DankGecko/pq1/reports/README.md

# Generated and historical reports

Files below this directory are point-in-time audit, test-inventory, and tool
receipts. They are not current implementation guidance. Current contributor
guidance lives in the root README and `docs/`.
