DankGecko/pq1/docs/architecture/trezor-comparison-critical-port-2026-06.md

# Trezor (STM32U5 / T3W1) → PQSigner — Critical Port Pass (Extending `trezor-comparison.md`)

**Date:** 2026-06-30
**Scope:** Fresh critical pass against Trezor HEAD `a0fe1eccc2` vs PQSigner `master`. This **extends** `docs/architecture/trezor-comparison.md` (2026-04-24 / 05-19) — it does not re-derive what that doc already covers soundly. It surfaces (a) genuinely new ports, (b) challenges to existing-doc verdicts that aged badly or were too hasty, (c) refreshes for moved Trezor code, and (d) a "considered & rejected" ledger so the same ideas don't resurface next quarter.

> **Historical research, not implementation authority.** Rollback/OTP and FSBL
> geometry recommendations in this June pass predate Draft 1.1 and are
> superseded by its unapproved research-candidate analysis. They may motivate
> tests, but do not authorize code, option-byte, OTP, or hardware changes.

Every candidate below was adversarially verified against PQSigner's real files, threat model, and deliberate-design constraints. Calibration note up front: **the single strongest finding is only "med" impact.** There is no headline break here — PQSigner's signing-path FI, dual-SE split, and on-device-decode trusted display are already strong. The value is in cheap defense-in-depth that closes glitch/fault windows, plus correcting stale verdicts in the comparison doc itself.

> **Method / provenance.** Produced by a 12-dimension `compare → adversarial-verify → synthesize` agent pass (each candidate checked against the real PQSigner file, not CLAUDE.md, which lags). The top three findings (rr-1, sca-3, tz-2) were additionally hand-verified against source (`main.rs:3711/3791/3830/3904` has no fault handler; `crypto.rs` passes the same `&shuffle` to both signs; `sau.rs:432` ends at `SAU.ctrl.write(1)` with no lock bit). **C-1 (secmon) and the supply-chain row were re-run with dedicated deep agents after synthesis and materially correct the first-pass framing** — see the note in §C-1. Trezor is pinned to the STM32U5 / T3-series paths (architectural twin = T3W1 = STM32U5A9 + OPTIGA Trust M).

---

## TL;DR — highest-value portable improvements (ranked)

1. **Route CPU faults to zeroize+reset** — `med` / `S`. No `HardFault`/`SecureFault` handler exists (`main.rs` has only SysTick/DefaultHandler/PendSV); a glitch-induced CPU fault during the signing window freezes the device with `master_secret`+entropy live in S-SRAM. Add a `HardFault` handler → `zeroize_sensitive_state()` + `SCB::sys_reset()`. **Real-gap-closing.** *(rr-1)*
2. **Lock SAU+GTZC1+AIRCR after configuring them** — `med` / `S`. `sau::init()` ends at `SAU.ctrl.write(1)`; the programmed SAU regions + TZSC SECCFGR stay writable forever. One write of `CSLCKR.LOCKSAU|LOCKSVTAIRCR` + `TZSC1.CR.LCK` removes the target. Universal Trezor U5 practice. **Defense-in-depth, ~10 LOC.** *(tz-2)*
3. **Give the FI double-compute an independent shuffle seed** — `low-med` / `S`. `crypto.rs:170/173` pass the *same* `&shuffle` to both mandatory signs, donating two perfectly-aligned DPA traces per signature (a free ~√2 denoise) on the exact alignment the F-16 shuffle exists to deny. ~3 lines; provably FI-safe (output is shuffle-invariant, tested). **Corrects a wrong rationale in non-negotiable signing code.** *(sca-3)*
4. **Extend the golden UI-hash gate beyond value-transfer** — `med` / `M`. `golden.rs::screens()` renders only `value_transfer` (5 frames); the attacker-relevant decode-and-render screens (Safe/CoW/ERC-7730/EIP-1271) — the WYSIWYS boundary — have semantic tests but no pixel-hash gate. CI is already wired. **Real-gap-closing on the core security boundary.** *(te-2)*
5. **Secure the RCC/PWR/SYSCFG domain controllers** — `med` / `S`. `sau.rs` writes only the TZSC per-peripheral SECCFGR; `RCC->SECCFGR`/`PWR->SECCFGR`/`SYSCFG->SECCFGR` sit at NS reset default, letting a compromised NS reconfigure the clock tree the S-world runs on and touch the backup domain where the BHK latches. **Defense-in-depth.** *(tz-3)*
6. **FSBL boot-time option-byte integrity gate** — `med` / `M`. The candidate
   FSBL is intended to become the WRP1A-protected production trust root, but
   geometry, WRP/RDP, factory, and silicon gates remain open; the current
   legacy bench FSBL does not read back `OPTR`/`WRP1AR`/`SECWM` to establish
   that RDP-2/TZEN/WRP-covers-FSBL are in force. A future read-only verifier
   would halt with a tamper screen on mismatch. **Candidate trust-root
   self-attestation, not current immutability or exploit closure.** *(tz-1 +
   sh-1, merged)*
7. **Defer the OTP rollback-floor bump to first-confirmed-boot** — `med` / `L`. `cmd_fw_commit.rs:268` bumps the floor at install, eliminating the old slot as a try-once revert target; a validly-signed-but-runtime-hanging upgrade is an unrecoverable brick. **Availability-only (not attacker-triggerable), but non-trivial to fix correctly.** *(boot-1)*
8. **Cap how long `handler_is_busy()` may feed the IWDG** — `med` / `M`. The watchdog's liveness model means a wedged handler feeds it forever — and the same `handler_busy` gate also suppresses the 120 s idle-wipe, so one hang defeats both backstops. Self-acknowledged hole in `iwdg.rs:38-40`. **Defense-in-depth.** *(rr-2)*

Plus the most important *critical* point, which is **not** a cheap port and where the first-pass framing was itself wrong: Trezor shipped `secmon`, but a deep re-check shows it is a *separate signed image that is the sole secure-world occupant and pushes all decode/render to a non-secure kernel, signing whatever digest NS hands it* — i.e. it optimizes key-confidentiality-vs-NS-bugs by **trusting NS for what-you-sign**, the exact "blind-digest oracle" PQSigner refuses. A full `secmon` port should be **declined on principle**; the only defensible transferable increment is an MPU-lite fence (the ERC-7730 walker and other native decoders run S-unprivileged, key+SAES privileged). See Challenges §C-1 for the corrected analysis.

---

## Headline findings (the actionable ports)

### rr-1 — Route CPU faults (HardFault et al.) to zeroize+reset
- **Trezor:** `core/embed/sys/task/stm32/systask.c:771-849` routes HardFault/MemManage/BusFault/UsageFault/SecureFault/GTZC → `systask_exit_fault` → `reboot_with_rsod`.
- **PQSigner (verified):** `secure/src/main.rs` defines only `SysTick` (:3711), `DefaultHandler` (:3791), `PendSV` (:3830), and a zeroizing `#[panic_handler]` (:3904). **There is no HardFault-family handler**, so a CPU fault lands in `cortex-m-rt`'s default `loop{}` with secrets intact; the zeroizing path is reachable only via Rust `panic!()`. `iwdg` is *not* in `mode-production` (`secure/Cargo.toml:151`), so a shipping build may have no watchdog backstop either.
- **Adjusted change (PORT-with-correction):** add `#[cortex_m_rt::exception] unsafe fn HardFault(_) -> !` under `cfg(all(not(test), feature="stm32u585"))` calling `nsc::zeroize_sensitive_state()` then `cortex_m::peripheral::SCB::sys_reset()` — **NOT** `tzic::trigger_intrusion_wipe()`. The candidate's `trigger_intrusion_wipe` arms page-125, which on next boot runs `factory_reset_admin` (`main.rs:1438`) — a destructive dual-SE wipe; routing *every* induced fault there turns a single glitch into a wallet-brick/DoS. PQSigner stores **no seed in flash** (dual-SE XOR, re-derived after PIN), so a plain reset already closes the SRAM-extraction window via FSBL re-verify. This mirrors `docs/security/brownout-hardening.md` Stage-2 NMI shape exactly. Granular `SHCSR.{MEM,BUS,USG,SECURE}FAULTENA` enables are diagnostics-only (faults escalate to HardFault regardless) → **the security-critical fix is just the HardFault handler, effort S**; the tamper screen + granular handlers are an optional M follow-up. Reserve the destructive SE-wipe for confirmed TAMP/GTZC tamper.
- **Threat note:** Genuine and currently unmitigated for the immediate window. CPU-fault-as-glitch-symptom is PQSigner's headline threat (the same Masaryk-U STM32U5 76%-PIN-glitch result cited in the brownout doc). The only existing backstop is the (non-production) IWDG ~2 s window. **This is the sharpest finding in the pass.**

### tz-2 — Lock SAU + GTZC1 + AIRCR after configuring them
- **Trezor:** `core/embed/sec/trustzone/stm32u5/tz_init.c:410-415` sets `SYSCFG->CSLCKR |= LOCKSAU|LOCKSVTAIRCR` + `GTZC_TZSC1->CR |= LCK`; `:132-145` sets `AIRCR.PRIS` always, `SYSRESETREQS` under `#if PRODUCTION`, clears `BFHFNMINS`.
- **PQSigner (verified):** `sau::configure_gtzc()` ends at the SECCFGR write + readback self-check (`:354-366`); `init()` ends at `SAU.ctrl.write(1)` (`:432`). No lock bit is ever set — the fully-programmed SAU RLARs and TZSC SECCFGR bits stay writable for the rest of boot/runtime.
- **Adjusted change (ADAPT):** at the end of `sau::init()` (after all four SAU regions + GTZC are programmed), gate on `stm32u585`: (1) `SYSCFG_CSLCKR |= LOCKSAU | LOCKSVTAIRCR`; (2) `GTZC1_TZSC->CR |= LCK`. Do **not** touch `GTZC2_TZSC->CR` (unconfigured — the tracked TAMP/GTZC2 follow-up). Set `AIRCR.PRIS` + clear `BFHFNMINS` unconditionally, but gate `SYSRESETREQS` behind `#[cfg(feature="mode-production")]` so bench keeps the NS-initiated `cc_open_then_reset` USB-C warm-reset. Funnel writes through `hw::mmio::Reg32`; add a write-readback `debug_assert`. Caveat to document: `LOCKSVTAIRCR` freezes the AIRCR *security-config* bits, not the `SYSRESETREQ` trigger.
- **Threat note:** `med`/defense-in-depth. TZSC SECCFGR/SAU are only writable from S-world, so the realistic vector is a fault flip or a stray secure-world write (re-classify secure SRAM as NS, mark SAES NS) — at a layer *below* the signing-redundancy FI defense. Cheap, reset-scoped, aligned with Trezor's universal U5 practice.

### sca-3 — Independent shuffle seed for the FI double-compute
- **Trezor:** `core/embed/sec/random_delays/stm32/random_delays.c:45-51` — principle: protective randomness drawn fresh per operation, never reused (conceptual anchor, not a direct port; Trezor has no SPHINCS+ double-compute).
- **PQSigner (verified):** `crypto.rs:170` `sign_a` and `:173` `sign_b` use the **identical `&shuffle`**. The F-16 shuffle only randomizes computation *order* and produces byte-identical output for any seed (proven by `tests/shuffle_byte_equality.rs`). Reusing the seed makes both passes traverse WOTS/FORS in the same order → two trivially alignable traces of the same secret computation. The in-code comment (`crypto.rs:144-145`) frames divergent seeds as a con to the byte-equality gate — the SCA benefit is inverted.
- **Change (PORT):** draw a second independent shuffle seed from `rng_strong` for `sign_b`; zeroize both. Output is shuffle-invariant (tested), so `ct_eq` and verify-before-release still hold and a grafting fault must still produce *identical faulted output in both passes* to slip through — FI hardness unchanged, FI neutral-to-better. Correct the comment.
- **Threat note:** Impact is a bounded constant factor (~2× attacker trace efficiency on a profiled-DPA premise), not a break — hence `low-med`, downgraded from the candidate's `med`. But it directly undermines a deliberately-engineered countermeasure at ~3 LOC. **Best value-per-effort in the pass.**

### te-2 — Extend the golden frame-hash UI gate to the security-critical screens
- **Trezor:** `tests/ui_tests/common.py` — golden screenshot-hash gate across all flows.
- **PQSigner (verified):** `secure/src/ui/golden.rs::screens()` returns `[Eip1559Tx; 5]` and renders only `value_transfer::render_pages` (`:67`). `golden.rs:12-14` flags ERC-20/Safe/CoW extension as the explicit TODO. The Safe/CoW/ERC-7730/EIP-1271 renderers have byte-binding *semantic* tests (`secure/src/display_under_test/{cowswap,safe_display,erc7730}_render_pure_tests.rs`) but **no pixel-level golden fixture**. `nightly.yml`'s `ui-golden-render` job already runs the gate.
- **Change (ADAPT):** refactor `render_golden_and_halt` to drive each production page builder (`safe_display`, `cowswap_display::append_order_body_pages`, Safe-wrapped CoW `setPreSignature`, `erc7730` descriptor pages, `erc20_known`, `eip1271`), reusing the input fixtures already built in the `display_under_test` pure-test modules. Each builder's pages flow through `render_capture_pages`, appending `[UI-FP]` frames; regenerate `tests/ui_golden_render_fixtures.json` via `make ui-golden-render-bless`. No CI change.
- **Threat note:** Squarely on the WYSIWYS boundary. On-device decode defeats host data-swap, but a layout/truncation/unit/digit-grouping regression in these renderers can silently misrepresent intent — exactly what byte-binding tests don't catch. `med`, real-gap-closing. **Priority bumped by the recent ERC-7730 churn:** the historical C1/C2/C3 experiment was tightened on 2026-07-10 to exact C1-only framing (C2/C3 retired), two WYSIWYS holes were fixed in the walker/compiler, and Aave clear-signing now flows through this ERC-7730 render path — so the un-pixel-gated screens are carrying real traffic and changing fast. The ERC-7730 descriptor pages should be the *first* builder added to the golden gate, not the last. Also refresh doc §2.3 (it still claims "no UI regression coverage" and cites SSD1306 GDDRAM bytes — OLED was removed 2026-06-30).

### tz-3 — Secure the RCC / PWR / SYSCFG domain controllers
- **Trezor:** `tz_init.c:296-326` writes all three: `SYSCFG->SECCFGR` (FPU/CLASSB/SYSCFGSEC), `RCC->SECCFGR` (full clock tree incl. PLL/SYSCLK/sources), `PWR->SECCFGR` (WUP/LPM/VDM/**VB**/APC) — dead code if TZEN secured them by default, which is the strongest evidence they default NS.
- **PQSigner (verified):** `sau.rs` writes only GTZC1 `TZSC_SECCFGR1/2/3` + MPCBB; `grep -rni seccfgr secure/` confirms RCC/PWR/SYSCFG SECCFGR are never written.
- **Change (ADAPT):** in `configure_gtzc()` (or a sibling), program: (1) `RCC_SECCFGR` — secure the **full** clock tree + `RCC_PRIVCFGR SPRIV` (PQSigner needs **no NS display-PLL carve-out** like Trezor's PLL3=NS, because the NV3007 is SPI-clocked off a secure prescaler and NS never reconfigures clocks at runtime — `nonsecure/src/usb/mod.rs:42` "clocks already configured by the secure world"); (2) `PWR_SECCFGR` incl. `VBSEC` (guards the backup domain where the BHK latches in `TAMP_BKP0R..7R`); (3) `SYSCFG_SECCFGR` (FPU/CLASSB/SYSCFGSEC). Fold the tz-2 lock over these. **Caveat:** securing RCC will fault the debug-only NS pre-USB RCC dump at `nonsecure/src/main.rs:153-158` — acceptable (debug-log-gated, never ships); verify it's compiled out. Add a readback self-check + pure-test mirroring `main_sau_pure_tests.rs`.
- **Threat note:** `med`/defense-in-depth — *not* a live mid-sign glitch (single core, all NVIC IRQs secure-by-default, NS cannot preempt a signature). It's "persistent NS clock/power reconfig + backup-domain attack surface." Cheap; aligns with Trezor's "secure owns the clock tree" posture. (Also listed in Challenges as it widens §1.1's allowlist verdict.)

### tz-1 + sh-1 (merged) — FSBL boot-time option-byte / secure-config integrity gate
- **Trezor:** `core/embed/sec/option_bytes/stm32u5/option_bytes.c:124-264` (`flash_check_option_bytes`) checks `OPTR`/`SECBOOTADD0R`/`WRP1AR`/`SECWM1-2R`/OEM-keys on every boot; boardloader `main.c:321-336` → `secret_safety_erase` on mismatch.
- **PQSigner (verified):** option bytes are set by an out-of-band
  `STM32_Programmer_CLI` step; `grep` of `fsbl/`, `secure/src/main.rs`,
  `sau.rs`, and `hw/flash.rs` finds **no `FLASH_OPTR` read anywhere**. The
  legacy FSBL header no longer claims that production RDP-2 is already
  established. Full option-byte verification and the immutable production
  trust-root ceremony remain open.
- **Change hypothesis (ADAPT — strip Trezor's write/`OBL_LAUNCH` half entirely):** after an FSBL layout and factory ceremony are approved, consider a read-only `fsbl/src/optbytes.rs` before slot branch that verifies the final frozen WRP range, SECWM, boot address, lifecycle, and OEM locks. Draft 1.1 currently proposes pages 0..4, but exact constants and fit remain open. Gate readbacks through FSBL FI sentinels and halt on mismatch; do not infer SE-wipe authority. This is a candidate experiment, not an instruction.
- **Threat note:** `med`/defense-in-depth + tamper-evidence, **not** a plugged confidentiality hole. Confidentiality is bound elsewhere: U5 mass-erases on RDP regression, SE-pairing secrets self-invalidate (per-die DHUK → ST RDP0 constant), no seed in MCU flash. Real residual = a glitched/partial OB edit that weakens WRP1A (exposing the FSBL anchor to reflash) or shifts SECWM without tripping the full mass-erase, plus auditability of a manual factory step. Against an active attacker the check is partly circular (if WRP1A is unset the slot is reflashable and the check patchable) — say so honestly.

### boot-1 — Defer the OTP anti-rollback-floor bump to first-confirmed-boot
- **Trezor:** `version_check.c:41-46` `ensure_firmware_min_version` bumped at boot (in the bootloader pre-jump, `main.c:479`), not at install.
- **PQSigner (verified):** `cmd_fw_commit.rs:268` bumps `otp::bump_to(new_version-1)` at install AND sets `boot_state.active_slot=new` (`:174-178, :205-212`). FSBL `filter_valid` runs `verify_rollback(floor)` on both slots (`fsbl/src/main.rs:91,160-166`), so a cross-version old slot is eliminated; `pick_slot`'s try-once revert (`:208-214`, fires when `winner_flag==TRIED && active_slot==winner_slot`) then has no target. A validly-signed image that passes FSBL static checks but hangs at runtime reboots into the only remaining (broken) candidate forever — unrecoverable under RDP-2 + WRP1A. The advertised confirm-alive writer (`boot_state.rs:8,:127`) is vaporware (`boot_state::write` only in `cmd_fw_commit`).
- **Change (PORT-with-correction — THREE coupled edits, not two):** the eager bump is currently *load-bearing* (it eliminates the old slot so the new TRIED slot is the only candidate); removing it alone makes the new slot's first boot see `TRIED + active_slot==new` and instantly revert. So: (1) at commit, leave `boot_state.active_slot` pointing at the **old** slot (record "about to try new" via the manifest TRIED flag only); (2) build the confirm-alive writer `boot_state.rs` already advertises — on first successful `gated_unlock` (`cmd_request_unlock.rs`) or NS handoff, rewrite the running slot's manifest `TRY_ONCE_TRIED→COMMITTED`, advance `active_slot→new`, **then** `otp::bump_to(running_version-1)`, FI-hardened to match `bump_to`'s double-read + `check_true_into_sentinel`; (3) remove the `otp::bump_to` from `cmd_fw_commit.rs:268`. Floor stays strictly monotonic — it advances one boot later, on confirmation. Add a host test (old slot survives `verify_rollback` after commit-but-before-confirm) + an FSBL `pick_slot` hang-loop-revert test. **Note:** Trezor bumps in the bootloader pre-jump; PQSigner's FSBL is WRP1A-immutable/read-only on OTP, so deferring into the firmware confirm-alive path is the correct PQSigner layer.
- **Threat note:** **Availability-only, not attacker-triggerable** — an adversary can't sign firmware, the seed is dual-SE XOR + 24-word recoverable on a replacement. But it's an unrecoverable brick with no in-field reflash, and PQSigner already invests in this class (`docs/security/vulns/VULN-fwcommit-otp-before-commit-brick.md` handled only the *power-loss* sibling, which deliberately did NOT defer the bump). `med`, but `L` effort because the try-once machinery is half-built.

### rr-2 — Cap how long `handler_is_busy()` may feed the IWDG
- **Trezor:** `core/embed/sec/iwdg/stm32/iwdg.c:28` — flat hardware time-bound, no progress-feed concept (so there's nothing to literally port; PQSigner's liveness optimization created the hole).
- **PQSigner (verified):** `iwdg.rs:212` kicks while `handler_busy`; the module doc itself flags the residual at `:38-40` — a handler spinning forever with interrupts enabled + its `HandlerGuard` held feeds the watchdog forever. **Worse than stated:** the same `handler_busy` gate also guards the 120 s idle-wipe (`main_sau_pure_tests.rs:993` pins `&& !nsc::handler_is_busy()`), so a wedged handler defeats *both* the IWDG and the SRAM zeroize.
- **Change (ADAPT):** add `static mut BUSY_TICKS: u32` + `const MAX_BUSY_TICKS` in `iwdg.rs`. Treat the two progress signals asymmetrically: NS-heartbeat advance resets `STALL_TICKS` and kicks (unchanged); for the `handler_busy` branch, increment `BUSY_TICKS` per consecutive busy tick, reset to 0 when `handler_busy` goes false (a guard drop = liveness), and only kick while `BUSY_TICKS < MAX_BUSY_TICKS`. A local tick counter avoids plumbing a timestamp from `nsc`. Set the cap generously above the worst *legit* continuous-busy window — the binding constraint is a full `CMD_SIGN_USEROP_BATCH` (per-UserOp keygen + 2 FI-double-compute signs each), **not** a single first-sign (~3 s); measure on HW and set ~2-3× (likely 20-30 s). Add a host pure-test pinning the source invariant.
- **Threat note:** `med`/defense-in-depth — needs a latent unbounded-loop bug in a secure handler (parsers are bounded/Kani-checked, so reachability is low today). The point of a watchdog is to survive the bug you didn't find; this restores Trezor's "bites regardless" property. The `BUSY_TICKS` cap is the single backstop for both the IWDG and the idle-wipe.

### te-3 — SE-genuineness gate at factory provisioning
- **Trezor:** `core/embed/projects/prodtest/cmd/prodtest_optiga.c:353` `check_device_cert_chain` — OPTIGA device key signs a challenge (`optiga_calc_sign`) + X.509 chain verified to the Infineon CA, gating the irreversible `OID_CERT_DEV` write.
- **PQSigner (verified):** `secure/src/factory_provisioning.rs` has no genuineness step before it self-generates secrets and ratchets the chip into a locked state.
- **Change (ADAPT — tightly scoped):** (1) put the classical ECDSA-P256 verify + minimal DER/X.509 chain-walk **behind `#[cfg(feature="factory-provisioning")]` only**, so it never links into the wallet firmware (invariant #5 governs the *wallet* signer; the factory image is a separate single-purpose binary that already does irreversible OTP/LcsO work). (2) Add a feature-gated carve-out to the forbidden-classical-substring guards (`secure_crypto_glue_under_test/pure_tests.rs:1155-1157,1568` ban `p256::`/`ecdsa::`), keeping the guard hard for the shipping image. (3) Insert a fail-closed step in `run_and_halt` **before** the LcsO=Op ratchet / lockdown / OTP burn: read the OPTIGA Infineon device cert (E0E0/E0F0 chain), challenge the device key to sign a fresh nonce + verify against the cert + chain to a pinned Infineon CA root; mirror with the SE050 NXP birth-attestation against a pinned NXP root.
- **Threat note:** `med`, anti-counterfeit/supply-chain defense-in-depth — **not** a seed-secrecy fix (dual-SE XOR already bounds single-chip exposure) and explicitly **not** "closes S-2". **Superseded inventory correction (2026-07-14):** `lockdown_ta_pool` is a fail-closed, non-APDU-emitting candidate naming E0E8/E0E9/E0EF; it grants no closure. The retired E0E3 route was mis-targeted at a type-`0x12` device certificate. Current authority is `docs/STATUS.md` §A and the `label:ship-blocker` GitHub issues (`docs/production-todo.md` was retired 2026-07-19; pointer corrected 2026-07-26). Residual honesty: catches a counterfeit/emulated part entering a *trusted* factory line; a compromised line that re-flashes the factory image can patch the gate out. Distinct from §2.2 (symmetric handshake — a counterfeit chip holding our own PBS would PASS that round-trip) and from §5/line-441 (host-facing runtime ED25519 attestation, lifecycle-disjoint).

### Smaller ports (med-to-low, mostly cheap)
- **td-1 — chunk on-screen hex addresses into 4-char groups** (`med`/`M`). `primitives.rs:265-294` `write_addr_full` packs dense unseparated hex. Scope to `write_addr_full` only (leave `write_addr_full_or_name`'s name-anchored row alone); emit space-separated 4-char groups, equal weight (never first/last highlighting). Residual is real **only on the unknown-recipient path** (known addrs carry the Merkle-verified `+name` anchor, and PQSigner already shows full 40-hex). `M` because the fixed 16-col grid forces re-auditing per-renderer page-count constants + the `seen_last` gate when the block grows 3→4 rows; if a 4th row can't be accommodated cleanly, chunk within 3 rows (8/8/4).
- **td-2 — full 32-byte calldata hash on blind-sign** (`low`/`S`). `primitives.rs:597-619` `write_calldata_hash_rows` shows only 13 of 32 bytes — the one anchor on the no-decode path, contradicting the module's own full-address policy. Render full hash across two pages or a label-less 4-row page; bump `blind_sign.rs` page count and re-verify the confirm gate. Honest: forging 13 shown bytes is ~2^104 (infeasible), so consistency/defense-in-depth, not a break. The candidate's one-page layout is wrong (32 B = 64 hex > 48 hex/3-row page) — needs a real layout/budget adjustment.
- **td-3 — page-position counter on confirm** (`low`/`S`). Add a "p/n" footer indicator in `confirm.rs::render_page`. **Drop** the candidate's hold-progress-bar + rollback: `track_hold` already re-samples every 5 ms over 500 ms (`buttons.rs:267-292`), so the FI false-confirm motive is moot, and the `seen_last` scroll gate already enforces the scroll-then-confirm contract. Only the near-free counter is worth it.
- **se-3 — read the OPTIGA Security Event Counter (0xE0C5) at unlock** (`low`/`S`). Add `apdu::read_sec()` over the existing shielded connection; treat strictly **advisory** (log + surface elevated reading on the NV3007). **Do NOT wire into `tamp-wipe`** — SEC bumps on ordinary wrong-PIN/integrity events and decays ~1/`T_MAX_MS`, so auto-wiping would brick legit users and the desolder threat is already hard-bounded by the E120 LUC. Unique value: observing in-situ glitch/integrity activity against the OPTIGA during a live session.
- **sca-1 — periodic reseed of `consumption_mask` xorshift32** (`low`/`S`). `consumption_mask.rs` seeds xorshift32 once at boot (`:99,:111-135`) then advances it deterministically onto a physically-emitting PWM pin; a linear PRNG whose output is observable is modelable/subtractable. **Do NOT** do per-tick fresh-RNG (the comment's one legitimate objection: a 1 kHz SE round-trip per tick). Instead reseed every N≈1024 ticks via `seed_prng_from_rng()`, reusing the fail-closed contract (skip-and-keep on `Err`, don't panic mid-run). Fix the misleading "cryptographic strength not required" comment (`:87-97`). Trezor's actual U5 `consumption_mask.c:43-47` fills the PWM buffer from `rng_get()` each refill — the per-refill fill becomes right only once the noted DMA buffer port lands.

---

## Challenges to the existing comparison doc

This is the most important "be critical" section. Four verdicts in `trezor-comparison.md` have aged into being stale or too hasty, and one architectural stance is now contradicted by Trezor's own move on the identical silicon.

### C-1 (NEW, the big one — re-verified, first-pass framing corrected) — the "small, audited, monolithic S-world" stance vs Trezor's `secmon`

> **Correction note.** The synthesis first wrote this as "Trezor shipped a privileged supervisor *inside the secure side* on PQSigner's *exact* silicon — a peer rejection of monolithic-S." A dedicated deep re-check (file-cited below) shows **all three of those claims are imprecise or wrong**. The corrected analysis is more interesting and more honest: `secmon` and PQSigner's flat-S optimize *opposed* threats, and a full port would import the one thing PQSigner exists to forbid.

- **Prior doc posture:** §3.2 / §8.2 (line 601 "not needed today") / §8.5 repeatedly wave off intra-secure isolation gaps with "the whole S-world image is small and audited." No dimension ever challenged the monolithic-secure-world assumption — that part of the challenge stands.

- **What `secmon` actually is (verified).** It is **not** an S-priv/S-unpriv tier inside one image. It is a *separate, separately-signed* secure image with its own vendor header + `headertool` signature pass and CMSE implib (`SConscript.secmon:331-333,398-442`, `linker/stm32u58/secmon.ld`). At runtime it is the **sole secure-world occupant**: `main()` → `tz_init()` → `drivers_init()` → `jump_to_vectbl_ns(KERNEL_START)` (`secmon/main.c:155-166`) — it hands the kernel + app off to the **non-secure** side. SRAM/flash are configured secure *and* privileged uniformly (`tz_init.c:161-162,200-209`); there is no second privilege tier. The boundary is the ordinary SAU + GTZC S/NS line, reached via `smcall` whose `__verified` wrappers `probe_read/write_access`-validate NS pointers (`smcall_dispatch.c:61-116`, `smcall_verifiers.c:36-90`) — the same shape as PQSigner's own NSC `NsPtr` discipline.

- **The load-bearing reframe.** `secmon`'s entire sign surface is **digest-in / sig-out** — `optiga_sign__verified(index, digest, …)` (`smcall_verifiers.h:61`). It contains **no** transaction decoder, ABI parser, or display renderer; the NS coreapp/MicroPython decodes, renders, and hands `secmon` a finished digest to **sign blind**. So Trezor's WYSIWYS TCB is the *signed NS firmware*. **PQSigner explicitly forbids exactly this** (CLAUDE.md: bare-signing a companion-chosen 32-byte value is a "UserOp-forgery oracle"; the entire on-device-decode trusted-display model exists to deny it). `secmon` therefore closes *key-confidentiality-vs-NS-memory-bugs* while *trusting NS for what-you-sign*; PQSigner's flat-S closes *what-you-sign integrity* by co-locating decode+render+sign, *accepting* a parser-next-to-key blast radius. **They optimize different, partly opposed threats — `secmon` is not strictly better.**

- **Silicon (corrected).** `secmon` builds **only** for T3W1/D002 (`SConscript.secmon:256-263`) = `mcu="STM32U5G9xx"`. The U585-class Trezors (T3T1/T3B1) ship the **empty `secmon.bin` stub**. So "shipped on PQSigner's exact silicon" is **wrong** — it's a sibling U5 die (U5G9 vs U585). The `#if STM32U5A9xx || STM32U5G9xx` + `linker/stm32u58/` paths show the design *is* portable to U585, so the architectural point survives, but the "peer is doing it on our exact part" pressure does not.

- **PQSigner today (verified flat).** Grep of `secure/src` returns **zero** `MPU` / `PRIVDEFENA` / `CONTROL.nPRIV` uses; the only boundary is SAU/GTZC (`sau.rs`). `CMD_SIGN_USEROP` (`nsc/mod.rs:1201-1213`) routes into a 1930-line handler that parses the wire format, verifies the ERC-7730 bundle (`cmd_sign_userop.rs:553`), renders, **and** signs with the master/slot keys inline. The large, attacker-data-driven, **secret-free** surfaces sitting at the same privilege as the key + SAES selector are the **ERC-7730 walker** (`pqsigner-erc7730/` + `tx/display/erc7730/` ≈ **5k LOC** and the *prime* candidate — see below), the **typed-call ABI parser** (`tx/typed_call/parser.rs`, 669 L), and the **EIP-712 Safe / CoW decoders** (`tx/eip712/{safe,cowswap}/`). SE drivers and raw USB are *not* differentiators — SE is S and OTG is NS on both stacks. The ERC-7730 walker is also the *most active* attack surface: the C1/C2/C3 commits just added dynamic-field / `FollowOffset` / multi-dynamic-array resolvers (the security-sensitive `head_bounded_body` slot-confusion territory), and two WYSIWYS holes were closed in the same window (duplicate tuple-member names — a **HIGH** — `7c9cf5a2`; `visible:"never"` no-param — `8afb7ec2`). Notably the **SVC vector is unused on the S side (0 uses; NSC rides CMSE SG veneers, the timer rides PendSV)** and the MPU is unused — a clean `unpriv-parser → SVC → priv-signer` escalation vector exists today.

- **Corrected recommendation — defer-with-rationale (not "N/A", not "open a secmon port").**
  1. A **full `secmon` port is declined on principle**: pushing decode/render to NS and signing the digest it returns *imports the blind-digest trust-base fork PQSigner is built to refuse*. This is not a difficulty call.
  2. The **one defensible, scoped increment** is a `secmon`-*lite* **MPU + SVC privilege split inside S** (orthogonal to SAU/GTZC, composes with the no-heap/stack-only model): run the largest attacker-data parsers — the **ERC-7730 walker** first (now ~5k LOC, the most active surface, and where the HIGH dup-name WYSIWYS hole just lived), then the **typed-call ABI parser** and the EIP-712 Safe/CoW decoders — in an **S-unprivileged** MPU region, revalidating their small output (bool + bound fields) on return with the same copy-to-S-stack/TOCTOU discipline already used at the NS boundary, keeping key material + SAES selector + SE-unlock + FI-sign privileged.. Effort **L–XL**.
  3. A cheaper MPU **W^X / XN on parser regions** addresses code-injection, **not** key blast-radius — so it is *not* a `secmon` substitute, only a precursor.
  4. **Honest caveat:** PQSigner's S-world is memory-safe `#![no_std]` Rust — the C + MicroPython attack surface `secmon` was built to contain largely does not exist here — so even the MPU-lite split may be **correctly declined in favour of higher-yield audit spend**. The required action is to *record this as deliberately-deferred with the blast-radius argument and the SVC/MPU feasibility on the table*, not to keep waving it off as "small and audited." Reconciles with C-2.

### C-2 (sca-2) — §3.2 "SAES key-privilege split is a genuine gap" is overstated *and* self-contradictory
- **Prior verdict:** §3.2 (lines 404-406) labels the Trezor XORK_SP/SN split "a genuine gap PQSigner does not have" and recommends gating the SAES selector behind privileged mode (~150 LOC).
- **Why it's wrong:** verified in Trezor — `secure_aes.c:75-79` reaches the unprivileged XORK_SN selector **only under `#ifdef USE_APPLETS`** (now `#if NORCOW_MIN_VERSION <= 5`), and commit `7fb272bade` *removes* unprivileged SAES on the T3W1/U5G twin. The split exists to fence *applet* code from the privileged key. PQSigner has no applet model — one privilege level, selector reachable only by the audited S-image — so the threat never existed here. §3.2 also contradicts §8.2 line 601 ("not needed today").
- **Corrected recommendation:** change the §3.2 sub-claim verdict from "genuine gap, track" to **"aligned with upstream U5G direction, do not chase"** (cite `7fb272bade`); leave the §3.2 MPU/DEP W^X recommendation untouched (separate dimension, and it's the legitimate kernel of C-1).

### C-3 (te-1) — §2.4 "NSC ptr-validate still pending" is stale
- **Prior verdict:** §2.4 + TL;DR line 3 say the NSC pointer-validation side is "still owed" and "needs relocation out of `secure::nsc` first."
- **Why it's stale:** that relocation shipped. The window arithmetic now lives in host-buildable `shared/src/ns_ptr_validate.rs` (`ns_write_window_ok`, `ns_read_window_ok`) and is **exhaustively Kani-proved** (`ns_write_sound`/`ns_read_sound`/`ns_write_sound_symbolic_regions` + 5 non-vacuity controls), run by `make kani` (`Makefile:3736`) in the nightly `kani` CI job, with Miri tree-borrows over the deref. Exhaustive-over-symbolic strictly subsumes the originally-owed libFuzzer target for a loop-free predicate.
- **Corrected recommendation (doc-only):** mark §2.4 + TL;DR CLOSED-via-Kani; tick the work-todo. State the only residual is the runtime ARMv8-M TT/SAU classification (HIGH-1), which is device-only + deliberately host-stubbed and unreachable by any host harness — so no libFuzzer target is owed.

### C-4 (boot-4) — §8.3 Pattern 2 "we don't read-back-verify OTP" is stale
- **Prior verdict:** §8.3 Pattern 2 (~line 609) + the `[P3, audit-only]` line (~621) say PQSigner "has OTP fuses... but doesn't do the read-back verify — we trust the fuse-burn hardware."
- **Why it's wrong:** `otp.rs::bump_to` (the rollback-floor burn, PQSigner's `monoctr` equivalent) reads the floor back **twice** (`after1`/`after2` via `rollback_floor_once`), both required `>= target`, gated through `fi::check_true_into_sentinel` (`otp.rs:372-377`) — strictly stronger than Trezor's single write-then-read-ensure-equal.
- **Corrected recommendation (doc-only):** mark Pattern 2 DONE (cite `otp.rs:372-377`); remove the open `[P3, audit-only]` line. No code change, no live exposure.

### C-5 (ht-1) — §8.6 THP verdict is correct but the *text* is stale/partly-wrong
- **Prior verdict:** §8.6 "do not port THP" — **sound**, keep it. But the text (lines 688-710) cites the **removed OLED backend** (line 698; OLED gone 2026-06-30 — a hard factual error now), rests the MITM dismissal on "if the user is paying attention" (line 706), and predates Trezor's pairing-credential layer.
- **Why the hedge is subtly wrong:** under PQSigner's on-device-decode trusted display, a MITM-swapped userOp for a *known* shape renders as the swapped intent and **cannot be concealed by inattention** — only loud-blind-sign shapes retain a "user must read the hash" caveat. The "if paying attention" framing undersells the actual binding.
- **Corrected recommendation (doc-only refresh, verdict unchanged):** (a) update the THP description to the current pairing-credential + masked-static-pubkey layer (`rust/trezor-thp/src/credential.rs` — the doc's `noise.rs:276` cite no longer resolves on HEAD); (b) replace "OLED PIN entry" with NV3007 LCD; (c) replace the hedge with the on-device-decode binding (every sensitive command gates `pin_verified` before any parse — `cmd_sign_userop.rs:117`, `cmd_sign_offchain.rs:83`); (d) add a per-threat binding table (replay → EntryPoint nonce + monotonic caps + `replaySafeHash`; FW transport → signed 75-B preimage + OTP floor + PIN-every-call + confirm; unpaired host → pin-first + per-op confirm + non-secret gateway).
- **C-5b (ht-2):** also refine §8.6 line 710's bare BLE-revisit note in-place — append one sentence: any future host-channel-auth **MUST be a PQ KEM (ML-KEM-1024**, matching the planned SE inner-wrap) over AES-256-GCM, **not** THP's Noise_XX/X25519, to preserve invariant #5; pairing/confirm terminates on the NV3007. Anticipatory PQ-purity steering, not a current exposure.

### C-6 (sh-2) — §5/§6.5 RDP-regression rationale undersells PQSigner
- **Prior verdict:** §5 line 450 + §6.5 — "do NOT regenerate BHK on wipe" is **sound**, and line 476 already states the DHUK-wrap makes a flash dump useless without the silicon. So this is a one-sentence elaboration, not a new gap.
- **Add:** an RDP regression itself swaps DHUK from per-die to the ST RDP0 constant (`secret_keys.rs:41-45`, silicon-validated per `project_dhuk_per_die_validated.md`), so the SE-pairing secrets fail to reproduce **even if the bank mass-erase were fault-injected/incomplete** — an invalidation independent of (and belt-and-braces with) the erase. Cross-ref `secret_keys.rs`; keep the verdict.

---

## Per-dimension notes

- **FI hardening.** Survivor: fi-2 (escalate confirmed-fault branches to zeroize+relock — the post-confirm `crypto.rs:188` ct_eq site is highest value; exclude all policy/parse rejects or it's a self-inflicted DoS; relock not halt, consistent with `halt_on_glitch`). Rejected: fi-1 (RDI port — category error; RDI is SCA timing-randomization, not fault detection; the real residual is hardening *keygen*, a separate non-Trezor item). sca-3 belongs here too in spirit.
- **Runtime resilience.** rr-1 (HardFault → zeroize+reset) is the sharpest finding in the whole pass; rr-2 (cap IWDG busy-feed) is a self-acknowledged hole that also defeats the idle-wipe. Both genuinely uncovered by the doc (brownout-hardening.md plans NMI/IWDG but not synchronous CPU-fault vectors).
- **Trusted-display.** Doc explicitly scoped out UX, so td-1/td-2/td-3 are all new. td-1 (address chunking) is the most valuable; td-2 (full blind-sign hash) is consistency; td-3 is just the page counter.
- **Boot chain.** boot-1 (defer OTP bump) is the real one (availability brick). Rejected: boot-2 (split monotonic index from display version — reverses the deliberate 75-B preimage constraint). boot-4 is a doc correction (C-4).
- **TrustZone.** Three cheap wins: tz-2 (lock), tz-3 (RCC/PWR/SYSCFG breadth), tz-1 (FSBL OB gate, merged with sh-1). All defense-in-depth; tz-3 widens §1.1's allowlist verdict.
- **Secure element.** se-3 (advisory SEC-counter read) is the only new code. se-1 records the S-2/cert-pin negative result (Trezor does NO on-device OPTIGA cert validation). **Superseded:** the June claim that `lockdown_ta_pool` already exceeded Trezor's model is false for the current tree; the helper intentionally emits no APDU and S-2 remains production-fenced OPEN. Rejected: se-2 (degrade-to-plaintext guard already exists as a `compile_error!` fence), se-4 (OPTIGA-ECDSA attestation — touches no-classical-in-firmware).
- **Side-channel.** sca-3 (independent shuffle seed) is the standout — nearly free, corrects wrong rationale in signing code. sca-1 (mask reseed) and sca-2 (verdict correction, C-2).
- **Secret handling.** sh-1 (FSBL OB gate, merged into tz-1). sh-3 (page-126 BHK commit-marker — `is_provisioned()` trusts "any byte != 0xFF", so a torn write between the two ciphertext quadwords silently mis-derives SE keys; add a magic+len marker written LAST; drop Trezor's "0x00 == empty" half, N/A since PQSigner erases to 0xFF; `bhk` feature is off-by-default so low). sh-2 (C-6 doc refresh).
- **Testing / factory.** te-2 (extend golden gate) is real-gap-closing. te-3 (factory genuineness gate) anti-counterfeit. te-1 (C-3 doc correction). Rejected: te-4 (factory error-code registry — ~90% already exists in `FactoryErrorCode`, no automated-rig roadmap).
- **Host transport.** No port (verdict "do not adopt" stays). ht-1 (C-5 text refresh) + ht-2 (C-5b PQ-KEM constraint).

---

## Considered & rejected (preserve so they don't resurface)

| Item | Verdict | Reason |
|---|---|---|
| **fi-1** Port pervasive timer-driven RDI jitter | REJECT | Threat-model mismatch: RDI is SCA timing-randomization, NOT fault detection — doesn't close the keygen "no redundant-recompute" gap the rationale leans on. Keygen fault → wrong pk_root (availability), not sk_seed leak. SIGN-path leak already covered by F-16 shuffle + double-compute. Stronger fix (extend shuffle to `compute_pk_root`) is PQSigner-internal, no Trezor analog. Doc §2.6 already mentions pairing wait_random with systimer RDI. |
| **boot-2** Split monotonic anti-rollback index from display version | REJECT | Deliberately-rejected @ CLAUDE.md "Do not expand the signed FW-update preimage" — the 75-B preimage (`fw-manifest/src/lib.rs:98-115`) is intentionally minimal so an auditor reconstructs a sig from `(version, secure.elf, nonsecure.elf)` alone. `fw_version` is already the dense monotonic index; the A.B.C.D render is cosmetic. OTP-budget tradeoff already evaluated §367-392 (KEEP CURRENT). |
| **boot-4** §8.3 OTP read-back claim | ALREADY-DONE @ `otp.rs:372-377` | Doc-accuracy only (see C-4). Double-read + `check_true_into_sentinel` already exceeds Trezor. No code change. |
| **se-2** Don't port degrade-to-plaintext `optiga_init`; add fail-closed regression guard | ALREADY-DONE @ `nsc/mod.rs:502-518` | The degrade path (`optiga-no-shield`) is already fenced out of production by a `compile_error!` ship-blocker (MEDIUM-1) naming half_O leakage + invariant #1/#3. A compile-time fence beats the proposed runtime test. Only a 1-line §5 cross-ref is new — too marginal. |
| **se-4** Refine line-441: OPTIGA-ECDSA attestation doesn't violate #5 | REJECT | Deliberately-rejected @ CLAUDE.md "No classical signer anywhere — firmware, contract, FW-update path" (broader than the wallet-only reading). An interim classical OPTIGA-ECDSA attestation needs firmware to drive the classical sign APDU. §22 PQ (SLH-DSA) attestation is the chosen substitute. Verdict conclusion is sound; only the one-line wording is arguably imprecise but defensible. |
| **te-4** Per-call-site never-reused factory error-code registry | REJECT | Premise mostly false: `FactoryErrorCode` (`factory_provisioning.rs:170-252`) is already a stable `#[repr(u16)]` enum with module blocks + never-renumber discipline. Deltas (per-call-site granularity, DEPRECATED register, xtask JSON) are pure manufacturing diagnosability, no attack-surface change, and only pay off with an automated high-volume rig — not PQSigner's human-operator small-scale factory model. |
| **fs-1/2/3** Supply-chain audit / reproducible builds / dep-pinning (dimension re-run after its compare agent crashed) | ALREADY-DONE — **ahead of Trezor** | (1) cargo-vet present + CI-enforced (`supply-chain/{config,audits}.toml`, `ci.yml:88` `cargo vet --locked`) **plus** cargo-deny which Trezor lacks (`deny.toml` bans every classical signer — belt-and-braces with #5 — `yanked="deny"`, `unknown-git="deny"`; `ci.yml:68`) **plus** CycloneDX SBOM (`Makefile:3686/3699`). (2) Reproducible build is *verified* not just documented — `Makefile:1961 verify-repro` byte-`cmp`s two builds, run in CI `nightly.yml:62` (Trezor documents repro but has no in-CI bit-compare). (3) `Cargo.lock` committed, repo-wide `--locked`, the single git dep (`tropic01`) 40-hex-rev-pinned + `Makefile:106 verify-pins` hard-fails un-pinned revs. No ports; recorded so it isn't re-surveyed. |

---

## Coverage & residuals / suggested next pass

**(a) Trezor subsystems with no/weak dimension mapping:**
- **`secmon`** — its compare agent crashed but it was **re-run with a dedicated deep agent post-synthesis** and is now fully analysed in §C-1 (corrected). Net: a full port is declined on principle; the residual open question is the scoped **MPU-lite S-privilege split** (ERC-7730 walker and other native decoders S-unprivileged) — that is the one thing a next pass should design out concretely, not "evaluate secmon."
- **`hash_processor` robustness** (`core/embed/sec/hash_processor/stm32u5/`) — **the most worthwhile genuinely-unevaluated residual.** PQSigner leans on HW SHA-256 for *everything* incl. the FI verify-before-release, but `secure/src/hw/hash.rs` does only a boot-time `"abc"` KAT (FAIL-path semihosting-gated) and **no per-operation busy/abort/timeout/fault check**. A faulted/incomplete hash silently corrupts the very FI double-compute the fi/sca dimensions celebrate — both passes would consume the same bad digest. Worth a dedicated look next pass.
- **RNG health** — `secure/src/hw/rng.rs:73` checks SEIS/CEIS/SECS/CECS, but no dimension evaluated entropy-source health gating or where the FI "fresh 3-source OptRand" entropy is health-checked.
- **`hw_revision`/`unit_properties`/`board_capabilities`** — device-identity binding folded into attestation; PQSigner's planned ML-DSA `mcu_attestation` (D1) has no identity-binding analysis.
- **Supply-chain / reproducible builds / dep-pinning** — its compare agent also crashed; **re-run and CLOSED** (see the `fs-1/2/3` row above — already-done and *ahead* of Trezor). Not a residual.

**(b) Unchallenged stance:** the monolithic-secure-world dismissal (§3.2/§8.2/§8.5) — see C-1 (corrected). The peer-pressure framing is weaker than first written (`secmon` ships on a *sibling* U5 die, not PQSigner's exact part, and trusts NS for what-you-sign), but the blast-radius point stands: the same "trust an unhardened component next to the key" logic also applies to the FI chain trusting an un-fault-checked HASH engine (`hash_processor` residual above).

**(c) ~6 weeks of Trezor commits (`9f5f454af3 → a0fe1eccc2`) to diff next pass:**
1. **PQ firmware signing on STM32U58x** — `e25721d371` (PQ build), `headertool_pq.py` (`aa55ec2c9c`), `NrfHeader`/`NrfImage` (`af1a4b518c`). Directly relevant to PQSigner's FW-update/FSBL single-signer image format and boot-3 (quorum keys).
2. **`secmon` bring-up on STM32U58x** — `ca256f179b`, `96a2bddf10` + signed-secmon bumps (C-1).
3. **MCU-attestation rework + `secret_reset`** — `cefdddc6ab`/`b6c93a4e9d` (attestation gated on streaming), `d981245287` (`secret_reset`). Touches D1 attestation + the wipe paths.

---

## Proposed work-todo rows

```
- [ ] FI/runtime: add `#[cortex_m_rt::exception] HardFault` handler in secure/src/main.rs (cfg stm32u585) → nsc::zeroize_sensitive_state() + SCB::sys_reset() (NOT trigger_intrusion_wipe). Closes the CPU-fault-during-sign SRAM window. [rr-1, med, S]
- [ ] TrustZone: at end of sau::init() set SYSCFG_CSLCKR LOCKSAU|LOCKSVTAIRCR + GTZC1_TZSC.CR.LCK; AIRCR.PRIS always, BFHFNMINS clear, SYSRESETREQS under mode-production. Leave GTZC2 unlocked. [tz-2, med, S]
- [ ] SCA: draw an independent shuffle seed for sign_b in crypto.rs:173 (output is shuffle-invariant, FI gate unchanged); correct the F-13/F-16 comment. [sca-3, low-med, S]
- [ ] Testing: extend ui/golden.rs render_golden_and_halt to drive safe_display/cowswap/Safe-CoW-presign/erc7730/erc20_known/eip1271 builders (reuse display_under_test fixtures); regen ui_golden_render_fixtures.json. Refresh doc §2.3 (drop OLED/SSD1306 text). [te-2, med, M]
- [ ] TrustZone: program RCC_SECCFGR (full clock tree, no NS PLL carve-out) + RCC_PRIVCFGR SPRIV + PWR_SECCFGR (incl VBSEC) + SYSCFG_SECCFGR; fold tz-2 lock over them; verify NS debug RCC dump (nonsecure/main.rs:153-158) is compiled out. [tz-3, med, S]
- [ ] FSBL: add fsbl/src/optbytes.rs read-only verifier (OPTR/WRP1AR/SECWM/SECBOOTADD0R/OEM) before slot branch, FI-gated, halt+NV3007 fault screen on mismatch; per-profile expected constants. (No OB writes.) [tz-1/sh-1, med, M]
- [ ] FW-update: defer otp::bump_to to first-confirmed-boot — leave boot_state at old slot on commit, build the boot_state.rs confirm-alive TRIED→COMMITTED writer + deferred FI-hardened bump, remove the bump from cmd_fw_commit.rs:268; add host + FSBL pick_slot tests. [boot-1, med, L]
- [ ] IWDG: add BUSY_TICKS cap in hw/iwdg.rs so handler_busy only feeds the watchdog for MAX_BUSY_TICKS (~2-3x worst batch-sign); add source-invariant pure-test. Also unblocks the shared idle-wipe gate. [rr-2, med, M]
- [ ] FI: in confirmed-fault branches only (crypto.rs:188 ct_eq mismatch first; flag-recheck mismatches second) call zeroize_sensitive_state() + pin_verified.set_false() (relock, not halt); EXCLUDE policy/parse rejects. [fi-2, low, S]
- [ ] Factory: add SE-genuineness gate in factory_provisioning.rs (OPTIGA Infineon cert + challenge-sign + chain-to-pinned-CA; SE050 NXP birth-attest) before any LcsO/lockdown/OTP; behind feature=factory-provisioning only + carve-out in the anti-classical substring guards. [te-3, med, L]
- [ ] Display: chunk write_addr_full (primitives.rs:265) into equal-weight 4-char hex groups (unknown-recipient path only); re-audit per-renderer page-count + seen_last. [td-1, med, M]
- [ ] Display: render the full 32-byte calldata hash on the blind-sign page (primitives.rs:597) across 2 pages / a label-less 4-row page; bump blind_sign.rs page count + re-verify confirm gate. [td-2, low, S]
- [ ] Display: add "p/n" page-position counter to confirm.rs render_page footer. (Drop hold-progress/rollback — already covered by track_hold + seen_last.) [td-3, low, S]
- [ ] OPTIGA: add apdu::read_sec() (GetDataObject 0xE0C5) at unlock; advisory log + NV3007 surface only. Do NOT wire into tamp-wipe. [se-3, low, S]
- [ ] SCA: reseed consumption_mask xorshift32 from rng_strong every ~1024 ticks (fail-closed skip on Err); fix the "cryptographic strength not required" comment (consumption_mask.rs:87-97). [sca-1, low, S]
- [ ] BHK: add a magic+len commit marker to page 126 written LAST after both ciphertext quadwords; is_provisioned() requires the marker (note 0xFF erase divergence from Trezor's 0x00 rule). [sh-3, low, S]
- [ ] DESIGN: open an explicit "intra-secure MPU-lite privilege split" entry (NOT a secmon port — a full secmon trusts NS for what-you-sign, declined on principle). Concrete shape: run the ERC-7730 walker (pqsigner-erc7730/ + tx/display/erc7730, ~5k LOC, now the top surface + carrying Aave traffic) first, then the typed-call ABI parser (tx/typed_call/parser.rs) + EIP-712 Safe/CoW decoders, in an S-UNPRIVILEGED MPU region via the currently-unused SVC vector, revalidate the bool+bound-field output on return, keep key+SAES+SE-unlock+FI-sign privileged. Effort L–XL; record deferred-with-rationale (memory-safe Rust S-world may justify declining even this), not "small & audited, N/A". Reconcile §3.2/§8.2/§8.5. [C-1]
- [ ] DOC: §3.2 — re-verdict the SAES XORK_SP/SN split as "applet-model artifact, aligned with U5G removal (7fb272bade), do not chase"; reconcile with §8.2:601. [sca-2/C-2]
- [ ] DOC: §2.4 + TL;DR — mark NSC ptr-validate CLOSED-via-Kani (shared/src/ns_ptr_validate.rs, make kani); residual = device-only TT/SAU (HIGH-1). [te-1/C-3]
- [ ] DOC: §8.3 Pattern 2 — mark OTP read-back DONE (otp.rs:372-377); remove the [P3, audit-only] line. [boot-4/C-4]
- [ ] DOC: §8.6 — refresh THP text (NV3007 not OLED; credential.rs masked-static-pubkey; replace "if paying attention" with on-device-decode binding + per-threat table); constrain line 710 BLE-revisit to a PQ KEM (ML-KEM-1024). Keep verdict "do not adopt." [ht-1+ht-2/C-5]
- [x] HISTORICAL/SUPERSEDED: §2.2 S-2/cert-pin comparison. Trezor does no on-device OPTIGA cert validation, but current `lockdown_ta_pool` emits no APDU and does **not** exceed or close Trezor's model. S-2 remains factory-blocked; use `production-todo.md` + `STATUS.md` §A. [se-1]
- [ ] DOC: §5/§6.5 — add the RDP-regression DHUK-rebinding sentence (per-die DHUK vs ST RDP0 constant, holds even against a glitched/incomplete erase; cross-ref secret_keys.rs:41-45). [sh-2/C-6]
- [ ] NEXT-PASS: diff hw HASH/RNG health-check robustness (hash_processor/stm32u5, hw/hash.rs per-op fault check) + Trezor PQ-signing/secmon/secret_reset commits (9f5f454af3→a0fe1eccc2). [critic residuals]
```

---

## UPDATE 2026-07-02 — next-pass close-out (HASH/RNG residuals + clear_signing delta + execution-gap audit)

**Scope.** Trezor advanced `a0fe1eccc2 → dbe34907fc` (27 commits) since the pass above. This update (1) audits which of the pass's backlog actually shipped, (2) resolves the two flagged next-pass residuals (HASH per-op fault check; RNG health), (3) does a feature-by-feature parity check of Trezor's new `clear_signing` work against PQSigner's ERC-7730, and (4) sweeps the remaining commits. Every claim below is grep-/source-verified against PQSigner `master` on the date.

### 0. Meta finding — the June backlog is unimplemented; the bottleneck is execution, not discovery

Of the ~18 validated items in the pass above, **only `rr-1` (HardFault→zeroize+reset) shipped** (`secure/src/main.rs:3907`, verified present with the exact non-destructive `zeroize_sensitive_state()` + `SCB::sys_reset()` shape recommended). Everything else is still open, confirmed with evidence 2026-07-02:

| Item | Evidence still-open |
|---|---|
| tz-2 (SAU/GTZC/AIRCR lock) | 0 hits for `CSLCKR`/`LOCKSAU`/`LCK` in `secure/src/sau.rs` |
| tz-3 (RCC/PWR/SYSCFG SECCFGR) | 0 hits for `RCC_SECCFGR`/`PWR_SECCFGR`/`SYSCFG_SECCFGR` repo-wide |
| tz-1 (FSBL option-byte gate) | no `OPTR`/`FLASH_OPTR` read in `fsbl/src/`; no `fsbl/src/optbytes.rs` |
| boot-1 (defer OTP bump) | still bumps at install `secure/src/nsc/cmd_fw_commit.rs:268` |
| rr-2 (IWDG busy cap) | 0 `BUSY_TICKS`/`MAX_BUSY_TICKS` in `secure/src/hw/iwdg.rs` |
| te-2 (golden UI gate) | `secure/src/ui/golden.rs` still renders only `value_transfer::render_pages` (`:67`) |
| sca-1 (mask reseed) | `seed_prng_from_rng` runs only in `init`; `randomize()` advances deterministically — no periodic reseed |
| sh-3 (BHK commit marker) | `bhk.rs:184 is_provisioned()` still "any byte != 0xFF", no magic+len marker |
| td-1/td-2/se-3 | unchanged |

**Recommendation:** these are already found, verified, and scoped in the `Proposed work-todo rows` block above — pull them into an implementation sprint. A third survey would re-derive known items and burn effort; the value now is landing them.

### 1. Residual resolved — HASH-engine per-op fault (the pass's "most worthwhile unevaluated" item)

**Verdict: real but narrow; no headline break; two cheap fixes, one of which collapses into `sca-3`.** Under `hw-sha256` (auto on `stm32u585`), ALL SHA-256 in `sphincs-c10` — keygen, both double-compute sign passes, AND the verify-before-release — routes through the single `pqsigner_sha256_*` engine (`sphincs-c10/src/hash.rs:106-148`). That engine is therefore a single point of trust for the whole FI gate.

- **What `hash.rs` checks:** boot KAT once (`:141-162`, halts on mismatch); BUSY before start (`wait_ready :175-189`); DCIS before reading the digest (`:319-333`). It is NOT a bare write/read driver.
- **What it lacks — and the concrete defect (H-1):** on timeout both `wait_ready` (`:186`) and the DCIS wait (`:331`) just `return`. The DCIS `return` fires **before** the HR-read loop (`:338-356`), so the caller's 32-byte `out` is left untouched — a stale/garbage digest is consumed as "the hash" with no error channel (`debug_log_safe` is a no-op without a debugger). A glitch-induced hang silently degrades to a wrong digest.
- **Blast radius (honest):** a *transient* single-shot glitch is caught by the `ct_eq` double-compare (`crypto.rs:188`) — the other pass, jittered by `wait_random()`, isn't identically corrupted. A *deterministic/reproducible* fault corrupts sign_a, sign_b, and verify identically → passes `ct_eq` AND verify (verify uses the same engine, so it is self-consistent and proves nothing about the engine). That surviving sliver is exactly the Genêt (TCHES 2023) grafting-leak class the double-compute exists to block. Forgery is off the table (the on-chain `SPHINCsC10Asm.sol` verifier uses the real SHA-256 precompile → a device-hash-broken sig reverts on-chain); a *persistent* defect also breaks keygen → dead wallet, caught by KAT/first-sign.
- **STM32U5 `HASH_SR` has NO hardware fault flag** (SVD-confirmed), so the *literal* "per-op fault check" the pass imagined is inert. The realistic closes:
  1. **Independent shuffle seed per double-compute pass (= `sca-3`, now with a second rationale).** This is the change with real teeth against the deterministic-fault seam, not just SCA. See §2 below — it decorrelates the two passes' computation ORDER so a position-triggered deterministic fault hits different WOTS/FORS positions per pass → divergent sigs → caught by `ct_eq`. **Re-elevated from low-med to med.** [work-todo hash-fault-1]
  2. **Fail LOUD on timeout** (H-1) — park the CPU like the KAT-FAIL path or poison `out`; assert FIFO drained + BUSY clear before trusting HR. Catches the stalled/incomplete (DoS) class. [work-todo hash-fault-2]
  3. Optional per-sign KAT (catch latched engine defect between boot and sign) + double-compute keygen pk_root on the provisioning path only. [work-todo hash-fault-3 / keygen-fi-1]
- **Trezor contrast:** `core/embed/sec/hash_processor/stm32u5/hash_processor.c` is a thin ST-HAL wrapper with an **unbounded** busy-wait (`:84`) and **discards every `HAL_StatusTypeDef`** (`:88/100/120/132/146`) — it does LESS per-op fault detection than PQSigner, and it trusts the engine only in the fail-safe *boot* direction (a faulted hash rejects a good image; it can't accept a bad one without a preimage). The pass's implicit "Trezor is the robustness exemplar here" framing is not supported by its code — the value is the internal analysis, not a port.

### 2. `sca-3` re-elevated + a wrong code comment to correct

`crypto.rs:170/173` still pass the identical `&shuffle` to both signs. A comment was since added at `crypto.rs:138-154` **defending** this, claiming re-drawing per sign "would produce different shuffle orders → divergent internal hash streams" framed as a *cost*. That is backwards on two counts: (a) divergent internal state is precisely the SCA benefit `sca-3` sought AND the FI benefit §1 needs; (b) the comment contradicts the crate's own proven invariant — `sphincs-c10/src/shuffle.rs:16-19` states output is byte-identical for any seed, and `tests/shuffle_byte_equality.rs:65` (`multiple_random_shuffles_all_equal`) already tests many distinct nonzero seeds against the zero reference (transitively: any two distinct nonzero seeds are byte-equal). So independent seeds keep `ct_eq`/verify passing while closing both the DPA-alignment gap and the deterministic-HASH-fault seam. **Fix the comment and draw a second seed for `sign_b`** (~3 LOC + one explicit two-nonzero-seed assertion). This is the best value-per-effort item in the whole two-pass effort.

### 3. Residual resolved — RNG health (flagged: "no dimension evaluated entropy-source health gating")

**Verdict: the flag is partly overstated — per-read health gating DOES exist — but points at one genuine cheap omission.** `rng.rs:47` programs the NIST SP800-90B config (`NISTC=0`), so the U5 runs repetition-count + adaptive-proportion continuous health tests in hardware and raises `SECS`; `rng.rs:100-106` checks `SECS/CECS` every word and fails closed; `rng.rs:84-94` recovers on latched `SEIS/CEIS`. `rng_strong.rs:66-123` XOR-folds STM32 ⊕ OPTIGA ⊕ SE050 with a both-or-fail SE requirement and an all-zero acceptance gate Trezor's `rng_strong.c` LACKS. The strong path covers the master seed, per-sign OptRand, and the shuffle seed — broader signing-randomness coverage than Trezor.

- **The one real delta:** PQSigner has NO software continuous/repetition test (Trezor's `compare_previous` CRNGT, `rng.c:40-64`). Largely subsumed by the U5 hardware tests, but a ~4-byte-of-state omission that would catch a degradation subtle enough to evade them — and it specifically matters for the **non-SE-folded** secret paths that call raw `rng::fill`: BHK generation (`bhk.rs:223`) and the ML-KEM message `m` (`pq_wrap.rs:87`). (Note: `dual_se.rs` `half_o` LOOKS raw but is SE-folded at `:110-118`; the SE XOR-fold already masks a silently-degraded STM32 on the strong path.) Add per-word `DR != 0` + repeat-word check + a post-warmup `SECS/CECS==0` assert in `rng::init()`. [work-todo rng-1]
- **Design decision, not a bug:** no host/external-entropy mixing or entropy-commitment protocol at seed creation (Trezor has one, `reset_device/__init__.py:85-114`) — an attacker-rigged on-device RNG is unauditable; doesn't conflict with invariant #6. Record adopt-vs-decline. [work-todo rng-3]
- **Minor:** `provision_duress_wallet` (`crypto.rs:331-352`) hand-rolls the mix with a silent SE fall-through instead of `rng_strong` strict semantics. [work-todo rng-2]

### 4. clear_signing delta — PQSigner LEADS Trezor on all four new features (no port)

Trezor's four new `clear_signing` commits map onto PQSigner's ERC-7730, and PQSigner already has each, AHEAD on three:

| Feature | Trezor (new) | PQSigner | Verdict |
|---|---|---|---|
| Date formatter | `format_timestamp(int)`, timestamp-only, no overflow guard (`clear_signing.py:444`) | `render_date` — timestamp + blockheight, year-overflow + magnitude-hiding guards, loud-fail on >2^64 (`formatters.rs:454-524`) | **AHEAD** |
| Raw formatter | str/bytes-hex/int/bool (`clear_signing.py:412`) | `render_raw` + two-page word spill so all 32 bytes show (`formatters.rs:227`, `:1081`) | **AHEAD (WYSIWYS)** |
| Multi-value (array) fields | per-elem format, `\n`-join, one property (`clear_signing.py:465`) | `render_array` — Kani-proven exact-placement resolver, one page/elem, explicit count, anti-tail-hiding, token bound once (`formatters.rs:873`) | **AHEAD** |
| Const-token-address | `const_token_address` proto field + literal (`c5aa28511f`) | `params.token` literal + dbgen `$.metadata.constants.*` resolution (`formatters.rs:1674`, `dbgen/erc7730.rs:2577`/`:5473`) | **PARITY** |

PQSigner is additionally ahead on nested EIP-712 / Permit2 / all six UniswapX orders / DEX-swap curation / a 14-op FormatOp table vs Trezor's 6, all Merkle-pinned + Kani/render-tested. **The influence runs Trezor→needs-PQSigner's-guards, not the reverse** — Trezor's unbounded MicroPython string path never confronted the fixed-width-display magnitude-hiding class PQSigner's date/raw guards close. One optional micro-gap: `render_array_element` (`formatters.rs:1090`) declines array-of-date/array-of-enum (decline-to-blind, no shipping descriptor uses them). [work-todo erc7730-arr-elem]

### 5. Remaining 27-commit sweep — nothing new portable

After the clear_signing cluster (§4), the rest is: build/packaging artifact-copy incl. a `secmon.elf` copy that is **packaging only, no secmon code change** (`59923d50fe` et al.); Evolu delegated-identity/quota feature (no PQ-ERC-4337 analog); Tropic prodtest (non-target SE); UI-cosmetic + translations. No secmon-code / boot / attestation / `secret_reset` commits landed. The pass above (incl. the `secmon`/MPU-lite §C-1 analysis) remains current.

### 6. Implemented 2026-07-02 (this session) — 4 landed, tz-3 specified-not-committed

Four of the ranked items were implemented, built, and host-tested. Everything is validated to the extent possible off-silicon; the two silicon-only changes (H-1, tz-2) compile clean for `thumbv8m` but carry an explicit **on-hardware validation TODO**.

| Item | Files | Validation | Status |
|---|---|---|---|
| **hash-fault-1 (= `sca-3` re-elevated)** — independent shuffle seed per FI double-compute pass + corrected comment + explicit two-nonzero-seed test | `secure/src/crypto.rs`, `sphincs-c10/tests/shuffle_byte_equality.rs`, `secure/src/secure_crypto_glue_under_test/pure_tests.rs` | host suite (2088) + `shuffle_byte_equality` (5) + **`make e2e` QEMU ALL scenarios PASS** (exercises the two-seed signing path via /dev/urandom) + `thumbv8m` build | **LANDED** |
| **hash-fault-2 (H-1)** — fail-loud on HASH-engine timeout (`hash_engine_fault()` → `zeroize_sensitive_state`+barrier+`sys_reset`, matching rr-1; replaces the two silent `return`s that left `out` stale) | `secure/src/hw/hash.rs` | `thumbv8m` build EXIT 0 (module is `stm32u585`-only, not in host/QEMU). **Needs on-silicon confirm the reset path fires + no boot-KAT reset-loop regression.** | **LANDED (silicon-validate TODO)** |
| **tz-2** — lock SAU + GTZC1 TZSC + AIRCR after config (`lock_security_config()` at end of `init()`); AIRCR PRIS + BFHFNMINS=0 always, SYSRESETREQS mode-production-gated | `secure/src/sau.rs`, `secure/src/main_sau_pure_tests.rs` | register addrs/bits CMSIS-verified (`stm32u585xx.h`/`core_cm33.h`) + cross-checked vs Trezor `tz_init.c`; host source-invariant test (69 sau tests pass); `thumbv8m` build. **Needs on-silicon boot + `make gtzc-enforcement-hw` after lock.** | **LANDED (silicon-validate TODO)** |
| **te-2** — golden full-Page-grid hash for the security-critical decode screens (Safe / CoW / **ERC-7730**) | `secure/src/display_under_test/{mod,safe_display_render_pure_tests,cowswap_render_pure_tests,erc7730_render_pure_tests}.rs` | 3 golden tests pass + non-vacuity asserts + full render suite (243) green | **LANDED (host form)** |

**te-2 scope correction (supersedes the June `[te-2]` row's "extend `ui/golden.rs`, ERC-7730 first").** The *firmware* golden harness (`ui/golden.rs`, `ui-golden-render`) is `no_std` and hashes real LCD pixel frames — but the Safe/CoW/ERC-7730 render inputs are built by **host-only `dbgen` + filesystem + `Vec`** (the ERC-7730 registry is compiled at test time), so they **cannot** be constructed in that firmware harness without baking pre-built descriptor fixtures into the image (a separate, larger task). The achievable + higher-value form landed instead: a **host-side full-grid golden hash** added to the existing `display_under_test` render tests, which already build correct inputs for exactly those screens, run in CI without QEMU, and catch the layout/truncation/divider regressions the per-substring faithfulness asserts miss. `value_transfer` keeps its firmware pixel-golden. Baking Safe/CoW/ERC-7730 fixtures into the firmware pixel-golden is the remaining follow-up.

**Pre-existing blocker fixed en route (NOT a Trezor item).** The `stm32u585` build was broken by a latent committed bug: `secure/src/tx/display/mod.rs:385` was the tree's ONLY `crate::secure_log!` (path form) among 944 plain `secure_log!` calls, and `secure_log` is a `macro_rules!` without `#[macro_export]`, so the `crate::` path fails E0433 (committed in `a8981c4a`). Changed it to plain `secure_log!` (matching the 944). This unblocked all `stm32u585` builds — flag for the maintainer as it was blocking HW builds independent of this work.

### 7. tz-3 (RCC/PWR/SYSCFG SECCFGR) — SPECIFIED, deliberately NOT committed

**Why deferred (advisor-gated):** securing the clock tree can silently strip NS access to a register it *reads*, bricking NS USB/display on a part that cannot be booted here. The June caveat only checked the *debug* RCC dump is compiled out — **necessary, not sufficient.** A full NS grep (`nonsecure/src/`) finds exactly **one** RCC touch: the pre-USB debug dump at `nonsecure/src/main.rs:151-156` (reads `RCC_NS` CR/CCIPR1/AHB2ENR1), and it is **runtime-`DHCSR.C_DEBUGEN`-gated, NOT compile-time gated** — so with a debugger attached (the normal bench setup) it *executes* and would fault if RCC is secured. Zero PWR/SYSCFG touches in NS. So tz-3 is safe for production (no debugger) but **regresses the bench debug dump**; it must land together with removing/guarding that NS dump, and be validated on silicon (NS USB must still enumerate `1209:7051`; NV3007 must still drive). Left as a spec for the maintainer to apply + hardware-test.

**Specified diff** (in `sau::stm32`, folded under the tz-2 lock, `stm32u585`-only):
- `RCC_SECCFGR` (`RCC_BASE_S 0x5602_0C00 + 0x110`): secure the full clock tree (no NS PLL carve-out — the NV3007 is SPI-clocked off a secure prescaler; NS never reconfigures clocks at runtime, `nonsecure/src/usb/mod.rs`), plus `RCC_PRIVCFGR (+0x114) SPRIV`.
- `PWR_SECCFGR` (`PWR_BASE_S 0x5602_0800 + 0x30`): incl. `VBSEC` (guards the backup domain where the BHK latches in `TAMP_BKP0R..7R`).
- `SYSCFG_SECCFGR` (`SYSCFG_BASE_S 0x5600_0400 + 0x00`): FPU/CLASSB/SYSCFGSEC.
- Coupled NS change: remove or `#[cfg(feature="debug-log")]`-gate the `nonsecure/src/main.rs:151-156` RCC dump so it can't fault under a debugger.
- Add a readback self-check + a `main_sau_pure_tests` source-invariant mirror; verify addresses against `stm32u585xx.h` (`RCC_SECCFGR`, `PWR_SECCFGR`, `SYSCFG_SECCFGR` offsets) as tz-2 did.
