DankGecko/pq1/docs/verification/hardware-formalization-survey-2026-07-17.md

# Can the hardware surfaces be formally verified? — external survey + verdict

**Snapshot date: 2026-07-17.** Program/research layer. This is the **survey and verdict**
deliverable: ~45 external tool/paper claims adjudicated against primary sources (every one
fetched, not recalled), plus what applies, what does not exist, and what we would have to
build ourselves.

**Evidence tier of this document — read the marker before anything here becomes load-bearing.**
Almost everything below is **`[survey]`**: sourced by a research agent, then adversarially
re-checked by an independent agent that fetched the primary source itself. Rigorous, but **not
author-verified**. The exceptions are marked **`[tool]`** (a binary was run on this box) and
**`[code]`** (read from this tree). **Where `[tool]` and `[survey]` disagree, `[tool]` wins** —
§5.6 records one such case, where the author's own BINSEC probe **withdrew** a survey correction.
The tier convention is the boundary doc's; this doc adopts it rather than minting a second one.

> **UPDATE 2026-07-19 — external re-check.** A fresh four-lane SOTA sweep
> ([`fv-sota-newly-possible-2026-07-19.md`](./fv-sota-newly-possible-2026-07-19.md))
> re-adjudicated this survey's closures against primary sources. Verdicts:
> (a) the "no Thumb decoder" inference behind the BINSEC row is **externally
> false** — BINSEC ships an ARMv7-Thumb decoder since 0.4.0 and `checkct`
> leakage-feature flags since 0.10.0; the on-box uniform failure (§5.6,
> `[tool]`) stands, but its likely causes are loader/decoder selection and
> v8-M-only encodings, so a scoped re-probe on 0.11.x with v8-M-free functions
> is open; (b) CT verification has a live LLVM-IR route (CT-PROVER, FSE 2024)
> directly applicable to Rust bitcode; (c) design-level TrustZone-M formal work
> exists (Umbra, mCRL2, DATE 2026) — the ISA-level closure stands; (d) the
> OPTIGA cert lineage is current (BSI-DSZ-CC-0961 V7-2024, valid to 2027-03),
> not expired; (e) NIST ESV Certificate #11 covers the STM32U5x TRNG (SP
> 800-90B, full entropy) and is citable scoped evidence. The headline verdicts
> (no public ARMv8-M ISA spec, no SE RTL, no TRNG proof) are unchanged.

Companion — **read it, this doc does not repeat it**:
[`hardware-assumption-boundary-2026-07-17.md`](./hardware-assumption-boundary-2026-07-17.md)
carries the epistemology in full: the falsifiability criterion that separates a hardware model
from proof theatre (§2), the entitled-vs-overclaim claim table (§3), the per-invariant silicon
weight (§4), and the RDP-2 / dual-SE-split trace (§5). Where this report needs those, it points.

Other companions: [`fv-surface-expansion-inventory-2026-07-16.md`](./fv-surface-expansion-inventory-2026-07-16.md)
(the 47 surfaces — §9 below states only the **delta**);
[`formal-verification-assurance-expansion-2026-07-15.md`](./formal-verification-assurance-expansion-2026-07-15.md)
§P1.9 (which already declares peripheral behaviour, CMSE semantics and errata out of scope —
this report is the sourced justification for that call);
[`security-tooling-sota-2026-06.md`](./security-tooling-sota-2026-06.md) (which §9 **corrects**).

---

## 1. Bottom line

**No. Not one of the six surfaces can be formally verified — and that is not a local failure;
nobody verifies silicon they did not design.** What *is* achievable, on four of the six, is
strictly weaker and genuinely valuable: **machine-checked proofs of driver logic against a
hardware contract we write down**, each contract pinned by a test that can fail.

- **(c) ARMv8-M/CMSE/SAU-GTZC and (e) OPTIGA/SE050 internals are closed permanently** — (c) on an
  ARM business decision (no public M-profile spec exists, in any framework), (e) on RTL we will
  never obtain. Record both as **closed questions, not backlog**.
- **(a) OTP, (b) flash, (d) framing, (f) peripherals reach `C` + `M` + `silicon-E2E`**, over
  premises that stay `bare-TCB` forever.

**Single most valuable move: wire the `hal/` seam** (§6/P5). Not as a Kani enabler — as the
mechanism that makes the contract *falsifiable at all*. `secure/Cargo.toml` has no dependency on
`hal/`, and the two live specs contradict each other with nothing detecting it.

**Cheapest move, hours not weeks: read TN1545 + UM3387** (§4.6). ST published half the assumption
ledger, addressed to us; we ship **deliberately outside** the certified configuration.

---

## 2. The frame: why "formally verify the OTP" is the wrong question

The right question is: **which half of each claim is software, and what pins the other half?**

> Verify software AGAINST a hardware contract you wrote down. Then validate the contract
> empirically. **The contract stays an assumption forever.**

This is not a counsel of despair; it is the published frontier, and every serious effort says so
in its own words. seL4, ~20 person-years, assumes "the hardware works correctly… run within its
operating conditions" and assumes DMA away
([assumptions](https://sel4.systems/Verification/assumptions.html)) — an assumption we cannot
inherit, since fault injection is inside our threat model. Pancake, the 2025 SOTA in verified
device drivers, states "we trust the device not to malfunction"
([arXiv:2501.08249v2](https://arxiv.org/html/2501.08249v2)). Veld found a *complete* hardware
model infeasible and shipped a partial one
([KISV'24](https://mars-research.github.io/doc/2024-kisv-veld.pdf)). TickTock's ARM hardware spec
is **60 trusted, unchecked lines** ([SOSP'25](https://css.csail.mit.edu/6.5660/2026/readings/ticktock.pdf)).
Termite — the flagship model-driven effort — never implemented the spec↔RTL check that would
have validated its model, and could not have: both evaluated devices were proprietary
([SOSP'09](https://www.sigops.org/s/conferences/sosp/2009/papers/ryzhyk-sosp09.pdf)).

Two consequences that do real work below:

**Modelling can be negative-value.** If the model is written by the driver's author from the same
datasheet reading and nothing can contradict it, you have produced a second copy of the belief and
a certificate that the copies agree — worse than honest prose, because it looks like evidence.
PERRY is the canonical demonstration: it infers the peripheral model **from the driver**, i.e. it
encodes the belief in doubt ([USENIX Sec'24](https://www.usenix.org/system/files/sec24summer-prepub-600-lei.pdf)).
Full criterion: boundary doc §2.

**Granularity is the trap, and we already fell in it once.** The pretty OTP abstraction is a
monotone bit-lattice — and on STM32U585 it is *true*, and the design built on it was *invalid*.
The rejected legacy anti-rollback tally counted cleared bits, which requires clearing one more bit
in an already-programmed quad-word; silicon forbids exactly that (`otp.rs:4-12`). A bit-lattice
model would have issued a clean green for an operation that bricks parts. **Model at the commit
granularity — quad-word, one APDU, one bus transaction — or do not model.**

Tiers below use the existing [`THREAT_CLAIM_MAP.md`](../../contracts/verification/docs/THREAT_CLAIM_MAP.md)
legend (`K` kernel-proof / `C` bounded / `silicon-E2E` / `T` cited-TCB), plus **`M`** =
model + a differential test that runs and can fail.

---

## 3. Per-surface verdict

| Surface | Does a tool exist? | What it proves | Covers M33? | Verdict | Effort | What stays assumption |
|---|---|---|---|---|---|---|
| **(a) OTP one-way / monotone fuse** | **No tool models fuse physics.** Kani (installed) + Ariadne's crash-contract shape ([F*, arXiv:1707.02466](https://arxiv.org/pdf/1707.02466)) apply to the *logic*. OpenTitan's A/B lifecycle encoding ([lc_ctrl](https://opentitan.org/book/hw/ip/lc_ctrl/doc/theory_of_operation.html)) is **not portable** — it needs the tapeout | Driver logic vs a written `Otp` model: floor monotonicity, half-burn detection, crash recovery | Kani: no (host MIR) | **`C` + `silicon-E2E`** | 1–2 wk post-seam; probe 2–3 d | Fuse irreversibility; ECC line semantics; that a brownout-torn burn is detectable |
| **(b) Flash atomicity / torn write / ECC / brownout** | **Partially.** PoWER/Verus ([OSDI'25](https://people.csail.mit.edu/nickolai/papers/leblanc-power.pdf)) is the framework match; TLA+/TLC installed + piloted; Kani installed | Crash consistency vs a chunked model. PoWER's chunk param = 16 B QW; **1→0-only, page erase, ECC-lock must be ADDED** — and ECC-lock is not additive (see below) | PoWER: no (x86 PM) | **`K`/`C` logic; `M` + `silicon-E2E` contract** | mo (Verus) / wks (TLC+Kani) | Chunk atomicity itself; ECC on a torn QW; marginal-cell read stability after brownout |
| **(c) ARMv8-M ISA / CMSE / SAU-IDAU-GTZC** | **No. Structurally, permanently.** See §5.1 | Nothing. The config **logic** is bit-packing (Flux/TickTock shape, `C`-tier); enforcement is `make gtzc-enforcement-hw` | — | **`C` config + `silicon-E2E`. `K` unreachable** | n/a | CMSE instruction semantics; SAU/IDAU as ST wired it; **the entire GTZC block**; unpublished errata |
| **(d) I2C + IFX-I2C / T=1′ framing, retry, guard time** | **Nothing to reuse** — literature is empty (§5.3). Build with installed TLA+/TLC + Kani | Framing/CRC purity (`C`, today, no seam). FSM: no lost/dup apply, progress (`M`) | Kani yes (pure fns); TLC n/a | **`C` + `M`** | 3–5 d (Kani) / 3–4 wk (TLC) | Bus electricals; SE-side timing; that a 50 µs guard-time violation is benign-or-detected |
| **(e) OPTIGA / SE050 black box + LcsO** | **No, and none will appear.** Every technique that could ([HIVE](https://arxiv.org/html/2309.08002v2), [OpenTitan FPV](https://opentitan.org/book/doc/contributing/dv/sec_cm_dv_framework/index.html), [Silveroak](https://github.com/project-oak/silveroak), Termite) needs RTL | Nothing. Certificates attest **bounded expert effort**, and their scope excludes what we rely on (§4.5) | — | **`silicon-E2E` + scoped `T`. Nothing above, ever** | per-property days | Everything inside the die |
| **(f) SAES/DHUK/BHK, TAMP, TRNG, HASH, RCC** | **Partially, and non-uniformly.** [NIST EA suite](https://github.com/usnistgov/SP800-90B_EntropyAssessment) (statistical, not proof); [stm32-rs SVD](https://stm32-rs.github.io/stm32-rs/) (layout only); KAT self-tests | TRNG min-entropy *estimate*; transcription conformance; DHUK per-die distinctness (n=2) | SVD yes; EA n/a | **`silicon-E2E` + `C` gates** | days each | DHUK unextractability; TRNG entropy; SAES leakage; every unpublished erratum |

Three points the table cannot carry:

**(b) — ECC-lock breaks PoWER's core.** `can_result_from_partial_write` is a strict **two**-outcome
disjunction (chunk == pre ∨ chunk == post). A torn STM32 quad-word admits a **third**: an ECC fault
on read, neither old nor new. That touches PoWER's central disjunction, not its parameters. Also:
Verus is absent from this box, and PoWER's own limitations rule out quantifier-weak tools — so
Kani is likely **not** a PoWER host. Genuine install-and-pilot.

**(b) — do NOT cite Tseng (DAC 2011) as refuting our flash premise.** Its retroactive-corruption
finding is explicitly MLC-scoped ("This assumption is incorrect for MLC devices"), structurally
requires two logical pages sharing a cell, and all 11 DUTs are raw NAND with **no NOR and no ECC**.
Its own §5 *preserves* log-structured recovery for SLC. Cite it for its real lesson — fault models
need real-hardware measurement ([PDF](https://cseweb.ucsd.edu/~swanson/papers/DAC2011PowerCut.pdf)).

**(f) — DHUK's certificate claim is conditioned on TAMP, which we never validated.** We treat
DHUK (strongest row) and TAMP (untested row) as independent. The vendor does not: UM3387 §4.2.1 —
"To meet the platform resistance against physical attackers, the Integrator **should configure the
TAMP peripheral** with anti-tamper methods … when using the following functions: • **Nonvolatile
derived hardware unique key (DHUK) usage** • Volatile key storage in backup register (TAMP_BKPxR)
… • Cryptographic functions in hardware engines (SAES, AES, HASH, PKA, OTFDEC)" — and "When a
tamper flag raises … the Integrator **must** implement a security response." We use DHUK, use
`TAMP_BKP0R..7R` (the BHK latch), ship `tamp` log-only by default, force `tamp-wipe` on only for
shipping images, have **no TAMP silicon test**, and once had TAMP based at the wrong address long
enough that `tamp.rs:129` records it "went unnoticed". **Merge these into one ledger row with one
falsifying test.**

---

## 4. What exists and applies

### 4.1 Already installed, already CI-wired — use it more
- **Kani 0.67** ([docs](https://model-checking.github.io/kani/rust-feature-support.html),
  [ASE'26](https://arxiv.org/html/2607.01504v1)). MMIO-behind-a-trait was **demonstrated on this
  box** twice: the author's minimal seam proof (`0/52 checks, 0.18 s`, `[tool]`) and an
  independent fuller re-run with `kani::any()` over the whole backing array (242 checks, 62 s) —
  both VERIFICATION SUCCESSFUL. Hard bounds, empirically probed: `--target` is **rejected outright**
  (`CARGO_BUILD_TARGET` is *silently ignored* — a footgun); inline asm fails loudly; concurrency is
  **silently sequentialized**; volatile is `Partial`, i.e. modelled as plain memory — so Kani
  reaching MMIO code would be **silently unsound**, not refused. Kani models a non-faulting machine:
  it says nothing about the F-15.r5 FI double-scan. Kani and the FI argument are complementary;
  neither subsumes the other.
- **Miri** — structurally cannot reach MMIO, verified by probe: `0x40022000[noalloc] … has no
  provenance`, surviving both `-Zmiri-permissive-provenance` and `-Zmiri-disable-isolation`. It is
  the **provenance model**, not volatile and not isolation. `make miri` already covers four crates
  including the `ns_ptr_validate` primitives. Correct scope; do not expand.
- **TLA+/TLC** — installed, page-123 pilot done. The obvious next targets are (b)'s torn-QW action
  and (d)'s framing FSM.
- **cargo-checkct** ([repo](https://github.com/Ledger-Donjon/cargo-checkct)) — genuinely *formal*
  by design (relational symbolic execution + taint, not dudect statistics), **wired here with
  `target = ["thumbv8m.main-none-eabi"]` and six drivers**. Three caveats, and the first two are
  unresolved: **(i)** the author's own on-box BINSEC probe (boundary doc follow-up #6, `[tool]`)
  found that in `thumb` mode BINSEC emits `unimplemented` **uniformly — including on plain
  `adds`/`eors`/`bx`** — then dies in `disasm_core.ml`; so it is **not established** that anything
  in our tree is actually being proven, and it is **not established** whether cargo-checkct even
  drives a BINSEC frontend. **(ii)** `make checkct` **has no defined pass signal** — it
  deliberately includes a by-design-INSECURE `fisher_yates` driver, so exit code ≠ verdict.
  **(iii)** its stated axiom is that "all instructions have data-independent timing" — a bare
  silicon premise for the U585. Repo is **dormant** (last commit 2025-05-07, zero releases).
  **Resolve (i) and (ii) before citing `make checkct` as evidence of anything.**

### 4.2 Applies, absent from this box
- **Flux** ([repo](https://github.com/flux-rs/flux), actively maintained) — the only Rust verifier
  with a **published Cortex-M deployment**: TickTock (SOSP'25) verified Tock's process isolation,
  3.5 KLOC annotations over ~17.5 KLOC, and found **5 previously-unknown bugs in MPU-configuring
  code** + 2 in interrupt handling. Direct analogue of our 572-line `sau.rs`. Caveats: ARMv7-M only;
  FluxArm models **no** security extension; the hardware spec is 60 trusted lines validated by
  differential testing. **Only the method transfers** — but the method is exactly right.
- **Verus** ([repo](https://github.com/verus-lang/verus)) — real raw-pointer/provenance model, but
  **no volatile/MMIO vocabulary at all**, and **no published embedded/Cortex-M case study** (VeriSMo
  is bare-metal but x86_64, and reaches hardware via `external_body` + a bespoke ghost permission
  model — i.e. each register access becomes a trusted axiom). Note for the inventory: the
  `verus-power-flash-journal-pilot` row's tool choice is weaker-evidenced than Flux.

### 4.3 The seam pattern is mainstream, and our mocks already exist
`embedded-hal-mock` ([repo](https://github.com/rust-embedded/embedded-hal-mock)) is the ecosystem
proof that trait-based DI is standard practice. **Do not adopt embedded-hal itself** — 8 of our 13
traits (`Rng`, `Sha256`, `Saes`, `Flash`, `Otp`, `BootState`, `Tamp`, `ConsumptionMask`) have no
counterpart there, and those 8 are precisely surfaces (a), (b), (f). Wire the traits we already
have; `MockFlash`/`MockOtp`/`MockSaes`/`MockI2c` already exist in `hal/tests/positive_mock_platform.rs`.

### 4.4 External artifacts we should be consuming and are not
- **stm32-rs patched U585 SVD** ([index](https://stm32-rs.github.io/stm32-rs/)) — 3.7 MB, 202
  peripherals (100 NS + 100 `SEC_*` aliases), covering SAES/HASH/RNG/PKA/FLASH/GTZC/TAMP/RCC/I2C/
  SPI/TIM/USART/ICACHE/PWR. `saes.rs:31-32` **already cites the generated PAC as authoritative** —
  the artifact is not missing, the automated diff is. Scope honestly: **no SAU/MPU/NVIC/SCB/UID/OTP**
  (the `<cpu>` block has no `sauRegionsConfig`), and it is **layout, not behaviour** — `KEYSEL` is
  present at bitOffset 28/width 3 with a tautological description and **no** enumeratedValues, i.e.
  the SVD does not know KEYSEL selects Software/DHUK/BHK. It does cover `FLASH_OPTSR`, which makes
  `lockdown.rs`'s BENCH-CONFIRM'd `OEM1LOCK`/`OEM2LOCK` bit positions machine-checkable **today**.
- **Infineon I2C Protocol v2.03** ([PDF](https://raw.githubusercontent.com/Infineon/optiga-trust-m-overview/main/docs/pdf/Infineon_I2C_Protocol_v2.03.pdf))
  — **public and wire-complete**: §6 specifies PVER negotiation, TLS-PRF-SHA256 → 40-byte keyblock,
  PCTR/SCTR, finished messages, record encryption. This matters because our
  `optiga_shield_handshake.pv` says in its own docstring that it was derived from `shield.rs` and
  abstracts the framing — **a model derived from our driver can only prove we modelled ourselves
  consistently.** Re-deriving from the spec makes driver-vs-spec divergence detectable.
- **NIST EA suite** v1.1.8 ([repo](https://github.com/usnistgov/SP800-90B_EntropyAssessment)) —
  self-runnable over our own TRNG samples. Statistical estimation, `silicon-E2E` tier, never a proof.
- **ANSSI Open-ISO7816-Stack** ([repo](https://github.com/ANSSI-FR/Open-ISO7816-Stack)) — MIT, but
  **archived 2025-11-24** (last commit 2022-12-05), and usable only as an *abstract block-layer*
  oracle: our wire framing diverges (CRC-16 GP1.0 reflected poly 0x8408, 2-byte LEN, fixed NAD 0x5A,
  fixed IFSC=254 with no IFS negotiation, UM11225 `0xCF` interface-reset instead of ABORT/RESYNCH).

### 4.5 Certificates — real evidence, sharply bounded
- **SCP03 has a published proof** (Sabt & Traoré, [ePrint 2017/032](https://eprint.iacr.org/2017/032))
  — for the protocol **as specified**. The SCP02 break was a **padding oracle**, i.e. implementation
  behaviour outside any spec-level model. Our driver's padding/timing/error handling is outside the
  proof. **OPTIGA's Shielded Connection has no public security analysis at all** — that asymmetry
  belongs in a `THREAT_CLAIM_MAP` row.
- **OPTIGA CC**: BSI-DSZ-CC-0961 EAL6+ covers the **IC platform** (hardware + IC dedicated software
  + Infineon crypto libraries) on a 16-bit Intel-80251-compatible core. The Trust M **applet**,
  object/OID model, LcsO and Shielded Connection are IC *Embedded Software*, **above** the boundary
  (`OE.Resp-Appl` assigns application data handling to the environment). **V4-2019 expired
  2024-12-17**; cite V7-2024. ([V4 report](https://www.commoncriteriaportal.org/nfs/ccpfiles/files/epfiles/0961V4a_pdf.pdf))
- **SE050 CC**: [NSCIB-CC-180212-CR5](http://www.commoncriteriaportal.org/files/epfiles/NSCIB-CC-180212-CR5-1.0.pdf)
  is genuinely stronger — the TOE **includes** JCVM/JCRE/JCAPI + the GP Framework, the layer
  enforcing our UserID PIN policy. Two caveats bite exactly where we want it: **"The strength of the
  cryptographic algorithms and protocols was not rated in the course of this evaluation"** (so it
  does **not** discharge SCP03), and "Not all key sizes … satisfy the AVA_VAN.5 'high attack
  potential'". Covers only JCOP 4 SE050 v4.7 R2.00.11/R2.03.11 — **we have not confirmed our part
  matches**. SecureBox permits "execution of non-certified native software within the TOE".
- **EUCLEAK is the ceiling-setter** ([NinjaLab](https://ninjalab.io/wp-content/uploads/2024/09/20240903_eucleak.pdf)):
  a non-constant-time modular inversion in the Infineon cryptolib that "went unnoticed for **14 years
  and about 80 highest-level Common Criteria certification evaluations**". Scope it precisely: the
  attack was demonstrated on a **YubiKey 5Ci (SLE78)**; NinjaLab states the vulnerability "extends to
  the more recent Infineon Optiga Trust M" — for our part it is **tested-and-suspected, not
  demonstrated**, and it is **not a live break of our path** (C10-only per invariant #5; our OPTIGA
  driver implements exactly six APDUs and never invokes ECDSA signing). Its value is absolute and
  epistemic: **any row saying "discharged by EAL6+" is wrong.** CVE-2024-45678 is a *Yubico* CVE and
  does **not** cover OPTIGA — cite the paper, not the CVE.

### 4.6 **NEW, and the most under-used source we have: the SESIP silicon certificate**

The earlier read checked PSA Certified only, found TOE = "STM32U585 **TFM** v1.3.0", and correctly
concluded it transfers nothing (we don't run TF-M). **That was the wrong certificate.** A second,
**silicon-scoped** one exists and nothing in this repo cites it:

> **SESIP-2400133-01**, issued 2025-05-22, **valid to 2027-03-28**. TOE: "STM32U5/STM32WBA5 series
> Arm®-based 32-bit MCUs". Sponsor STMicroelectronics; lab **SGS Brightsight**. **SESIP3 + Physical
> Attacker Resistance + Software Attacker Resistance: Isolation of Platform**, under the "SESIP
> Profile for PSA Certified **RoT Component** Level 3 v1.0 REL 02".
> ST reference: **TN1545 — STM32U5x-STM32WBA5x Product Family SESIP Security Target, Rev 3** (public, 23 pp).

Why it applies where the TFM cert does not — **TN1545 §3.3.2: "The platform does not include any
firmware component and the implemented hardware is not reprogrammable."**

Four things it gives us immediately:

1. **A die pin.** TN1545 §3.3.1: DEV_ID `0x482` @ `0xE004_4000`, **REV_ID `0x3003` @ `0xE004_4002`
   = "STM32U585x version 3.3 (rev U)"**. Named errata: **ES0499**. Our anti-counterfeit probe
   (`docs/security/production-security.md:387`) checks DEV_ID only. **The certificate covers rev U
   and nothing else** — add the REV_ID check and record what our bench dies are.
2. **RDP-2 evidence, correctly scoped.** UM3387 §4.2.1: "**In its certified configuration, the
   platform is deployed in RDP level 2.**" So SESIP3 Physical Attacker Resistance — TN1545 §3.3.3:
   "**Redundancy checks to prevent RDP and HDP deconfiguration by physical tampering or
   perturbation**", plus transient-perturbation detection in SAES/PKA — was evaluated **at RDP-2, on
   rev U, by SGS Brightsight, currently valid**. That is better `T`-tier evidence than the
   absence-argument the boundary doc §5 currently leans on. It is still **bounded expert effort, not
   proof** — EUCLEAK is the standing refutation of reading it as more.
3. **We ship deliberately OUTSIDE the certified configuration, and that is correct.** TN1545 §3.5.1:
   "In the certified configuration, the Integrator allows the platform to regress to RDP Level 1 when
   the TOE secret **OEM2KEY** is successfully provisioned, and the **OEM2LOCK** option bit is set."
   `shared/src/lockdown.rs:99-104` mandates the **opposite**, on purpose — "A shipped unit must have
   **NO OEM key provisioned** — otherwise a transit attacker could pre-plant an OEM2 password
   enabling a later RDP-2 → RDP-1 regression" — enforced by `oem_locks_absent()`. So the certificate's
   "Field return of platform" SFR does **not** hold for us (no RMA path), and we must never claim
   blanket conformance. **This is a ledger row, not silent inheritance**, and it collides with the
   inventory's OWNER-GATED `provisioning-wipe-rma-authority` row.
4. **A supply-chain finding, previously unknown.** UM3387 records that ST's CubeIDE init script sets
   the **OEM2 default password `0xFACEB00C 0xDEADBABE`**, which "allows regression from RDP level 2".
   **Any board ever initialized by that script carries a known RDP2→RDP1 regression password.** This
   independently vindicates the `lockdown.rs` check — cite it there — and warrants a bench probe of
   our own boards' OEM2LOCK state.

And one that lands on our weakest row: **UM3387: "For the device to generate random numbers as
specified in NIST SP800-90B, the Integrator must use the TRNG peripheral with the *configuration A*.
Refer to the *validation conditions* subsection of the RNG section in [RM_U5]."** Our
`RNG_CR_NIST_DEFAULT = 0x00F0_0D00` (`rng.rs:44-47`) is sourced from **ST's LL driver**, not from
RM0456's validation-conditions table, and has never been compared to configuration A. That converts
the TRNG row from "bare-TCB, no ST statement" into **a falsifiable afternoon-sized check with a
section anchor**. Either answer is worth having: match ⇒ cite it, and ESV cert E11 ("STM32U5x TRNG")
plausibly applies; mismatch ⇒ `hal/src/lib.rs`'s SP 800-90B obligation is **false today**, and the
**irreversible** OTP master burn draws from a non-validated configuration.

### 4.7 Ledger patterns worth stealing (methodology, not tools)
- **OpenTitan** ([countermeasure.py](https://raw.githubusercontent.com/lowRISC/opentitan/master/util/reggen/countermeasure.py))
  — a closed 21-asset/30-type vocabulary with a **bidirectional** RTL↔Hjson cross-check: an RTL
  `// SEC_CM:` tag with no entry errors, *and* an entry absent from RTL errors. Only the **ledger**
  half transfers — they FPV silicon they designed; we never can.
- **seL4** — states machine-interface assumptions **in formal logic** and discharges them one at a
  time as tooling allows ("we do not need to trust the compiler and linker any more on architectures
  supported by our binary verification"). The precedent is *discharge progressively*, not *assume and
  stop*.
- **TF-M** ([threat model](https://trustedfirmware-m.readthedocs.io/en/latest/security/threat_models/generic_threat_model.html))
  — has **no** hardware-assumption ledger and **no** formal isolation proof, for our exact core class,
  with a port for our exact dev board. Its "**Transferred**" marker ("the threat … must be handled by
  downstream users") is a free primitive worth adopting for our `T` rows.
- **GSN** ([SCSC-141C](https://scsc.uk/r141C:1)) — with the caveat that a GSN `A` node is
  *definitionally unsubstantiated*, so a premise validated by test is a **Goal+Solution**, not an
  Assumption. Do that split explicitly or the diagram lies.

---

## 5. What does not exist — the negative results

These are results, not gaps in the search. Each was probed with multiple phrasings against primary
sources.

### 5.1 No public formal ARMv8-M model, in any framework. **Closed.**
- ARM's public machine-readable/ASL releases are **A-profile only**
  ([release note](https://alastairreid.github.io/ARM-v8a-xml-release/): "version 8.2 of the ARM
  **v8-A** processor specification"; [mra_tools](https://github.com/alastairreid/mra_tools) documents
  exactly three v8-A tarballs and is ~6.5 y stale).
- ARM's **internal** v8-M ASL exists and was validated to a high standard — Reid, OOPSLA 2017: 59
  properties, 315 VCs, **299 proved**, **12 bugs found incl. 2 security bugs, all fixed by ARM**
  ([paper](https://alastairreid.github.io/papers/OOPSLA_17/)). **Never released.** *Corrections to
  earlier readings*: it is **single-authored**; **13** VCs timed out (not "6–7"), so Reid states "our
  proofs are not yet sound"; and **SAU/IDAU/CMSE/SG appear zero times** — it validated reset,
  exceptions, lockup, debug and S/NS register banking, not the mechanisms we depend on.
- [`rems-project/sail-arm`](https://github.com/rems-project/sail-arm) is A-profile only
  (`arm-v8.5-a`, `arm-v9.3-a`, `arm-v9.4-a`), auto-translated from ARM's *internal* ASL under
  bilateral agreement. **Therefore [Isla](https://github.com/rems-project/isla) and
  [Islaris](https://people.mpi-sws.org/~dg/papers/pldi2022.pdf) have nothing to consume** — one
  missing input, three dead tools.
- Binary tooling agrees: BINSEC has no M-profile decoder; angr/VEX has a v8-M-aware *arch description*
  (incl. `msp_s/_ns`, `msplim_s/_ns`) but **zero** v8-M security-extension **decode** in
  `guest_arm_toIR.c`; Ghidra decodes M-profile, but implements the stack-limit registers as
  **uninterpreted pcodeops** and has **no SG/TT definition at all**; ARMORY stops at ARMv7-M; FiSim
  hardcodes `UC_MODE_ARM` and never selects M-class; Corana's "M33" model is the Cortex-M7 model plus
  six acquire/release ops, with **zero** CMSE.
- **Even a hypothetical Sail v8-M model would only be half.** The IDAU is IMPLEMENTATION DEFINED
  (ST's), and **GTZC is an ST peripheral appearing in no ARM specification** — and GTZC is where
  `sau.rs` puts our enforcement.
- **The blocker is availability, not effort.** Two routes exist (license the internal ASL — the exact
  route sail-arm took for A-profile; or hand-author from DDI0553 prose, precedented by Sail's own
  handwritten Armv8-A fragment) and both are person-years yielding a **bespoke, unvalidated model
  whose own correctness becomes a new cited-TCB axiom**. Record as **permanently blocked upstream**.

### 5.2 No formal verification of TF-M, and no M-profile TrustZone isolation proof anywhere.
The reference SPE for our exact silicon has none — assurance is threat models, review, testing, MISRA
static analysis (BUGSENG ECLAIR in Open CI — a real formal method, but coding-standard/UB compliance,
not SPM/PSA/isolation correctness) and PSA/SESIP evaluation. **We are at the industry norm, and
`make gtzc-enforcement-hw`'s 7/7 RAZ-fault test is arguably stronger evidence than TF-M publishes.**
Scope the negative correctly: MPU-based M-profile isolation **has** been proven —
[Pip-MPU](https://arxiv.org/abs/2301.04546) (Coq, ~10 kLOP, found a critical isolation bug) — but it
is **MPU, not CMSE/SAU/IDAU**, is **partial** (3 of 15 services), proves an ownership invariant that
is explicitly "not concerned about the read, write, and execution rights", and its model is
architecture-neutral. The surviving true statement: **every TrustZone-M/CMSE isolation proof is
A-profile — i.e. there are none.**

### 5.3 No formal model of T=1 / T=1′ / IFX-I2C framing.
The only formal T=1 work found (Chouali et al., PLTL/SPIN, [arXiv:cs/0602040](https://arxiv.org/abs/cs/0602040))
models block/last-block/ack alternation **only** — grep yields zero occurrences of I/R/S-blocks,
sequence numbers, EDC, chaining, resynch, retry, WTX or guard timing. **It is not a head start.**
Nothing exists for NXP's T=1′ or Infineon's IFX-I2C. No verified I2C **driver** exists in any
language (the I2C formal work is **RTL** verification, requiring design source).

### 5.4 No embedded flash/OTP litmus suite exists.
The tradition exists in two **disconnected** halves and nobody joined them: the
model-validated-by-generated-tests **method** ([Ferrite, ASPLOS'16](https://homes.cs.washington.edu/~bornholt/papers/ferrite-asplos16.pdf);
herd7/litmus7), and the power-cut **rig on real flash** (Tseng, DAC'11). Joining them for STM32U5
appears **unprecedented** — which makes it a genuine research contribution and a bad first project.
Ferrite is **not** a hardware-contract validator: §5.1 says it "abstracts the behavior of storage
hardware with a disk model", having rejected interposing on hardware as "expensive and imprecise";
its disk model is an assumed input, never validated. Repo is 9+ y stale, pinned to Rosette 2.0.

### 5.5 No SVD → formal-model generator; no ARM/STM32 errata corpus; no errata-vs-usage checker.
[RemembERR](https://comsec.ethz.ch/wp-content/files/rememberr_micro22.pdf) is "the first large-scale
database of microprocessor errata" — **Intel/AMD only**, 2,563 entries, built by **manual four-eyes
annotation**, because errata sheets "are not machine-readable" and contain errors about their own
errata. **No tool anywhere machine-checks errata-vs-usage, for any architecture.** Its schema
(trigger ∧ / context ∨ / observation ∨) is portable; its data is not. Its sharpest result — **>40% of
errata need two combined triggers** — is a direct warning that our single-condition bench tests
systematically under-detect.

### 5.6 Refuted or corrected claims — checked and found wanting
Recorded so they are not re-litigated:

| Claim | Verdict |
|---|---|
| "CompCert doesn't reach Thumb/M-profile" | **False.** `configure -arch armv7m` = "ARMv7-M + VFPv3-d16"; `-mthumb` is the default for that profile. It's still reference-only for us — CompCert compiles **C**; our secure world is Rust. No `armv8m` target exists, so no CMSE/SAU. |
| "The ARMv8-M ASL doesn't exist / ARM never built one" | **False.** It exists, was validated (Reid), and is unreleased. The blocker is *publication*, not existence. |
| "Tseng (DAC'11) refutes flash chunk-atomicity" | **Refuted for us.** MLC-scoped, raw NAND, no ECC, no NOR; its own §5 preserves SLC log recovery. |
| "The ST forum thread proves STM32U5 OTP half-QWs are silicon-stranded" | **Refuted.** ST confirmed the issue and fixed it **in STM32CubeProgrammer v2.19.0**, stating no root cause; a tool-side fix is consistent with "never latched" *and* with "silicon strands them". It is also the **host SWD path**, not our firmware path. **Cite it as silicon semantics in neither direction.** |
| "Ferrite is the template for validating a hardware crash contract" | **Refuted.** It validates *software* against an *assumed* disk model and explicitly excludes "disk corruption caused by … broken hardware". |
| "PERRY/SEmu/Fuzzware models can serve as our hardware contract" | **Refuted.** PERRY infers from the driver (circular); Fuzzware's "model" describes firmware *value consumption*, not the device; SEmu is manual-prose NLP that empirically **cannot model clock peripherals or I2C**. |
| "EAL6 means nobody built a formal model" | **Inverted.** ADV_SPM.1 is **mandatory** in the EAL6/EAL7 packages. But its scope was an ST-author *assignment* (CC 3.1), and the JIL/EUCC CC:2022 minimum is a named sub-TSF (MPU/MMU + code loader for ICs; the application firewall for Java Card). **None of that covers OPTIGA's LcsO or SE050's APDU/policy behaviour** — and the artifact is confidential regardless. |
| "Trezor Safe 5 / STM32U5 is unaffected by the Donjon RDP glitch" | **Stale, and it's Trezor's wording, not Ledger's.** Ledger said only that no U5 FI attack was public "at the time of this writing". Šimoník (Masaryk, 2025) reports **76% voltage-glitch PIN-check bypass on the STM32U5A9**. |
| "No published break on a Cortex-M33 STM32" | **False.** µ-Glitch (USENIX Sec'23) **disables TrustZone-M on the STM32L5** (M33) by faulting SAU + Global TZ Configuration, and cites ST's joint L5/U5 TrustZone app note. |
| "BINSEC decodes plain Thumb-2 fine; only CMSE (`sg`/`bxns`/`tt`) fails, so the real boundary is CMSE, not thumbv8m" — *this survey's own G1 correction* | **WITHDRAWN by the author's on-box probe** (boundary doc follow-up #6, `[tool]` — which outranks `[survey]`). BINSEC does expose `-arm-supported-modes {both\|thumb\|arm}`, so the SOTA doc's flat "no M-profile decoder" is imprecise about the *option surface*. But in `thumb` mode BINSEC emits `unimplemented` **uniformly, including on a plain `adds`/`eors`/`bx` function**, then dies with an assertion failure in `disasm_core.ml`; plain and CMSE probes are **indistinguishable**. **The SOTA doc's operational verdict — BINSEC NO-GO for our thumbv8m ELF — stands.** The inventory row is still wrong, but for the *original* reason. Recorded here as a caught error, not deleted. |

---

## 6. What we could build

Ranked by (value to a **live claim**) × tractability. Read as a **pipeline, not a menu** — the
dependency order is forced: **pin+resolve the contract → ledger it → wire the seam → prove logic
against it; silicon tests validate the leaf.**

### Tier 1

**P1. RM0456/ES0499 §-anchor pass + kill the false HAL claim.**
*Property:* every prose hardware premise in `hw/otp.rs`, `hw/flash.rs`, `hal/src/lib.rs` traces to a
§/page anchor, and the two contradictory flash claims resolve to one. *Not established:* anything
about silicon — this is claim-truth hygiene (unsourced prose → cited-TCB, a real tier change).
*Refactor:* none. *Artifact:* §-anchored doc comments + a resolution note. *Negative control:* n/a
(not a gate). *Stop condition:* if RM0456 does not settle partial-QW reprogramming, **stop and record
it as an open silicon question** → P6b's first target. Do not guess. *Effort:* **2–4 d.** TN1545/UM3387
now name the exact anchors (RM0456 §48 RNG validation conditions, §3.10.1 OEM2 unlock sequence B, §50
SAES wrapped keys), so this is a targeted lookup, not a 3000-page search.

**P2. Hardware-assumption ledger — as an *extension*, not a third ledger.**
*Property:* every silicon premise a claim depends on has an ID, owner, primary-source anchor, status,
a named falsifying test, and the consuming claim. Gate fails if a claim names an unledgered assumption
or overstates a tier. *Not established:* anything about hardware — this is **enumeration discipline**.
*Refactor:* **extend `TRUST_ASSUMPTIONS.md`'s scope (its §Out-of-scope excludes firmware — that is the
actual defect) and reuse `AXIOM_STATUS.json`'s schema + `check_ledger_consistency.py --self-test`.** Do
not mint a third ledger. *Reframed by §4.6:* **half of this already exists and is addressed to us** —
TN1545 §2.1 Table 6 publishes four operational-environment objectives (`KEY_MANAGEMENT`,
`TRUSTED_INTEGRATOR`, `UNIQUE_ID`, `LIFECYCLE`) and UM3387 §4.2.4 enumerates the measures to discharge
them. **Import ST's objectives and answer each with our evidence + a named test** — cheaper and more
defensible than inventing a novel artifact, and it makes the OEM2 deviation a visible row.
*Negative control:* `--self-test` feeds corrupted ledgers — a row with no cite; a claim referencing an
unledgered ID; a row claiming `status: validated` whose named test target does not exist in the
Makefile. *The trap:* the `falsifying_test` column **must distinguish `wired` (a real passing target)
from `asserted`**. A ledger where every row says `TODO` is theatre with a schema — print the
wired/asserted ratio and fail on `validated` without a wired target. Today the honest ratio is poor.
*Effort:* **1–2 wk** after P1.

**P3. SVD-derived register-transcription gate.**
*Property:* every hand-transcribed peripheral base/offset in `secure/src/hw/*` matches the patched
U585 SVD — **plus** `lockdown.rs`'s BENCH-CONFIRM'd `OEM1LOCK`/`OEM2LOCK` positions in `FLASH_OPTSR`,
which given §4.6 is the highest-value single use of the SVD in the repo (it guards a ship gate).
*Not established:* **behaviour, ES0499, or SAU/SCB/NVIC/OTP** (absent from the SVD). *Refactor:* none;
vendor the SVD + a digest pin. *Artifact:* `make verify-svd-transcription`. *Negative control:* flip a
base address in a fixture → RED. *Why:* the repo is **3-for-3 on transcription failures** — TAMP at the
wrong address (silent, never exercised), GTZC TZSC writes landing on the TZIC base and silently
no-op'ing, ICACHE off by `0x400`. CompCert's `TargetPrinter` failure mode exactly. *Effort:* **3–5 d.**

**P4. Gate + de-cruft the page-123 TLA+ pilot.**
*Property:* the banked "SIGS-first ordering CONFIRMED (1M states)" claim becomes **re-runnable by
someone other than its author**. *Artifact:* `make verify-tla-page123`; pin `tla2tools.jar` with a
digest + fetch step; `.gitignore` the 29 untracked `_TTrace_*` files. *Negative control:* a mutated
spec reversing SIGS-first must make TLC report a violation. *Why:* an already-cited claim with no
executable evidence is, by our own definition, theatre. *Effort:* **1–2 d.**

**P4b. Read TN1545 + UM3387; add the REV_ID check.** *(§4.6 — folded here because it is hours.)*
*Property:* four bare-TCB rows gain a vendor+lab anchor; the OEM2 deviation becomes explicit; the
config-A question becomes answerable; rev-U coverage becomes checkable. *Artifact:* REV_ID `0x3003`
probe beside the existing DEV_ID `0x482` probe; ledger rows. *Effort:* **1 d.**

### Tier 2 — real proofs, gated on the seam

**P5. Wire the `hal/` seam + promote the mock to `hal-mock/`.** ← **the structural move**
*Property:* driver **logic** (journal append, compaction, counter scan, burn-completion predicate,
framing) becomes host-linkable — hence Kani/Miri-reachable — and the hardware contract becomes a
**compile-time-enforced object** rather than prose that has already silently drifted false.
*Not established:* anything about MMIO or silicon. **The model-vs-silicon gap does not close — it
moves.** Answering directly: this is **progress, not theatre, iff** (a) the contract is a ledgered
assumption (P2) **and** (b) it has an empirical leg (P6b / P8a / `gtzc-enforcement-hw`). Untethered
from both, it *is* theatre. Tethered, it is exactly Pancake's and Veld's posture — i.e. the 2025 SOTA.
*The live defect it fixes:*

> `hal/src/lib.rs:104-113` declares itself the specification and asserts that programming an
> already-cleared bit is a **no-op**. `secure/src/hw/flash.rs:723-729` asserts ECC **locks** the value
> and forbids re-programming. **Both cannot be true.** The page-124 PIN-counter design depends on
> which. `secure/Cargo.toml` has **no dependency on `hal/`** — so nothing, not the compiler, not CI,
> not a reviewer, detects it. **An unsound axiom with no gate** — Kobeissi's *Verification Theatre*
> ([ePrint 2026/192](https://eprint.iacr.org/2026/192)) live in-repo.

*Refactor (cheaper than assumed):* `MockFlash`/`MockOtp`/`MockSaes`/`MockI2c` **already exist** in
`hal/tests/positive_mock_platform.rs`. (1) add `pqsigner-hal` to `secure/Cargo.toml`; (2) promote the
test mocks into the already-named-but-deferred `hal-mock/`; (3) carve driver **logic** behind traits,
leaving raw MMIO in the leaf (`hw/mmio.rs` stays exactly where it is — Miri can never reach it).
***THE TRAP — scope the seam away from page 124.*** Trait monomorphization is in tension with the
`#[inline(never)]` at `flash.rs:862`, which exists **specifically** so `nsc::gated_unlock`'s FI FAIL-IN
sees a real `bl` at the call site; an inlined body lets a glitch skip the program with no branch for
the sentinel to catch. **A generic refactor of the PIN path could silently weaken FI hardening.** Take
the seam through `offchain_state`/journal/OTP-predicate logic; leave page-124 alone or preserve the
`bl` explicitly and re-verify. *Stop condition:* if carving a driver forces the FI `bl` to disappear,
stop on that driver and record why. *Effort:* **3–4 wk** (does not include flash.rs's 2243 lines
wholesale — carve incrementally).

**P6a. OTP monotone-lattice model + half-burn refutation (Kani, post-seam).**
*Property:* over a `MockOtp` encoding **quad-word program-once** (not a bit-lattice — see §2), that the
version floor never depends on a non-monotone read, and — the real payload — that
**`is_device_master_burned()` is wrong**: it returns `true` on any non-`0xFF` word (`otp.rs:503-513`),
so a crash between the two quad-words of `burn_device_master` yields a device reporting "burned" while
holding a **128-bit-entropy master key** that roots every SE pairing secret. Decidable; Kani refutes it.
Fix = require both QWs + a completion marker. This is Ariadne's crash contract exactly ("if it crashes,
the counter may or may not have been incremented" — recovery must be safe under that ambiguity; today
it isn't). *Not established:* fuse physics. **Model the third outcome** (torn QW → ECC-uncorrectable,
neither old nor new) explicitly or the proof is optimistic. *Negative control:* a mutant accepting a
single-QW burn must fail; a mutant allowing 0→1 must fail. *Effort:* **1–2 wk** post-P5. **Value: a
live bug in an irreversible path.**

**P6b. OTP one-wayness silicon probe — *and it does NOT need a sacrificial board*.**
Earlier costing said "buy a board to destroy". Wrong: `otp.rs:32`'s region map shows
`176..512 | 336 B | **Unallocated**` — **21 free quad-words**, with the device master at 128..160. Probe
an unallocated QW (e.g. `OTP_BASE+0xB0`); the master region stays virgin, the board stays usable, and
you get **~21 shots on one board** at swept delays. Only blocker: `program_otp_qw`'s
`debug_assert!(addr + 16 <= OTP_BASE + OTP_RESERVED_BYTES)` (=176), which a test-only path must widen.
*Property:* whether a second program of a burned QW is rejected on **our** silicon, and what a
half-burn actually does. Validates P2's OTP row and P6a's contract; settles the C-10 ambiguity that
prose cannot. *Negative control:* the test must **observe** PGSERR/PGSERR-class SR bits, not merely
not-crash — assert the specific bit. *Effort:* **2–3 d, one non-sacrificial board.** → **promote to
Tier 1.**

**P7. Kani over T=1′ pure framing functions — no seam needed, do it now.**
*Property:* `se050/t1oi2c.rs`'s `crc16`/`build_frame`/`validate_frame` are **pure functions over byte
slices** — panic-freedom, framing round-trip, no accept-of-malformed. Zero refactor, zero silicon.
*Adjacent cheap win:* our `crc16` claims byte-compatibility with NXP's
`phNxpEseProto7816_ComputeCRC`, but that reference is **not vendored and not differentially tested**,
and no public KAT for this variant exists — build our own. *Negative control:* a mutant polynomial /
off-by-one LEN must fail. *Effort:* **3–5 d. The cheapest real proof in the set.**
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
