DankGecko/pq1/docs/verification/hardware-assumption-boundary-2026-07-17.md

# The honest hardware boundary — what PQSigner can and cannot ever prove about silicon

**Snapshot date: 2026-07-17.** Program/epistemology layer. This document states the
**ceiling** of the verification effort against the six hardware surfaces currently held as
bare assumption, so that no claim written elsewhere in this repo — README, `THE_CLAIM.md`,
a release note, a marketing line — can exceed it by accident.

It is the synthesis layer over the 2026-07-17 external-tooling survey (≈45 adjudicated
tool/paper claims across ARMv8-M ISA, device models, flash/OTP crash consistency, secure
elements, methodology, Rust-embedded FV, and SCA/FI). **It does not re-derive that survey.**
Where a finding is cited below it is cited by its survey id (A*, B*, C-*, D*, E*, F*, G*).

**Evidence tiers within this document — they are not uniform, read the marker:**

| Marker | Meaning |
|---|---|
| **[code]** | Read from this tree by the author this pass; every `file:line` claim about PQSigner is this tier. |
| **[tool]** | A binary was run on this box by the author this pass. Specifically: the Kani seam proof (`0/52 checks, 0.18s`) and the BINSEC thumb/CMSE probe in follow-up #6. |
| **[survey]** | Sourced by a research agent and then adversarially re-checked by an independent agent that fetched the primary source itself. This covers the ~45 external tool/paper claims (Reid's bug counts, µ-Glitch, Šimoník, Sabt–Traoré, TickTock, PoWER, the CC certificate numbers, EUCLEAK's scope). Rigorous, but **not author-verified** — treat as good secondary evidence, and re-check before any of it becomes load-bearing for a public claim. |

Where **[tool]** and **[survey]** disagree, **[tool]** wins and the disagreement is recorded
rather than silently resolved — see follow-up #6, where the author's own probe **withdrew** a
survey correction.

Companion docs — read them, do not duplicate them:
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
