DankGecko/pq1/docs/architecture/trezor-comparison.md

# Trezor Firmware → PQSigner OS: Adoption Audit

Date: 2026-04-24
Scope: `/home/nicola/repos/trezor-firmware` (monorepo, all models) vs `/home/nicola/repos/PQSigner_OS`
Primary architectural twin: **T3W1 ("Trezor Safe 7") — STM32U5A9 + Optiga Trust M** — same MCU family, same SE chip, same TrustZone-M substrate.

> **2026-06-30 — fresh critical pass extending this doc:** see **[`trezor-comparison-critical-port-2026-06.md`](./trezor-comparison-critical-port-2026-06.md)** (Trezor HEAD `a0fe1eccc2`). It covers areas this doc deliberately skipped (trusted-display UI framework, runtime resilience: HardFault/IWDG, RDI) and **critically re-examines several verdicts here** — notably it corrects: §2.4 NSC ptr-validate (now **closed-via-Kani**, C-3); §8.3 Pattern 2 OTP read-back (**already done** `otp.rs:372-377`, C-4); §3.2 SAES key-privilege split (**applet artifact, do not chase** — `7fb272bade`, C-2); the §8.2/§8.5 "monolithic S-world is fine, `secmon` N/A" stance
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
