DankGecko/pq1/docs/security/research-bundles/results/README.md

# Historical external review outputs

These files are immutable outputs returned by earlier external research runs.
They are retained as audit evidence and may describe repository state that no
longer exists. They are not regenerated, normative, or current contributor
guidance.
