DankGecko/pq1/docs/security/measured-boot.md

# FSBL-rooted firmware fingerprint

> **Geometry/resource scope.** This document explains the measured-display
> property of the current legacy bench FSBL. Its pages-0..3 / 32-KiB layout is
> not production authority. Draft 1.1 is an unapproved research candidate that
> proposes pages 0..4 and a 40,960-byte hard ceiling, with physical LOAD-span
> and RAM/worst-case-stack gates still open.

## What this defends against

A firmware update — even one signed with the legitimate vendor key, or
one shipped by a compromised CI pipeline — must not be able to **forge
what the user sees on the NV3007 LCD at boot**. The 8 BIP-39 measurement
words ("OS Fingerprint") are the user's only out-of-band channel for
deciding whether the firmware running on the device matches the
reproducible-build artifact `./measure.sh` produces from the public
source tree. If those words could be faked, the entire reproducible-
build story collapses.

The target defended property (after the production FSBL/WRP gates close):

> The user trusts only the *initial provisioning*. Any subsequent
> firmware update is unable to forge the 8 words shown on the NV3007 LCD.

The user writes down the 8 words at first boot (or compares them to
the value `./measure.sh` produces for the released commit). On every
subsequent boot they glance at the LCD. If the words match the
recorded baseline, the firmware is byte-identical to what they trust.
If the words differ, an update happened — legitimate or not — and the
user re-verifies the new words against the published
`measurement.txt` for that release before entering their PIN.

## What this does NOT defend against

- A **malicious factory** that ships an FSBL with a tampered vendor
  pubkey. The 8 words generated by such an FSBL are honest (FSBL
  computes them over real bytes), but they reflect a firmware the
  user has never seen elsewhere. The defense is exclusively
  *post*-provisioning: if the FSBL programmed at the factory was
  honest, no subsequent firmware update can lie. Factory-time
  integrity is supply-chain-side; see `docs/firmware/reproducible-builds.md`
  for the recommended user workflow (compare the very first boot's
  8 words to `./measure.sh` for the published release commit).
- **Physical-fault attacks** on FSBL's SHA-256 or display path.
  Defended *within* the FI envelope FSBL already maintains
  (`fsbl/src/fi.rs::check_true_into_sentinel`); a coordinated multi-
  glitch attack remains a residual risk handled at the
  silicon-hardening layer (RDP-2, TAMP, consumption mask).
- **Denial of service.** A malicious slot can crash the device before
  the user finishes reading the FSBL row, then loop. The LCD would
  flicker honest words but never settle. This is detectable as a
  visible UX regression and is not forgery — the displayed bytes are
  always correct when displayed at all.

## How it works

```text
                ┌──────────────────────────────────────────┐
legacy bench    │ FSBL (pages 0..3 of bank 1, 32 KB total) │
flash region    │   1. Read manifest A, manifest B         │
                │   2. verify_signature(both)              │
                │   3. verify_images(both) → digest        │
                │   4. pick_slot()        → (slot, digest) │
                │   5. ┌───────────────────────────────┐   │
                │      │ render::render_fingerprint    │   │
                │      │   * SPI + NV3007 init         │   │
                │      │   * firmware_fingerprint_lines│   │
                │      │   * draw + flush + hold ~3 s  │   │
                │      └───────────────────────────────┘   │
                │   6. branch::into_slot(slot)             │
                └──────────────────────────────────────────┘
                                  │
                                  ▼  (control passes to slot;
                                       FSBL flash stays read-only,
                                       FSBL row stays on the LCD)
                ┌──────────────────────────────────────────┐
mutable slot    │ secure.elf — verified, but slot code     │
(updatable)     │ can lie about its own hash               │
                │                                          │
                │   measured_boot::run()  [advisory]       │
                │     * `firmware_hash()` (self-attested)  │
                │     * displays its OWN 8 words           │
                │                                          │
                │   ── if FSBL row vs secure-world row     │
                │      DIVERGE → tamper signal             │
                └──────────────────────────────────────────┘
```

The LCD words FSBL renders are derived from the SAME bytes
`verify_images` just SHA-256'd to check against the signed manifest
hash. Surfaced via `verify_images` returning `Option<[u8; 32]>` (the
digest on success) instead of `bool`. The pure layout function is
`sphincs_tz_bip39::firmware_fingerprint_lines` — shared with the
secure world's `measured_boot::run` so the two displays must show
identical bytes for any honest slot.

### Why 5-char prefix

The full BIP-39 wordlist (`WORDLIST_FLAT: [[u8; 8]; 2048]`) plus its
length table costs ~18 KB of rodata. It did not fit the legacy 32-KiB
bench linker region alongside the rest of the bootloader. The FSBL therefore
ships a
`WORDLIST_PREFIX5_PACKED: [[u8; 3]; 2048]` base-27 table (~6 KB), generated
at build time from the same canonical `bip39/src/wordlist.rs` source the
secure world uses. `word_prefix_at` decodes the selected entry back to the
exact five zero-padded bytes before rendering.

This is safe because:

* BIP-39's English wordlist guarantees the first **4 chars** are unique
  per word, so a 5-char prefix unambiguously identifies any wordlist
  entry. The 5th byte serves as a visual sanity buffer for the user.
* Both the legacy FSBL and advisory secure-world screen draw the exact
  4×16 byte grid returned by `firmware_fingerprint_lines`. They therefore
  use the same five-character truncation, spacing, and short-word padding;
  any honest-image display divergence is a real defect or tamper signal.

The `bip39/tests/prefix5_roundtrip.rs` test pins these invariants
(prefix = first 5 bytes of `WORDLIST[i]`; all 2048 prefixes unique).

## User workflow

### First boot (initial provisioning)

1. Power up the device for the first time.
2. Observe the 8 words on the NV3007 LCD (~3 s, then the boot continues).
3. Independently rebuild the release commit (`./measure.sh` or
   `nix run .#measure`) on a separate trusted machine.
4. Confirm the 8 words match. Record them on paper as the baseline.

### Every subsequent boot

1. Power up. Glance at the NV3007 LCD.
2. **If the words match the baseline:** the firmware is unchanged.
3. **If the words differ:** a firmware update happened. Re-verify
   the new words against the published `measurement.txt` for that
   release commit. Only enter the PIN once you've confirmed the
   update is the one you expected.

### During a firmware update

The companion app shows the new release's "Nf" / "Nk" fingerprint
pages (`secure/src/fw_update/mod.rs::confirm_install`) before COMMIT
writes anything to flash. After reboot, FSBL re-hashes the now-active
slot and shows the new 8 words — these MUST match the "Nf" the user
confirmed. If they differ, do not enter the PIN: the bytes that landed
in flash are not the bytes whose hash was signed (a tamper-during-
streaming attack or a flash failure). The COMMIT-time
`verify_images` *also* catches this and auto-aborts, but FSBL is the
user-visible belt-and-braces.

## Same byte range on both rows (FSBL and secure-world)

For the FSBL row and the secure-world row to show identical words for an
honest slot, both must SHA-256 the **same bytes**. FSBL hashes
`[slot_secure_addr, slot_secure_addr + secure_len)` — i.e. `[ORIGIN(FLASH),
__veneer_limit)` of the slot it verified (`fsbl/src/verify.rs`). The
secure-world `measured_boot::firmware_hash()` must therefore root its
measurement at the **same image base**, not a hardcoded address.

It does this by deriving the base from the `__vector_table` linker symbol
(emitted by cortex-m-rt at `ORIGIN(FLASH)`) rather than a constant. The
symbol resolves to wherever the running image is linked + loaded —
`0x0C00_0000` for the monolithic secure build, `0x1000_0000` on QEMU, and
the slot base (e.g. `0x0C00_E000`) once the A/B slot-relocated build ships.
A hardcoded base would silently measure the FSBL + manifest region instead
of the running slot the moment the A/B layout relocates the image, making
this cross-check mis-fire on honest firmware (the "divergence ⇒ tamper"
signal would then be permanently tripped and ignored). See
`docs/security/audits/boot-fsbl-20260611-141459.md` (MEDIUM-1).

> **Status of the cross-check.** No shipping build exists. The default
> monolithic bring-up profile has only the self-attested secure-world row;
> separate legacy bench FSBL/A/B exercises do not establish a production
> trust root. The base-tracking fix above is what makes the two rows agree in
> a future approved slot-relocated build. There is still **no
> automated comparator** — divergence detection is a human glance at the
> LCD against the recorded baseline. Wiring an on-device comparator (FSBL
> leaving its verdict in a known SRAM/RTC-backup slot for the slot to echo)
> remains future work and is tracked as the open half of MEDIUM-1.

## Implementation entrypoints

- `secure/src/measured_boot.rs::image_base` / `firmware_hash` — measures
  `[image_base(), flash_end())`, where `image_base()` is the
  `__vector_table` link symbol (= `ORIGIN(FLASH)`), so the measured range
  equals what FSBL hashed regardless of which slot the firmware runs from.
- `fsbl/src/verify.rs::verify_images` — returns `Option<[u8; 32]>`,
  the secure-image digest on success.
- `fsbl/src/main.rs` — calls `render::render_fingerprint(&secure_digest)`
  after slot selection, before `branch::into_slot`.
- `fsbl/src/render.rs::render_fingerprint` — NV3007 LCD end-to-end driver
  (init, draw, flush, hold).
- `fsbl/src/nv3007.rs` — minimal NV3007 142×428 SPI LCD driver (ported from
  the bench-validated secure `ui-lcd` driver). Drops every secure-world dep
  (`embedded-graphics`, `secure_log!`, `hw::mmio::Reg32`); 16 MHz-calibrated
  `delay_ms`, SWRESET (RES tied to 3V3). The SSD1306 OLED driver was removed
  2026-06-30 — only the NV3007 LCD ships.
- `sphincs_tz_bip39::firmware_fingerprint_lines` — pure layout
  function shared between FSBL and `secure/src/measured_boot.rs`.

## Test coverage

- `bip39/tests/prefix5_roundtrip.rs` — prefix table integrity, layout
  pinning, fingerprint_lines correctness for known digests.
- `fsbl-tests/tests/footprint.rs` — legacy 32-KiB bench-link regression; it is
  not Draft 1.1 FLASH/RAM approval.
- `fsbl-tests/tests/source_invariants.rs` — `verify_images` returns
  digest, FSBL renders before branch, NV3007 hardware-validated constants,
  `measured_boot` survives.
- `fwmeasure/tests/byte_identity.rs` — host `fwmeasure` output matches
  `firmware_fingerprint_lines` for the same digest.
- `fsbl-tests/tests/qemu_integration.rs` — `#[ignore]`d empirical
  proofs; see module docs for the QEMU harness work needed to
  un-ignore them.
