DankGecko/pq1/contracts/verification/docs/OPEN_PROOF_OBLIGATIONS.md

# Open Proof Obligations — Proving Assets Cannot Be Stolen from `PQSmartWallet`

> **Historical-plan notice — 2026-07-15.** This is the May closeout plan, not
> the authoritative current obligation inventory. The Lean reference signer is
> now implemented in the model (`Signer.sign`, `findCount_post`, component
> roundtrips, and `honest_consistent`); the open obligation is production
> Rust/firmware signer and serialization→model refinement. The authorization
> digest is `PQSmartWallet.sphincsDigest(userOp)`, not EntryPoint's canonical
> keccak `userOpHash`; the deployed wallet ignores the supplied canonical hash.
> Current status is routed through [`FV_SURFACE_MAP.md`](FV_SURFACE_MAP.md),
> [`FV_VALUE_AND_GAPS.md`](FV_VALUE_AND_GAPS.md), and the
> [2026-07-15 findings](../../../docs/security/adversarial-review/findings/fv-full-stack-2026-07-15-coordinator.md).

This document records the **historical remaining work** proposed to take the SphincsCVerify
project from its current state to a kernel-checked formal-verification result
for the single goal:

> **Theft-freedom.** No adversary — without knowledge of the firmware-resident
> SPHINCS+C10 secret keys — can cause value held by a deployed `PQSmartWallet`
> proxy to be transferred to an address they control.

Everything in this project exists to discharge that one statement.

## Trusted assumptions

The proof rests on these axioms. Anything outside them is in scope and must
be discharged in the single phase below.

| # | Assumption | Where |
|---|---|---|
| A1 | The SHA-256 EVM precompile at `0x02` implements FIPS 180-4. | `Bridge/Refinement.lean::precompile_0x02_is_FIPS_180_4` |
| A2 | EntryPoint v0.6 is unhackable: it only calls `wallet.validateUserOp` with well-formed UserOps, only proceeds to execution if `validateUserOp` returned success, and does not itself move wallet value. | `Bridge/EntryPoint.lean::entrypoint_honest` |
| A3 | `solc 0.8.28` compiles `PQSmartWallet`, `PQMultiOwnable`, `PQSmartWalletFactory`, and `SPHINCsC10Asm` to EVM bytecode that faithfully implements their Yul/Solidity-source semantics. | `Bridge/Refinement.lean::solidityVerifier_compiles_correctly` (generalised) |
| A4 | EVM bytecode executes per the EVM specification. | `Bridge/Refinement.lean::evm_bytecode_executes_correctly` |
| A5 | SPHINCS+C10 is EUF-CMA secure (composed bound from SHA-256 SM-DT-TCR + ITSR + random-oracle modelling of `H_msg`). | `Crypto/EUFCMA.lean::EUF_CMA_SPHINCSplusC` plus the three SHA-256 axioms in `Crypto/Assumptions.lean` |
| A6 | The Lean 4 kernel checks proofs correctly. | Universal. |

> **Deferred by decision — stylistic, NOT owed (2026-06-29).** A2's in-Lean
> `entrypoint_honest` is a *tautology over the `handleOp` model* (its conclusion
> follows from `handleOp`'s definition); it is an `axiom` only to surface A2 in
> `theft_free`'s `#print axioms` closure. It *could* be restated as an opaque
> non-consumed marker (like A4's `evmDeliversCall`) so the closure **names** the
> deployed-EntryPoint + prefund assumption instead of showing a provable tautology.
> This is **deliberately not done**: the gain is marginal — the tautology is
> already disclosed (`TRUST_ASSUMPTIONS.md` A2, `ASSURANCE_CASE.md` §4, the axiom
> docstring), and `make verify-proof-mutation` (A2-load-bearing) +
> `verify-ledger-consistency` now characterize A2 mechanically — while the cost is a
> change to `theft_free`'s **pinned** closure (re-pin `verify-ledger-consistency`
> `signature_pins` + `lint_fv` c.2 + `dump_axioms` + ~7 docs in lockstep). Revisit
> only if a concrete need arises that this cannot meet a better way.

The hardware-wallet firmware, side-channel resistance, MEV/bundler griefing,
gas/DoS bounds, and frontend key management are out of scope.

---

## The single phase

Everything is one phase. It contains every theorem that has to close for the
top-level theft-freedom statement to type-check.

The phase is organised by source-file area only because work-items in
different files are independent and can be parallelised. There is no internal
ordering: any work-item that doesn't reference a `sorry` from another can be
attacked first. Total: **~6–9 person-months** for one engineer.

### Group V — Verifier and signer correspondence (current correction)

The committed Lean model now contains the reference signer, `findCount_post`,
component roundtrip lemmas, `honest_consistent`, a concrete deserialiser, the
kernel-computable SHA-256 model, and the model-side verifier refinement. Those
historical subgoals are closed in the model.

The remaining load-bearing work is different:

* prove current production Rust/firmware signing and serialization refines the
  Lean signer/model rather than relying only on KAT/corpus agreement;
* prove the parsed handler path passes exactly
  `compute_sphincs_digest_v06` to signing and connect it to the contract's
  `sphincsDigest`;
* make all mirrored-source extraction freshness fail closed; and
* retain deployed source/bytecode→committed Lean execution-model identity as a
  separate, explicit boundary.

Output (target): current-source, exact-artifact correspondence for the signer,
serialization, signed digest, and verifier layers. Do not reopen the completed
model signer or describe it as a stub.
### Group W — Wallet invariants

The wallet logic must route every successful UserOp through the verifier
and must not allow counter-bypass or owner-table manipulation that would
let unauthorized signers control the wallet.

Lean files live under `SphincsCVerify/Wallet/` (currently legacy, but
back **in scope** under this revised plan). Discharge:
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
