DankGecko/pq1/contracts/verification/docs/THREAT_CLAIM_MAP.md

# Threat → claim map (the G3 coverage-completeness artifact)

**Snapshot date: 2026-07-02; status overrides reviewed 2026-07-15.** This is the *bottom-up, threat-indexed dual* of [`ASSURANCE_CASE.md`](ASSURANCE_CASE.md)'s top-down claim tree. The assurance case starts from what is **proven** and decomposes it; this map starts from what could **go wrong** (every threat / invariant-violation / adversarial-review attack-class) and asks *does any claim cover it?* — so an **unclaimed threat becomes a visible red row instead of a silent absence** (the G3 gap the FV adversarial-review playbook names, `docs/verification/fv-adversarial-review-playbook.md` line ~189).

> **Controlling 2026-07-15 overrides pending a generated table refresh:**
> `S-FW-PREIMAGE-EXPAND` is **PARTIAL—legacy V1 only**, not current coverage;
> G10 contributes no current rollback/unsigned-image state theorem. EasyCrypt
> contributes partial research evidence to `S-SPHINCS-BREAK` but leaves A5
> cited-TCB. Current extraction proves committed generated artifacts, not
> current-Rust freshness. Current Kani census is 148 harnesses/25 files; 140
> harnesses/19 files lie in mutation-enrolled files, leaving eight/six outside,
> and three of 31 mutation groups are full-only. See the
> [coordinator report](../../../docs/security/adversarial-review/findings/fv-full-stack-2026-07-15-coordinator.md)
> and current [`FV_SURFACE_MAP.md`](FV_SURFACE_MAP.md). Until the table is
> regenerated, these overrides take precedence over conflicting rows/counts.

It closes the coverage-completeness blind spot: per-theorem gates can only tell you a claim is *hollow*; they cannot tell you a threat has **no claim at all**, because there is no theorem to turn red. This map is that missing view.

> **Not a source of truth for what is *claimable*** — that is [`THE_CLAIM.md`](THE_CLAIM.md). This is a coverage index; every COVERED/PARTIAL row routes to the artifact that owns the proof. Where it could drift from `ASSURANCE_CASE.md` / `THE_CLAIM.md`, defer to those.

## How this was built (and its own honesty discipline)

A background workflow enumerated the threat surface from four independent readers (`docs/security/threat-model.md` as the SSOT + the 9 CLAUDE.md invariants + ship-blockers + the 9 `docs/security/adversarial-review/` family playbooks → **62 threats + 85 attack-classes**), the claim/coverage inventory (**62 claims** across Lean / Halmos-Kontrol / Kani / protocol models / silicon-E2E / host-render / gates), and the review-round inventory (**24 rounds**, see [`REVIEW_PROVENANCE.md`](REVIEW_PROVENANCE.md)). These were reconciled into **61 surfaces**.

The failure modes are **asymmetric**: a wrongly-**COVERED** row is *false assurance* (the exact thing this doc exists to kill); a wrongly-**UNCLAIMED** row is merely conservative. So **every** COVERED/PARTIAL mapping was adversarially cite-verified — an independent agent resolved the cited `file:line` / theorem / make-target and downgraded any citation that did not genuinely cover *that* threat. The verification caught **8 mis-citations** (folded in below as downgrades/re-anchors) and, on finalize, one wrongly-**UNCLAIMED** row (`S-NS-TOCTOU`, which *is* Kani-covered). When a citation could not be firmly resolved the row was left PARTIAL/UNCLAIMED, never COVERED.
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
