DankGecko/pq1/contracts/verification/docs/FV_VALUE_AND_GAPS.md

# What the formal-verification stack has actually bought us (empirical calibration)

**Snapshot date: 2026-07-01** (re-surveyed from the original 2026-06-29 to fold
in the *executed* firmware bounded-verification track — the actionable highest-
ROI gap-closer this file flagged has since landed; see the **UPDATE 2026-07-01**
notes below). Counts below are a claim about the *surveyed git history up to this
date*, not a timeless statement about FV's capability. A future defect or
soundness catch should update this file, not silently falsify a sentence in it.
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
