DankGecko/pq1/docs/production-todo.md

# PQSigner OS — Production TODO — **RETIRED 2026-07-19**

**The factory/production irreversible-action checklist has moved to GitHub
Issues.** Every unperformed gate, ceremony step, and open checkbox from this
file was migrated on 2026-07-19; this file is no longer maintained.

- Production/factory items: [`label:source:production-todo`](https://github.com/EthereumPhone/PQ1/issues?q=label%3Asource%3Aproduction-todo)
- Ship blockers (incl. the OPTIGA S-1/S-2 and hardening-restore gates): [`label:ship-blocker`](https://github.com/EthereumPhone/PQ1/issues?q=label%3Aship-blocker)

The complete pre-migration content — the irreversible gates by subsystem
(OPTIGA LcsO transitions, STM32U585 OTP/option-byte commits, SE050 SCP03/ADMIN
provisioning), the datasheet cross-references, and the historical validation
snapshot — is preserved at
[`docs/archive/production-todo-retired-2026-07-19.md`](archive/production-todo-retired-2026-07-19.md)
and in git history.

**Authority note (unchanged):** migration to the tracker changes *where* these
items are tracked, not *what authorizes* them. Irreversible OPTIGA/STM32/SE050
actions still require the explicit owner authorization and silicon evidence
each issue records; no issue, label, or checklist state grants production
authority by itself.
