DankGecko/pq1/docs/work-todo.md

# PQSigner OS — Work TODO — **RETIRED 2026-07-19**

**Action tracking has moved to GitHub Issues.** Every open item from this file
was migrated on 2026-07-19; this file is no longer maintained and must not
accrue new entries.

- Open work items: [`label:source:work-todo`](https://github.com/EthereumPhone/PQ1/issues?q=label%3Asource%3Awork-todo)
- Production/factory items: [`label:source:production-todo`](https://github.com/EthereumPhone/PQ1/issues?q=label%3Asource%3Aproduction-todo)
- Ship blockers: [`label:ship-blocker`](https://github.com/EthereumPhone/PQ1/issues?q=label%3Aship-blocker)
- Labels: `priority:critical|high|medium|low`, `surface:<subsystem>`

The complete pre-migration content (including the full Completion Log) is
preserved at [`docs/archive/work-todo-retired-2026-07-19.md`](archive/work-todo-retired-2026-07-19.md)
and in git history. Historical references to `work-todo` items elsewhere in
the docs resolve through that archive.

**Working with the tracker:** file new work as issues with the label scheme
above; close items with the evidence in the close comment. `docs/STATUS.md`
remains the security-frontier router; the dated "what got done" record is the
tracker's closed-issue history plus the archived Completion Log.
