DankGecko/pq1/docs/hardware/schematics/AL_A66_MB_V10_20260714_1500.pdf

I2C address:SE050 (0X48) | I2C address:SLS32A (0X30)
MCU STM32 | SE IC

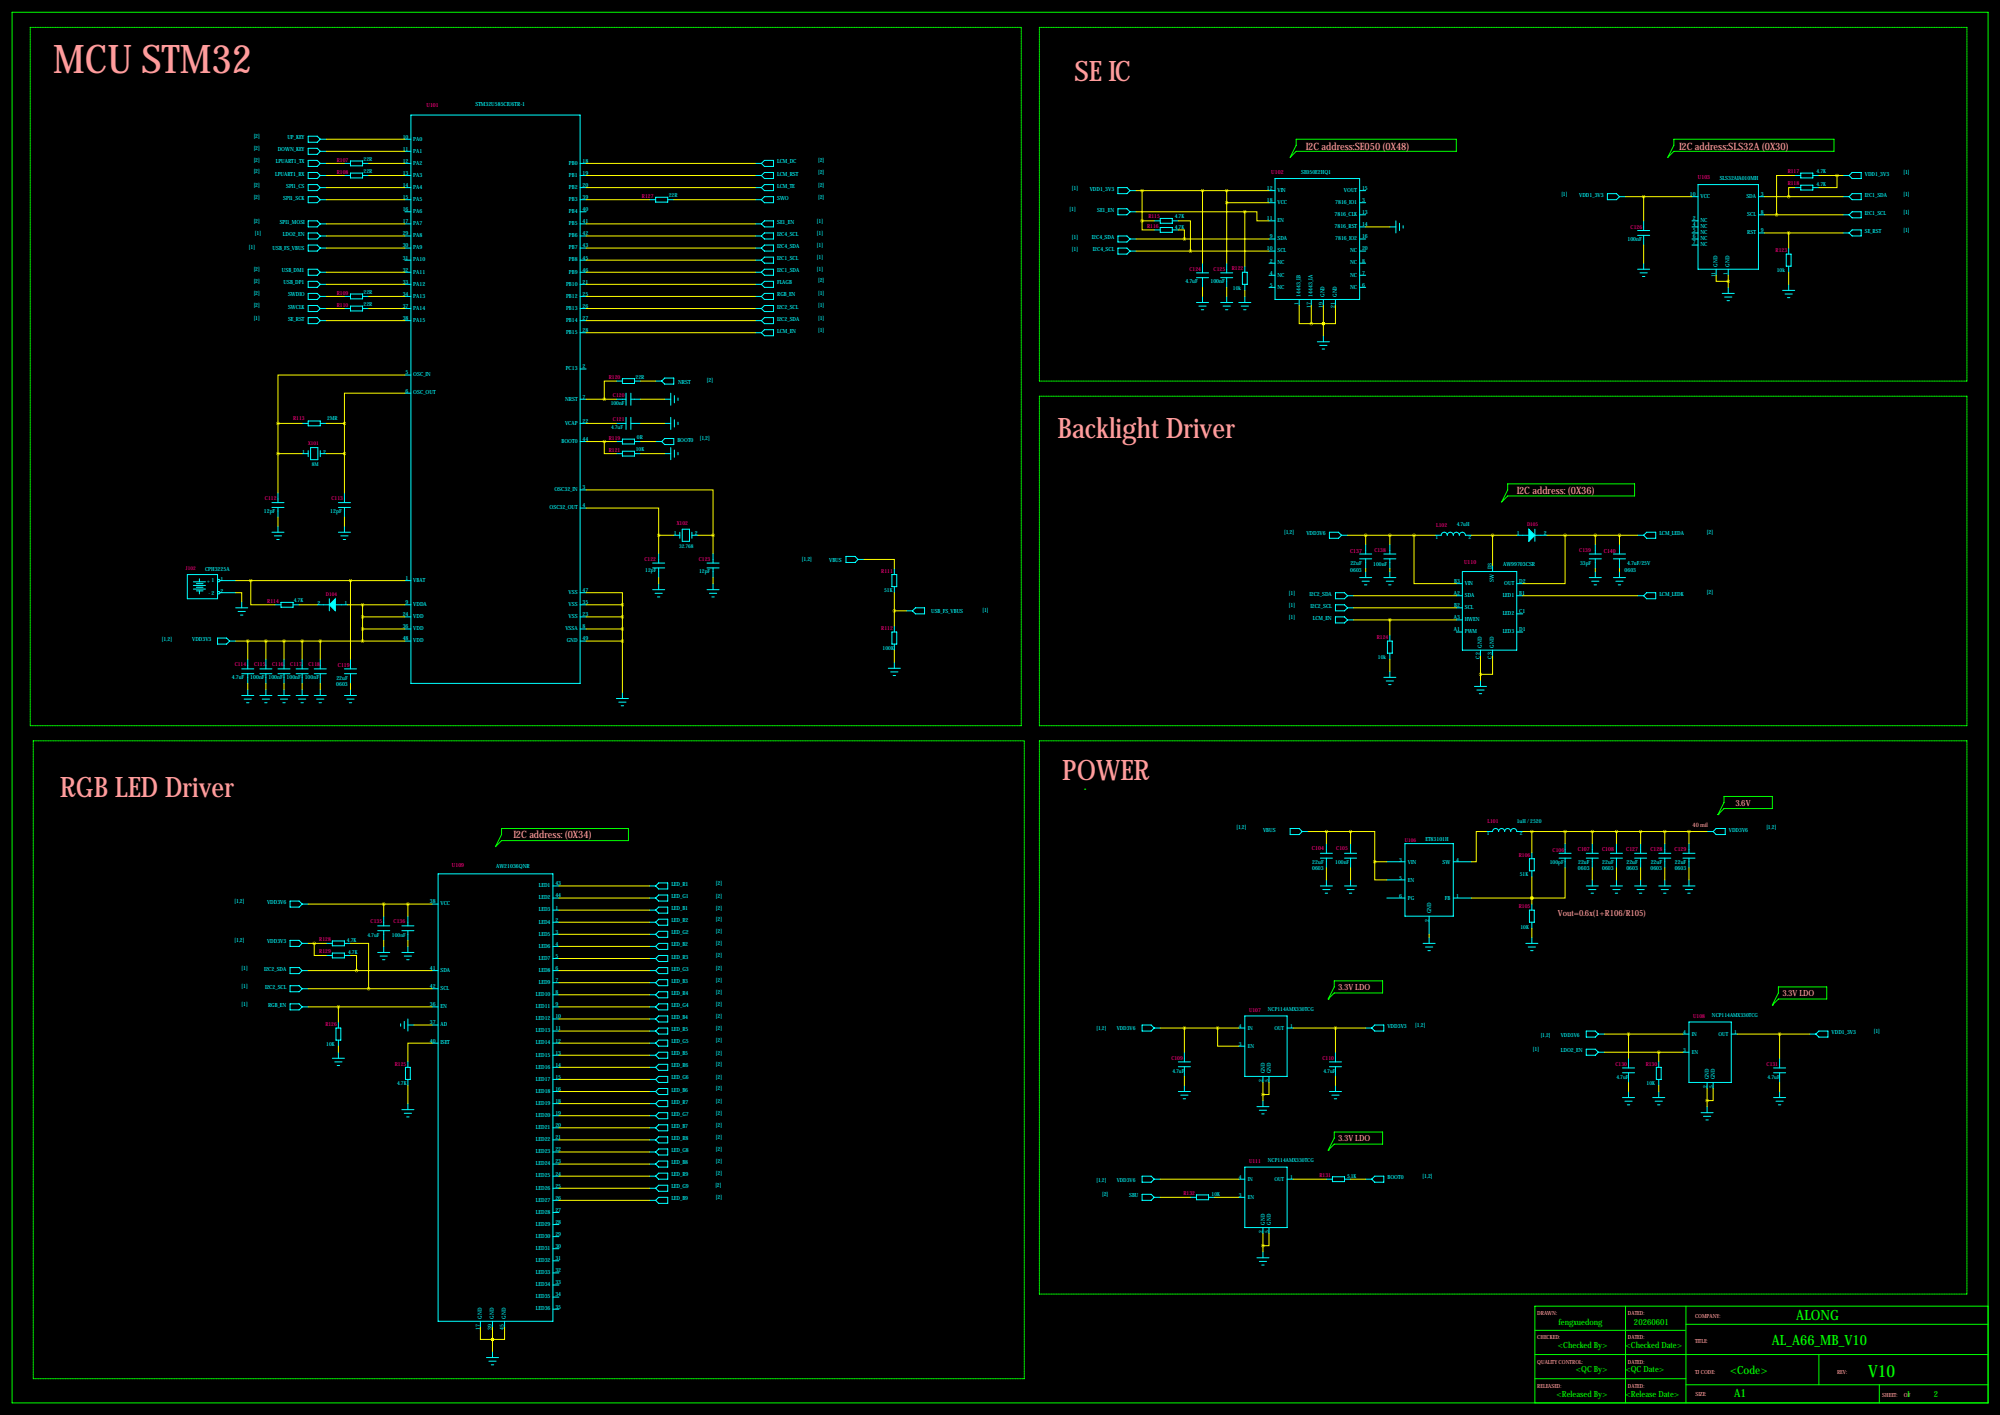
[picture p2: page 1]

CHECKED: <Checked By> | DATED: <Checked Date>
QUALITY CONTROL: <QC By> | DATED: <QC Date> | <Code> TJ CODE: | V10 REV:

RELEASED: <Released By> | DATED: <Release Date>

A1 SIZE: | 1 2 SHEET: OF

# LCM+RGB Connector

# TYPE-C Connector

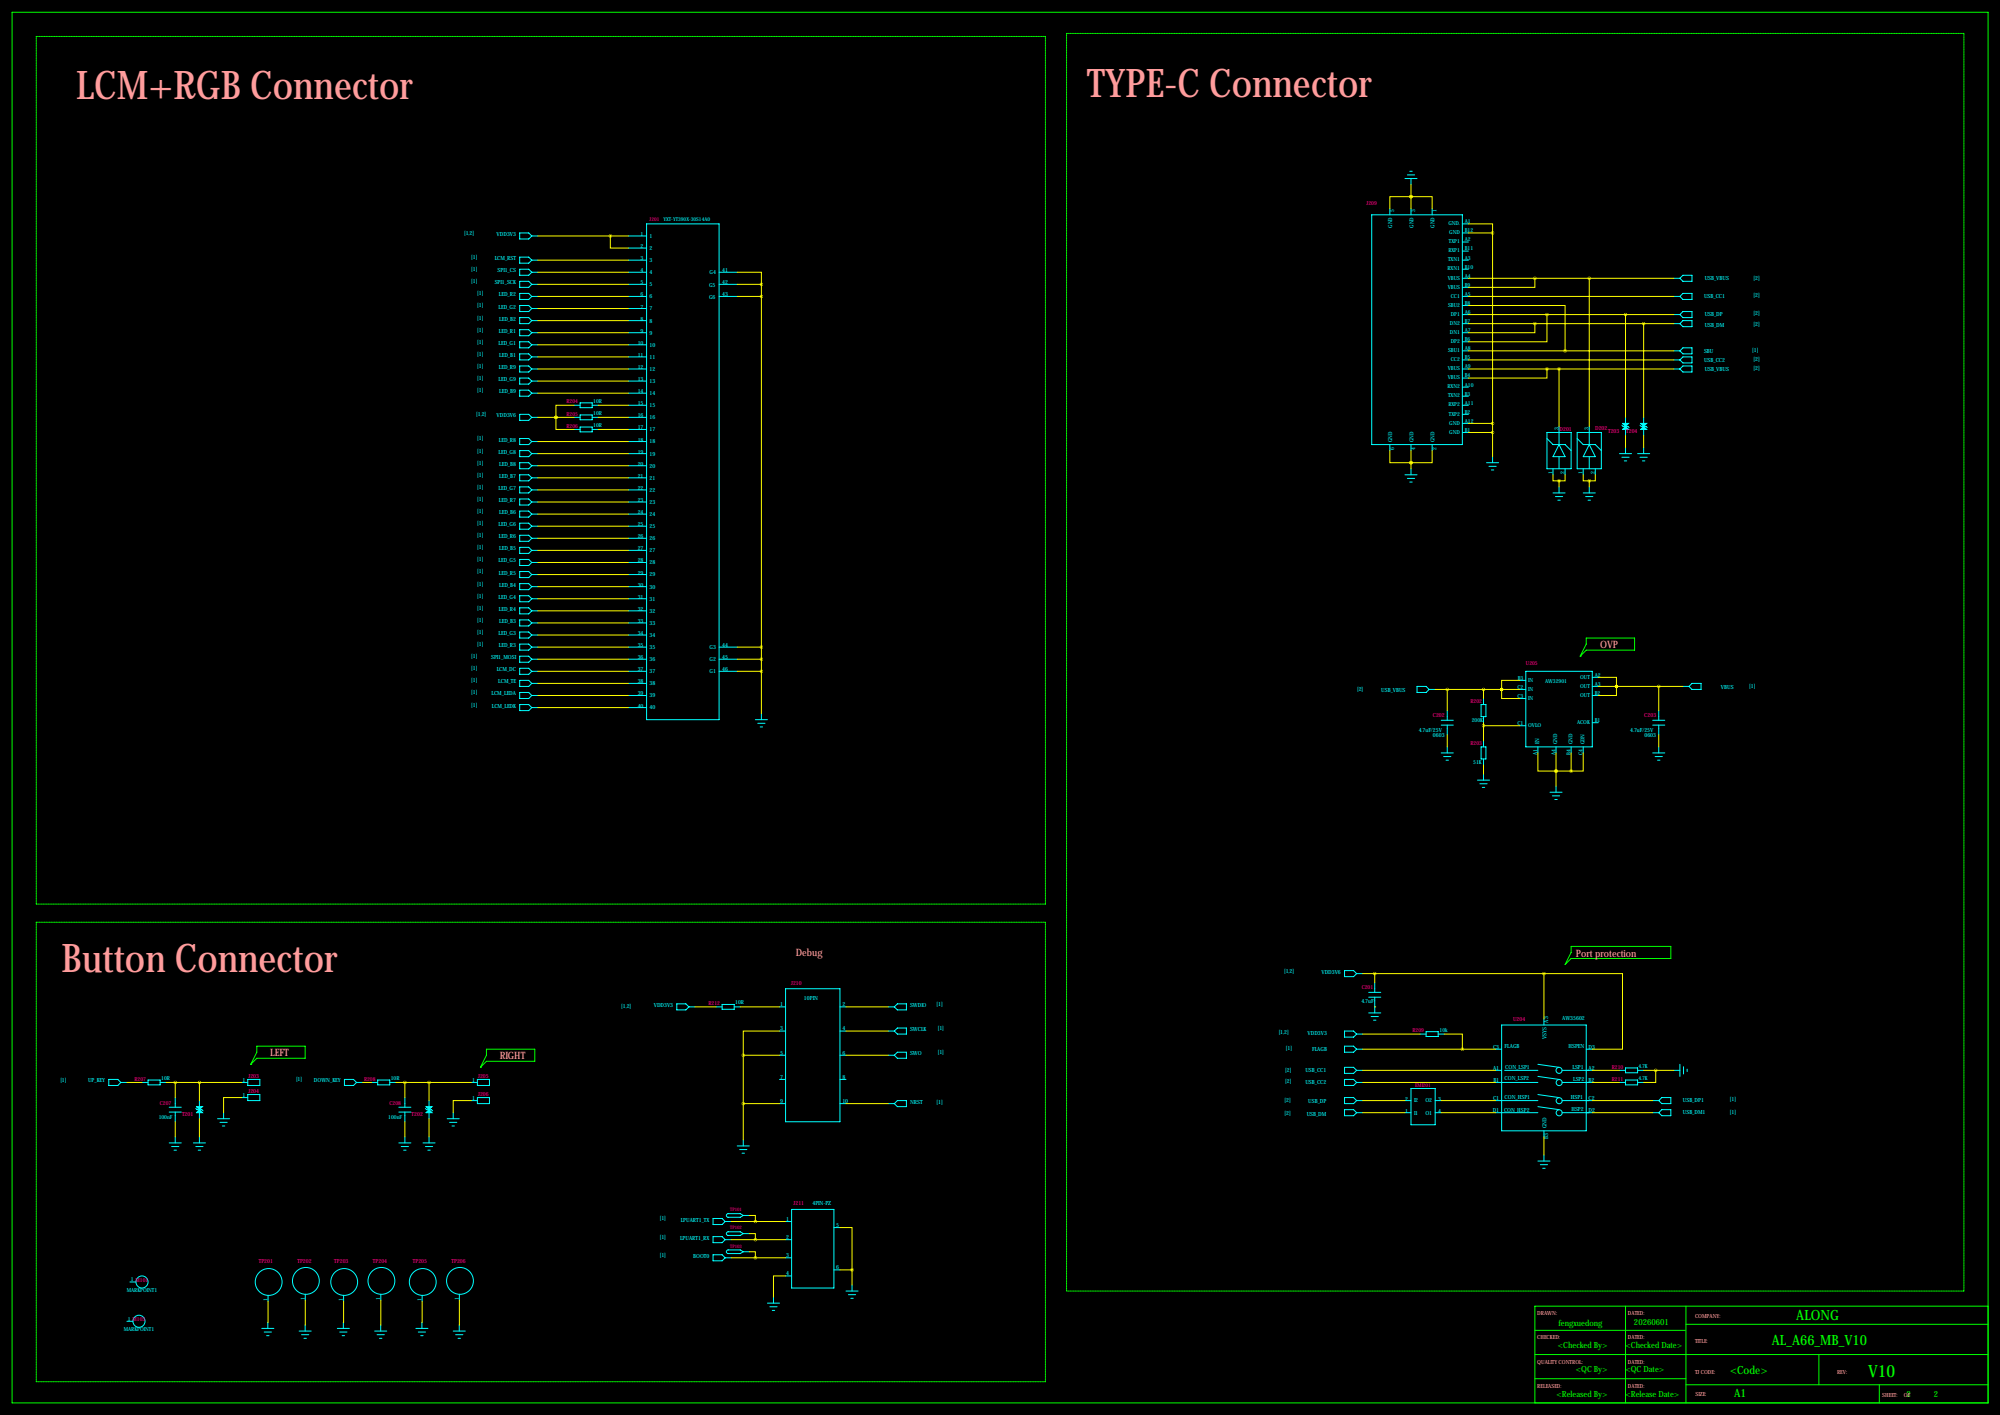
[picture p3: page 2]

CHECKED: <Checked By> | DATED: <Checked Date>

QUALITY CONTROL: <QC By> | DATED: <QC Date> | <Code> TJ CODE: | V10 REV:

RELEASED: <Released By> | DATED: <Release Date>

A1 SIZE: | 2 2 SHEET: OF
