DankGecko/pq1/docs/hardware/pcb/AL_A66_MB_V10_20260715_1100-L5.pdf

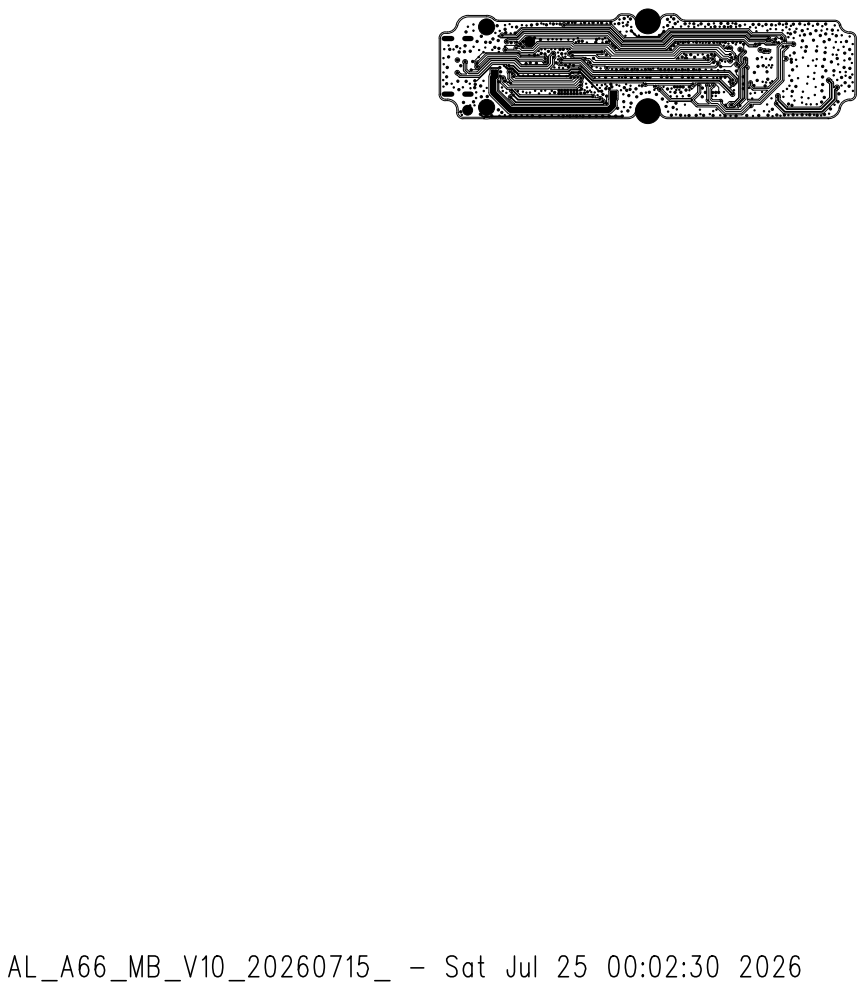
[picture p4: page 1]
