DankGecko/pq1/docs/hardware/pcb/AL_A66_MB_V10_20260715_1100-TOP.pdf

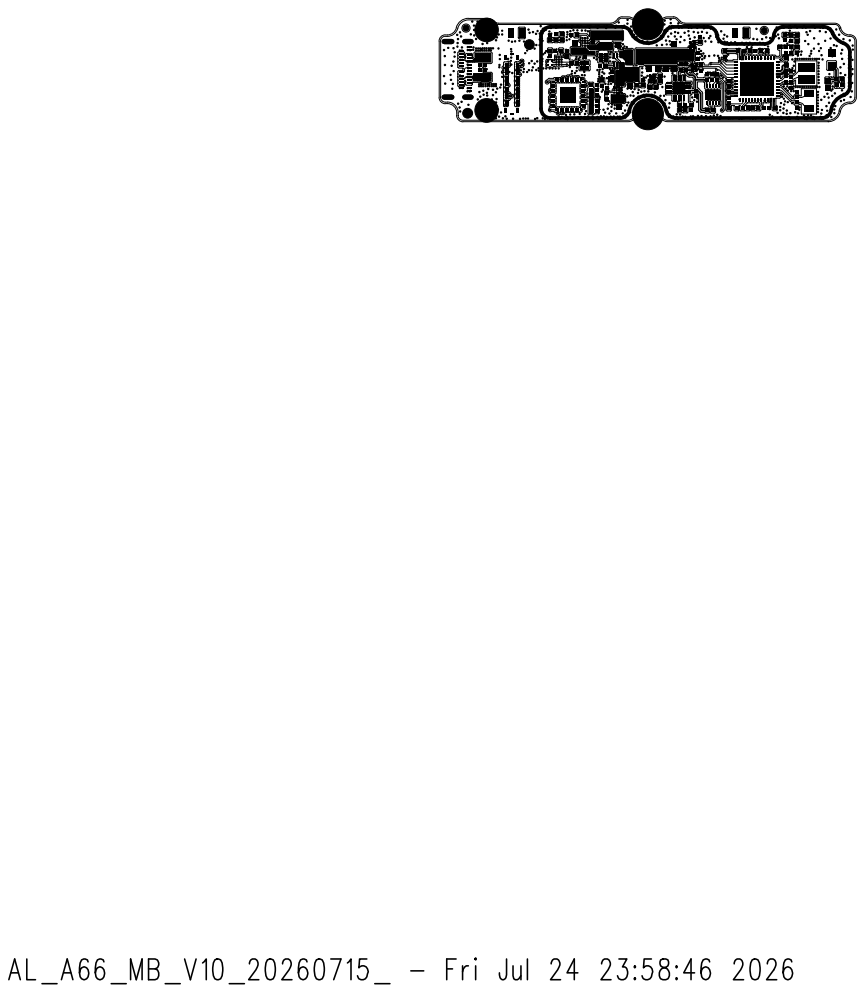
[picture p5: page 1]
