DankGecko/pq1/secure/src/main.rs

// In test mode (#[cfg(test)]), the test harness provides std and main.
// The ARM-specific crate attributes are disabled so pure-logic modules
// (aa, tx) can be unit-tested on the host with `cargo test --lib`.
#![cfg_attr(not(test), no_std)]
#![cfg_attr(not(test), no_main)]
#![cfg_attr(not(test), feature(cmse_nonsecure_entry))]
// The `splash-test` bench build runs heavy per-frame f32 math; let it carry
// `#[optimize(speed)]` on the splash hot path so those functions beat the
// crate's `opt-level = "s"`. Gated on the feature so no other build enables it.
#![cfg_attr(feature = "splash-test", feature(optimize_attribute))]
// The `e2e-test` build intentionally bypasses the interactive UI paths
// (wizard, pin entry confirm, interactive main()). Silence the resulting
// dead-code noise ONLY in that build so production builds still surface
// genuinely unused symbols.
#![cfg_attr(feature = "e2e-test", allow(dead_code))]

/// Conditional debug logging macro. Compiles to no-op without the `debug-log` feature
/// and in host-side test builds (where cortex-m-semihosting is unavailable),
/// ensuring no semihosting output in production builds.
///
/// When `debug-log` IS enabled, the macro checks the DHCSR.C_DEBUGEN bit at
/// runtime before issuing the semihosting BKPT. This makes `debug-log` builds
/// safe to run **without** a debugger attached — the output is silently skipped
/// instead of HardFaulting.
#[cfg(all(feature = "debug-log", not(test)))]
macro_rules! secure_log {
    ($($arg:tt)*) => {
        // On real STM32U585: check DHCSR.C_DEBUGEN before semihosting BKPT.
        // Without a debugger, BKPT would HardFault — this makes debug-log
        // builds safe to run standalone (USB-only, no probe attached).
        //
        // On QEMU: semihosting works via BKPT interception regardless of
        // DHCSR, so always emit.
        #[cfg(feature = "stm32u585")]
        {
            if $crate::ARCH.dhcsr.read() & 1 != 0 {
                cortex_m_semihosting::hprintln!($($arg)*);
            }
        }
        #[cfg(not(feature = "stm32u585"))]
        {
            // Resilient writer (see `crate::shio`): QEMU's chardev can
            // wedge under `make e2e`'s `</dev/null`, and the upstream
            // `hprintln!` busy-spins forever on the resulting 0-byte
            // SYS_WRITE. `shio::println` drops instead of hanging.
            $crate::shio::println(format_args!($($arg)*));
        }
    };
}
#[cfg(any(not(feature = "debug-log"), test))]
macro_rules! secure_log {
    ($($arg:tt)*) => {};
}

// Pure-logic modules: no hardware dependencies, testable on the host.
mod aa;
mod tx;
// Generic CMAC-AES core (RFC 4493). Always compiled — the firmware
// pulls it in via the SAES-DHUK backend in `hw::saes_cmac`, and host
// tests exercise the same function against the NIST SP 800-38B
// AES-256 vectors. No hardware deps.
mod cmac;
// Pure-logic SE050 SCP03 primitives (AES-128 ECB/CBC, CMAC-AES-128, the
// GP `PUT KEY` APDU builder, KCV, OEF-`0xA201` (SE050C2) factory key constants).
// Always compiled — `se050::scp03` (which is `feature="se050"` /
// `not(test)`-gated) imports from here, and the host test build runs the
// NIST FIPS 197 / SP 800-38B vectors + the GP layout assertions.
mod scp03_logic;
// ISO 7816-4 BER-TLV decoder + UPCTR PIN-counter parser. Pure
// functions, no hardware deps — always-on so the fuzz_props proptest
// harness can hammer them on host. The hardware-gated `se050::apdu`
// and `optiga::apdu` modules import these for the production path.
mod iso7816;
// First-boot self-provisioning (work-todo #36). The `journal` + `state`
// children are pure logic (page-127 codec + resumable state machine) and are
// always compiled so `cargo test -p sphincs-tz-secure` exercises them; the
// hardware glue inside `first_boot::mod` is `stm32u585` + `rdp2-self-lock`
// gated. Absent from every current dev/QEMU/bench build's behaviour (the
// entry points are only *called* from `main` under the feature).
mod first_boot;
// Pure, host-tested ownership policy for generic secure-bank flash writes and
// erases. The STM32 driver consumes its validated address/page capabilities;
// page 127 remains exclusively owned by the first-boot journal.
mod flash_policy;

// Pure classification of the device-master-key OTP region (Virgin / Partial /
// Complete, per quad-word). Free of MMIO so the D4 rule — an interrupted
// two-quad-word burn must never read as "burned" — is executable on the host;
// `hw::otp` does the volatile reads and consumes the verdict.
mod otp_state;

// Pure decode of DBGMCU_IDCODE (which die is this?). Free of MMIO so the
// SESIP-scope rule — REV_ID 0x3003 "rev U" is the ONLY revision
// SESIP-2400133-01 covers — is executable on the host; `hw::dbgmcu` does the
// single register read. See work-todo A4a / HW-ASSUME-REV-U.
mod die_id;

// Hardware-dependent modules: gated out in test builds so `cargo test`
// compiles only the pure logic on x86_64.
#[cfg(not(test))]
mod boot_ns;
mod crypto;
mod fi;
mod fih;
// Resilient semihosting host-stdout writer (QEMU/dev only). Replaces the
// busy-spinning `cortex_m_semihosting` write path that hangs `make e2e`.
#[cfg(not(test))]
mod shio;
mod sign_rate;
#[cfg(test)]
mod fuzz_props;
// Pure-logic modules: no hardware deps. Available under `cargo test`
// so the proptest harnesses in `fuzz_props` can exercise them on the
// host.
mod db_roots;
mod erc20;
mod names;
mod selectors;
#[cfg(all(not(feature = "stm32u585"), not(test)))]
mod host_rng;
// `hw` is compiled for any non-test build so `sau` (used on both QEMU and
// STM32U585) can pull in `hw::mmio`. Each peripheral submodule inside
// `hw` retains its own feature gate, so QEMU still only sees `mmio`.
#[cfg(not(test))]
mod hw;
#[cfg(not(test))]
mod reset_cause;
/// Firmware-update state machine. Built on the STM32U585 hardware path
/// because it uses the bank-2 flash primitives in `hw::flash` that only
/// exist on real silicon. QEMU builds omit the module — the mailbox
/// transport doesn't expose the update commands either.
#[cfg(all(feature = "stm32u585", not(test)))]
mod fw_update;
/// Reversible firmware anti-rollback test (feature `fw-rollback-e2e`). Drives
/// the real `fw_update::verify_manifest` chain with dev-key-signed v1/v2/v3
/// manifests against literal test floors — proves downgrade rejection with no
/// OTP burn / flash / reboot. Runs early in `main()` and halts.
#[cfg(all(feature = "fw-rollback-e2e", feature = "stm32u585", not(test)))]
mod fw_rollback_e2e;
#[cfg(not(test))]
mod offchain_state;
#[cfg(not(test))]
mod nsc;
#[cfg(not(test))]
mod rng;
#[cfg(not(test))]
mod rng_strong;
// Pure word-level health predicates shared by the STM32 driver and host
// tests. The driver adds the MMIO ordering/state-machine checks.
mod rng_health;
// Exact-response helper for hardware RNG APDUs; kept pure for sentinel tests.
mod rng_exact;
// Pure per-chunk SE-entropy fold used by `rng_strong` — kept OUT of
// that `#[cfg(not(test))]` module so its logic (including the F27
// fresh-block-per-chunk discipline) is compiled and exercised by the
// host test suite.
mod rng_strong_fold;
mod pin;
#[cfg(all(feature = "stm32u585", feature = "optiga-trust-m", not(test)))]
mod pin_diag;
#[cfg(not(test))]
mod sau;
mod secure_element;
#[cfg(all(feature = "se050", not(test)))]
mod se050;
// SE050 stress-test harness. Only present when the `se050-stress`
// feature is on; otherwise compiles to absolutely nothing.
#[cfg(all(feature = "se050-stress", not(test)))]
mod se050_stress;
// SE050 stress requires real silicon — the whole point is to challenge
// silicon-side assumptions. `mock-se` would silently turn the run into
// a no-op tour of the in-RAM mock and mask any real-chip regression.
#[cfg(all(feature = "se050-stress", feature = "mock-se"))]
compile_error!(
    "`se050-stress` requires real SE050 silicon — drop `mock-se` from the feature set"
);
#[cfg(not(test))]
mod timeout;
#[cfg(all(feature = "optiga-trust-m", not(test)))]
mod optiga;
#[cfg(all(feature = "dual-se", not(test)))]
mod dual_se;
#[cfg(not(test))]
mod measured_boot;
// ML-KEM-1024 hybrid inner-wrap firmware adapter (binds pqsigner-pq-seal to the
// device key hierarchy + the TRNG). Compiled under the self-test feature OR
// when the wrap is wired into the dual-SE provision/reconstruct path.
#[cfg(any(feature = "mlkem-self-test", feature = "mlkem-inner-wrap"))]
mod pq_wrap;
#[cfg(not(test))]
mod ui;

/// Factory provisioning state machine (`factory-provisioning`
/// feature). One-shot ceremony the factory operator flashes and
/// runs once per device — sets up dual-SE infrastructure and halts
/// on success / structured failure. See module docs.
#[cfg(feature = "factory-provisioning")]
mod factory_provisioning;

/// Masked-SHA-256 overhead bench (`bench-masked-sha` feature). Runs
/// once at boot, measures the first-order-masked gate cost vs the HASH
/// peripheral, prints the projected slowdown, halts. See module docs
/// + work-todo §18 (SHAKE-vs-SHA2 #2 measurement).
#[cfg(feature = "bench-masked-sha")]
mod bench_masked_sha;

// ── Test-only re-includes for the `secure-nsc-sign-userop` slice ──
//
// `nsc` itself is `#[cfg(not(test))]` because most of its files pull in
// hardware-only crates. The two helper files (`nsc/sig_wrapper.rs`,
// `nsc/trailer.rs`) are pure logic, so we re-include them at the crate
// root under `cfg(test)` to make them reachable from `cargo test`.
//
// `trailer.rs` calls `crate::ui::show_status(...)`; under test we
// provide a no-op stub so the file compiles without dragging in the
// real OLED stack.
#[cfg(test)]
mod ui {
    pub fn show_status(_title: &str, _sub: &str) {}

    // Mirrors the production constants in `crate::ui` so the
    // `display_under_test` scaffold can re-mount the per-renderer
    // source files under host test builds (see
    // `crate::display_under_test`).
    pub const DISPLAY_COLS: usize = 16;
    pub const DISPLAY_ROWS: usize = 4;

    // The `confirm::Page` alias + panicking `ascii_str` mirror that used to
    // live here went dead when the ERC-7730 renderer moved to
    // `pqsigner_erc7730::display` (which carries the production
    // `unwrap_or("?")` `ascii_str` — see that crate); removed so the
    // divergent-semantics footgun can't be re-imported by a mounted file.
}

#[cfg(test)]
#[path = "ui/secret_text.rs"]
mod ui_secret_text_under_test;

#[cfg(test)]
#[path = "nsc/sig_wrapper.rs"]
mod nsc_sig_wrapper_under_test;

#[cfg(test)]
#[path = "nsc/trailer.rs"]
mod nsc_trailer_under_test;

#[cfg(test)]
#[path = "nsc/batch_trailers.rs"]
mod nsc_batch_trailers_under_test;

#[cfg(test)]
mod nsc_sign_userop_pure_tests;

#[cfg(test)]
mod nsc_batch_offchain_pure_tests;

#[cfg(test)]
mod nsc_small_cmds_pure_tests;

#[cfg(test)]
mod nsc_fw_update_pure_tests;

#[cfg(test)]
mod nsc_erc7730_unattested_pure_tests;

#[cfg(test)]
mod nsc_erc7730_binding_fi_pure_tests;

// ── Host-side test suite for the `secure-fw-update-boot` slice ──
//
// Covers `fw_update/mod.rs` (state-machine types + `verify_manifest`
// + `check_chunk`), `fw_update/staging.rs` (QW-aligned writes),
// `fw_update/verify.rs` (COMMIT-time defence in depth),
// `fw_update/vendor_pubkey.rs`, `measured_boot.rs` (OS Fingerprint),
// and `boot_ns.rs` (S→NS handover). All production files are
// `#[cfg(not(test))]` or `stm32u585`-gated, so the suite is
// dominated by `include_str!` source-text invariants plus
// pure-logic mirrors of decision trees. See
// `reports/tests/secure-fw-update-boot.md` for the inventory.
#[cfg(test)]
mod fw_update_boot_pure_tests;

// ── Host-side test suite for the `secure-main-sau` slice ──
//
// Covers `main.rs` (secure-world entry, SysTick/PendSV/DefaultHandler/
// panic_handler trampolines, ARCH MMIO bindings, reset-cause
// integration), `sau.rs` (SAU regions + GTZC1 MPCBB/TZSC config) and
// `reset_cause.rs` (RCC_CSR classification). All three are
// `#[cfg(not(test))]`-gated at the crate root because of
// hardware-only deps; the suite is dominated by `include_str!` source-
// text invariants plus a pure-logic mirror of `classify_bits`. See
// `reports/tests/secure-main-sau.md` for the inventory.
#[cfg(test)]
mod main_sau_pure_tests;

// ── Host-side test suite for the `secure-fi-pin-rng` slice ──
//
// Covers `fi.rs`, `fih.rs`, `fuzz_props.rs`, `host_rng.rs`,
// `iso7816.rs`, `pin.rs`, `pin_diag.rs`, `rng.rs`, `rng_strong.rs`,
// `sign_rate.rs`, `timeout.rs`. The slice mixes always-on host-
// compileable modules (`fi`, `fih`, `iso7816`, `pin`, `sign_rate`,
// `fuzz_props`) with `#[cfg(not(test))]`-excluded modules (`rng`,
// `rng_strong`, `host_rng`, `pin_diag`, `timeout`). The suite
// exercises the first group directly and pins the second via
// `include_str!` source-text invariants, with a local re-mount of
// `timeout.rs` so its pure logic is exercisable on host. See
// `reports/tests/secure-fi-pin-rng.md` for the inventory.
#[cfg(test)]
mod secure_fi_pin_rng_pure_tests;

// ── Test-only re-includes for the `secure-nsc-core` slice ──
//
// `nsc/ptr_validate.rs`, `nsc/ns_ptr.rs`, and `nsc/state.rs` are
// pure-logic enough to exercise on host, but they live under the
// production `nsc` module which is `#[cfg(not(test))]`. Mount them
// under a per-test scaffold module so the `super::ptr_validate::*`
// imports inside `ns_ptr.rs` continue to resolve, and so the
// `pub(super)` items in `state.rs` are reachable from the sibling
// test file `nsc_core_pure_tests.rs`.
#[cfg(test)]
pub(crate) mod nsc_core_under_test;

// ── Test-only scaffold for the `secure-crypto-glue` slice ──
//
// `crypto.rs`, `dual_se.rs`, and `offchain_state.rs` are
// `#[cfg(not(test))]` because they import hardware-only peers
// (`crate::optiga`, `crate::se050`, `crate::rng_strong`,
// `crate::sign_rate`, …) that cannot link on host. The scaffold
// re-includes `offchain_state.rs` via `#[path]` so its mock SRAM
// backend is reachable, and hosts source-text invariant pins for
// the FI hardening / KDF tags / zeroization sites in `crypto.rs` +
// `dual_se.rs`, alongside runtime tests for the four `db_roots`-
// bound bundle wrappers (`erc20`, `names`, `selectors`) and the
// `aa` re-export shim. The executable inventory lives in
// `secure_crypto_glue_under_test/` beside these sources.
#[cfg(test)]
mod secure_crypto_glue_under_test;

// ── Test-only scaffold for the `secure-hw-crypto` slice ──
//
// The `hw` module is `#[cfg(not(test))]` because most of its files
// import cortex_m / MMIO and cannot link on host. This scaffold hosts
// the host-runnable source-text + reference-algorithm pinning suite
// for the slice's KDF labels, register addresses, FI guards and
// zeroization sites. See the module's docstring + the test file's
// header for what is and isn't covered.
#[cfg(test)]
mod hw_crypto_under_test;

// ── Test-only scaffold for the `secure-hw-platform` slice ──
//
// Same shape as `hw_crypto_under_test`: hosts the host-runnable
// source-text + reference-encoding pinning suite for the platform
// peripheral layer (flash geometry, RCC clock target, RNG/PKA/TAMP
// register layout, dev-only production fences). See the module's
// docstring + the pure_tests.rs header for what is and isn't covered.
#[cfg(test)]
mod hw_platform_under_test;

// ── Test-only scaffold for the `secure-hw-io` slice ──
//
// Same shape as `hw_crypto_under_test` / `hw_platform_under_test`:
// hosts the host-runnable source-text + reference-encoding pinning
// suite for the bus / I/O peripheral layer (I2C1 OLED + SE050,
// I2C2 STSAFE probe, USB OTG FS, USART1 RDP1 diag,
// GPIO buttons). See the module's docstring + the pure_tests.rs
// header for what is and isn't covered.
#[cfg(test)]
mod hw_io_under_test;

// ── Test-only scaffold for the `secure-tx-display` slice ──
//
// The production `tx::display` module is gated `#[cfg(not(test))]` (see
// `secure/src/tx/mod.rs`) because several of its sibling files pull in
// hardware-only code via `crate::ui`. This scaffold re-mounts the
// per-renderer source files under a parallel module tree, alongside a
// hand-supplied `Pages` container that mirrors the production
// `tx::display::Pages` byte-for-byte, so the renderers' page output can
// be unit-tested on the host. See
// `reports/tests/secure-tx-display.md` for the inventory.
#[cfg(test)]
mod display_under_test;

// ── Test-only scaffold for the `secure-optiga` slice ──
//
// The production `optiga` module is `#[cfg(not(test))]` because the
// transceive layer pulls in `cortex_m` for the delay loops and
// `crate::hw::i2c_hw` for the I²C1 MMIO addresses — neither links on
// host. This scaffold path-includes `apdu.rs` and `shield.rs` under
// stub `ifx_i2c` types so the byte-exact wire-format and crypto
// primitives can be exercised against reference vectors, alongside the
// `include_str!`-based source-text pins for the files that genuinely
// cannot be host-compiled (`ifx_i2c.rs`, `i2c.rs`, `mod.rs`). See
// `reports/tests/secure-optiga.md`.
#[cfg(test)]
mod optiga_under_test;

// ── Test-only scaffold for the `secure-se050` slice ──
//
// The production `se050` module is `#[cfg(all(feature = "se050",
// not(test)))]` because `t1oi2c.rs` calls `cortex_m::asm::nop()` (the
// `cortex-m` crate is target-gated to `cfg(target_arch = "arm")` in
// `secure/Cargo.toml` and does not link on x86_64) and `i2c.rs` binds
// `hw::i2c_hw::I2C1` MMIO addresses that don't exist on host. This
// scaffold pins the slice through `include_str!` source-text invariants
// + reference-vector cross-checks of the GP 1.0 CRC-16 and the SCP03
// wrap framing, alongside cross-checks against the always-on
// `scp03_logic` / `iso7816` modules. See `reports/tests/secure-se050.md`.
#[cfg(test)]
mod se050_under_test;

// ── Test-only scaffold for the `secure-ui` slice ──
//
// The production `ui` module is `#[cfg(not(test))]` because every
// file in it depends on hardware-only peers (`cortex_m_semihosting`,
// `embedded_graphics`, `ssd1306`, `rtt-target`, the GPIO button
// driver, `crate::timeout`, `crate::rng_strong`, the
// `static mut DISPLAY` / `static mut INPUT` singletons). The slice
// is pinned host-side through `include_str!` source-text invariants
// plus reference-algorithm checks; see `reports/tests/secure-ui.md`.
#[cfg(test)]
mod ui_under_test;

// Everything below this point is firmware infrastructure — gated out in
// host test builds where only the pure aa/tx logic is exercised.
#[cfg(all(feature = "mock-se", not(test)))]
use secure_element::MockSecureElement;
#[cfg(not(test))]
use secure_element::WalletStore;

#[cfg(all(not(feature = "stm32u585"), not(test)))]
const NS_FLASH_BASE: u32 = 0x0020_0000; // QEMU mps2-an505: NS alias of SSRAM-0
#[cfg(all(feature = "stm32u585", not(test)))]
const NS_FLASH_BASE: u32 = 0x0810_0000; // STM32U585: flash bank 2 NS alias

// ARMv8-M architectural registers used directly from `main.rs`:
//   SysTick (SYST_*), DWT cycle counter, DEMCR, ICSR, DHCSR.
// All bound once below via `hw::mmio::{Reg32, RoReg32}` so the rest of
// the file only sees safe `.read()` / `.write()` calls.
#[cfg(not(test))]
struct ArchRegs {
    syst_csr: hw::mmio::Reg32,
    syst_rvr: hw::mmio::Reg32,
    syst_cvr: hw::mmio::Reg32,
    icsr: hw::mmio::Reg32,
    demcr: hw::mmio::Reg32,
    dwt_lar: hw::mmio::Reg32,
    dwt_ctrl: hw::mmio::Reg32,
    dwt_cyccnt: hw::mmio::Reg32,
    /// DHCSR.C_DEBUGEN — read-only from our point of view; we never write
    /// it (writes require an unlock key the firmware doesn't possess).
    dhcsr: hw::mmio::RoReg32,
}

// SAFETY: each address is a real, 4-byte-aligned ARMv8-M architectural
// register exclusively touched from the secure-world boot path / handlers
// below. Non-preemptive single-threaded secure world — nothing races.
#[cfg(not(test))]
const ARCH: ArchRegs = unsafe {
    ArchRegs {
        syst_csr: hw::mmio::Reg32::new(0xE000_E010),
        syst_rvr: hw::mmio::Reg32::new(0xE000_E014),
        syst_cvr: hw::mmio::Reg32::new(0xE000_E018),
        icsr: hw::mmio::Reg32::new(0xE000_ED04),
        demcr: hw::mmio::Reg32::new(0xE000_EDFC),
        dwt_lar: hw::mmio::Reg32::new(0xE000_1FB0),
        dwt_ctrl: hw::mmio::Reg32::new(0xE000_1000),
        dwt_cyccnt: hw::mmio::Reg32::new(0xE000_1004),
        dhcsr: hw::mmio::RoReg32::new(0xE000_EDF0),
    }
};

// Global mock SE (used when mock-se feature is active, no real SE)
#[cfg(all(feature = "mock-se", not(feature = "se050"), not(feature = "optiga-trust-m"), not(test)))]
static mut SE: MockSecureElement = MockSecureElement::new();

// Global SE050 SE (standalone, without dual-se)
#[cfg(all(feature = "se050", not(feature = "dual-se"), not(test)))]
static mut SE: se050::Se050 = se050::Se050::new();

// Global OPTIGA Trust M SE (standalone, without dual-se)
#[cfg(all(feature = "optiga-trust-m", not(feature = "dual-se"), not(test)))]
static mut SE: optiga::OptigaTrustM = optiga::OptigaTrustM::new();

// Global dual-SE (OPTIGA Trust M + SE050 with XOR entropy split)
#[cfg(all(feature = "dual-se", not(test)))]
static mut SE: dual_se::DualSecureElement = dual_se::DualSecureElement::new();

/// Strong-RNG OPTIGA accessor. This is deliberately source-specific: the
/// mixer records OPTIGA and SE050 independently instead of trusting a single
/// already-XORed SE result.
///
/// SAFETY: must be called only after the SE has been initialised —
/// i.e. from a code path that runs after `init`/`unlock`. The sign
/// path (the only consumer) is gated on `pin_verified`, which only
/// becomes true after a successful unlock that has touched the SE.
#[cfg(not(test))]
pub unsafe fn se_random_optiga(
    buf: &mut [u8],
) -> Result<(), crate::secure_element::SeError> {
    use crate::secure_element::WalletStore;
    let se = &mut *core::ptr::addr_of_mut!(SE);
    // Fully-qualified to dispatch through the WalletStore trait
    // (the standalone Se050/OptigaTrustM types have inherent
    // `random` methods returning their backend-specific error
    // type; the trait method returns `Result<_, SeError>`).
    <_ as WalletStore>::random_optiga(se, buf)
}

/// Strong-RNG SE050 accessor; see [`se_random_optiga`].
#[cfg(not(test))]
pub unsafe fn se_random_se050(
    buf: &mut [u8],
) -> Result<(), crate::secure_element::SeError> {
    use crate::secure_element::WalletStore;
    let se = &mut *core::ptr::addr_of_mut!(SE);
    <_ as WalletStore>::random_se050(se, buf)
}

/// ML-KEM inner-wrap self-test — runs under `mlkem-self-test` only. Round-trips
/// a dummy half through the HUK-derived ML-KEM keypair + the TRNG via
/// `pq_wrap::self_test` (which also checks cross-half AAD rejection), logs
/// PASS/FAIL, exits cleanly via `SYS_EXIT` so `probe-rs`/QEMU returns. Never
/// returns. This is the call that pulls ml-kem into the image (flash-delta
/// measurement) and validates the HUK-secret binding before piece 2b wires the
/// wrap into provision/reconstruct.
#[cfg(feature = "mlkem-self-test")]
fn mlkem_self_test_and_halt() -> ! {
    secure_log!("[S][mlkem] inner-wrap self-test ...");
    if pq_wrap::self_test() {
        secure_log!("[S][mlkem] self-test PASS");
        cortex_m_semihosting::debug::exit(cortex_m_semihosting::debug::EXIT_SUCCESS);
    } else {
        secure_log!("[S][mlkem] self-test FAIL");
        cortex_m_semihosting::debug::exit(cortex_m_semihosting::debug::EXIT_FAILURE);
    }
    loop {
        cortex_m::asm::wfe();
    }
}

/// SAES Tier-1 bring-up self-test — runs under `saes-self-test` only.
/// Initialises the SAES peripheral, executes the in-driver self-tests
/// (software-key round-trip + DHUK vs SW domain separation + DHUK
/// round-trip), logs PASS/FAIL and a short DHUK fingerprint, then exits
/// cleanly via `SYS_EXIT` so `probe-rs run` returns. Never returns.
#[cfg(feature = "saes-self-test")]
fn saes_self_test_and_halt() -> ! {
    // Stage 6: entered self-test entry; uart::init has not run yet.
    #[cfg(feature = "boot-pulse")]
    unsafe { hw::boot_pulse::pulse(6); }
    // RDP1 boot diagnostic — bring the OLED up the moment we enter the
    // self-test so even at RDP ≥ 1 (UART silent, SWD halt denied) the
    // screen retains a visible state of how far the firmware got.
    #[cfg(feature = "ui-lcd")]
    {
        ui::init();
        let d = ui::display();
        d.clear();
        d.draw_line(0, "BOOT 6 saes-st");
        d.flush();
    }
    // Bring UART up first so anything that follows (PASS/FAIL line +
    // fingerprint) reaches the ST-LINK VCP even at RDP ≥ 1, where
    // semihosting is dead. No-op when `uart-console` isn't in the
    // feature set (RDP0 runs still pass via probe-rs + semihosting).
    #[cfg(feature = "uart-console")]
    {
        hw::uart::init();
        hw::uart::write_str("[S][saes] UART up, starting self-test\r\n");
    }
    // Stage 7: uart::init returned (relevant only if uart-console is on).
    #[cfg(feature = "boot-pulse")]
    unsafe { hw::boot_pulse::pulse(7); }
    #[cfg(feature = "ui-lcd")]
    {
        let d = ui::display();
        d.draw_line(1, "BOOT 7 uart up");
        d.flush();
    }

    match hw::saes::init() {
        Ok(()) => {
            secure_log!("[S][saes] init OK");
            #[cfg(feature = "ui-lcd")]
            {
                let d = ui::display();
                d.draw_line(2, "saes init OK");
                d.flush();
            }
        }
        Err(e) => {
            secure_log!("[S][saes] init FAIL: {:?} — halting", e);
            #[cfg(feature = "uart-console")]
            {
                hw::uart::write_str("[S][saes] init FAIL\r\n");
                hw::uart::flush();
            }
            #[cfg(feature = "ui-lcd")]
            {
                let d = ui::display();
                d.draw_line(2, "saes init FAIL");
                d.flush();
            }
            loop {
                cortex_m::asm::wfe();
            }
        }
    }
    match hw::saes::self_test() {
        Ok(()) => {
            // NOTE: do NOT overwrite line 3 here — saes::self_test()
            // already wrote the DHUK fingerprint there.
            secure_log!("[S][saes] === self_test PASS ===");
        }
        Err(e) => {
            secure_log!("[S][saes] === self_test FAIL === {:?}", e);
            #[cfg(feature = "uart-console")]
            {
                hw::uart::write_str("[S][saes] === self_test FAIL ===\r\n");
                hw::uart::flush();
            }
            #[cfg(feature = "ui-lcd")]
            {
                let d = ui::display();
                d.draw_line(3, "self_test FAIL");
                d.flush();
            }
        }
    }

    // Tier-2 BHK lifecycle self-test (only when the `bhk` feature is
    // also on). Provisions the BHK if blank (writes the DHUK-wrapped
    // bytes to flash page 126 — erasable), loads it into the TAMP
    // backup registers + sets BHKLOCK, then runs a KeySel::Bhk
    // encrypt/decrypt round-trip and reports an 8-byte per-die BHK
    // fingerprint. At RDP0 the fingerprint is NOT per-die (the DHUK
    // that wrapped the BHK is the ST-substituted constant); at RDP ≥ 1
    // it would be per-die — but per-die BHK validation needs the BHK
    // provisioned WHILE at RDP1, which this RDP0-bench path does not do.
    #[cfg(feature = "bhk")]
    match hw::bhk::self_test() {
        Ok(fp) => {
            secure_log!(
                "[S][bhk] self_test PASS  BHK(fp)={:02x}{:02x}{:02x}{:02x}{:02x}{:02x}{:02x}{:02x}",
                fp[0], fp[1], fp[2], fp[3], fp[4], fp[5], fp[6], fp[7]
            );
            #[cfg(feature = "uart-console")]
            {
                hw::uart::write_str("[S][bhk] self_test PASS  BHK(fp)=");
                hw::uart::write_hex_8(&fp);
                hw::uart::write_str("\r\n");
                hw::uart::flush();
            }
            #[cfg(feature = "ui-lcd")]
            {
                const HEX: &[u8; 16] = b"0123456789abcdef";
                let mut buf = [0u8; 16];
                for (i, &b) in fp.iter().enumerate() {
                    buf[i * 2] = HEX[(b >> 4) as usize];
                    buf[i * 2 + 1] = HEX[(b & 0xF) as usize];
                }
                // ASCII-by-construction (hex digits) — sanctioned helper, no unsafe.
                let s = crate::ui::ascii_str(&buf);
                let d = ui::display();
                d.draw_line(0, s); // overwrite the "BOOT 6" marker — boot is done
                d.flush();
            }
        }
        Err(e) => {
            secure_log!("[S][bhk] self_test FAIL: {:?}", e);
            #[cfg(feature = "uart-console")]
            {
                hw::uart::write_str("[S][bhk] self_test FAIL: ");
                // No core::fmt over UART (would pull in fmt machinery);
                // hand-encode the BhkError variant as a short tag.
                let tag: &str = match e {
                    hw::bhk::BhkError::NotProvisioned => "NotProvisioned",
                    hw::bhk::BhkError::AlreadyProvisioned => "AlreadyProvisioned",
                    hw::bhk::BhkError::Flash => "Flash",
                    hw::bhk::BhkError::Saes(se) => match se {
                        hw::saes::SaesError::ShsiTimeout => "Saes(ShsiTimeout)",
                        hw::saes::SaesError::RngSeedError => "Saes(RngSeedError)",
                        hw::saes::SaesError::BusyTimeout => "Saes(BusyTimeout)",
                        hw::saes::SaesError::CcfTimeout => "Saes(CcfTimeout)",
                        hw::saes::SaesError::BusError => "Saes(BusError)",
                        hw::saes::SaesError::KeyInvalid => "Saes(KeyInvalid)",
                        hw::saes::SaesError::KeyConfigMismatch => "Saes(KeyConfigMismatch)",
                        hw::saes::SaesError::SelfTestRoundTrip => "Saes(SelfTestRoundTrip)",
                        hw::saes::SaesError::SelfTestDomainCollision => "Saes(SelfTestDomainCollision)",
                    },
                    hw::bhk::BhkError::Rng => "Rng",
                };
                hw::uart::write_str(tag);
                hw::uart::write_str("\r\n");
                hw::uart::flush();
            }
            #[cfg(feature = "ui-lcd")]
            {
                let d = ui::display();
                d.draw_line(0, "BHK self_test FAIL");
                d.flush();
            }
        }
    }

    secure_log!("[S][saes] self-test complete — halting");
    // Under `saes-self-test` alone (with probe-rs / debugger), SYS_EXIT
    // cleanly returns so probe-rs sees the test PASS and exits.
    #[cfg(not(feature = "boot-pulse"))]
    cortex_m_semihosting::debug::exit(cortex_m_semihosting::debug::EXIT_SUCCESS);
    // Under `boot-pulse`, fire a continuous pulse(8) "tail" pattern so
    // the LA1010 trace can distinguish "firmware reached end of boot"
    // (continuous 8-pulse groups forever) from "firmware hung at stage
    // K" (one-shot 1..K train then silence).
    #[cfg(feature = "boot-pulse")]
    loop {
        unsafe { hw::boot_pulse::pulse(8); }
    }
    #[cfg(not(feature = "boot-pulse"))]
    loop {
        cortex_m::asm::wfe();
    }
}

/// SysTick reload value for ~1 ms tick.
/// QEMU mps2-an505: 25 MHz → 25_000.  STM32U585: set dynamically from rcc::init().
#[cfg(all(not(feature = "stm32u585"), not(test)))]
const SYSTICK_RELOAD: u32 = 25_000;
#[cfg(all(feature = "stm32u585", not(test)))]
static mut SYSTICK_RELOAD: u32 = 16_000; // overwritten by rcc::init() result

#[cfg(not(test))]
fn setup_systick() {
    // SAFETY: `SYSTICK_RELOAD` is a `static mut` on `stm32u585` (written
    // once at boot from `rcc::init()` before SysTick is enabled). The
    // `const` non-stm32u585 path doesn't need unsafe — `read` is wrapping
    // an immutable global.
    #[cfg(feature = "stm32u585")]
    // SAFETY: single-writer at boot before this read; no races.
    let reload = unsafe { SYSTICK_RELOAD };
    #[cfg(not(feature = "stm32u585"))]
    let reload = SYSTICK_RELOAD;
    ARCH.syst_rvr.write(reload);
    ARCH.syst_cvr.write(0);
    ARCH.syst_csr.write(0x07);
}

/// Returns true if the SE backend has been provisioned.
/// Each backend (Mock, SE050, OPTIGA, dual) checks via its WalletStore impl.
#[cfg(not(test))]
fn is_provisioned(se: &mut impl WalletStore) -> bool {
    se.is_provisioned()
}

/// Run the first-boot interactive wizard. Loops until the user successfully:
/// 1. Picks (and confirms) a PIN
/// 2. Either generates a fresh BIP-39 mnemonic or restores one
/// 3. (For new wallets) writes down the displayed phrase and passes the
///    3-word spot check
///
/// Returns `(Mnemonic, pin)` to the caller, which is responsible for
/// provisioning the secure element. The mnemonic only ever lives on the
/// stack and is zeroed on drop. The caller must wipe the returned PIN.
///
/// On any cancel/idle-wipe/mismatch the wizard restarts from PIN entry —
/// there is no other recovery from a bricked first boot.
#[cfg(not(test))]
fn run_first_boot_wizard() -> (sphincs_tz_bip39::Mnemonic, [u8; 8]) {
    use ui::pin_entry::{enter_pin_with_confirm, PinEntryResult};
    use ui::seed_wizard::{
        choose_setup_mode, enter_mnemonic, show_mnemonic, verify_mnemonic, WizardChoice,
        WizardError, WizardResult,
    };
    use zeroize::Zeroize;

    loop {
        // ---- 1. Choose PIN (twice) ----
        secure_log!("[S] wizard: enter_pin_with_confirm");
        let pin = match enter_pin_with_confirm() {
            PinEntryResult::Pin(p) => {
                secure_log!("[S] wizard: PIN confirmed");
                p
            }
            PinEntryResult::Mismatch => {
                secure_log!("[S] wizard: PIN mismatch — retry");
                ui::show_status("PINs differ", "retry...");
                continue;
            }
            PinEntryResult::Cancelled => {
                secure_log!("[S] wizard: PIN entry cancelled — retry");
                ui::show_status("Cancelled", "retry...");
                continue;
            }
            PinEntryResult::IdleWipe => {
                secure_log!("[S] wizard: PIN entry idle wipe — retry");
                ui::show_status("Idle", "retry...");
                continue;
            }
        };

        // ---- 2. New or restore? ----
        secure_log!("[S] wizard: choose_setup_mode");
        let mnemonic = match choose_setup_mode() {
            WizardChoice::NewWallet => {
                secure_log!("[S] wizard: NewWallet — generating entropy");
                // Pull 32 bytes of entropy via the multi-source strong
                // RNG (STM32 hardware TRNG ⊕ OPTIGA GetRandom ⊕ SE050
                // GetRandom — Trezor-parity 3-source XOR). The wallet
                // master seed is the single most critical RNG output
                // in the firmware: if it's predictable, every key
                // derived from it (bootstrap, all slots, all chains)
                // is forgeable. rng_strong preserves entropy from any
                // unbroken source — defends against any single biased
                // / compromised TRNG (the STM32U5 silicon TRNG glitch
                // class, an OPTIGA chip-RNG fault, etc.).
                let mut entropy = [0u8; 32];
                if rng_strong::fill(&mut entropy).is_err() {
                    secure_log!("[S] wizard: rng_strong::fill FAILED");
                    let mut p = pin;
                    p.zeroize();
                    ui::show_status("RNG failed", "retry...");
                    continue;
                }
                secure_log!("[S] wizard: entropy ok, showing mnemonic");
                let m = sphincs_tz_bip39::Mnemonic::from_entropy(&entropy);
                entropy.zeroize();
                crate::fi::zeroize_barrier();

                // Show the 24 words paginated; require the user to walk to
                // the last page before they can confirm.
                let sm = show_mnemonic(&m);
                if sm != WizardResult::Confirmed {
                    secure_log!("[S] wizard: show_mnemonic returned {:?} — retry", sm);
                    let mut p = pin;
                    p.zeroize();
                    ui::show_status("Cancelled", "retry...");
                    continue;
                }
                // Spot-check 3 random words against what they wrote down.
                let vm = verify_mnemonic(&m);
                if vm != WizardResult::Confirmed {
                    secure_log!("[S] wizard: verify_mnemonic returned {:?} — retry", vm);
                    let mut p = pin;
                    p.zeroize();
                    ui::show_status("Verify fail", "retry...");
                    continue;
                }
                m
            }
            WizardChoice::Restore => {
                secure_log!("[S] wizard: Restore — entering mnemonic");
                match enter_mnemonic() {
                    Ok(m) => m,
                    Err(WizardError::Cancelled) => {
                        secure_log!("[S] wizard: enter_mnemonic cancelled — retry");
                        let mut p = pin;
                        p.zeroize();
                        ui::show_status("Cancelled", "retry...");
                        continue;
                    }
                    Err(WizardError::IdleWipe) => {
                        secure_log!("[S] wizard: enter_mnemonic idle wipe — retry");
                        let mut p = pin;
                        p.zeroize();
                        ui::show_status("Idle", "retry...");
                        continue;
                    }
                }
            }
            WizardChoice::Cancelled | WizardChoice::IdleWipe => {
                secure_log!("[S] wizard: choose_setup_mode cancelled/idle — retry");
                let mut p = pin;
                p.zeroize();
                ui::show_status("Cancelled", "retry...");
                continue;
            }
        };

        return (mnemonic, pin);
    }
}

#[cfg(not(test))]
#[cortex_m_rt::entry]
fn main() -> ! {
    // Keep the authenticated ERC-7730 catalogue-status receipt in a loadable
    // secure-image section even under linker garbage collection. Release
    // tooling extracts these exact bytes from the final ELF and proves that
    // they are covered by the signed flattened-image hash; the companion never
    // supplies or overrides this identity.
    let _ = core::hint::black_box(&db_roots::PQSIGNER_ERC7730_CATALOGUE_STATUS);

    // RDP1 boot bisection: pulse PE13 (Arduino D13) before any other
    // init so we see at least one pulse if the CPU made it into `main`
    // at all. Stage encoding documented in `hw::boot_pulse`.
    #[cfg(feature = "boot-pulse")]
    unsafe { hw::boot_pulse::init(); hw::boot_pulse::pulse(1); }

    // Classify the reset cause FIRST — before any peripheral init,
    // before any RCC_CSR modification. The sticky flags tell us why the
    // chip just came up. Abnormal causes (watchdog / low-power /
    // unknown) trigger defensive SRAM zeroization below, on the theory
    // that whatever was in SRAM belongs to an aborted operation that
    // never ran its normal cleanup path.
    let (reset_cause, reset_csr_raw) = unsafe { reset_cause::classify_and_clear() };

    // STM32U585: configure clocks BEFORE any semihosting output.
    // Semihosting BKPT halts the CPU when no debugger is attached, so
    // clock/RNG init must happen first to allow standalone boot testing.
    #[cfg(feature = "stm32u585")]
    unsafe {
        let mhz = hw::rcc::init();
        SYSTICK_RELOAD = mhz * 1_000;
        // Report the die identity (work-todo A4a / HW-ASSUME-REV-U). Report
        // only, never a fault: a rev X/W part is good silicon that the STM32U5
        // SESIP certificate (SESIP-2400133-01 / TN1545 Rev 3, which pins
        // dev_id=0x482 rev_id=0x3003 "rev U") simply does not cover, and the
        // consequence is that HW-ASSUME-RDP2's certificate evidence must not be
        // cited for it. Halting would conflate "outside a certificate's scope"
        // with "broken". Needs no clocks (DBGMCU is always-on) and no GTZC
        // attribute, so it is safe this early.
        hw::dbgmcu::report_die_id();
        #[cfg(feature = "boot-pulse")]
        hw::boot_pulse::pulse(2);
        // RNG init is deferred until AFTER sau::init() / GTZC config —
        // accessing RNG_S (0x520C_0800) before the TZSC has assigned the
        // peripheral's security attribute can stall the AHB2 fabric on
        // STM32U5.
        #[cfg(feature = "hw-sha256")]
        hw::hash::init_clock();
        #[cfg(feature = "boot-pulse")]
        hw::boot_pulse::pulse(3);

        // Silicon-lockdown belt-and-braces (HARDENING §4.2 / silicon-lockdown
        // SL7): a locked production device runs at RDP Level 2, where SWD/JTAG
        // is disabled in silicon. This check is REDUNDANT with that silicon
        // debug lockdown, so it WARN-and-continues by default — a hard halt
        // would brick the boots where RDP != L2 is LEGITIMATE: per the
        // ship-RDP-0 model (work-todo #36) devices ship at RDP-0 so users can
        // verify the flash before first power, and the FSBL self-locks to
        // RDP-2 on the first field boot — so a `mode-production` image
        // necessarily runs below RDP2 until that self-lock commits (and during
        // factory rehearsal). The opt-in `rdp-enforce-halt` feature
        // hard-refuses instead.
        #[cfg(feature = "mode-production")]
        {
            let rdp = hw::flash::rdp_level();
            if rdp != hw::flash::RdpLevel::L2 {
                // work-todo #36: once first-boot provisioning has completed
                // (journal ALL_DONE) the device MUST be at RDP-2 — RDP below L2
                // then is an RDP regression / tamper, so HARD-HALT rather than
                // warn. Before completion (ship RDP-0 / mid-ceremony) RDP < L2
                // is legitimate and Phase A owns the lock, so keep the
                // warn-and-continue below.
                #[cfg(feature = "rdp2-self-lock")]
                if first_boot::journal_all_done() {
                    secure_log!(
                        "[S][lockdown] RDP regressed below L2 after first-boot \
                         ALL_DONE — tamper signal, HALT"
                    );
                    loop {
                        cortex_m::asm::wfe();
                    }
                }
                secure_log!(
                    "[S][lockdown] WARNING: RDP != Level 2 (got {:?}) — a shipping \
                     image must run only on an RDP2-locked device; SWD/JTAG is open \
                     below RDP2. See docs/archive/production-todo-retired-2026-07-19.md.",
                    rdp
                );
                #[cfg(feature = "rdp-enforce-halt")]
                loop {
                    cortex_m::asm::wfe();
                }
            }
            // The target shipping design must enter the approved, WRP-protected
            // FSBL (silicon-lockdown SL2/SL3): a redirected SECBOOTADD0 is a boot
            // bypass. This checks the boot ADDRESS only; it does not prove the
            // FSBL extent or WRP mapping, whose production geometry/factory and
            // silicon receipts remain open. It also does not check BOOT_LOCK
            // (position still tracked as a bench-confirmation follow-up).
            let secboot = hw::flash::secboot_add0_reg();
            if !sphincs_tz_shared::lockdown::secboot_selects(
                secboot,
                hw::flash::FSBL_BASE_ADDR,
            ) {
                secure_log!(
                    "[S][lockdown] WARNING: SECBOOTADD0R=0x{:08x} does NOT select the \
                     FSBL base (expected boot addr 0x0C00_0000) — secure boot may be \
                     redirected. See docs/archive/production-todo-retired-2026-07-19.md.",
                    secboot
                );
            }
        }
        // Early RDP1 boot diagnostic on the NV3007 LCD (non-se050 builds only;
        // se050 builds defer display init until after their i2c_hw setup). The
        // LCD is SPI and self-initializing via `ui::init()` → `lcd::init()`, so
        // there is no separate bus init here (the OLED's I2C path was removed).
        #[cfg(all(feature = "ui-lcd", not(feature = "se050")))]
        {
            ui::init();
            let d = ui::display();
            d.clear();
            d.draw_line(0, "BOOT 3 lcd up");
            d.flush();
        }
        secure_log!("[S] RCC: {} MHz + HSI48 + TRNG configured", mhz);
    }

    secure_log!("[S] Secure world starting...");
    secure_log!(
        "[S] Reset cause: {} (RCC_CSR=0x{:08x})",
        reset_cause.tag(), reset_csr_raw
    );

    // Defensive SRAM zeroization. Complements the panic handler's
    // zeroize_sensitive_state() — if the chip reset before the panic handler
    // could run (watchdog bite, brownout, glitch-induced fault), this is our
    // last chance to wipe SRAM secrets before any subsequent unlock logic
    // touches them.
    //
    // Covers abnormal causes (Watchdog / LowPower / Unknown) AND `Software`.
    // Software resets were previously skipped on the assumption that they
    // "always originate from code that zeroized first" — that assumption was
    // FALSE for the pre-FA-1.5 firmware-update path, which was PIN-gated (so
    // the master secret was live by construction) and reset into the newly
    // installed image. FA-1.5 removed `cmd_fw_commit`'s reset arms (the
    // handler now refuses fail-closed), and this scrub remains the
    // defence-in-depth belt for any present or future software-reset path.
    // See `ResetCause::requires_secret_scrub` for the full rationale.
    //
    // Still skipped for Cold (SRAM has been without Vdd long enough for
    // retention to decay) and OptionByte (triggered by the external
    // provisioner, not the user).
    if reset_cause.requires_secret_scrub() {
        secure_log!("[S] Reset may retain secrets — zeroizing sensitive SRAM");
        nsc::zeroize_sensitive_state();
    }

    // ---- STSAFE-A110 I2C2 bus probe ----
    // Scans I2C2 (PH4/PH5) for on-board peripherals, then halts.
    // Triggered by: make stsafe-probe
    #[cfg(feature = "stsafe-probe")]
    unsafe {
        hw::i2c2_probe::run_probe();
    }

    // ---- GPIO button test ----
    // Scans Arduino header GPIOs, then tests debounced button events.
    // Triggered by: make button-test
    #[cfg(feature = "button-test")]
    unsafe {
        hw::buttons::run_test();
    }

    sau::init();
    #[cfg(feature = "boot-pulse")]
    unsafe { hw::boot_pulse::pulse(4); }
    #[cfg(all(feature = "ui-lcd", not(feature = "se050")))]
    {
        let d = ui::display();
        d.draw_line(1, "BOOT 4 sau OK");
        d.flush();
    }
    secure_log!("[S] SAU + MPC configured");

    // D6 pin identification diagnostic: pulse the candidate pins in a
    // known pattern, then park the CPU so the LA can capture cleanly.
    // Read `pin_diag::run`'s docstring for the pulse-width table — the
    // width that shows up on CH3 (hooked to the D6 header) identifies
    // the STM32 pin electrically wired to D6.
    #[cfg(feature = "pin-diag-boot")]
    {
        secure_log!("[S][pin-diag] running Arduino-header sweep");
        // Run twice with a gap so the LA has two chances to catch it.
        crate::pin_diag::header_sweep();
        cortex_m::asm::delay(160_000 * 500);
        crate::pin_diag::header_sweep();
        secure_log!("[S][pin-diag] done — halting; inspect LA on target header");
        loop {
            cortex_m::asm::wfe();
        }
    }

    // RNG init now that GTZC/TZSC has assigned RNG as a secure peripheral
    // and the SAU is live. Safe to touch 0x520C_0800 from the secure world.
    #[cfg(feature = "stm32u585")]
    unsafe {
        if hw::rng::init().is_err() {
            panic!("TRNG initialization failed; refusing entropy consumers");
        }
        rng::retain_backend_receipt();
        #[cfg(feature = "boot-pulse")]
        hw::boot_pulse::pulse(5);
        secure_log!("[S] TRNG initialised");
    }

    // Tamper monitoring (feature `tamp`). Polled — `init()` arms the
    // detection registers (CR1) but leaves IER masked so no IRQ fires;
    // `tamp::poll()` from SysTick drains TAMP_SR. Log-only; never halts
    // and never wipes (see `hw::tamp` module header §1). Reversible:
    // register-state only. Without the feature, this compiles to no-op.
    #[cfg(all(feature = "stm32u585", feature = "tamp"))]
    {
        hw::tamp::init();
        #[cfg(feature = "tamp-irq")]
        secure_log!("[S] TAMP initialised (IRQ, log-only)");
        #[cfg(not(feature = "tamp-irq"))]
        secure_log!("[S] TAMP initialised (polled, log-only)");
    }

    // Power-consumption side-channel mask (feature `consumption-mask`).
    // TIM2 CH1 PWM on PA5 with a randomised duty cycle. `init()` configures
    // the TIM2/GPIO + writes a first random duty; `randomize()` runs from
    // SysTick to keep the mask jittering across signing windows. Reversible:
    // TIM2/GPIO/RCC clock-enable bits; revert by reflashing without the
    // feature. See `hw::consumption_mask` module header.
    #[cfg(all(feature = "stm32u585", feature = "consumption-mask"))]
    {
        hw::consumption_mask::init();
        secure_log!("[S] Consumption mask initialised (TIM2 CH1 PWM on PA5)");
    }
    #[cfg(all(feature = "ui-lcd", not(feature = "se050")))]
    {
        let d = ui::display();
        d.draw_line(2, "BOOT 5 rng OK");
        d.flush();
    }

    // Masked-SHA-256 overhead bench (work-todo §18). Runs once at boot
    // after the HASH peripheral clock + TRNG are up, times the masked
    // gates vs the HASH peripheral, prints the projection, SYS_EXITs.
    // Never returns. Does nothing unless `bench-masked-sha` is enabled.
    #[cfg(feature = "bench-masked-sha")]
    bench_masked_sha::run_and_halt();

    // SAES self-test (Tier 1 of work-todo #7). Runs once at boot,
    // halts on PASS/FAIL. Does nothing unless `saes-self-test` is
    // enabled — the driver module itself is gated on `saes-dhuk`.
    #[cfg(feature = "saes-self-test")]
    saes_self_test_and_halt();

    // ML-KEM inner-wrap self-test (#28 piece 2b validation). Round-trips a
    // dummy half through the HUK-derived keypair + TRNG, halts on PASS/FAIL.
    // Does nothing unless `mlkem-self-test` is enabled.
    #[cfg(feature = "mlkem-self-test")]
    mlkem_self_test_and_halt();

    // Render-only golden-screenshot harness (#21). Renders the curated screen
    // corpus + emits [UI-FP] fingerprints, then halts — no keygen/sign. Does
    // nothing unless `ui-golden-render` is enabled.
    #[cfg(feature = "ui-golden-render")]
    crate::ui::golden::render_golden_and_halt();

    // Firmware anti-rollback test (feature `fw-rollback-e2e`). Runs the real
    // verify_manifest chain against dev-key-signed v1/v2/v3 manifests + test
    // floors, proving downgrade rejection with NO irreversible side effects
    // (no OTP bump, no flash erase, no reboot). Halts on PASS/FAIL. Reflash
    // to revert. Production OTP-burn FW-update testing is deferred to
    // dedicated hardware. Needs HASH/RNG up (done above) for SPHINCS+C10.
    #[cfg(all(feature = "fw-rollback-e2e", feature = "stm32u585"))]
    fw_rollback_e2e::run_and_halt();

    // SAES init for the Tier-1 derivation path. Only needed when we're
    // actually going to call `SAES-CMAC(DHUK, ...)` — i.e., `saes-dhuk`
    // is ON and the `otp-hardcoded-master-key` dev shortcut is OFF.
    // Under `otp-hardcoded-master-key` the derivation stays on the
    // HKDF-over-constant fallback and SAES is never touched by
    // `secret_keys`, so skipping the init keeps dev-path builds
    // unaffected.
    #[cfg(all(feature = "saes-dhuk", not(feature = "otp-hardcoded-master-key"), not(feature = "saes-self-test")))]
    {
        match hw::saes::init() {
            Ok(()) => {
                secure_log!("[S] SAES initialised (Tier-1 DHUK path)");
            }
            Err(e) => {
                secure_log!("[S] SAES init FAIL: {:?} — derivations will error", e);
            }
        }
    }

    // Tier-2 BHK boot-time load + lock. Only when the `bhk` candidate
    // hardware feature is on (and the dev/self-test shortcuts are off). First
    // boot of an unprovisioned device generates + wraps + stores the
    // BHK; every subsequent boot unwraps it into the TAMP backup
    // registers and sets `BHKLOCK` so only SAES can read it. Must run
    // after `saes::init()` (the wrap/unwrap uses DHUK-ECB) and before
    // any `KeySel::Bhk` derivation. Under `otp-hardcoded-master-key` /
    // `bhk-hardcoded-master-key` / `saes-self-test` the BHK path stays
    // on the software fallback and this is skipped.
    #[cfg(all(feature = "bhk", not(feature = "otp-hardcoded-master-key"), not(feature = "bhk-hardcoded-master-key"), not(feature = "saes-self-test")))]
    unsafe {
        // work-todo #36: under `rdp2-self-lock` the BHK provision+load is owned
        // by first-boot Phase B (journal-gated, anti-pre-plant erase-and-
        // reprovision, per-die DHUK only AFTER the RDP-2 lock). So this
        // every-boot block stands down until the ceremony is ALL_DONE:
        //  - boot #1 (RDP-0, journal blank): skip — never wrap the BHK under
        //    the shared RDP-0 constant DHUK (it would mismatch post-lock);
        //  - Phase-B boot: skip — Phase B provisions + load_and_locks EXACTLY
        //    once (its resume-load covers a crash past the BHK step), so this
        //    block must not also load_and_lock (BHKLOCK is write-once/boot);
        //  - normal boot after ALL_DONE: run as before.
        #[cfg(feature = "rdp2-self-lock")]
        let run_bhk_block = first_boot::journal_all_done();
        #[cfg(not(feature = "rdp2-self-lock"))]
        let run_bhk_block = true;

        if run_bhk_block {
            #[cfg(feature = "rdp2-self-lock")]
            if !hw::bhk::is_provisioned() {
                // ALL_DONE means SE050 has already rotated to BHK-derived final
                // credentials. A missing wrapped BHK here is lifecycle/tamper
                // damage, not permission to invent a platform-only replacement
                // that can never match those credentials.
                panic!("BHK missing after first-boot ALL_DONE; refusing reprovision");
            }
            #[cfg(not(feature = "rdp2-self-lock"))]
            if !hw::bhk::is_provisioned() {
                match hw::bhk::provision() {
                    Ok(()) => {
                        secure_log!("[S] BHK provisioned (first boot)");
                    }
                    Err(e) => {
                        secure_log!("[S] BHK provision FAIL: {:?}", e);
                    }
                }
            }
            match hw::bhk::load_and_lock() {
                Ok(()) => {
                    secure_log!("[S] BHK loaded + BHKLOCK set");
                }
                Err(e) => {
                    secure_log!("[S] BHK load FAIL: {:?} — BHK derivations will error", e);
                }
            }
        } else {
            secure_log!("[S] BHK block deferred to first-boot Phase B (rdp2-self-lock)");
        }
    }

    // Initialize I2C1 for SE050 and/or OPTIGA Trust M BEFORE any SE operations.
    // Both chips share I2C1 (SE050 at 0x48, OPTIGA at 0x30). No address conflict.
    // Must come after rcc::init() (clocks) and sau::init() (peripherals).
    #[cfg(all(feature = "stm32u585", any(feature = "se050", feature = "optiga-trust-m")))]
    unsafe {
        hw::i2c_hw::init();
        secure_log!("[S] I2C1 initialized (PB8/PB9, 400 kHz)");
    }

    ui::init();
    secure_log!("[S] UI initialized");

    // work-todo #36 — Phase A (pre-lock). On the FIRST field boot (RDP != L2)
    // this verifies the ship option-byte profile + blank per-device pages,
    // shows "DO NOT POWER OFF", programs RDP=0xCC, and resets — it never
    // returns on that boot. On every later boot RDP is already L2 and it
    // returns immediately. Placed right after `ui::init()` (panel is up) and
    // before ANY SE/USB traffic, so the pre-lock window stays tiny. Absent
    // from every non-`rdp2-self-lock` build.
    #[cfg(feature = "rdp2-self-lock")]
    first_boot::run_pre_lock_and_maybe_lock();

    ui::splash();

    // Start SysTick early on real hardware so measured_boot can use
    // timeout::now() for its 4-second auto-dismiss timer. On QEMU the
    // mailbox gateway must be initialised before SysTick starts polling,
    // so SysTick stays late there (and the semihosting UI blocks on
    // READC anyway — no timer needed).
    #[cfg(feature = "stm32u585")]
    setup_systick();

    // F-24 stage E Phase 1 — hardware flicker validation harness.
    // When this feature is on, short-circuit straight into the decoy-
    // frame render loop. No measured_boot, no wizard, no SE access —
    // just OLED rendering forever so a bench observer can judge the
    // 5:1 (200 ms:40 ms) real:decoy cadence.
    #[cfg(feature = "decoy-flicker-test")]
    ui::seed_wizard::decoy_flicker_test_loop();

    // Phase-C LCD UI bring-up — exercise the real `ui::Display` text path
    // (clear + draw_line ×4 + flush) on the NV3007 so a bench observer can
    // confirm the 16×4 grid renders with correct orientation, font scale, and
    // centering. `ui::init()`/`ui::splash()` above already ran through
    // `lcd::Display`. (The raw green/red/blue fill demo lives in
    // `hw::lcd_nv3007::lcd_test_loop` if the panel itself needs re-checking.)
    // Run via `make lcd-test-hw`.
    #[cfg(feature = "lcd-test")]
    {
        // Phase-C interactive bench: drive the REAL `pin_entry::enter_pin`
        // dialog on the LCD so a bench operator can confirm the buttons +
        // input loop work (no functionality loss vs the OLED). Controls:
        //   Right short = +1 digit, Left short = -1 digit,
        //   Right long  = next position / confirm at the last,
        //   Left long   = previous position / cancel at the first.
        // Needs physical buttons on the gpio-buttons pins (LEFT=PC1/D8,
        // RIGHT=PA8/D9). Loops so it can be re-tested.
        secure_log!("[LCD-UI] interactive PIN: L/R short=-/+digit, R-long=next/ok, L-long=prev/cancel");
        loop {
            match ui::pin_entry::enter_pin() {
                ui::pin_entry::PinEntryResult::Pin(_) => {
                    secure_log!("[LCD-UI] -> PIN entered (8 digits)");
                }
                ui::pin_entry::PinEntryResult::Cancelled => {
                    secure_log!("[LCD-UI] -> cancelled");
                }
                ui::pin_entry::PinEntryResult::IdleWipe => {
                    secure_log!("[LCD-UI] -> idle wipe");
                }
                ui::pin_entry::PinEntryResult::Mismatch => {
                    secure_log!("[LCD-UI] -> mismatch");
                }
            }
        }
    }

    // Animated splash-screen preview. Short-circuits boot into a loop that
    // cycles the three `assets/splash-1{6,7,8}-*.html` revisions (hyperspace /
    // horizon / nebula) on the NV3007 LCD, ~12 s each, forever — no SE, no
    // wizard, no provisioning. `ui::init()` above already brought the panel up.
    // Run via `make splash-test-hw`.
    #[cfg(feature = "splash-test")]
    ui::splash_test::run();

    // §32 P4/P5 interactive UI harness. Short-circuits into a loop that
    // drives JUST the duress-PIN setup dialogs on the real OLED — no SE,
    // no wizard, no provisioning. Lets a bench operator validate the
    // dialog rendering + button nav + the distinct-PIN reject + the
    // wipe-mode chooser. Run: `make play-hw-duress-ui` (keyboard buttons
    // forwarded via wallet_run_hw.py). The "main PIN" is fixed to
    // 12345678 so the operator can verify the distinct-check rejects it.
    #[cfg(feature = "duress-ui-test")]
    unsafe {
        // NB: use `secure_log!` (DHCSR.C_DEBUGEN-gated), NOT raw
        // `hprintln!` — an ungated semihosting BKPT HardFaults when no
        // debugger is attached (e.g. straight after a probe-rs download
        // resets the board), hanging the device before the OLED renders.
        use zeroize::Zeroize;
        let main_pin: [u8; sphincs_tz_shared::PIN_LEN] = *b"12345678";
        secure_log!("[DURESS-UI] harness ready. Main PIN = 12345678.");
        secure_log!("[DURESS-UI] Try setting a duress PIN; enter 12345678 once to see the reject.");
        loop {
            ui::show_status("Duress UI test", "LR=start");
            // Wait for any button to (re)start a pass.
            let mut idle = || false;
            let _ = ui::input().wait_button(&mut idle);

            match ui::seed_wizard::collect_duress_pin(&main_pin) {
                Some(mut p) => {
                    secure_log!("[DURESS-UI] duress PIN accepted (distinct from main)");
                    let wipe = ui::seed_wizard::choose_duress_wipe_mode();
                    secure_log!("[DURESS-UI] wipe-on-duress = {}", wipe);
                    ui::show_status(
                        "Duress set",
                        if wipe { "mode: WIPE" } else { "mode: DECOY" },
                    );
                    p.zeroize();
                }
                None => {
                    secure_log!("[DURESS-UI] duress declined / exhausted -> random decoy");
                    ui::show_status("Declined", "random decoy");
                }
            }
            // Hold the result on screen ~2.5 s (readable), then loop.
            let start = timeout::now();
            while timeout::now().wrapping_sub(start) < 2500 {
                cortex_m::asm::nop();
            }
        }
    }

    // Firmware measurement: hash flash, display 8 BIP-39 words for
    // visual comparison with the companion tool's reproducible build.
    // Skipped in automated e2e tests which need non-interactive boot.
    #[cfg(not(feature = "e2e-test"))]
    measured_boot::run();

    // work-todo #36 — Phase B (post-lock provisioning). After the RDP-2
    // self-lock (the per-die DHUK is now final), resume the journaled first-
    // boot ceremony: BHK first-write + SE050 SCP03/admin rotation + OPTIGA PBS
    // rotation OFF the factory transport keysets, all before first PIN entry /
    // the seed wizard. A completed ceremony (journal ALL_DONE) returns at
    // once. This is the FIRST SE traffic — everything above (measured_boot)
    // only hashes flash. Absent from every non-`rdp2-self-lock` build.
    #[cfg(all(feature = "rdp2-self-lock", feature = "dual-se"))]
    unsafe {
        let se = &mut *core::ptr::addr_of_mut!(SE);
        first_boot::run_post_lock_provisioning(se);
    }

    // Load the Platform Binding Secret for OPTIGA Trust M from secure flash.
    // If blank (first boot), PBS will be provisioned during the seed wizard.
    // Prodtest bypasses this wallet-state preflight: reversible acceptance
    // must not load or reconcile persistent wallet credentials before its
    // short-circuit.
    #[cfg(all(
        feature = "optiga-trust-m",
        not(feature = "dual-se"),
        not(feature = "prodtest"),
        not(test)
    ))]
    unsafe {
        (&mut *core::ptr::addr_of_mut!(SE)).load_pbs();
    }
    #[cfg(all(feature = "dual-se", not(feature = "prodtest"), not(test)))]
    unsafe {
        (&mut *core::ptr::addr_of_mut!(SE)).load_pbs();
    }

    // §4 PIN-counter rollback check. Compares MCU page 124 with the readable
    // OPTIGA E120 count and wipes only when E120 leads, because page 124 is
    // precharged before SE verification. The SE050 UserID attribute is
    // policy-denied (0x6986), so it is not a boot input; SE050 still consumes
    // ordinary attempts and independently enforces max-10 lockout. See
    // `nsc::reconcile_pin_attempts` for the exact direction and limits.
    // `reconcile_pin_attempts` can deliberately wipe wallet state when the SE
    // counter leads the MCU counter. It is therefore outside the reversible
    // prodtest profile and must never run before the prodtest short-circuit.
    #[cfg(all(
        feature = "stm32u585",
        any(feature = "optiga-trust-m", feature = "dual-se"),
        not(feature = "prodtest"),
        not(test)
    ))]
    unsafe {
        nsc::reconcile_pin_attempts(&mut *core::ptr::addr_of_mut!(SE));
    }

    // ---- Factory provisioning short-circuit ----
    //
    // When `factory-provisioning` is on, run the one-shot factory
    // ceremony here and halt. Never falls through to the wizard /
    // unlock paths. The ceremony assumes both SEs are alive (the
    // boot path above has already initialized them) and that the
    // device is fresh-from-manufacturer (no user state).
    //
    // See `secure/src/factory_provisioning.rs` module docs for the
    // step list + error code table + operator manual reference.
    #[cfg(feature = "factory-provisioning")]
    unsafe {
        let se = &mut *core::ptr::addr_of_mut!(SE);
        factory_provisioning::run_and_halt(se);
    }

    // ---- Prodtest short-circuit ----
    //
    // When `prodtest` is on, skip the wizard / unlock paths and
    // show the "PRODTEST READY" panel. The CMSE veneers (declared
    // under `#[cfg(feature = "prodtest")]` in `secure/src/nsc/mod.rs`)
    // handle every prodtest command from the NS-world USB-HID ISR;
    // main() just sits in WFI. The factory fixture drives the test
    // sequence via USB and decides per-component pass/fail.
    //
    // See `docs/provisioning/factory-prodtest.md` for the command reference +
    // fixture integration guide.
    #[cfg(feature = "prodtest")]
    unsafe {
        // Initialize button GPIOs so `CMD_PRODTEST_BUTTON_TEST` (109)
        // can drive them. Safe to call before NS boot — the buttons
        // module only configures GPIOA/GPIOC bits via RMW on disjoint
        // pins, leaving SWDIO/SWCLK / I²C / SPI lines untouched.
        #[cfg(feature = "gpio-buttons")]
        hw::buttons::init();

        // USB OTG FS hardware init — must run before NS boot so the
        // NS USB stack comes up against a configured controller.
        // Mirrors the call at the tail of main() in the non-prodtest
        // path, but we have to run it ourselves because the prodtest
        // short-circuit jumps straight to `boot_ns::boot` and skips
        // the wizard / unlock / pre-boot init that the production
        // flow does down there.
        hw::usb_hw::init();
        secure_log!("[S] USB OTG FS hardware initialized (prodtest)");

        // SysTick + DWT cycle counter — same final-stage init the
        // production main() does between unlock and `boot_ns::boot`.
        setup_systick();
        ARCH.demcr.set_bits(1 << 24);       // TRCENA — enable trace unit
        ARCH.dwt_lar.write(0xC5AC_CE55);    // unlock DWT for writes
        ARCH.dwt_cyccnt.write(0);           // reset cycle counter
        ARCH.dwt_ctrl.set_bits(1);          // CYCCNTENA — start counter

        ui::show_status(" PRODTEST READY", " USB cmds wait ");
        secure_log!("[S] prodtest firmware ready — booting NS world for USB");

        // SAFETY: `boot_ns::boot` performs the irreducibly-unsafe
        // TrustZone branch to the NS reset vector via BLXNS. Same
        // primitive used at the tail of main(); no S-world state
        // survives past it. The NS USB stack runs in NS world and
        // routes `INS_V2_PRODTEST_*` codes to the CMSE veneers
        // declared under `#[cfg(feature = "prodtest")]` in
        // `secure/src/nsc/mod.rs::nsc_prodtest_*`.
        boot_ns::boot(NS_FLASH_BASE);
    }

    // ---- Retired OPTIGA OID-recovery incident path ----
    // These branches preserve the failed E0E3 experiment for source-level
    // provenance only. `nsc/mod.rs` unconditionally rejects the feature with
    // OPTIGA_RESET_OIDS_RETIRED, so no executable image can reach them. Do not
    // re-enable this path: the observed E0E3 is a full type-0x12 device cert,
    // not the type-0x11 anchor the experiment assumed.
    #[cfg(all(feature = "optiga-reset-oids", feature = "dual-se", not(test)))]
    unsafe {
        secure_log!("[S] optiga-reset-oids: running one-shot OID recovery");
        let se = &mut *core::ptr::addr_of_mut!(SE);
        if let Err(e) = se.optiga.recover_burned_oids() {
            secure_log!("[S] optiga-reset-oids: recovery failed: {:?}", e);
        } else {
            secure_log!("[S] optiga-reset-oids: recovery pass complete");
        }
    }
    #[cfg(all(
        feature = "optiga-reset-oids",
        feature = "optiga-trust-m",
        not(feature = "dual-se"),
        not(test),
    ))]
    unsafe {
        secure_log!("[S] optiga-reset-oids: running one-shot OID recovery");
        let se = &mut *core::ptr::addr_of_mut!(SE);
        if let Err(e) = se.recover_burned_oids() {
            secure_log!("[S] optiga-reset-oids: recovery failed: {:?}", e);
        } else {
            secure_log!("[S] optiga-reset-oids: recovery pass complete");
        }
    }

    // ---- Boot-time wipe resume ----
    // If a factory reset was armed but interrupted (power loss mid-wipe),
    // the wipe flag in page 125 QW 1 survives the reboot. Finish the wipe
    // now before any unlock attempt, so we never leave the chip in a
    // half-wiped state that an attacker could leverage for partial secret
    // extraction.
    //
    // Applies to both SE050-standalone and dual-SE builds — the flag and
    // admin PIN live on the STM32 side, independent of which SE backends
    // are active. Skipped under `se050-crash-safety-e2e` because that
    // test owns the page 125 lifecycle itself (stores a test admin PIN
    // and runs its own resume routine against test OIDs; letting
    // factory_reset_admin fire here would erase the test state before
    // the test's phase 2 runs).
    #[cfg(all(
        feature = "stm32u585",
        any(feature = "se050", feature = "dual-se"),
        not(feature = "se050-crash-safety-e2e"),
        not(test),
    ))]
    unsafe {
        use secure_element::WalletStore;

        // Two triggers for boot-time wipe:
        //   (a) page-125 wipe-in-progress flag is armed — a prior
        //       `factory_reset_admin` was interrupted mid-flight.
        //   (b) page-124 MCU attempt counter is at MAX_ATTEMPTS — a
        //       prior session burned the last attempt but crashed
        //       before `trigger_lockout_wipe` could complete. Without
        //       this check, the device would boot and let the user
        //       try a PIN they've already been locked out of.
        let wipe_armed = hw::flash::is_wipe_armed();
        let attempts_exhausted =
            hw::flash::pin_attempts_read() >= sphincs_tz_shared::MAX_ATTEMPTS;

        if wipe_armed || attempts_exhausted {
            if wipe_armed {
                secure_log!("[S] Wipe-in-progress flag set — resuming factory reset");
            }
            if attempts_exhausted {
                secure_log!("[S] MCU attempt counter at MAX — triggering wipe");
            }
            ui::show_status("WIPING", "resuming from interrupt");
            let _ = (&mut *core::ptr::addr_of_mut!(SE)).factory_reset_admin();
            // factory_reset_admin ends with erase_admin_page() which clears
            // both the page-125 PIN and the wipe flag. Also reset page 124
            // (MCU attempt counter) so next boot sees unprovisioned state +
            // blank counter → first-boot wizard, not another lockout loop.
            let _ = hw::flash::pin_attempts_reset();
            ui::show_status("WALLET WIPED", "restore from seed");
        }

        // Post-wipe-check, pre-unlock: sync the SE drivers' in-RAM
        // remaining-attempts mirrors against the MCU page-124 counter.
        // The `SE.*.remaining` fields are `const fn new()`-initialised
        // to `MAX_ATTEMPTS` on every boot, but MCU flash retains the
        // real count across power-cycles. Without this ratchet-down,
        // `remaining_attempts()` / `cmd_get_remaining` would over-
        // report after a mid-lockout reboot until the next successful
        // unlock resynced the cache. `sync_remaining_with_mcu` only
        // lowers the cache (min-of-two), never raises it, so calling
        // it here is safe regardless of prior state.
        {
            use crate::secure_element::WalletStore;
            let used = hw::flash::pin_attempts_read();
            (&mut *core::ptr::addr_of_mut!(SE)).sync_remaining_with_mcu(used);
        }
    }

    // ---- SE050 factory reset (iterative wipe) ----
    // Actually wipes user objects via ReadIDList + DeleteSecureObject.
    // Authentication attempts against every UserID this firmware
    // lineage has ever provisioned:
    //   - 0x7B10_0000 : current dual-SE / standalone SE050 UserID (v6)
    //   - 0x7B0E_0000 : retired v5 range (2026-04-22, bench chip stuck
    //                   admin with unrecoverable random PIN)
    //   - 0x7B06_0000 : retired v3 range (2026-04-21, bench chips only)
    //   - 0x7B00_2000 : legacy UserID from early f44fd92-era builds
    // PIN is `b"00000000"` — the PIN baked into the e2e-test fast-path
    // and entered by a user typing "0" eight times in the wizard.
    //
    // Triggered by: make se050-reset
    #[cfg(feature = "se050-factory-reset")]
    unsafe {
        ui::show_status("SE050 wipe", "...");
        let se = &mut *core::ptr::addr_of_mut!(SE);

        // Try the known dev UserIDs against the dev PIN candidates. Each
        // wrong PIN consumes one SE050 attempt against that UserID
        // (10-attempt budget); a correct PIN auto-resets the counter.
        // PIN order is best-guess to minimise consumed attempts.
        const USERIDS: &[u32] = &[0x7B10_0000, 0x7B0E_0000, 0x7B06_0000, 0x7B00_2000];
        const PIN_CANDIDATES: &[&[u8]] = &[
            b"00000000", // e2e default + most common dev PIN
            b"12345678",
            b"11111111",
        ];

        let mut total_deleted: u32 = 0;
        let mut last_failed: u16 = u16::MAX;
        let mut any_auth_ok = false;

        'outer: for &uid in USERIDS {
            for &pin in PIN_CANDIDATES {
                let (d, f, auth_ok) = match se.iterative_wipe(Some(uid), Some(pin)) {
                    Ok(r) => r,
                    Err(_e) => {
                        secure_log!(
                            "[S] iterative_wipe(UID=0x{:08x}) ERROR: {:?}",
                            uid, _e
                        );
                        (0, u16::MAX, false)
                    }
                };
                secure_log!(
                    "[S] wipe UID=0x{:08x} pin={:?}: deleted={}, left={}, auth_ok={}",
                    uid,
                    core::str::from_utf8(pin).unwrap_or("?"),
                    d, f, auth_ok
                );
                total_deleted = total_deleted.saturating_add(d as u32);
                last_failed = f;
                if auth_ok {
                    any_auth_ok = true;
                }
                if f == 0 {
                    break 'outer;
                }
            }
        }

        // Tri-state outcome:
        //   clean      — no survivors
        //   wrong-PIN  — survivors AND no PIN ever authed (UserID likely
        //                provisioned with a different PIN, or UserID OID
        //                guess is wrong)
        //   blocked    — survivors AND some PIN did auth, so the leftover
        //                objects were created with a non-self-deletable
        //                policy (older firmware) and are stuck on-chip
        let status = if last_failed == 0 {
            "clean"
        } else if !any_auth_ok {
            "wrong-PIN"
        } else {
            "blocked"
        };
        secure_log!(
            "[S] SE050 wipe DONE: {} deleted total, {} survivors, status={}",
            total_deleted, last_failed, status
        );
        ui::show_status("SE050 wipe", status);
        loop { cortex_m::asm::wfi(); }
    }

    // ---- SE050 crash-safety (power-loss mid-wipe) e2e ----
    // Two-phase test. Same firmware both runs; phase auto-detected from
    // the wipe flag at page 125 QW 1.
    //   Phase 1 (flag blank): provision test objects at 0x7B0A_xxxx,
    //   persist a test admin PIN to flash, arm the flag, delete ONLY
    //   the data object, halt → simulates power cut mid-wipe.
    //   Phase 2 (flag armed, after manual board reset): verify pre-
    //   resume state, read PIN from flash, finish the wipe, erase
    //   page 125, report PASS.
    // Triggered by: make se050-crash-safety-e2e
    #[cfg(feature = "se050-crash-safety-e2e")]
    unsafe {
        let se = &mut *core::ptr::addr_of_mut!(SE);
        let flag_armed_at_start = hw::flash::is_wipe_armed();
        if flag_armed_at_start {
            ui::show_status("Crash safety", "phase 2 (resume)");
        } else {
            ui::show_status("Crash safety", "phase 1 (partial)");
        }
        match se.run_crash_safety_roundtrip() {
            Ok(msg) => {
                secure_log!("[S] [E2E-CRASH] {}", msg);
                if flag_armed_at_start {
                    ui::show_status("Crash safety", "PASS");
                } else {
                    ui::show_status("RESET BOARD", "to run phase 2");
                }
            }
            Err(_e) => {
                secure_log!("[S] [E2E-CRASH] FAIL ({:?})", _e);
                ui::show_status("Crash safety", "FAIL");
            }
        }
        loop { cortex_m::asm::wfi(); }
    }

    // ---- SE050 admin-auth wipe e2e ----
    // Exercises the exact delete path used by the PIN-lockout factory
    // reset: provision admin + user UserIDs + a data object with the
    // two-entry TAG_POLICY, then delete everything under admin auth
    // WITHOUT verifying the user PIN. Proves admin can wipe even when
    // the user's credential is blocked.
    // Uses test OID range 0x7B09_xxxx so it never touches production
    // provisioning. Repeatable on the same chip.
    // Triggered by: make se050-admin-wipe-e2e
    #[cfg(feature = "se050-admin-wipe-e2e")]
    unsafe {
        ui::show_status("Admin wipe", "running...");
        let se = &mut *core::ptr::addr_of_mut!(SE);
        match se.run_admin_wipe_roundtrip() {
            Ok(()) => {
                secure_log!("[S] [E2E-ADMIN] ADMIN-WIPE ROUNDTRIP: PASS");
                ui::show_status("Admin wipe", "PASS");
            }
            Err(_e) => {
                secure_log!("[S] [E2E-ADMIN] ADMIN-WIPE ROUNDTRIP: FAIL ({:?})", _e);
                ui::show_status("Admin wipe", "FAIL");
            }
        }
        loop { cortex_m::asm::wfi(); }
    }

    // ---- SE050 on-silicon stress harness ----
    // Catalog-driven runner that exercises the SE050 driver against
    // real silicon. See `secure/src/se050_stress/` for the test catalog
    // + helper API. Operator-facing entry: `make se050-stress[-*]`.
    //
    // Halts in `wfi` after `run_catalog` returns. `probe-rs run` exits
    // cleanly when the operator hits Ctrl-C; the Makefile recipe greps
    // the semihosting log for `=== SUMMARY: … FAIL ===` to derive its
    // own pass/fail status.
    //
    // Triggered by: make se050-stress[-destructive|-only-<name>]
    #[cfg(feature = "se050-stress")]
    unsafe {
        ui::show_status("se050-stress", "init...");
        let se = &mut *core::ptr::addr_of_mut!(SE);
        se050_stress::run_catalog(se);
        loop { cortex_m::asm::wfi(); }
    }

    // ---- SE050 deterministic-transport rotation experiment (IRREVERSIBLE) ----
    // One-shot GP PUT KEY: replace SCP03 keyset 0x0B in place with this
    // device's deterministic derived transport keys
    // (secret_keys::se050_scp03_*_key, BHK-rooted in a `bhk` build), then halt.
    // This is sacrificial evidence only, not the owner-required fresh-TRNG
    // production-final rotation and not a factory/field ceremony. It does not
    // solve the per-device transport-key handoff, authenticated migration,
    // durable old/new recovery, KVN/atomicity, or coordinated E140 ordering.
    // The PUT KEY framing is best-effort from GP 2.3 / AN12436 and may run only
    // under an exact owner-authorized sacrificial plan. Prodtest is
    // unconditionally incompatible with this feature.
    // Triggered by: make flash-hw-se050-rotate-scp03
    #[cfg(feature = "se050-rotate-scp03")]
    unsafe {
        ui::show_status("SCP03 rotate", "running...");
        let se = &mut *core::ptr::addr_of_mut!(SE);
        match se.rotate_scp03_keys() {
            Ok(()) => {
                secure_log!("[S] [SCP03-ROTATE] PUT KEY OK — sacrificial deterministic transport-key experiment only");
                ui::show_status("SCP03 rotate", "PASS");
            }
            Err(_e) => {
                secure_log!("[S] [SCP03-ROTATE] FAIL ({:?})", _e);
                ui::show_status("SCP03 rotate", "FAIL");
            }
        }
        loop { cortex_m::asm::wfi(); }
    }

    // ---- SE050 admin-extract-attempt e2e ----
    // Negative security test: prove the admin PIN cannot extract user-PIN-
    // gated secrets. Provisions a sentinel under user-PIN gating with
    // admin-DELETE in the policy, then asserts admin-auth READ is refused
    // while admin-auth DELETE succeeds. PASS = silicon enforced the two-
    // entry TAG_POLICY (admin → DELETE only). FAIL = security regression.
    // Uses test OID range 0x7B0B_xxxx; never touches production provisioning.
    // Triggered by: make se050-admin-extract-attempt-e2e
    #[cfg(feature = "se050-admin-extract-attempt-e2e")]
    unsafe {
        ui::show_status("Admin extract", "running...");
        let se = &mut *core::ptr::addr_of_mut!(SE);
        match se.run_admin_extract_attempt() {
            Ok(()) => {
                secure_log!("[S] [E2E-EXTRACT] ADMIN-EXTRACT ATTEMPT: PASS (admin cannot read user-PIN-gated secrets)");
                ui::show_status("Admin extract", "PASS");
            }
            Err(_e) => {
                secure_log!("[S] [E2E-EXTRACT] ADMIN-EXTRACT ATTEMPT: FAIL ({:?})", _e);
                ui::show_status("Admin extract", "FAIL");
            }
        }
        loop { cortex_m::asm::wfi(); }
    }

    // ---- Dual-SE (OPTIGA + SE050) admin-wipe roundtrip e2e ----
    // Exercises `DualSecureElement::provision` + `DualSecureElement::
    // unlock` end-to-end on real silicon: pre-clean → provision →
    // unlock (XOR-reconstruct) → verify master_secret. Destroys any
    // existing wallet state on both chips during pre-clean.
    //
    // Scope: the XOR entropy reconstruction + master_secret cross-
    // verify across OPTIGA and SE050 — the unique dual-SE value-add
    // not covered by either single-SE test. The admin-wipe dispatch
    // is NOT exercised here; see `optiga-admin-wipe-e2e` and
    // `se050-admin-wipe-e2e` for those primitives individually.
    //
    // LcsO safety: does NOT imply `optiga-lock-operational`. SE050 has
    // no LcsO concept. Uses current production object ranges on both
    // chips (OPTIGA F1D0..F1D4 + F1E1; SE050 0x7B10_xxxx — v6, the
    // latest bumped range past every legacy stuck region).
    //
    // Triggered by: make dual-se-admin-wipe-e2e
    #[cfg(feature = "dual-se-admin-wipe-e2e")]
    unsafe {
        ui::show_status("Dual wipe", "running...");
        let se = &mut *core::ptr::addr_of_mut!(SE);
        match se.run_admin_wipe_roundtrip() {
            Ok(()) => {
                secure_log!("[S] [E2E-DUAL-ADMIN] DUAL-WIPE ROUNDTRIP: PASS");
                ui::show_status("Dual wipe", "PASS");
            }
            Err(_e) => {
                secure_log!("[S] [E2E-DUAL-ADMIN] DUAL-WIPE ROUNDTRIP: FAIL ({:?})", _e);
                ui::show_status("Dual wipe", "FAIL");
            }
        }
        loop { cortex_m::asm::wfi(); }
    }

    // Multi-unlock / cross-reboot test: provisions on first boot,
    // re-uses state on subsequent boots, runs 5 unlock+verify cycles
    // each boot. Pair with `make dual-se-multi-unlock-e2e` which
    // invokes probe-rs run 3× to force 3 cold reboots = 15 unlocks
    // across 3 boot sessions.
    #[cfg(feature = "dual-se-multi-unlock-e2e")]
    unsafe {
        ui::show_status("Dual multi-unlock", "running...");
        let se = &mut *core::ptr::addr_of_mut!(SE);
        let rc = match se.run_multi_unlock_roundtrip(5) {
            Ok(()) => {
                secure_log!("[S] [E2E-DUAL-MULTI] MULTI-UNLOCK ROUNDTRIP: PASS");
                ui::show_status("Dual multi-unlock", "PASS");
                cortex_m_semihosting::debug::EXIT_SUCCESS
            }
            Err(_e) => {
                secure_log!("[S] [E2E-DUAL-MULTI] MULTI-UNLOCK ROUNDTRIP: FAIL ({:?})", _e);
                ui::show_status("Dual multi-unlock", "FAIL");
                cortex_m_semihosting::debug::EXIT_FAILURE
            }
        };
        // SYS_EXIT: probe-rs sees ADP_Stopped_ApplicationExit and detaches
        // cleanly. Without this, probe-rs stays attached on `wfi` and the
        // USB interface isn't released for the next `probe-rs run` cycle.
        cortex_m_semihosting::debug::exit(rc);
        loop { cortex_m::asm::wfi(); }
    }

    // ---- PIN-gate roundtrip (MCU flash counter + gated_unlock) ----
    // Direct validation of the work-todo #4 Phase 1 dual-SE PIN lockout
    // sync fix. No buttons or USB UI required — hardcoded right/wrong
    // PINs drive `nsc::gated_unlock` through its happy and sad paths
    // while reading page 124 directly to verify the counter state.
    //
    // Flow:
    //   0. factory_reset_admin + pin_attempts_reset → known blank state.
    //      Verify pin_attempts_read() == 0.
    //   1. provision(entropy, master, vk, bvk, CORRECT_PIN) via
    //      WalletStore. Counter stays at 0 (provision doesn't gate).
    //   2. gated_unlock(WRONG_PIN) × 3. Each returns PinIncorrect.
    //      After each, assert pin_attempts_read() == 1, 2, 3.
    //   3. gated_unlock(CORRECT_PIN). Returns Ok(master_secret).
    //      Assert pin_attempts_read() == 0 (page erased on success).
    //   4. Repeat bump (× 2) + reset (correct PIN) to prove the
    //      counter cycle is repeatable, not a one-shot.
    //   5. Log PASS. Halts in WFI.
    //
    // Does NOT exhaust all 10 attempts — that would burn the SE050
    // user UserID's silicon retry budget (can't reset without
    // admin-auth deleting the UserID). Counter max + PinLocked path
    // is provable by inspection: the check in gated_unlock is a
    // simple `pre_count >= MAX_ATTEMPTS` comparison.
    //
    // Triggered by: make pin-gate-e2e
    #[cfg(feature = "pin-gate-e2e")]
    unsafe {
        use crate::secure_element::{UnlockError, WalletStore};

        ui::show_status("PIN gate", "running...");
        let se = &mut *core::ptr::addr_of_mut!(SE);

        // ── Step 0: known blank state ─────────────────────────────
        // Deliberately NO `factory_reset_admin` here — the production
        // wrapper erases page 125 as part of cleanup, and calling it
        // followed by `pin_attempts_reset` (page 124) triggered a flash-
        // timing window on this bench chip where a subsequent program
        // to page 125 QW0 returned PROGERR silently. The test just needs
        // the MCU counter cleared; SE cleanup is the provision path's job.
        let _ = hw::flash::pin_attempts_reset();
        let count0 = hw::flash::pin_attempts_read();
        if count0 != 0 {
            secure_log!("[PIN-GATE] step 0 FAILED: count after reset = {} (expected 0)", count0);
            ui::show_status("PIN gate", "FAIL: setup");
            loop { cortex_m::asm::wfi(); }
        }
        secure_log!("[PIN-GATE] step 0: blank state OK");

        // ── Step 1: provision with known-correct PIN ─────────────
        let test_entropy: [u8; 32] = [0x42; 32];
        let test_master = crypto::kdf(b"sphincs-master", &test_entropy, 0);
        let test_vk: [u8; 32] = [0xCC; 32];
        let test_bvk: [u8; 32] = [0xDD; 32];
        let correct_pin: [u8; 8] = *b"00000000";
        let wrong_pin: [u8; 8] = *b"99999999";

        if let Err(_e) = se.provision(&test_entropy, &test_master, &test_vk, &test_bvk, &correct_pin) {
            secure_log!("[PIN-GATE] step 1 FAILED: provision returned error");
            ui::show_status("PIN gate", "FAIL: prov");
            loop { cortex_m::asm::wfi(); }
        }
        secure_log!("[PIN-GATE] step 1: provision OK");

        // ── Step 2: 3× wrong-PIN, counter 0→1→2→3 ────────────────
        for expected in 1u8..=3 {
            match nsc::gated_unlock(se, &wrong_pin) {
                Err(UnlockError::PinIncorrect) => {}
                other => {
                    secure_log!(
                        "[PIN-GATE] step 2.{}: expected PinIncorrect, got {:?}",
                        expected, other.as_ref().err()
                    );
                    ui::show_status("PIN gate", "FAIL: bad-pin");
                    loop { cortex_m::asm::wfi(); }
                }
            }
            let c = hw::flash::pin_attempts_read();
            if c != expected {
                secure_log!("[PIN-GATE] step 2.{} FAILED: count={} expected {}", expected, c, expected);
                ui::show_status("PIN gate", "FAIL: counter");
                loop { cortex_m::asm::wfi(); }
            }
            secure_log!("[PIN-GATE] step 2.{}: wrong PIN → count={} OK", expected, c);
        }

        // ── Step 3: correct PIN resets counter to 0 ──────────────
        match nsc::gated_unlock(se, &correct_pin) {
            Ok(_master) => {}
            other => {
                secure_log!(
                    "[PIN-GATE] step 3 FAILED: expected Ok, got {:?}",
                    other.as_ref().err()
                );
                ui::show_status("PIN gate", "FAIL: good-pin");
                loop { cortex_m::asm::wfi(); }
            }
        }
        let c3 = hw::flash::pin_attempts_read();
        if c3 != 0 {
            secure_log!("[PIN-GATE] step 3 FAILED: count after success={} (expected 0)", c3);
            ui::show_status("PIN gate", "FAIL: reset");
            loop { cortex_m::asm::wfi(); }
        }
        secure_log!("[PIN-GATE] step 3: correct PIN → counter reset OK");

        // ── Step 4: another bump+reset cycle to prove repeatability ──
        for expected in 1u8..=2 {
            if !matches!(nsc::gated_unlock(se, &wrong_pin), Err(UnlockError::PinIncorrect)) {
                secure_log!("[PIN-GATE] step 4.{} FAILED: wrong PIN not rejected", expected);
                ui::show_status("PIN gate", "FAIL: cycle");
                loop { cortex_m::asm::wfi(); }
            }
            let c = hw::flash::pin_attempts_read();
            if c != expected {
                secure_log!("[PIN-GATE] step 4.{} FAILED: count={} expected {}", expected, c, expected);
                ui::show_status("PIN gate", "FAIL: cycle");
                loop { cortex_m::asm::wfi(); }
            }
        }
        if !matches!(nsc::gated_unlock(se, &correct_pin), Ok(_)) {
            secure_log!("[PIN-GATE] step 4 FAILED: second correct PIN rejected");
            ui::show_status("PIN gate", "FAIL: cycle");
            loop { cortex_m::asm::wfi(); }
        }
        let c4 = hw::flash::pin_attempts_read();
        if c4 != 0 {
            secure_log!("[PIN-GATE] step 4 FAILED: count after 2nd reset={} (expected 0)", c4);
            ui::show_status("PIN gate", "FAIL: cycle");
            loop { cortex_m::asm::wfi(); }
        }
        secure_log!("[PIN-GATE] step 4: second cycle OK");

        secure_log!("[S] [E2E-PIN-GATE] PIN-GATE ROUNDTRIP: PASS");
        ui::show_status("PIN gate", "PASS");
        loop { cortex_m::asm::wfi(); }
    }

    // ---- OPTIGA Trust M factory_reset roundtrip e2e ----
    // Exercises the `factory_reset` primitive end-to-end on real silicon:
    // provision F1D0..F1D4 + F1E1 with known test vectors, verify the
    // unlock path works, call `factory_reset`, then verify the counter
    // sentinel + `NotProvisioned` error + `check_provisioned() == false`
    // post-wipe contract.
    //
    // Scope: the factory_reset PRIMITIVE only — NOT the PIN-lockout
    // integration path that calls it (deferred to a later test).
    //
    // Destroys any wallet state on the chip because it uses the real
    // production OIDs (`factory_reset` hardcodes them). Re-run the real
    // first-boot wizard or `make flash-hw-optiga-unlock-test` afterwards
    // to restore. Idempotent across repeated runs on the same chip.
    //
    // Does NOT imply `optiga-lock-operational` → no LcsO ratcheting.
    //
    // Triggered by: make optiga-admin-wipe-e2e
    // ---- OPTIGA hardware PIN counter e2e test ----
    // Exercises the E120 LUC binding on F1D0. DESTRUCTIVE — rewrites
    // F1D0 metadata to the LUC variant on first run.
    //
    // Flow:
    //  1. Provision via WalletStore (runs store_objects which now
    //     provisions E120 before F1D0 with Exec=LUC(E120)).
    //  2. Read E120 — expect (0, HW_PIN_CTR_LIMIT).
    //  3. Wrong PIN → expect UnlockError::PinIncorrect AND E120.current == 1.
    //  4. Correct PIN → expect Ok(...) AND E120.current == 0 (reset on success).
    //  5. Two more wrong PINs → E120.current == 2.
    //  6. Correct PIN → E120.current == 0.
    //
    // On any unexpected state, loops wfi() with FAIL displayed.
    // Triggered by: make optiga-hw-counter-e2e
    #[cfg(feature = "optiga-hw-counter-e2e")]
    unsafe {
        use crate::secure_element::{UnlockError, WalletStore};

        ui::show_status("HW-CTR", "running...");
        let se = &mut *core::ptr::addr_of_mut!(SE);

        let test_entropy: [u8; 32] = [0x42; 32];
        let test_master = crypto::kdf(b"sphincs-master", &test_entropy, 0);
        let test_vk: [u8; 32] = [0xCC; 32];
        let test_bvk: [u8; 32] = [0xDD; 32];
        let correct_pin: [u8; 8] = *b"00000000";
        let wrong_pin: [u8; 8] = *b"99999999";

        macro_rules! fail { ($msg:expr) => {{
            secure_log!("[S] [E2E-OPTIGA-HW-CTR] FAIL: {}", $msg);
            ui::show_status("HW-CTR", "FAIL");
            loop { cortex_m::asm::wfi(); }
        }}}

        // ── Step 1: provision ────────────────────────────────────
        if let Err(_e) = se.provision(&test_entropy, &test_master, &test_vk, &test_bvk, &correct_pin) {
            fail!("provision returned error (chip state may be incompatible; optiga-reset-oids is retired — stop and preserve the part)");
        }
        secure_log!("[S] [E2E-OPTIGA-HW-CTR] step 1: provision OK");

        // ── Step 2: E120 initial state = (0, HW_PIN_CTR_LIMIT) ───
        let (c0, limit) = match se.read_hw_pin_counter() {
            Some(p) => p,
            None => fail!("read_hw_pin_counter returned None"),
        };
        if c0 != 0 || limit != optiga::OptigaTrustM::HW_PIN_CTR_LIMIT {
            secure_log!("[S] [E2E-OPTIGA-HW-CTR] step 2: E120 = ({},{}) expected (0,{})", c0, limit, optiga::OptigaTrustM::HW_PIN_CTR_LIMIT);
            fail!("initial E120 state wrong");
        }
        secure_log!("[S] [E2E-OPTIGA-HW-CTR] step 2: E120 initial = (0,{}) OK", limit);

        // ── Step 3: wrong PIN bumps E120 ─────────────────────────
        match se.unlock(&wrong_pin) {
            Err(UnlockError::PinIncorrect) => {}
            other => { secure_log!("[S] [E2E-OPTIGA-HW-CTR] step 3: wrong PIN got {:?}", other.as_ref().err()); fail!("wrong PIN not rejected"); }
        }
        let (c1, _) = se.read_hw_pin_counter().unwrap_or((0xFFFF_FFFF, 0));
        if c1 != 1 {
            secure_log!("[S] [E2E-OPTIGA-HW-CTR] step 3: E120.current={} expected 1", c1);
            fail!("E120 did not bump after wrong PIN");
        }
        secure_log!("[S] [E2E-OPTIGA-HW-CTR] step 3: wrong PIN → E120.current=1 OK");

        // ── Step 4: correct PIN resets E120 ──────────────────────
        match se.unlock(&correct_pin) {
            Ok(_) => {}
            other => { secure_log!("[S] [E2E-OPTIGA-HW-CTR] step 4: correct PIN got {:?}", other.as_ref().err()); fail!("correct PIN rejected"); }
        }
        let (c4, _) = se.read_hw_pin_counter().unwrap_or((0xFFFF_FFFF, 0));
        if c4 != 0 {
            secure_log!("[S] [E2E-OPTIGA-HW-CTR] step 4: E120.current={} expected 0", c4);
            fail!("E120 not reset after correct PIN");
        }
        secure_log!("[S] [E2E-OPTIGA-HW-CTR] step 4: correct PIN → E120 reset to 0 OK");

        // ── Step 5: two wrong PINs in a row ──────────────────────
        for i in 1u32..=2 {
            if !matches!(se.unlock(&wrong_pin), Err(UnlockError::PinIncorrect)) {
                fail!("wrong PIN not rejected in burst");
            }
            let (c, _) = se.read_hw_pin_counter().unwrap_or((0xFFFF_FFFF, 0));
            if c != i {
                secure_log!("[S] [E2E-OPTIGA-HW-CTR] step 5.{}: E120.current={} expected {}", i, c, i);
                fail!("E120 mismatch during burst");
            }
        }
        secure_log!("[S] [E2E-OPTIGA-HW-CTR] step 5: burst 2 wrong PINs → E120.current=2 OK");

        // ── Step 6: second correct PIN resets again ──────────────
        if !matches!(se.unlock(&correct_pin), Ok(_)) {
            fail!("second correct PIN rejected");
        }
        let (c6, _) = se.read_hw_pin_counter().unwrap_or((0xFFFF_FFFF, 0));
        if c6 != 0 {
            fail!("E120 not reset on repeat correct PIN");
        }
        secure_log!("[S] [E2E-OPTIGA-HW-CTR] step 6: repeat correct PIN → E120 reset OK");

        secure_log!("[S] [E2E-OPTIGA-HW-CTR] HW-COUNTER ROUNDTRIP: PASS");
        ui::show_status("HW-CTR", "PASS");
        loop { cortex_m::asm::wfi(); }
    }

    // ---- §32 duress-PIN feasibility probe ----
    // Validates the load-bearing on-silicon assumptions for the duress
    // PIN → decoy wallet design (work-todo §32) BEFORE committing the
    // multi-session build:
    //   * OPTIGA: a SECOND AuthRef at a free OID (F1D8) with Execute=ALW
    //     (no E120/LUC binding) coexists with the real F1D0, auths
    //     independently, and crucially leaves E120 UNTOUCHED (so the
    //     duress credential never bumps the silicon lockout counter).
    //     Then confirms the real F1D0 still bumps/resets E120 — i.e.
    //     adding F1D8 didn't break the real lockout.
    //   * SE050: a SECOND UserID (max_attempts=0, unlimited) provisions
    //     + auths — i.e. an unlimited duress credential coexists with
    //     the real user UserID (the production admin UserID already
    //     proves this shape; this is a direct confirmation).
    //
    // STAYS LcsO=Creation throughout — never locks an OID, every
    // credential remains re-writable / recoverable. Reprovisions the
    // bench chips with test data (like optiga-hw-counter-e2e). Does NOT
    // touch the real F1D0..F1D5 contents beyond the normal provision.
    //
    // Triggered by: make duress-probe-hw
    #[cfg(feature = "duress-probe-e2e")]
    unsafe {
        use crate::secure_element::{UnlockError, WalletStore};

        ui::show_status("DURESS-PROBE", "running");
        let se = &mut *core::ptr::addr_of_mut!(SE);

        let test_entropy: [u8; 32] = [0x42; 32];
        let test_master = crypto::kdf(b"sphincs-master", &test_entropy, 0);
        let test_vk: [u8; 32] = [0xCC; 32];
        let test_bvk: [u8; 32] = [0xDD; 32];
        let real_pin: [u8; 8] = *b"00000000";
        let wrong_pin: [u8; 8] = *b"99999999";
        let duress_pin: [u8; 8] = *b"11111111";

        // F1D8: free type-3 OID (F1D0..F1D5 used, F1D6..F1DB free) —
        // mirrors apdu::OID_DURESS_AUTH_REF_PROBE.
        const DURESS_AUTHREF_OID: u16 = 0xF1D8;
        // Fresh SE050 OID range for the probe's duress UserID.
        const DURESS_USERID_OBJ: u32 = 0x7B0D_0000;

        macro_rules! fail {
            ($msg:expr) => {{
                secure_log!("[S] [DURESS-PROBE] FAIL: {}", $msg);
                ui::show_status("DURESS", "FAIL");
                // Clean SYS_EXIT so probe-rs detaches + flushes (the run
                // is piped; without this it block-buffers + wfi-loops).
                cortex_m_semihosting::debug::exit(cortex_m_semihosting::debug::EXIT_FAILURE);
                loop {
                    cortex_m::asm::wfi();
                }
            }};
        }

        // Step 1: provision the real wallet (F1D0 + E120 + SE050 user UserID).
        if se
            .provision(&test_entropy, &test_master, &test_vk, &test_bvk, &real_pin)
            .is_err()
        {
            fail!("real provision failed (chip state may be incompatible; optiga-reset-oids is retired — stop and preserve the part)");
        }
        secure_log!("[S] [DURESS-PROBE] step 1: real provision OK");

        // ===== OPTIGA: second AuthRef at F1D8, no E120 binding =====
        let (e0, _) = match se.optiga.read_hw_pin_counter() {
            Some(p) => p,
            None => fail!("E120 read returned None"),
        };
        secure_log!("[S] [DURESS-PROBE] step 2: E120 baseline = {}", e0);

        if se
            .optiga
            .probe_provision_duress_authref(DURESS_AUTHREF_OID, &duress_pin)
            .is_err()
        {
            fail!("OPTIGA duress AuthRef provision at F1D8 failed (F1D8 may be locked)");
        }
        secure_log!("[S] [DURESS-PROBE] step 3: OPTIGA F1D8 duress AuthRef provisioned (Execute=ALW, no lock) OK");

        let (e1, _) = se.optiga.read_hw_pin_counter().unwrap_or((0xFFFF_FFFF, 0));
        if e1 != e0 {
            secure_log!("[S] [DURESS-PROBE] step 4: E120 {}→{} during F1D8 provision", e0, e1);
            fail!("E120 moved while provisioning F1D8");
        }
        secure_log!("[S] [DURESS-PROBE] step 4: E120 unchanged ({}) by F1D8 provision OK", e1);

        if se
            .optiga
            .probe_hmac_auth_at(DURESS_AUTHREF_OID, &duress_pin)
            .is_err()
        {
            fail!("OPTIGA F1D8 duress HMAC auth failed");
        }
        secure_log!("[S] [DURESS-PROBE] step 5: OPTIGA F1D8 duress auth OK");

        let (e2, _) = se.optiga.read_hw_pin_counter().unwrap_or((0xFFFF_FFFF, 0));
        if e2 != e0 {
            secure_log!("[S] [DURESS-PROBE] step 6: E120={} expected {} — F1D8 auth BUMPED E120", e2, e0);
            fail!("F1D8 auth touched E120 (unexpected LUC coupling)");
        }
        secure_log!("[S] [DURESS-PROBE] step 6: E120 STILL unchanged ({}) after F1D8 auth — no LUC coupling OK", e2);

        // Real F1D0 still bumps E120 on wrong PIN (coexistence intact).
        match se.optiga.unlock(&wrong_pin) {
            Err(UnlockError::PinIncorrect) => {}
            other => {
                secure_log!("[S] [DURESS-PROBE] step 7: real wrong PIN got {:?}", other.as_ref().err());
                fail!("real F1D0 wrong-PIN not rejected after F1D8 added");
            }
        }
        let (e3, _) = se.optiga.read_hw_pin_counter().unwrap_or((0xFFFF_FFFF, 0));
        if e3 != e0 + 1 {
            secure_log!("[S] [DURESS-PROBE] step 7: E120={} expected {}", e3, e0 + 1);
            fail!("real F1D0 wrong PIN didn't bump E120 with F1D8 present");
        }
        secure_log!("[S] [DURESS-PROBE] step 7: real F1D0 wrong PIN → E120 {}→{} (coexistence intact) OK", e0, e3);

        // Real F1D0 correct PIN resets E120.
        if se.optiga.unlock(&real_pin).is_err() {
            fail!("real F1D0 correct PIN rejected after F1D8 added");
        }
        let (e4, _) = se.optiga.read_hw_pin_counter().unwrap_or((0xFFFF_FFFF, 0));
        if e4 != 0 {
            fail!("E120 not reset after real correct PIN");
        }
        secure_log!("[S] [DURESS-PROBE] step 8: real F1D0 correct PIN → E120 reset to 0 OK");

        // ===== SE050: second unlimited UserID =====
        if se
            .se050
            .probe_provision_and_auth_duress_userid(DURESS_USERID_OBJ, &duress_pin)
            .is_err()
        {
            fail!("SE050 duress UserID (unlimited) provision+auth failed");
        }
        secure_log!("[S] [DURESS-PROBE] step 9: SE050 duress UserID (max_attempts=0) provisioned + auth'd, coexists with real UserID OK");

        // ===== Timing-channel measurement (§32 P3 decision) =====
        // The drift problem only exists IF we must run BOTH SE verifies
        // on every unlock for timing uniformity. Measure the latency of
        // the "extra real verify" (one OPTIGA HMAC verify + one SE050
        // UserID verify) — the maximum timing signal an attacker gets
        // from skip-vs-run on a duress entry. Compare to the
        // keygen-dominated total unlock (~1-3 s). If it's a tiny
        // fraction + below keygen jitter, timing uniformity is NOT
        // load-bearing → skip the real verify on a duress match → the
        // counter drift dissolves entirely (no E120 reset needed).
        //
        // hprintln! (not secure_log!) so the numbers print even with
        // debug-log OFF — run `make duress-timing-hw` for clean,
        // production-speed numbers (no per-I²C-transaction logging).
        {
            use cortex_m_semihosting::hprintln;
            // Enable the DWT cycle counter (not yet armed this early in boot).
            core::ptr::write_volatile(
                0xE000_EDFC as *mut u32,
                core::ptr::read_volatile(0xE000_EDFC as *const u32) | (1 << 24),
            );
            core::ptr::write_volatile(0xE000_1FB0 as *mut u32, 0xC5AC_CE55);
            core::ptr::write_volatile(0xE000_1004 as *mut u32, 0);
            core::ptr::write_volatile(
                0xE000_1000 as *mut u32,
                core::ptr::read_volatile(0xE000_1000 as *const u32) | 1,
            );
            let cyc = || core::ptr::read_volatile(0xE000_1004 as *const u32);
            const NT: u32 = 15;
            const HZ_PER_US: u32 = 160; // 160 MHz

            // OPTIGA single HMAC verify (F1D8 auth — same APDU shape as
            // the real F1D0 verify a duress entry would run).
            let (mut o_sum, mut o_min, mut o_max) = (0u32, u32::MAX, 0u32);
            for _ in 0..NT {
                let t0 = cyc();
                let _ = se.optiga.probe_hmac_auth_at(DURESS_AUTHREF_OID, &duress_pin);
                let d = cyc().wrapping_sub(t0);
                o_sum += d;
                if d < o_min { o_min = d; }
                if d > o_max { o_max = d; }
            }
            let o_mean_us = (o_sum / NT) / HZ_PER_US;
            hprintln!(
                "[DURESS-TIMING] OPTIGA verify (F1D8 PLAIN): mean {} us / min {} us / max {} us (n={})",
                o_mean_us, o_min / HZ_PER_US, o_max / HZ_PER_US, NT
            );

            // OPTIGA real F1D0 verify via the LUC AUTO-STATE path (the
            // production real-verify, the thing a duress entry skips).
            // Compare to the F1D8 PLAIN verify above: if they match, the
            // option-B "second duress verify" pad is a clean stand-in;
            // if they differ materially, the duress credential needs its
            // own LUC counter so its verify uses the same auto-state path.
            // (Each call fires the E120 LUC; NT=15 < HW_PIN_CTR_LIMIT=32.)
            let (mut a_sum, mut a_min, mut a_max) = (0u32, u32::MAX, 0u32);
            for _ in 0..NT {
                let t0 = cyc();
                let _ = se
                    .optiga
                    .probe_hmac_auth_luc_at(optiga::apdu::OID_AUTH_REF, &real_pin);
                let d = cyc().wrapping_sub(t0);
                a_sum += d;
                if d < a_min { a_min = d; }
                if d > a_max { a_max = d; }
            }
            let a_mean_us = (a_sum / NT) / HZ_PER_US;
            hprintln!(
                "[DURESS-TIMING] OPTIGA verify (F1D0 AUTO-STATE/LUC): mean {} us / min {} us / max {} us (n={})",
                a_mean_us, a_min / HZ_PER_US, a_max / HZ_PER_US, NT
            );
            let delta = if a_mean_us > o_mean_us { a_mean_us - o_mean_us } else { o_mean_us - a_mean_us };
            hprintln!(
                "[DURESS-TIMING] plain-vs-auto-state DELTA: {} us — if <~20000 us (20 ms) the plain F1D8 pad is clean; else use a matched-LUC duress credential",
                delta
            );

            // SE050 single UserID verify (create_session + verify + close).
            let (mut s_sum, mut s_min, mut s_max) = (0u32, u32::MAX, 0u32);
            for _ in 0..NT {
                let t0 = cyc();
                let _ = se
                    .se050
                    .probe_auth_existing_userid(DURESS_USERID_OBJ, &duress_pin);
                let d = cyc().wrapping_sub(t0);
                s_sum += d;
                if d < s_min { s_min = d; }
                if d > s_max { s_max = d; }
            }
            let s_mean_us = (s_sum / NT) / HZ_PER_US;
            hprintln!(
                "[DURESS-TIMING] SE050 verify: mean {} us / min {} us / max {} us (n={})",
                s_mean_us, s_min / HZ_PER_US, s_max / HZ_PER_US, NT
            );

            let extra_us = o_mean_us + s_mean_us;
            hprintln!(
                "[DURESS-TIMING] EXTRA real-verify cost (skip vs run on duress): ~{} us total",
                extra_us
            );
            hprintln!(
                "[DURESS-TIMING] => ~{} % of a 2,000,000 us (2 s) keygen-dominated unlock",
                (extra_us.saturating_mul(100)) / 2_000_000
            );
            hprintln!("[DURESS-TIMING] verdict input: if this %% is tiny + below keygen jitter, timing uniformity is NOT load-bearing → skip real verify on duress → no drift");
        }

        // ===== Step 10: matched-LUC dual-counter coexistence =====
        // §32 DECIDED 2026-05-20: null the ~11 ms plain-vs-auto-state
        // residual by binding the duress AuthRef (F1D8) to its OWN LUC
        // counter (E121). This RE-PROVISIONS F1D8 with Execute=LUC(E121),
        // overwriting the plain (Execute=ALW) variant from steps 3–6 +
        // the timing block above — allowed because F1D8 Change=ALW (still
        // LcsO=Creation). Runs AFTER the timing block so the plain-F1D8
        // measurement above stays valid. The delta to validate vs the
        // already-proven single-LUC + plain-F1D8 coexistence: (a) two
        // LUC-bound AuthRefs (F1D0→E120, F1D8→E121) coexist; (b) a duress
        // auto-state verify bumps ONLY E121, leaving the real E120
        // untouched (no drift); (c) F1D8 auto-state timing is a twin of
        // F1D0 auto-state (~0 residual).
        const DURESS_CTR_OID: u16 = 0xE121;
        const DURESS_CTR_LIMIT: u32 = 0xFFFF; // unenforced; high so the probe never trips it
        if se
            .optiga
            .probe_provision_duress_authref_luc(
                DURESS_AUTHREF_OID, DURESS_CTR_OID, DURESS_CTR_LIMIT, &duress_pin,
            )
            .is_err()
        {
            fail!("matched-LUC duress provision (F1D8→E121) failed (dual-LUC coexistence broken?)");
        }
        secure_log!("[S] [DURESS-PROBE] step 10: F1D8 re-provisioned Execute=LUC(E121) + E121 counter OK");

        // Read both counters pre-verify (a correct real PIN in step 8
        // already reset E120 to 0; the timing block then bumped it by NT).
        let e120_pre = se.optiga.read_hw_pin_counter().map(|(c, _)| c).unwrap_or(u32::MAX);
        let e121_pre = se.optiga.probe_read_counter(DURESS_CTR_OID).map(|(c, _)| c).unwrap_or(u32::MAX);
        secure_log!("[S] [DURESS-PROBE] step 10: pre-verify E120={} E121={}", e120_pre, e121_pre);
        if e120_pre == u32::MAX || e121_pre == u32::MAX {
            fail!("could not read E120/E121 counters before duress auto-state verify");
        }

        // One auto-state verify against the matched-LUC duress credential.
        if se
            .optiga
            .probe_hmac_auth_luc_at(DURESS_AUTHREF_OID, &duress_pin)
            .is_err()
        {
            fail!("matched-LUC duress auto-state verify (F1D8) failed");
        }

        let e120_post = se.optiga.read_hw_pin_counter().map(|(c, _)| c).unwrap_or(u32::MAX);
        let e121_post = se.optiga.probe_read_counter(DURESS_CTR_OID).map(|(c, _)| c).unwrap_or(u32::MAX);
        secure_log!("[S] [DURESS-PROBE] step 10: post-verify E120={} E121={}", e120_post, e121_post);
        if e120_post != e120_pre {
            secure_log!("[S] [DURESS-PROBE] step 10: E120 {}→{} — duress verify DRIFTED the real counter", e120_pre, e120_post);
            fail!("duress auto-state verify bumped real E120 (matched-LUC isolation broken)");
        }
        if e121_post != e121_pre + 1 {
            secure_log!("[S] [DURESS-PROBE] step 10: E121 {}→{} expected {}", e121_pre, e121_post, e121_pre + 1);
            fail!("duress auto-state verify did not bump E121 by exactly 1 (LUC not firing on F1D8)");
        }
        secure_log!("[S] [DURESS-PROBE] step 10: matched-LUC OK — duress verify bumped ONLY E121 ({}→{}), E120 untouched ({}) — no drift", e121_pre, e121_post, e120_post);

        // ===== Timing twin: F1D8 AUTO-STATE (matched-LUC) =====
        // Confirm the duress verify via its OWN LUC counter is a timing
        // twin of the real F1D0 auto-state verify (the thing the duress
        // path pads/skips). If they match, the residual is nulled.
        {
            use cortex_m_semihosting::hprintln;
            let cyc = || core::ptr::read_volatile(0xE000_1004 as *const u32);
            const NT: u32 = 15;
            const HZ_PER_US: u32 = 160;
            let (mut d_sum, mut d_min, mut d_max) = (0u32, u32::MAX, 0u32);
            for _ in 0..NT {
                let t0 = cyc();
                let _ = se.optiga.probe_hmac_auth_luc_at(DURESS_AUTHREF_OID, &duress_pin);
                let d = cyc().wrapping_sub(t0);
                d_sum += d;
                if d < d_min { d_min = d; }
                if d > d_max { d_max = d; }
            }
            hprintln!(
                "[DURESS-TIMING] OPTIGA verify (F1D8 AUTO-STATE/matched-LUC): mean {} us / min {} us / max {} us (n={}) — compare to F1D0 AUTO-STATE above; ~0 delta = residual nulled",
                (d_sum / NT) / HZ_PER_US, d_min / HZ_PER_US, d_max / HZ_PER_US, NT
            );
        }

        secure_log!("[S] [DURESS-PROBE] === DURESS COEXISTENCE PROBE: PASS ===");
        secure_log!("[S] [DURESS-PROBE] verdict: OPTIGA 2nd AuthRef (no-LUC) + SE050 2nd unlimited UserID both coexist — §32 design feasible");
        ui::show_status("DURESS", "PASS");
        cortex_m_semihosting::debug::exit(cortex_m_semihosting::debug::EXIT_SUCCESS);
        loop {
            cortex_m::asm::wfi();
        }
    }

    // ---- §32 P2: full production provision_duress silicon validation ----
    // Provisions a real wallet + an independent decoy via the PRODUCTION
    // store.provision / store.provision_duress path (KNOWN decoy entropy),
    // then proves the decoy is recoverable + correctly gated + isolated:
    //   - duress_is_provisioned() && is_provisioned() both true
    //   - read OPTIGA decoy half (auth F1D8 auto-state, bumps E121) and
    //     SE050 decoy half (auth duress UserID); half_o XOR half_e MUST
    //     equal the known decoy entropy (mirrors the real unlock cross-check)
    //   - the OPTIGA decoy read bumped ONLY E121, left real E120 untouched
    //   - the real wallet still unlocks with the real PIN (coexistence)
    // Everything stays LcsO=Creation. Run: make duress-provision-hw
    #[cfg(feature = "duress-provision-e2e")]
    unsafe {
        use crate::secure_element::WalletStore;
        let se = &mut *core::ptr::addr_of_mut!(SE);
        se.load_pbs();
        ui::show_status("DURESS-PROV", "running");

        macro_rules! fail {
            ($msg:expr) => {{
                secure_log!("[S] [DURESS-PROV] FAIL: {}", $msg);
                ui::show_status("DURESS-PROV", "FAIL");
                cortex_m_semihosting::debug::exit(cortex_m_semihosting::debug::EXIT_FAILURE);
                loop { cortex_m::asm::wfi(); }
            }};
        }

        // Fixtures.
        let real_entropy: [u8; 32] = [0x42; 32];
        let real_pin: [u8; 8] = *b"00000000";
        let decoy_entropy: [u8; 32] = [0x7e; 32];
        let duress_pin: [u8; 8] = *b"99999999";

        let real_master = crypto::kdf(b"sphincs-master", &real_entropy, 0);
        let (rsk, real_vk) = crypto::derive_keypair_from_entropy(&real_entropy);
        drop(rsk);
        let real_bvk = crypto::derive_bootstrap_vk_from_entropy(&real_entropy);

        let decoy_master = crypto::kdf(b"sphincs-master", &decoy_entropy, 0);
        let (dsk, decoy_vk) = crypto::derive_keypair_from_entropy(&decoy_entropy);
        drop(dsk);
        let decoy_bvk = crypto::derive_bootstrap_vk_from_entropy(&decoy_entropy);

        // 1. Provision the real wallet (production path).
        if se.provision(&real_entropy, &real_master, &real_vk, &real_bvk, &real_pin).is_err() {
            fail!("real wallet provision failed");
        }
        secure_log!("[S] [DURESS-PROV] step 1: real wallet provisioned OK");

        // 2. Provision the decoy (production path; DualSE XOR-splits it).
        if se.provision_duress(&decoy_entropy, &decoy_master, &decoy_vk, &decoy_bvk, &duress_pin).is_err() {
            fail!("provision_duress failed");
        }
        secure_log!("[S] [DURESS-PROV] step 2: decoy wallet provisioned OK");

        // 3. Both provisioned.
        if !se.is_provisioned() { fail!("is_provisioned() false after provision"); }
        if !se.duress_is_provisioned() { fail!("duress_is_provisioned() false after provision_duress"); }
        secure_log!("[S] [DURESS-PROV] step 3: is_provisioned + duress_is_provisioned both true OK");

        // 4. Counter baselines before the OPTIGA decoy read.
        let e120_pre = se.optiga.read_hw_pin_counter().map(|(c, _)| c).unwrap_or(u32::MAX);
        let e121_pre = se.optiga.probe_read_counter(optiga::apdu::OID_PIN_CTR_DURESS).map(|(c, _)| c).unwrap_or(u32::MAX);
        if e120_pre == u32::MAX || e121_pre == u32::MAX { fail!("counter read failed pre decoy-read"); }
        secure_log!("[S] [DURESS-PROV] step 4: pre-read E120={} E121={}", e120_pre, e121_pre);

        // 5. Read the OPTIGA decoy half (auths F1D8, fires LUC(E121)).
        let half_o = match se.optiga.duress_read_half(&duress_pin) {
            Ok((h, _stored_master)) => h,
            Err(e) => { secure_log!("[S] [DURESS-PROV] optiga.duress_read_half err {:?}", e); fail!("OPTIGA decoy read/auth failed"); }
        };

        // 6. Isolation: E120 untouched, E121 bumped by exactly 1.
        let e120_post = se.optiga.read_hw_pin_counter().map(|(c, _)| c).unwrap_or(u32::MAX);
        let e121_post = se.optiga.probe_read_counter(optiga::apdu::OID_PIN_CTR_DURESS).map(|(c, _)| c).unwrap_or(u32::MAX);
        secure_log!("[S] [DURESS-PROV] step 6: post-read E120={} E121={}", e120_post, e121_post);
        if e120_post != e120_pre { fail!("decoy read drifted real E120"); }
        // duress_read_half fires LUC(E121) then RESETS it to 0 (F1D8
        // auth-state active) — so post-read E121 must be 0, proving both
        // the LUC fired AND the duress-side reset works.
        if e121_post != 0 { fail!("decoy read did not reset E121 to 0"); }
        let _ = e121_pre;
        secure_log!("[S] [DURESS-PROV] step 6: isolation OK (E121 reset to 0, E120 untouched)");

        // 7. Read the SE050 decoy half.
        let half_e = match se.se050.duress_read_half(&duress_pin) {
            Ok(h) => h,
            Err(e) => { secure_log!("[S] [DURESS-PROV] se050.duress_read_half err {:?}", e); fail!("SE050 decoy read/auth failed"); }
        };
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
