DankGecko/pq1/secure/src/dual_se.rs

//! Dual-SE XOR entropy split: OPTIGA Trust M + SE050.
//!
//! The 32-byte BIP-39 entropy is XOR-split into two halves:
//!   `half_O` (stored on OPTIGA Trust M) and `half_E` (stored on SE050).
//! Neither chip alone reveals any bit of the seed.
//!
//! On unlock, both SEs are PIN-verified independently (hardware-gated),
//! the halves are fetched, and the full entropy is reconstructed:
//!   `entropy = half_O XOR half_E`
//!
//! The master_secret is derived from the full entropy:
//!   `master_secret = KDF("sphincs-master", entropy, 0)`
//!
//! Both SEs store the same master_secret (encrypted under their own
//! per-SE PIN scheme) so we can cross-verify: if the two don't match,
//! one chip has been tampered with.

use crate::crypto;
use crate::optiga::OptigaTrustM;
use crate::se050::Se050;
use crate::secure_element::{SeError, UnlockError, WalletStore};
use subtle::ConstantTimeEq;
use zeroize::{Zeroize, Zeroizing};

/// XOR two 32-byte arrays. Inherently constant-time.
fn xor_32(a: &[u8; 32], b: &[u8; 32]) -> [u8; 32] {
    let mut out = [0u8; 32];
    for i in 0..32 {
        out[i] = a[i] ^ b[i];
    }
    out
}

/// Dual secure element wrapper.
///
/// Manages XOR-split entropy across OPTIGA Trust M (half_O) and SE050 (half_E).
/// Both SEs run their own PIN verification (hardware-gated); the master
/// secret returned by each must match (derived from the same full entropy).
pub struct DualSecureElement {
    pub optiga: OptigaTrustM,
    pub se050: Se050,
    /// Cached encrypted entropy blob (full entropy encrypted under master_secret).
    /// Used by the signing flow to avoid re-authenticating per sign.
    entropy_blob_cache: [u8; crypto::ENTROPY_BLOB_LEN],
    blob_cached: crate::fih::FihBool,
}

impl DualSecureElement {
    pub const fn new() -> Self {
        Self {
            optiga: OptigaTrustM::new(),
            se050: Se050::new(),
            entropy_blob_cache: [0; crypto::ENTROPY_BLOB_LEN],
            blob_cached: crate::fih::FihBool::new_false(),
        }
    }

    /// Load Platform Binding Secret for OPTIGA Trust M (delegates to inner driver).
    pub fn load_pbs(&mut self) {
        self.optiga.load_pbs();
    }

    /// Bring-up transport OPTIGA E140 pairing, run before the legacy seed
    /// wizard draws entropy — see `OptigaTrustM::pair_for_first_boot` for why
    /// (mandatory `ensure_shield` in `random()` needs a paired chip). This is
    /// not the production-final fresh-TRNG rotation or E140 lock ceremony.
    /// The OPTIGA-level error detail is logged by the inner driver;
    /// callers only branch on success.
    pub fn pair_optiga_for_first_boot(&mut self) -> Result<(), SeError> {
        self.optiga
            .pair_for_first_boot()
            .map_err(|_| SeError::InternalError)
    }

    /// Generate a fresh OPTIGA-side XOR half via a 3-source TRNG mix
    /// (STM32 ⊕ OPTIGA ⊕ SE050). The security of the dual-SE split
    /// depends critically on this half being unpredictable: if an
    /// attacker recovers the SE050 half (or guesses this one), they
    /// reconstruct the seed by XOR. Mixing three sources means any single
    /// unbroken source preserves entropy.
    ///
    /// Uses the explicit-handle `rng_strong::fill_with_store` path so holding
    /// `&mut self` never re-enters the global SE singleton. That path obtains
    /// and validates the two chip streams separately before folding either.
    ///
    /// Both-or-fail (finding F1): each SE's `random()` contribution is
    /// mandatory — a failed read aborts provisioning rather than being
    /// silently dropped. The previous `if …is_ok()` mixing let `half_o`
    /// degrade to the platform TRNG alone when both SE reads failed or were
    /// glitched: an attacker who influenced the STM32 TRNG and later extracted
    /// the SE050 half could then recover the full seed (`half_E XOR half_O`),
    /// defeating invariant #1. This matches the strict semantics of
    /// `DualSecureElement::random`. Also fail-closed on an all-zero result
    /// (stuck-at-0 fault surviving all three sources).
    fn generate_split_half(&mut self) -> Result<[u8; 32], SeError> {
        // `half_o` = the OPTIGA-side half in both the real and decoy
        // splits (the SE050 half is `entropy XOR half_o`).
        let mut half_o = [0u8; 32];
        if crate::rng_strong::fill_with_store(&mut half_o, self).is_err() {
            secure_log!(
                "[DUAL/prov] strict STM32+OPTIGA+SE050 draw FAILED — refusing degraded split"
            );
            half_o.zeroize();
            return Err(SeError::InternalError);
        }
        Ok(half_o)
    }

    /// Wipe the OPTIGA side of a dual-SE store, supplying the legacy E120
    /// reset path with a strict three-source transient authorization value.
    /// A failed source skips only that optional counter reset; the underlying
    /// OPTIGA wipe still runs without a weaker replacement secret.
    pub(crate) fn reset_optiga_for_admin(&mut self) -> Result<(), SeError> {
        #[cfg(all(feature = "optiga-hw-counter", not(feature = "optiga-lock-operational")))]
        let result = {
            let mut transient_secret = Zeroizing::new([0u8; 32]);
            let result = if crate::rng_strong::fill_with_store(&mut *transient_secret, self)
                .is_ok()
            {
                self.optiga
                    .factory_reset_with_transient_secret(&mut *transient_secret)
                    .map_err(|_| SeError::InternalError)
            } else {
                secure_log!(
                    "[DUAL] strict transient-auth RNG failed — skipping optional \
                     OPTIGA E120 reset; continuing best-effort wipe"
                );
                self.optiga.factory_reset_admin()
            };
            transient_secret.zeroize();
            crate::fi::zeroize_barrier();
            result
        };
        #[cfg(not(all(feature = "optiga-hw-counter", not(feature = "optiga-lock-operational"))))]
        let result = self.optiga.factory_reset_admin();
        result
    }
}

impl WalletStore for DualSecureElement {
    fn is_provisioned(&mut self) -> bool {
        self.optiga.is_provisioned() && self.se050.is_provisioned()
    }

    fn provision(
        &mut self,
        entropy: &[u8; 32],
        master_secret: &[u8; 32],
        vk: &[u8; 32],
        bootstrap_vk: &[u8; 32],
        pin: &[u8; 8],
    ) -> Result<(), SeError> {
        secure_log!("[DUAL/prov] start");

        // Keep every reconstructing split-half copy in an auto-wiping wrapper.
        // This closure is intentional: all four wrappers drop before the
        // barrier below on success, either SE provisioning error, or either
        // optional ML-KEM sealing error. Returning directly from one of those
        // branches must never leave a raw half live on the stack.
        let provision_result = (|| -> Result<(), SeError> {
            let half_o = Zeroizing::new(self.generate_split_half()?);
            secure_log!("[DUAL/prov] rng OK (3-source XOR mix), calling optiga.provision");
            let half_e = Zeroizing::new(xor_32(entropy, &half_o));

            // Under the ML-KEM hybrid inner wrap (#28), seal each half BEFORE it
            // crosses I²C: the SE stores the 32-byte AES-GCM ciphertext (object
            // size unchanged), and the 1568-byte ML-KEM ct + 16-byte tag go to
            // the ct-store. Without the feature the direct-half flow remains
            // byte-for-byte identical; the two Copy aliases are also Zeroizing.
            #[cfg(feature = "mlkem-inner-wrap")]
            let (se_half_o, se_half_e) = (
                Zeroizing::new(
                    crate::pq_wrap::seal_half_for_se(
                        crate::pq_wrap::HalfId::OptigaHalfO,
                        0,
                        &half_o,
                    )
                    .map_err(|_| SeError::InternalError)?,
                ),
                Zeroizing::new(
                    crate::pq_wrap::seal_half_for_se(
                        crate::pq_wrap::HalfId::Se050HalfE,
                        0,
                        &half_e,
                    )
                    .map_err(|_| SeError::InternalError)?,
                ),
            );
            #[cfg(not(feature = "mlkem-inner-wrap"))]
            let (se_half_o, se_half_e) =
                (Zeroizing::new(*half_o), Zeroizing::new(*half_e));

            // Both SEs get the same master_secret (derived from full entropy).
            // This lets us cross-verify on unlock.
            //
            // OPTIGA Trust M stores its half-object + master_secret behind the
            // HMAC auth reference PIN gate; SE050 stores its half-object behind
            // hardware UserID PIN gating. The VK and bootstrap VK are identical
            // on both chips.
            if let Err(e) =
                self.optiga
                    .provision(&se_half_o, master_secret, vk, bootstrap_vk, pin)
            {
                secure_log!("[DUAL/prov] optiga.provision FAILED: {:?}", e);
                return Err(e);
            }
            secure_log!("[DUAL/prov] optiga OK, calling se050.provision");
            if let Err(e) =
                self.se050
                    .provision(&se_half_e, master_secret, vk, bootstrap_vk, pin)
            {
                secure_log!("[DUAL/prov] se050.provision FAILED: {:?}", e);
                return Err(e);
            }
            Ok(())
        })();

        // The closure's Zeroizing locals have dropped on every exit. Keep an
        // explicit compiler barrier at the security boundary before exposing
        // its Result to the caller.
        crate::fi::zeroize_barrier();
        provision_result?;

        secure_log!("[DUAL] Provisioned: entropy XOR-split across OPTIGA Trust M + SE050");
        Ok(())
    }

    #[cfg(feature = "duress-pin")]
    fn provision_duress(
        &mut self,
        entropy: &[u8; 32],
        master_secret: &[u8; 32],
        vk: &[u8; 32],
        bootstrap_vk: &[u8; 32],
        duress_pin: &[u8; 8],
    ) -> Result<(), SeError> {
        // `entropy` is the FULL decoy entropy; XOR-split it across the two
        // chips exactly like the real wallet — invariant #1 (no full
        // entropy on a single chip) applies to the decoy too. A fresh
        // 3-source half is drawn so the decoy split is independent of the
        // real one.
        secure_log!("[DUAL/duress] start");
        let mut half_o = self.generate_split_half()?;
        let mut half_e = xor_32(entropy, &half_o);

        if let Err(e) = self.optiga.provision_duress(&half_o, master_secret, vk, bootstrap_vk, duress_pin) {
            secure_log!("[DUAL/duress] optiga.provision_duress FAILED: {:?}", e);
            half_o.zeroize();
            crate::fi::zeroize_barrier();
            half_e.zeroize();
            return Err(e);
        }
        if let Err(e) = self.se050.provision_duress(&half_e, master_secret, vk, bootstrap_vk, duress_pin) {
            secure_log!("[DUAL/duress] se050.provision_duress FAILED: {:?}", e);
            half_o.zeroize();
            crate::fi::zeroize_barrier();
            half_e.zeroize();
            return Err(e);
        }

        half_o.zeroize();
        crate::fi::zeroize_barrier();
        half_e.zeroize();
        crate::fi::zeroize_barrier();
        secure_log!("[DUAL/duress] Provisioned decoy: entropy XOR-split across OPTIGA + SE050");
        Ok(())
    }

    #[cfg(feature = "duress-pin")]
    fn duress_is_provisioned(&mut self) -> bool {
        self.optiga.duress_is_provisioned() && self.se050.duress_is_provisioned()
    }

    /// §32 P3: attempt to unlock the DECOY wallet with `pin`. Reads both
    /// decoy halves (OPTIGA F1D9 via F1D8 auto-state auth; SE050
    /// `DURESS_ENTROPY_OBJ` via the duress UserID), reconstructs the decoy
    /// entropy, and returns the decoy master. Returns `Err(PinIncorrect)`
    /// if `pin` is not the duress PIN — the caller (`gated_unlock`) then
    /// falls through to the real `unlock`.
    ///
    /// Timing: BOTH chips' duress verifies run even when the first fails
    /// (no short-circuit), mirroring the three-counter-lockstep of the
    /// real `unlock` and keeping the op-count uniform across real/duress
    /// entries. The OPTIGA verify fires only LUC(E121) — the real E120 is
    /// never touched on a duress entry, so no lockout drift.
    #[cfg(feature = "duress-pin")]
    fn unlock_duress(&mut self, pin: &[u8; 8]) -> Result<[u8; 32], UnlockError> {
        // OPTIGA returns (half_o, stored_decoy_master_from_F1DA); SE050
        // returns half_e. Both chips are ALWAYS verified (no `?` short-
        // circuit) so the op-count is uniform across real/duress entries.
        let ro = unsafe { self.optiga.duress_read_half(pin) };
        let re = self.se050.duress_read_half(pin);
        match (ro, re) {
            (Ok((mut half_o, mut stored_master)), Ok(mut half_e)) => {
                let mut full = xor_32(&half_o, &half_e);
                half_o.zeroize();
                crate::fi::zeroize_barrier();
                half_e.zeroize();
                crate::fi::zeroize_barrier();

                // FI cross-check (parity with the real `unlock`): the
                // master derived from the reconstructed decoy entropy MUST
                // equal the decoy master stored on-chip (F1DA). Defends a
                // glitch on the halve reads that yields wrong entropy.
                // Two `ct_eq` compares separated by `wait_random`, gated
                // through the hamming-distant sentinel.
                let derived_master = crypto::kdf(b"sphincs-master", &full, 0);
                let c1: bool = derived_master.ct_eq(&stored_master).into();
                crate::fi::wait_random();
                let c2: bool = derived_master.ct_eq(&stored_master).into();
                stored_master.zeroize();
                crate::fi::zeroize_barrier();
                if crate::fi::check_true_into_sentinel(|| c1 && c2) != crate::fi::OK_SENTINEL {
                    full.zeroize();
                    crate::fi::zeroize_barrier();
                    secure_log!("[DUAL/duress] CRITICAL: decoy entropy doesn't match stored master");
                    return Err(UnlockError::InternalError);
                }

                let blob = crypto::encrypt_entropy_blob(&full, &derived_master);
                self.entropy_blob_cache.copy_from_slice(&blob);
                self.blob_cached.set_true();
                full.zeroize();
                crate::fi::zeroize_barrier();
                secure_log!("[DUAL/duress] decoy wallet unlocked");
                Ok(derived_master)
            }
            (other_o, other_e) => {
                if let Ok((mut h, mut m)) = other_o {
                    h.zeroize();
                    m.zeroize();
                    crate::fi::zeroize_barrier();
                }
                if let Ok(mut h) = other_e {
                    h.zeroize();
                    crate::fi::zeroize_barrier();
                }
                Err(UnlockError::PinIncorrect)
            }
        }
    }

    /// §32 P3 timing PAD: run one duress verify on each chip (no read).
    /// Called on a duress-correct unlock to replace the SKIPPED real
    /// verify so the total op-count matches a real unlock (4 verifies +
    /// 2 reads either way). The OPTIGA verify is the matched-LUC twin of
    /// the real F1D0 verify; the SE050 verify twins the real UserID
    /// verify. Best-effort — a transient failure here doesn't fail the
    /// already-successful unlock; it only perturbs the timing pad.
    #[cfg(feature = "duress-pin")]
    fn duress_pad(&mut self, pin: &[u8; 8]) {
        let _ = unsafe { self.optiga.duress_verify(pin) };
        let _ = self.se050.duress_verify(pin);
    }

    fn unlock(&mut self, pin: &[u8; 8]) -> Result<[u8; 32], UnlockError> {
        // Three-counter lockstep: call SE050 on every PIN attempt,
        // even when OPTIGA rejects it, so SE050's UserID silicon
        // counter advances in sync with MCU page-124 and OPTIGA E120
        // LUC. Skip SE050 only on a non-PIN OPTIGA error (I2C /
        // session fault) — don't burn an SE050 silicon attempt slot
        // for a transient comm glitch.
        //
        // OPTIGA stores master_secret explicitly; its `unlock` returns
        // what provision wrote — this is the authoritative value for
        // the consistency check below and for the final return.
        // SE050's `unlock` returns `kdf("sphincs-master", half_e, 0)`
        // which is meaningful here as the decrypt key for SE050's own
        // entropy_blob cache (different from OPTIGA's master).
        let optiga_result = self.optiga.unlock(pin);

        let se050_result = match &optiga_result {
            Ok(_) | Err(UnlockError::PinIncorrect) => {
                Some(self.se050.unlock(pin))
            }
            Err(_) => None,
        };

        // Resolve OPTIGA first. If OPTIGA rejected the PIN, zeroize
        // any master SE050 accidentally returned (pathological
        // desync: PIN matched SE050 but not OPTIGA — chip-swap or
        // out-of-band SE050 reset scenario) and propagate the OPTIGA
        // error to the caller BEFORE any downstream SE050 read path.
        let master_o = match optiga_result {
            Ok(mo) => mo,
            Err(e) => {
                if let Some(Ok(mut me)) = se050_result {
                    me.zeroize();
                }
                return Err(e);
            }
        };

        // OPTIGA accepted → SE050 was called. Resolve its result.
        let master_e = match se050_result
            .expect("OPTIGA Ok branch always calls SE050")
        {
            Ok(me) => me,
            Err(e) => {
                let mut m = master_o;
                m.zeroize();
                return Err(e);
            }
        };
        // Keep master_e alive — it's the key SE050 used to encrypt
        // its own entropy_blob cache. Zeroize after decrypt below.

        // Now reconstruct the full entropy from both halves, encrypt it
        // under master_secret, and cache the blob for the signing flow.
        //
        // Read half_O from OPTIGA (encrypted entropy blob → decrypt)
        // Read half_E from SE050 (encrypted entropy blob → decrypt)
        let mut blob_o = [0u8; 64];
        let blob_o_len = self.optiga.read_entropy_blob(&mut blob_o)
            .map_err(|_| UnlockError::InternalError)?;
        let mut half_o = crypto::decrypt_entropy_blob(
            &blob_o[..blob_o_len], &master_o
        ).map_err(|_| UnlockError::InternalError)?;
        blob_o.zeroize();
        // Under the inner wrap, what the SE stored (and we just decrypted) is
        // the 32-byte AES-GCM ciphertext; open it (ct + tag from the ct-store)
        // to recover the real half_O. The borrow in `&half_o` ends before the
        // re-assignment.
        #[cfg(feature = "mlkem-inner-wrap")]
        {
            half_o = crate::pq_wrap::open_half_from_se(
                crate::pq_wrap::HalfId::OptigaHalfO, 0, &half_o,
            )
            .map_err(|_| UnlockError::InternalError)?;
        }

        let mut blob_e = [0u8; 64];
        let blob_e_len = self.se050.read_entropy_blob(&mut blob_e)
            .map_err(|_| UnlockError::InternalError)?;
        // SE050's blob is encrypted under ITS master_secret
        // (`kdf("sphincs-master", half_e, 0)`), not OPTIGA's. The
        // two chips encrypt their caches independently; each must
        // be decrypted with the matching key.
        let mut half_e = crypto::decrypt_entropy_blob(
            &blob_e[..blob_e_len], &master_e
        ).map_err(|_| UnlockError::InternalError)?;
        blob_e.zeroize();
        // Same for half_E on the SE050.
        #[cfg(feature = "mlkem-inner-wrap")]
        {
            half_e = crate::pq_wrap::open_half_from_se(
                crate::pq_wrap::HalfId::Se050HalfE, 0, &half_e,
            )
            .map_err(|_| UnlockError::InternalError)?;
        }
        let mut me = master_e;
        me.zeroize();

        // Reconstruct the full entropy
        let mut full_entropy = xor_32(&half_o, &half_e);
        half_o.zeroize();
        crate::fi::zeroize_barrier();
        half_e.zeroize();
        crate::fi::zeroize_barrier();

        // Verify consistency: kdf("sphincs-master", full_entropy, 0) must
        // equal the master_secret we already got from both SEs.
        //
        // FI hardening: two independent `ct_eq` compares with a volatile
        // delay between, gated through `fi::check_true` so the boolean
        // cannot be faulted to `true` via a single skip.
        let derived_master = crypto::kdf(b"sphincs-master", &full_entropy, 0);
        let c1: bool = derived_master.ct_eq(&master_o).into();
        crate::fi::wait_random();
        let c2: bool = derived_master.ct_eq(&master_o).into();
        if crate::fi::check_true_into_sentinel(|| c1 && c2) != crate::fi::OK_SENTINEL {
            full_entropy.zeroize();
            crate::fi::zeroize_barrier();
            let mut mo = master_o;
            mo.zeroize();
            secure_log!("[DUAL] CRITICAL: reconstructed entropy doesn't match master!");
            return Err(UnlockError::InternalError);
        }

        // Cache the encrypted full-entropy blob for the signing flow.
        let blob = crypto::encrypt_entropy_blob(&full_entropy, &master_o);
        self.entropy_blob_cache.copy_from_slice(&blob);
        self.blob_cached.set_true();

        full_entropy.zeroize();
        crate::fi::zeroize_barrier();

        secure_log!("[DUAL] Unlocked: entropy reconstructed from XOR split");
        Ok(master_o)
    }

    fn read_entropy_blob(&mut self, buf: &mut [u8]) -> Result<usize, SeError> {
        if !self.blob_cached.is_true_fi() || buf.len() < crypto::ENTROPY_BLOB_LEN {
            return Err(SeError::SlotNotFound);
        }
        buf[..crypto::ENTROPY_BLOB_LEN].copy_from_slice(&self.entropy_blob_cache);
        Ok(crypto::ENTROPY_BLOB_LEN)
    }

    fn read_vk(&mut self, buf: &mut [u8]) -> Result<usize, SeError> {
        // Both SEs store the same VK; read from SE050 (cached, no session overhead)
        self.se050.read_vk(buf)
    }

    fn read_bootstrap_vk(&mut self, buf: &mut [u8]) -> Result<usize, SeError> {
        self.se050.read_bootstrap_vk(buf)
    }

    fn remaining_attempts(&mut self) -> u8 {
        // Return the minimum of both SEs (more restrictive)
        let o = self.optiga.remaining_attempts();
        let e = self.se050.remaining_attempts();
        o.min(e)
    }

    fn sync_remaining_with_mcu(&mut self, mcu_used: u8) {
        self.optiga.sync_remaining_with_mcu(mcu_used);
        self.se050.sync_remaining_with_mcu(mcu_used);
    }

    fn zeroize_caches(&mut self) {
        self.entropy_blob_cache.zeroize();
        self.blob_cached.set_false();
        self.optiga.zeroize_caches();
        self.se050.zeroize_caches();
    }

    fn pin_attempt_count(&mut self) -> Option<u8> {
        // OPTIGA exposes a peek-safe counter (E120 in the production
        // `optiga-hw-counter` configuration). The production SE050 UserID
        // policy denies `ReadObjectAttributes` with SW=0x6986, so its leg is
        // `None`; see `Se050::pin_attempt_count_raw`.
        //
        // Combined value: MAX of whatever's available — counters
        // are "attempts USED" (higher = closer to lockout), so the
        // strict aggregate is `max`, not `min`. Reconciliation uses the
        // available count directionally (`se_used > mcu_used`), because the
        // MCU is precharged and may benignly lead. Intra-SE divergence is
        // meaningful only when both legs are actually readable.
        let o = self.optiga.pin_attempt_count();
        let s = self.se050.pin_attempt_count();
        match (o, s) {
            (Some(a), Some(b)) => Some(a.max(b)),
            (Some(a), None) => Some(a),
            (None, Some(b)) => Some(b),
            (None, None) => None,
        }
    }

    fn pin_attempt_counts_divergent(&mut self) -> bool {
        // Tamper signal: OPTIGA and SE050 disagree on remaining attempts
        // even though both reported a value. Only flagged when both
        // Some — None on either side means "no readable counter, no
        // comparison possible," not divergence.
        match (
            self.optiga.pin_attempt_count(),
            self.se050.pin_attempt_count(),
        ) {
            (Some(a), Some(b)) => a != b,
            _ => false,
        }
    }

    /// Legacy combined-SE helper for non-key protocol callers. Pull random
    /// bytes from both SEs and XOR-mix them in-place; per-source bytes never
    /// leave this function. Security-critical entropy does not use this
    /// already-combined result: `rng_strong` calls `random_optiga` and
    /// `random_se050` separately and verifies each contribution.
    ///
    /// **Strict (both-or-fail).** Both OPTIGA and SE050 MUST contribute.
    /// If either chip fails to provide entropy we return `Err` — the
    /// caller propagates that. Degrading to a single SE under EMFI / I2C
    /// glitching on one of the two buses would let an attacker reduce entropy to
    /// effectively two sources (STM32 + one SE) without anything
    /// noticing; refusing the call is the loud failure mode.
    fn random(&mut self, buf: &mut [u8]) -> Result<(), SeError> {
        let mut tmp = [0u8; 32];
        let mut off = 0;
        while off < buf.len() {
            let len = (buf.len() - off).min(tmp.len());

            // OPTIGA contribution — mandatory.
            self.optiga.random(&mut tmp[..len]).map_err(|_| {
                tmp.zeroize();
                SeError::InternalError
            })?;
            for i in 0..len {
                buf[off + i] ^= tmp[i];
            }
            // SE050 contribution — mandatory.
            tmp.zeroize();
            self.se050.random(&mut tmp[..len]).map_err(|_| {
                tmp.zeroize();
                SeError::InternalError
            })?;
            for i in 0..len {
                buf[off + i] ^= tmp[i];
            }
            tmp.zeroize();

            off += len;
        }
        Ok(())
    }

    fn random_optiga(&mut self, buf: &mut [u8]) -> Result<(), SeError> {
        self.optiga
            .random(buf)
            .map_err(|_| SeError::InternalError)
    }

    fn random_se050(&mut self, buf: &mut [u8]) -> Result<(), SeError> {
        self.se050
            .random(buf)
            .map_err(|_| SeError::InternalError)
    }
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
