DankGecko/pq1/(commit log)

2026-04-06 Add TrustZone firmware for SPHINCS+ post-quantum hardware wallet
    Workspace with 4 crates targeting Cortex-M33 TrustZone on QEMU mps2-an505:
    - desktop/: Original USB CLI for TROPIC01 (unchanged)
    - shared/: no_std types shared across TrustZone boundary
    - secure/: Secure world — SPHINCS+ key material, PIN verification via
    MAC-and-Destroy, AES-GCM key wrapping, MockSecureElement trait
    - nonsecure/: Non-secure world — test harness calling through gateway
    The NS→S gateway uses shared memory + secure SysTick polling as a
    workaround for a QEMU 8.2.2 MPC bug that breaks CMSE SG veneers.
    CMSE veneers are still generated for real STM32U585 hardware.
    All 4 operations work end-to-end through t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
    [boot_ns.rs, build.rs, crypto.rs, lib.rs, main.rs, nsc_api.rs, pin.rs, sau.rs]
2026-04-06 Add real TROPIC01 integration with e2e encrypted SPI bridge
    New feature flag `tropic01-se` connects the emulated firmware to a real
    TROPIC01 chip at /dev/ttyACM0 via ARM semihosting file I/O:
    - semihosting_spi.rs: SpiDevice impl using semihosting SYS_OPEN/READ/WRITE,
    speaks the same hex-encoded SPI protocol as the desktop USB dongle
    - tropic01_se.rs: Tropic01SecureElement with batch operations, each
    establishing a fresh Noise_KK1 encrypted session (X25519 + AES-256-GCM)
    so the SPHINCS+ private key never travels in plaintext over SPI
    - Ephemeral keys generated from host /dev/urandom via semihosting
    - Feature-gated: `make run` (mock, default) vs `make run-tropic01` (real chip)
    - Updated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
    [main.rs, secure_element.rs]
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2026-04-06 Harden secure world against key extraction attacks
    Critical fixes for production hardware deployment:
    - Add NS pointer validation in NSC gateway (blocks confused-deputy
    PIN bypass where NS could write pubkey over PIN_VERIFIED or
    write 17KB signature over MASTER_SECRET in secure SRAM)
    - Fix TOCTOU race by snapshotting shared memory args atomically
    in dispatch() before routing to command handlers
    - Zeroize all sensitive intermediates (sk_dec, wrap_key, w_j,
    master_secret, seed) via the zeroize crate's volatile writes
    - Add custom panic handler that clears MASTER_SECRET before halting
    - Replace deterministic test seed with TROPIC01 hardware TRNG
    - Gate debug logging behind debug-log fe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
    [crypto.rs, main.rs, pin.rs]
2026-04-07 Add trusted UI, EIP-1559 sign confirmation, seed-based key derivation
    Replaces the stored 64-byte SLH-DSA SigningKey with a 48-byte seed
    (sk_seed || sk_prf || pk_seed) encrypted in TROPIC01 r-mem slot 0. The
    full signing key is re-derived on every unlock via the FIPS-205
    slh_keygen_internal primitive, which properly computes pk_root via XMSS
    instead of trusting whatever 16 bytes happened to land in the SK blob.
    Adds a trusted UI in the secure world with two backends behind mutually
    exclusive Cargo features: ui-semihosting (default, prints a 4x16
    framebox to QEMU stdout and reads "buttons" from semihosting READC),
    and ui-oled (stub for the SSD1306 + GPIO buttons hardware that lands
    tomorrow)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
    [boot_ns.rs, build.rs, crypto.rs, hash.rs, lib.rs, main.rs, mod.rs]
2026-04-07 Add BIP-39 mnemonic recovery, on-unlock key derivation, arrow runner
    Replaces the hardcoded test seed with a 24-word BIP-39 mnemonic chosen
    on first boot. The same 24 words always recover the same SPHINCS+
    keypair on any device running this firmware, so a lost or bricked unit
    can be restored from a paper backup.
    New `bip39` workspace crate: a no_std 24-word BIP-39 implementation
    with PBKDF2-HMAC-SHA512 and the canonical 2048-word English wordlist.
    Lives in its own crate so it can be unit-tested on the host. Verified
    against all 8 official Trezor 24-word vectors plus a checksum-mutation
    test that proves bad phrases are rejected.
    First-boot wizard in `secure/src/ui/seed_wizard.rs`: the user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
    [crypto.rs, host_rng.rs, lib.rs, main.rs, mod.rs, pin.rs, wordlist.rs]
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2026-04-07 Add PKA hardware acceleration and multi-Miller loop optimization
    Vendor bls12_381 v0.8 as bls12_381_pka/ with two optimizations for
    Groth16 verification on STM32U585:
    1. PKA-backed Fp::mul/square (feature-gated behind `pka-accel`):
    Routes BLS12-381 base field multiplication through the STM32U585
    PKA hardware accelerator (Montgomery multiplication mode 0x10).
    The PKA's Montgomery form (R=2^384) is directly compatible with
    the crate's [u64; 6] representation. Includes a minimal PKA
    driver in secure/src/hw/pka.rs with modular arithmetic ops.
    2. No-alloc miller_loop_4() for Groth16 (always active):
    Fixed-arity 4-pair Miller loop sharing a single final
    exponentiation instea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
    [lib.rs, main.rs, mod.rs]
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2026-04-08 Implement M4: CowSwap EIP-712 GPv2Order clear-signing
    Adds a new clear-signing path that signs EIP-712 typed-data digests
    (not EIP-1559 envelopes), so the wallet can attest CowSwap GPv2Order
    messages on the trusted UI with the kind (SELL/BUY) and validTo
    fields decoded from a Poseidon-bound canonical encoding.
    The Groth16 circuit binds a 164-byte packed canonical GPv2Order
    encoding to a "CowSwap SELL exp 0xXXXXXXXX " readable string
    (with in-circuit hex formatting + kind mux). The secure world
    re-keccaks the same buffer as abi.encode(GPv2Order) to produce the
    EIP-712 digest it actually signs with SLH-DSA, sidestepping
    keccak-in-circom entirely. Reuses poseidon6 / Groth16 / VK DB
    plumbin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
    [lib.rs, mod.rs, nsc_api.rs]
2026-04-08 M4 v2: real human-readable CowSwap clear-signing + modular EIP-712 dispatch
    The trusted UI now displays a real trade summary instead of the v1
    placeholder. The new readable layout is a 4-line × 16-char page
    bound by the Groth16 circuit:
    CowSwap SELL
    1000.0000 USDC
    for at least:
    0.5000 WETH
    Token symbols and decimals come from a shared in-circuit ERC20
    registry; amounts are formatted by an in-circuit decimal formatter
    with leading-zero trimming. The same 164-byte canonical buffer the
    proof binds is what the secure world re-keccaks for the EIP-712
    digest it actually signs with SLH-DSA, so display ↔ digest stay
    inseparable.
    Generalization:
    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
    [mod.rs]
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2026-04-08 Add HSI16 clock (16 MHz) and hardware TRNG for STM32U585
    - hw/rcc: switch SYSCLK from default MSI 4 MHz to HSI16 (16 MHz),
    enable HSI48 for RNG clock source, enable RNG peripheral clock.
    RCC is on AHB3 at 0x46020C00, not AHB1 as previously assumed.
    - hw/rng: hardware True Random Number Generator driver using the
    STM32U585 RNG peripheral. Replaces semihosting /dev/urandom.
    - rng: platform-agnostic facade that dispatches to hw::rng on real
    hardware or host_rng (semihosting) on QEMU.
    - Fix RCC base address in sau.rs GTZC clock enable (was writing to
    CORDIC peripheral at 0x50021088 instead of RCC at 0x56020C88).
    - Fix Makefile flash-hw to use probe-rs attach (not run) to avoid
    re-fla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
    [main.rs, mod.rs, rng.rs, sau.rs]
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2026-04-08 Document VOS Range 1 limitation on STM32U585 Rev W
    PWR_VOSR VOS bits are unwritable on STM32U585 Rev W (revision 0x3001).
    All VOS change attempts are silently ignored regardless of bus alias
    (NS 0x46020800 / S 0x56020800), CPU security state (Secure/NS),
    regulator mode (LDO/SMPS), or target range (R1/R2/R3). PWR_CR1 is
    writable, confirming the issue is specific to VOSR.
    SYSCLK stays at HSI16 (16 MHz), which is within VOS Range 4 limits.
    PLL for 160 MHz requires a board with a later silicon revision or
    investigation into the VOSR write-protect mechanism.
    [main.rs]
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2026-04-08 Route STM32U585 gateway through real CMSE veneers
    The stm32u585 build now exits the shared-memory mailbox workaround
    entirely and drives all six NSC commands through proper ARMv8-M
    cmse-nonsecure-entry veneers. NS calls resolve to the SG stubs in
    veneers.o and enter the secure world via BLXNS -> SG -> handler ->
    BXNS, with no SysTick poll and no NS/S mailbox. The QEMU mps2-an505
    build is unchanged and still uses the mailbox as a workaround for the
    QEMU 8.2.2 MPC S-alias bug. Verified end-to-end on a real
    B-U585I-IOT02A: make e2e-hw runs all six sign-dispatch scenarios
    (value_transfer, erc20_known, blind_sign, zk_clear_sign,
    cowswap_pre_sign, cowswap_eip712_order) to PASS through the new path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
    [main.rs, mod.rs, nsc_api.rs]
2026-04-08 Wrap signing path as ERC-4337 UserOps with PQ-only Smart Wallet fork
    Turns the wallet into an ERC-4337 v0.6 account whose only authorised
    signer is a SLH-DSA-SHA2-128f key, end-to-end:
    * contracts/smart-wallet — fork of coinbase/smart-wallet stripped to a
    single PQ owner. MultiOwnable / EOA + WebAuthn paths are deleted; the
    only signer is sha256(slh-dsa pk), there is no add/remove path and no
    fallback to a classical curve. PQCoinbaseSmartWallet hands the
    (userOpHash, signature) pair to a pluggable ISLHDSAVerifier; a
    reference Solidity FIPS-205 verifier is included for L2 deployment
    and the interface is the swap point for a Groth16-wrapped variant on
    L1.
    * secure/src/aa/user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
    [cmd_sign_userop.rs, lib.rs, main.rs, mod.rs, nsc_api.rs]
2026-04-09 Add three-layer test coverage for ERC-4337 AA signing path
    Layer 1 — Foundry Solidity tests (33 tests):
    contracts/smart-wallet/test/ with a shared Base.t.sol fixture and
    MockSLHDSAVerifier. Per-contract test files cover PQCoinbaseSmartWallet
    (validateUserOp, execute, batch, upgrade, nonce keys — 14 tests),
    PQCoinbaseSmartWalletFactory (CREATE2, deterministic address — 6),
    PQOwnable (ownerKeyHash, isOwnerKey, re-init — 4), ERC1271 (EIP-712,
    replaySafeHash, magic bytes — 6), and SLHDSAVerifier (length
    validation — 3; real FIPS-205 vector tests ready when fixture is
    generated).
    Also fixes a pre-existing compilation error in SLHDSAVerifier.sol:
    _slice was overlo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
    [build.rs, main.rs, mod.rs]
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2026-04-09 Add USB-C to USB-C support on B-U585I-IOT02A CN1
    - Call configure_vbus_u5() after driver init to force B-session valid
    (fixes enumeration on C-to-C where DWC2 core ID is unrecognised)
    - Disable UCPD dead-battery pull-downs after Rd init (CC1TCDIS/CC2TCDIS)
    to prevent CC voltage mis-detection with host-driven Rp
    - Fix sign_raw → sign_userop in USB command router
    - Fix duplicate sphincs_tz_shared imports in main.rs
    [main.rs, mod.rs, usb_hw.rs]
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2026-04-09 Fix SE050 GP 1.0 framing, APDU P1/P2, I2C RELOAD, WriteBinary TAG_3
    Debugging session fixes for the SE050 driver on OM-SE050ARD-e:
    GP 1.0 framing:
    - Switch CRC-16 from non-reflected (0x1021) to reflected (0x8408)
    with init/final XOR 0xFFFF, no byte-swap (GP 1.0, not UM11225)
    - Use 2-byte LEN field in frame header (GP 1.0 format)
    - Verified CRC matches received 0x89E0 for [A5 82 00 00]
    APDU corrections from nano-package/plug-and-trust reference:
    - P2_EXIST: 0x03 → 0x27 (kSE05x_P2_EXIST)
    - P2_DELETE_OBJECT: 0x02 → 0x28 (kSE05x_P2_DELETE_OBJECT)
    - P1_BINARY: 0x03 → 0x06 (kSE05x_P1_BINARY)
    - P1_HMAC: 0x04 → 0x05 (kSE05x_P1_HMAC)
    - P1_MAC: 0x09 → 0x0D (kSE05x_P1_MAC)
    - HMAC_SHA256: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
    [apdu.rs, i2c.rs, mod.rs, t1oi2c.rs]
2026-04-09 SE050 APDU: add TAG_3 file length to WriteBinary, log all SW
    WriteBinary now includes TAG_3 (2-byte file length) as required by
    the SE050 when creating new binary file objects. Without it, objects
    were created but unreadable (SW 0x6985 on ReadObject).
    Also log all response status words (not just errors) to trace the
    exact failure point during provisioning.
    Status: all MACD ops + r_mem writes succeed (SW=0x9000), but
    ReadObject for r_mem slots still returns 0x6985 after provisioning.
    MACD binary object reads (0x7B001xxx) work fine — issue is specific
    to r_mem object IDs (0x7B000xxx). Investigating.
    [apdu.rs]
2026-04-09 SE050 HMAC-SHA256 fully on secure element (P2_GENERATE_ONESHOT=0x45)
    The MAC-and-Destroy (MACD) protocol now runs entirely on the SE050's
    HMAC-SHA256 crypto engine. Key material never leaves the secure
    element — the MCU sends data_in, the SE050 computes HMAC internally
    and returns only the 32-byte result.
    Key fix: P2 for MACOneShot_Generate is 0x45 (P2_GENERATE_ONESHOT),
    NOT 0x03 (P2_GENERATE). The 0x03 value was for multi-step MAC init,
    not one-shot. Found in the plug-and-trust se05x_APDU_apis.h line 4303.
    All 27 MACD slots (9 PIN attempts × 3 ops each) complete with
    SW=0x9000. HMAC results are 38 bytes (TAG_1 + 32-byte MAC + SW).
    Remaining: ReadObject for r_mem binary objects (0x7B00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
    [apdu.rs, mod.rs]
2026-04-09 Add SSD1306 OLED display support and e2e-hw-display target
    Implement the ui-oled backend to drive a 128x64 SSD1306 I2C OLED
    on the B-U585I-IOT02A board (PB8=SCL, PB9=SDA, AF4, ~100 kHz).
    - secure/src/hw/i2c.rs: bare-metal I2C1 driver with RELOAD support
    for >255-byte transfers, timeouts, and NACK/BERR error handling
    - secure/src/ui/oled.rs: SSD1306 init sequence, 1024-byte page-format
    framebuffer with embedded-graphics DrawTarget, FONT_8X13 text
    rendering (16 cols x 4 rows), and per-page I2C flush
    - Makefile: new e2e-hw-display target (ui-oled instead of
    ui-semihosting); fix e2e-hw to use probe-rs run instead of
    probe-rs attach (attach mishandles TrustZone semihosting)
    Co-Authore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
    [i2c.rs, main.rs, mod.rs]
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2026-04-09 Add interactive play-hw-display target for STM32U585 + OLED
    Maps laptop arrow keys to wallet buttons on real hardware, same UX as
    `make play` (QEMU). Uses semihosting file I/O (SYS_OPEN/SYS_READ via
    --semihosting-file) instead of SYS_READC which probe-rs doesn't support.
    wallet_run_hw.py serves button chars over a local TCP socket that
    probe-rs connects to when the firmware opens "/input".
    Also fixes a latent duplicate-import in nonsecure/main.rs that prevented
    building without both `usb` and `e2e-test` features.
    [main.rs]
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2026-04-10 Add SCP03 session authentication framework for SE050
    Implements the GlobalPlatform SCP03 protocol:
    - INITIALIZE UPDATE (CLA=80 INS=50 P1=keyVer P2=00)
    - Session key derivation (NIST SP 800-108 KDF with CMAC-AES)
    - Card cryptogram verification
    - Host cryptogram computation
    - EXTERNAL AUTHENTICATE (CLA=84 INS=82 P1=33 P2=00)
    - APDU MAC wrapping (C-MAC with 8-byte truncated CMAC)
    Dependencies: adds aes v0.8 and cmac v0.7 crates.
    Current status: INIT UPDATE succeeds and SE050 responds with
    correct format (31 bytes: KeyDivData+KeyInfo+CardChallenge+
    CardCryptogram+SW). Card cryptogram verification fails —
    likely a KDF computation bug (all 4 tested key sets produce
    wrong cryptograms). Next: ve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
    [apdu.rs, mod.rs, scp03.rs]
2026-04-10 Implement SE050 native UserID PIN authentication
    Replace the software MACD chain with SE050 hardware-enforced PIN
    verification for the `se050` feature flag. The SE050 now makes the
    trust decision — the MCU never compares PINs.
    New APDU commands: WriteUserID (INS=0x41), CreateSession,
    VerifySessionUserID, ReadObjectAuthed, CloseSession — all using
    INS_PROCESS (0x05) wrapping for session-gated access.
    Binary objects (entropy, VK, bootstrap VK) are stored with a policy
    requiring UserID authentication (REQUIRE_SM bit). Entropy is stored
    unencrypted behind the hardware gate, avoiding the circular
    master_secret dependency.
    SCP03 upgraded to C-MAC + C-DEC (P1=0x03) as required by SE050E
    for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
    [apdu.rs, cmd_request_unlock.rs, crypto.rs, main.rs, mod.rs, scp03.rs]
2026-04-10 Rewrite SE050 driver from scratch for correct PIN-gated mnemonic storage
    Delete the buggy SE050 implementation and rewrite the APDU layer, SCP03
    session, and high-level Se050 API from first principles using the NXP
    documentation.
    Key fixes:
    - Fix broken aes128_cbc_decrypt (was using encrypt_block then breaking)
    - Eliminate unsafe global SCP03_SESSION static — pass session by &mut ref
    - Use hardware TRNG (rng::fill) for SCP03 host challenge instead of SysTick
    - ApduBuf builder eliminates duplicated short/extended Lc encoding logic
    - Drop dead SecureElement trait impl (no r_mem, no MACD on SE050 path)
    New clean API: Se050::init(), is_provisioned(), provision(), unlock().
    Only 8 APDU comman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
    [apdu.rs, crypto.rs, main.rs, mod.rs, scp03.rs]
2026-04-10 Prompt for PIN unlock on boot when device is already provisioned
    Previously the "already provisioned" path just booted straight to NS
    without unlocking, leaving the device in a locked state with no way to
    enter the PIN from the secure UI. Now it shows "Enter PIN to unlock"
    on the OLED, loops until the correct PIN is entered (or lockout), then
    sets the gateway to unlocked and boots NS.
    [main.rs]
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2026-04-12 Add SPI1/Arduino header support for Tropic01 MicroE Clicker, dual-SE module
    Add `spi1-arduino` feature flag that switches the TROPIC01 SPI driver from
    SPI2/PB12-PB15 (direct wiring) to SPI1/PE12-PE15 (Arduino R3 headers).
    This enables the Tropic01 MicroE Clicker to work when stacked on the
    SE050 Arduino shield on the B-U585I-IOT02A.
    Three hardware bugs fixed during bring-up:
    - RCC APB2 register offsets: APB2ENR is at 0xA4 (not 0xA0=APB1ENR2),
    APB2RSTR is at 0x7C (not 0x78=APB1RSTR2). Was enabling LPTIM2
    instead of SPI1.
    - SPI MASTER mode fault: SSI must be set to 1 in CR1 before writing
    MASTER=1 in CFG2, otherwise the peripheral clears MASTER on a
    false NSS-low detection.
    - Post-reb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
    [crypto.rs, dual_se.rs, lib.rs, main.rs, mod.rs, spi_hw.rs]
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2026-04-13 SE050: self-deletable UserID, iterative wipe, user factory reset
    Three related fixes to SE050 object lifecycle, orthogonal to the
    ongoing OPTIGA Trust M work (both dual-SE chips benefit):
    1. `write_userid` now emits a self-deletable TAG_POLICY on creation:
    auth_obj_id = <this UserID's own object ID>, ar_header = ALLOW_WRITE
    | ALLOW_DELETE | REQUIRE_SM (0x0016_0000). A session that verifies
    the PIN against this UserID can then delete it. Without this the
    SE050 default policy applies (no ALLOW_DELETE bit), making the
    UserID permanently stuck until a FACTORY_RESET credential wipes
    the chip — and that credential is never provisioned on OM-SE050ARD
    dev samples. Enables use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
    [apdu.rs, mod.rs]
2026-04-13 SE050: add factory-reset roundtrip e2e test (PASS on real hardware)
    Self-contained validation of the user-initiated factory-reset flow.
    Proves end-to-end that:
    1. UserID created via `apdu::write_userid` with the self-deletable
    policy can be self-deleted by a session that knows the PIN.
    2. UserID-gated data objects are likewise deletable.
    3. After the reset all three objects truly disappear from the chip.
    `Se050::run_factory_reset_roundtrip(pin)` performs:
    - cleanup of any prior test residue
    - provision: write UserID + 2 gated data objects at 0x7B07_xxxx
    - presence check (3/3)
    - reset via PIN-authenticated session (delete 2 data objects + UserID)
    - absence check (3/3)
    R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
    [main.rs, mod.rs]
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2026-04-13 Fix USB SIGN_ETH_TX end-to-end: UserOp wrapping, stack overflow, UI return
    Three fixes to make SIGN_ETH_TX work from Chrome WebHID through to a
    real SLH-DSA signature over USB HID:
    1. NS cmd_sign_eth_tx now wraps the raw EIP-1559 tx in a proper ERC-4337
    UserOp envelope (aa::build_userop_payload) with default AA parameters
    and chain_id extracted from the tx. Previously it sent a bare
    [has_bundle][tx_len][tx] payload that the secure world rejected.
    2. Secure cmd_sign_userop TOCTOU snapshot buffer moved from stack to
    static (5.5 KB was overflowing the CMSE gateway call frame). Added
    OLED breadcrumbs for debugging sign failures.
    3. OLED returns to "PQSigner OS Ready" after show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
    [cmd_sign_userop.rs]
2026-04-13 USB protocol v2: PQSigner-native command set (CLA 0xF0)
    Replace the Keycard Shell compatibility shim with a purpose-built
    protocol that exposes every device capability to the companion app:
    Commands (13 total):
    - GET_DEVICE_INFO (0x01): capability bitmap, sig params, DB versions
    - GET_STATUS (0x02): provisioned/locked/PIN remaining
    - UNLOCK/LOCK (0x10/0x11): session management
    - GET_BOOTSTRAP_VK (0x20): global bootstrap verifying key
    - GET_MAIN_VK (0x21): per-chain main signer derivation
    - SIGN_USEROP (0x30): ERC-4337 UserOp with full AA header from host
    - SIGN_CLEAR_USEROP (0x31): ZK clear-signed UserOp (Groth16)
    - SIGN_MESSAGE (0x40): EIP-191 personal_sign
    - SIGN_EIP712 (0x41): EIP-712 ty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
    [cmd_get_wallet_address.rs, lib.rs, mod.rs, nsc_api.rs]
2026-04-13 Fix USB v2 protocol: header constant, chaining, semihosting safety
    Three classes of bugs fixed:
    1. USEROP_V2_HEADER_LEN arithmetic error (shared/src/lib.rs):
    `32 * 7 + 32 * 2` evaluated to 344, but only 8 u256 fields exist (= 312).
    Firmware read tx_len at wrong offset → SW=0x6A80 on every v2 sign command.
    Fixed to `32 * 8`, added compile-time assertion + 6 unit tests.
    2. WebHID command chaining P1 inversion (tools/webhid_test.html):
    First APDU block must use P1=0x00 (start chain), continuations P1=0x80.
    Code set P1 based on "is last" instead of "is first" → SW=0x6985.
    Also added ERC-20 USDC transfer and ZK clear-sign (Aave V3 supply)
    test buttons matching the e2e t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
    [apdu.rs, cmd_sign_userop.rs, i2c.rs, lib.rs, main.rs, mod.rs, scp03.rs, t1oi2c.rs]
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2026-04-13 SE050: make `make se050-reset` actually wipe objects
    The old boot path called `Se050::factory_reset()` which in turn sent
    SetPlatformSCPRequest. That command only toggles whether SCP03 is
    mandatory — it does NOT delete any object, and on our chip it
    returned SW=0x6A80 (wrong data) because the TLV layout was wrong too.
    The firmware printed "SE050 factory reset FAILED" even though nothing
    was ever going to succeed at deletion via that path.
    Switch to the two-pass iterative_wipe we already built:
    - Pass 1: authenticate UserID 0x7B06_0000 (current standalone / dual-SE)
    with PIN "00000000", sweep and delete whatever's gated by that.
    - Pass 2: retry with UserID 0x7B00_2000 (legacy 81d94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
    [main.rs]
2026-04-13 SE050 reset: PIN-list loop + tri-state status + auth-ok plumbing
    iterative_delete_all/iterative_wipe now return (deleted, failed,
    auth_ok) so the reset block can distinguish "wrong PIN" from
    "objects survived authenticated delete (non-self-deletable policy)".
    main.rs reset block loops over the dev PIN candidates against both
    known UserIDs (current 0x7B06_0000 + legacy 0x7B00_2000), early-breaks
    on clean, and surfaces tri-state on the OLED: clean / wrong-PIN /
    blocked. Makefile target prints the assumed PIN list before building.
    [apdu.rs, main.rs, mod.rs]
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2026-04-14 Measured boot: show all 8 words on one screen, auto-boot after 4s
    Replace the multi-page interactive flow with a single screen showing
    all 8 words (2 per row) that auto-dismisses after 4 seconds. Any
    button press skips the wait immediately.
    [measured_boot.rs]
2026-04-14 Measured boot: start SysTick before measurement for 4s auto-dismiss
    SysTick was only started late in boot (after gateway init), so
    timeout::now() was always 0 during measured_boot::run() and the
    4-second auto-dismiss never fired. Start SysTick early on STM32U585
    (real hardware) where the CMSE transport doesn't need pre-init.
    QEMU keeps the late start since its mailbox gateway must init first.
    [main.rs]
2026-04-14 Measured boot: show "OS Fingerprint" title before words
    Users could mistake the 8 measurement words for their seed phrase.
    Now the boot sequence shows "OS Fingerprint" for 1.5s before
    displaying the words, making the purpose clear.
    [measured_boot.rs]
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2026-04-14 SE050: PIN-lockout factory reset via admin UserID + 2-entry policy
    After 10 wrong user PINs the SE050 silicon blocks the UserID, so every
    UserID-gated object becomes unreachable via normal auth. Install a
    secondary admin UserID at 0x7B06_00A0 with a per-device random PIN in
    secure flash page 125, and give every user object a two-entry
    TAG_POLICY: (user -> full) + (admin -> DELETE). Firmware can now wipe
    the chip without the user credential.
    - apdu: build_policy helper, multi-entry TAG_POLICY in write_userid /
    write_binary_gated
    - se050: provision installs admin + runs policy round-trip selftest;
    factory_reset_admin loads PIN from flash, arms wipe flag, wipes
    under admin auth, erases p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
    [apdu.rs, cmd_request_unlock.rs, dual_se.rs, flash.rs, main.rs, mod.rs, secure_element.rs]
2026-04-14 Replace slh-dsa with sphincs-c7: keccak256-based 3,704-byte signatures
    Swap the signing backend from SLH-DSA-SHA2-128f (17,088-byte sigs) to
    SPHINCS+C7 (keccak256-based, 3,704-byte sigs) — a 78% reduction in
    signature size and ~4.6x smaller initCode (17,336 → 3,928 bytes).
    - Seed derivation: 3-chunk SHA-256 KDF → 2-chunk Keccak-256 KDF
    (sk_seed=32 + pk_seed=16, no more sk_prf)
    - Domain tags updated: sphincsc7-* and pqwallet-c7-* prefixes
    - Signing API: try_sign_with_context → infallible sign()
    - initCode: ABI zero-padding for non-32-byte-aligned signatures
    - Dependencies: slh-dsa + signature crates removed entirely
    This is a recovery-contract-breaking change — new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
    [cmd_sign_userop.rs, crypto.rs, hash.rs, lib.rs, main.rs]
2026-04-14 Brownout hardening Stage 1 + crash-safety e2e test
    Bundles two independent additions from this session:
    1. se050-crash-safety-e2e test
    Two-phase test validating the existing wipe-in-progress flag +
    boot-time resume mechanism survives a true power cycle. Phase 1
    provisions test objects at 0x7B0A_xxxx, persists a test admin PIN
    to flash page 125, arms the wipe flag, does a partial wipe (data
    only), halts. User resets the board. Phase 2 boots, detects the
    armed flag, verifies the expected mid-wipe state, finishes the
    wipe under admin auth, erases page 125, reports PASS.
    Validated on hardware via both `probe-rs reset` (warm) and
    USB-unplug (true cold cycle); both path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
    [flash.rs, main.rs, mod.rs, reset_cause.rs]
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2026-04-14 Per-chain key derivation + OTS index tracking
    Fix critical bug: sign_and_emit::decrypt_and_sign_wrapped() was calling
    the legacy derive_signing_key_from_entropy() for MAIN signers, which
    ignores chain_id and key_index — all chains derived the same key.
    Now calls derive_main_key_from_entropy(entropy, chain_id, key_index),
    producing cryptographically independent keys per (chain_id, key_index).
    Wire key_index/ots_index from v2 USB handler into the secure world:
    - NS appends 8-byte trailer (key_index BE + ots_index BE) to the
    sign_userop payload and sets bit 31 of total_len as a flag
    - Secure side checks bit 31, extracts trailer, falls back to (0,0)
    for legacy v1 callers (backward compat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
    [cmd_sign_userop.rs, nsc_api.rs, state.rs]
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2026-04-14 fix: e2e tests complete in <30s by mocking SPHINCS+C7 keygen+signing
    Three issues caused `make e2e` to hang indefinitely:
    1. SPHINCS+C7 keygen takes 3-5 min per key on QEMU/Pi — with 5 signing
    ops that's 20+ min with zero progress output. Added cfg(e2e-test)
    fast paths in sign_and_emit.rs and crypto.rs that write deterministic
    mock bytes instead of running real keygen+signing.
    2. sign_userop_full writes ~3,917 bytes (initCode + callData + wrapper)
    but e2e tests used SIG_BUF (3,704 bytes), causing a 213-byte buffer
    overflow into adjacent statics. Added properly-sized
    USEROP_RESPONSE_BUF and switched all 8 userop test calls to use it.
    3. OTS monotonicity enforcement reje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
    [cmd_sign_userop.rs, crypto.rs]
2026-04-15 fix: replace SPHINCS+C7 signing mocks with real crypto + from_parts optimization
    Remove all e2e-test cfg-gated signing mocks introduced in 6dd36e8.
    Provisioning, signing, and key derivation now use real SPHINCS+C7
    unconditionally. Add from_parts fast-path: read cached VK (pk_seed ||
    pk_root) from r-mem at signing time to skip the expensive hypertree
    rebuild, cutting per-sign latency by ~10-15s on Cortex-M33.
    [crypto.rs]
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2026-04-15 feat: wire JARDÍN FORS+C gateway commands + rotation flag + companion docs
    Add the three missing NSC gateway commands for JARDÍN compact signing:
    - CMD 15 (SIGN_JARDIN): signs msg_hash with FORS+C, returns length-prefixed
    variable-size response with rotation-soon flag in bit 31
    - CMD 16 (REGISTER_JARDIN_SLOT): derives slot params for on-chain registration
    - CMD 17 (GET_JARDIN_SLOT_INFO): pure query for slot state
    Includes full dispatcher wiring (mod.rs), CMSE veneers for STM32U585,
    NS-side API for both QEMU and hardware transports, and 6 E2E test scenarios
    (all 17 tests pass in QEMU).
    Adds comprehensive JARDÍN section to companion-app-integration.md covering
    APDU commands, wire format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
    [lib.rs, mod.rs, nsc_api.rs]
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2026-04-15 feat: migrate SPHINCS+ from C7 to C11 parameter set, batch SE050 VK reads, signing progress UI
    C11 (h=16 d=2 a=11 k=13 w=8) trades +272 bytes signature for 16x faster
    keygen (256 vs 4096 WOTS keys) and 15x faster signing — critical for
    Cortex-M33 UX. Updated Solidity verifier, Python signer, firmware sig
    constants, and tests. SE050 unlock now batch-reads cached VKs in a single
    auth session to skip expensive hypertree keygen. Added progress bar UI
    for multi-second bootstrap signing. Included TROPIC01 reference docs.
    [lib.rs, mod.rs]
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2026-04-16 feat(jardin): phase 1 — secure-flash slot-state persistence + refactor plan
    Start of the JARDÍN-only pure-PQ cutover (mirrors SPHINCs- architecture minus
    the ECDSA hybrid half). This commit lands phase 1 (secure-flash persistence
    of the JARDÍN slot state) plus the full phase-by-phase implementation plan
    for the rest of the refactor.
    Firmware:
    * secure/src/nsc/jardin_flash.rs — new module. Double-buffered 128-byte
    SlotState record across two secure-flash pages. Keccak-256 integrity
    tag + "valid marker" as the last byte protect against torn writes on
    brown-out. STM32U585 backend talks to the flash controller directly;
    QEMU backend uses a static-RAM mirror so e2e tests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
    [mod.rs]
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2026-04-16 diag(jardin-flash): surface SECSR + addr on flash-write failure
    `Flash write FAIL` on the OLED gave no signal to distinguish WRPERR
    from PGSERR from a verify-failed read-back. Replaces the opaque
    `FlashError::Hardware` with three variants that carry the raw
    FLASH_SECSR bits, the target address/page, and (for verify) the
    offending byte index — and renders them as "Erase SR: 00000010 P:7B"
    / "Prog SR: 00000080 @F600" / "VerifyFail: @F600+03" on the trusted
    UI so we can read the diagnostic without hooking up probe-rs.
    Also reorders the SR read to happen before SECCR clear, since any
    sticky error bit the erase/program raised must be latched before we
    tear down PG / PER.
    No behavioural change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
    [cmd_sign_userop.rs]
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2026-04-16 fix(usb): re-enable ERC-20 + ZK DB lookups orphaned by JARDÍN cutover
    The phase 2-7 rewrite dropped `mod erc20_db;` and `mod vk_db;` from
    `nonsecure/src/main.rs`, so the on-device Merkle-anchored metadata
    DBs stopped being linked into the NS binary. WebHID-originated USDC
    transfers and every ZK clear-sign path fell through to the "Unknown
    token" / plain contract-call display because no code was left to
    build the trailer bundles the secure world expects.
    Non-secure USB handler now opportunistically augments the payload
    after chain-assembly:
    * `maybe_inject_erc20_bundle` — bare `[header | data]` payloads hit
    the ERC-20 DB by `(chain_id, tx.to)` and append a
    `[u16 len | bundle]`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
    [main.rs]
2026-04-16 feat(optiga): real Trust M silicon bring-up on B-U585I-IOT02A
    Replace the written-but-never-validated OPTIGA driver with one that
    actually talks to silicon. Full rewrite of the APDU layer and auth
    flow against Infineon's reference C lib; added physical-layer fixes
    required by the TRUST-M-SHIELD on I2C1.
    APDU wire format (apdu.rs):
    - Positional InData (not TLV) for GetDataObject/SetDataObject/OpenApp.
    - CMD bytes OR'd with 0x80 CLEAR_LAST_ERROR flag per Infineon convention.
    - Access-condition tag bytes corrected: AutoRef = 0x23, Conf = 0x20
    (were swapped). Data-type tag 0xE8 (was 0xF0). AUTHREF type 0x31
    (was 0x03). OpenApplication AID sent raw, no TLV wrapper.
    - New primitives: get_rand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
    [apdu.rs, dual_se.rs, i2c.rs, ifx_i2c.rs, mod.rs]
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2026-04-16 feat(optiga): IFX I2C layering fixes + PRL handshake WIP
    Round 2 of real-silicon debugging. OpenApplication + APDU path is
    now solid; the shielded-connection handshake itself is still stuck,
    checkpoint-committing the layering fixes that got us here.
    Layer fixes (validated on real hardware):
    - FRNR/ACKNR bit positions corrected to match Infineon's
    DL_FCTR_FRNR_MASK=0x0C / DL_FCTR_ACKNR_MASK=0x03 (were swapped).
    - send_frame_with_retry no longer blocks on a separate control-ACK
    frame: the chip piggybacks the DL ack in ACKNR on its response
    data frame when it has one ready immediately (busy=0). The ACK
    read used to truncate that data frame to 5 bytes and bail as
    "unexpected data fram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
    [apdu.rs, ifx_i2c.rs, mod.rs, shield.rs]
2026-04-16 chore(optiga): bring-up scaffolding — data-first write, OID rotation
    WIP checkpoint for the plaintext-APDU path while the PRL handshake
    debugging is parked. Validated on real silicon:
    - Provisioning writes data BEFORE metadata for arbitrary data OIDs.
    Installing Change=Auto(F1Dx) OR Conf(E140) AC first causes the chip
    to reject the subsequent SetData with Status=0xff even in LcsO=
    Creation (AC appears to be enforced immediately after metadata
    install, contra our initial assumption that Creation bypasses AC).
    - `optiga-bringup-fresh` now also skips user-OID AC installation and
    LcsO locking. OIDs stay at Creation (allow-all) so the dev loop
    can re-run without burning fresh OIDs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
    [apdu.rs, mod.rs]
2026-04-16 sec: remediate 2026-04-16 security audit (all CRITs + HIGHs, 6 MEDs)
    Closes the 9 CRITICAL and 18 HIGH findings from docs/security-audit-
    2026-04-16.md, plus 6 defense-in-depth MEDIUMs. CRIT-7 is resolved
    as won't-fix after threat-model review: with CRIT-9 (device-bound
    PBS seal) and CRIT-6 (read-back-verified counter bump) in place,
    offline brute force is blocked and online brute force is bounded
    by the chip's 10-attempt limit — a memory-hard KDF would not
    materially change the attack economics on Cortex-M33.
    Highlights
    * jardin_flash: per-chain log-structured store fixes the
    multi-chain next_q overwrite (CRIT-1). Integrity tag widened
    to 16 B. Regression test pins the behaviou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
    [apdu.rs, cmd_request_unlock.rs, cmd_sign_userop.rs, flash.rs, lib.rs, main.rs, measured_boot.rs, mod.rs]
2026-04-16 sec: retract CRIT-3 — paymaster is not an attack vector
    The audit's paymaster-drain premise is wrong: in ERC-4337 the paymaster
    pays EntryPoint from its own stake and can only charge the wallet back
    via a pre-existing relationship (deposit, allowance) that signing an
    arbitrary UserOp does not create. Remove the paymaster refusal in
    cmd_sign_userop.rs; mark CRIT-3 retracted in the audit doc.
    [cmd_sign_userop.rs]
2026-04-16 debug(optiga): CloseApp/OpenApp cycling + skip-reprovision paths
    Two more iterations on the bring-up loop; neither converges without a
    chip-level factory reset. Saving for reference before pivoting.
    - Added CMD_CLOSE_APPLICATION (0xF1) primitive + reopen_application()
    helper. Cycles the session context between user-OID provisions in
    case the observed "3rd consecutive write fails with Status=0xff" is
    a per-session buffer-exhaustion issue.
    - Added auth_ref_is_authref_typed() gate so bring-up doesn't re-write
    the AUTHREF-typed OID across runs — the secret is deterministic
    given fixed PIN + KDF domain, and the chip refuses rewrites of
    AUTHREF objects even when our installed Change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
    [apdu.rs, mod.rs]
2026-04-16 feat(bench): test-key-speed HW bench + STM32U5 HASH SHA-256 accel
    Adds `make test-key-speed`, a fully-automated DWT-timed JARDÍN signing
    bench on real STM32U585, plus the `sha256-hash` feature path that swaps
    Keccak-256 for the STM32U585 HASH peripheral in `sphincs-c7` and
    `jardin-fosc`.
    Bench results @ 160 MHz:
    first-sign (Type1 + keygen + Type2) Keccak 22.8s → SHA-256 2.77s (8×)
    type1+keygen alone (A − B_avg) Keccak 20.9s → SHA-256 1.11s (19×)
    type2-only, slot cached (avg) Keccak 1.92s → SHA-256 1.66s (1.15×)
    Type-2-only is mostly FORS+C signature-body work, so only the keygen-heavy
    path sees the full hash-primitive speedup.
    STM32U5 HASH v4 quirks h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
    [bench_key_speed.rs, buttons.rs, cmd_sign_userop.rs, hash.rs, lib.rs, main.rs]
2026-04-17 feat(crypto): full SHA-256 cutover — drop Keccak-256 from the signing stack
    Replaces Keccak-256 with SHA-256 everywhere the firmware actually controls
    the hash primitive, so the STM32U5 HASH peripheral can run the inner loop
    of every SPHINCS+C11 keygen, every FORS+C sign, and every KDF.
    On real hardware this collapses first-sign (Type 1 + keygen + Type 2) from
    ~22.8 s to ~2.77 s (8×), and the keygen-dominated Type-1-alone window from
    ~20.9 s to ~1.11 s (19×). The previously transitional `sha256-hash` feature
    flag is renamed `hw-sha256` and auto-enabled whenever `stm32u585` is in the
    feature set, so `make e2e-hw` / `play-hw-display` / every hardware target
    picks up the accelerator automa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
    [build.rs, cmd_sign_userop.rs, crypto.rs, hash.rs, lib.rs, main.rs, mod.rs]
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2026-04-17 feat(crypto): SPHINCS+C10 bootstrap cutover + 65,536 on-chain use cap
    Replaces the SPHINCS+C11 bootstrap (master) identity with SPHINCS+C10
    (h=18 d=2 a=11 k=13 w=8 l=43 target_sum=205 sig=4008) and wires an
    on-chain `bootstrapUses` counter on `PQJardinWallet` that caps Type 1
    slot-registrations at 65,536 per chain — well inside the C10 hypertree's
    2^18 = 262,144 signing positions. Once the cap is hit, firmware can no
    longer rotate slots on that chain; the last-registered JARDÍN slot keeps
    signing Type 2 transactions until its own Q_MAX.
    Rust side:
    * sphincs-c7/ → sphincs-c10/ (directory + crate rename). Params flipped
    to C10. Portable extract_ht_index that loads 4 bytes of the H_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
    [bench_key_speed.rs, cmd_sign_userop.rs, crypto.rs, hash.rs, lib.rs, merkle.rs]
2026-04-17 fix(hw): STM32U585 register addresses + LTO-safe delays
    Three independent bug fixes uncovered while bringing the OPTIGA Trust M
    recovery flow up on real B-U585I-IOT02A silicon. None of them are
    specific to the OPTIGA work — they affect every secure-world build that
    uses TRNG/PKA, mid-driver delays, or relies on the GTZC self-check.
    * hw/rng.rs, hw/pka.rs: switch from the non-secure peripheral alias
    (0x420C_0800 / 0x420C_2000) to the secure alias (0x520C_0800 /
    0x520C_2000). After the TZSC base-address fix in sau.rs, the GTZC1
    TZSC actually marks RNG and PKA as secure, so non-secure-alias
    accesses from secure code return zero / fail. The previous read of
    RNG_SR via the NS alias s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
    [ifx_i2c.rs, rng.rs, sau.rs]
2026-04-17 feat(optiga): SetObjectProtected OID recovery + RST hard-pulse workaround
    Bring-up of the OPTIGA Trust M MTR Express V3 against the
    B-U585I-IOT02A had wedged on a chip-side quirk: after every 2 successful
    SetData-family APDUs, the chip ACKs the next frame at the data-link
    layer but never sets RESP_READY in the I2C_STATE register, so all
    follow-on commands time out or return Status=0xFF. The pattern persists
    across CloseApp / OpenApp and across the IFX-layer soft reset (writing
    0x88 to REG_SOFT_RESET) — only a real silicon reset via the RST line
    clears it.
    This change makes both the recovery flow and the live provisioning
    flow work on real silicon by:
    * Adding **SetObjectProtected (CMD 0x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
    [apdu.rs, dual_se.rs, main.rs, mod.rs, reset.rs]
2026-04-17 chore(hw-bringup): get the full SE050+OLED+USB stack booting on real STM32U585
    Brings the current branch into a working end-to-end state on
    B-U585I-IOT02A: wizard runs, SE050 unlock completes, OLED comes up,
    NS world boots, USB HID enumerates on the host. Also bundles the
    remaining diff from the ongoing SPHINCS+C10 / SHA-256 cutover work
    that had been sitting uncommitted.
    Bring-up fixes (this session):
    * secure/src/nsc/mod.rs — drop `debug-log` from the "no dev features
    on hardware release" compile_error. The project is in bring-up,
    not hardening; we need semihosting on real hardware to diagnose
    boot-path issues. CI still needs to gate production firmware on
    debug-log/e2e-test/mo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
    [bench_key_speed.rs, cmd_sign_userop.rs, crypto.rs, hash.rs, lib.rs, main.rs]
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2026-04-17 fix(optiga): DL rx_seq init + brick-prevention guard rails + postmortem
    Two distinct fixes plus defensive feature flags that prevent the current
    OPTIGA pairing flow from bricking chips on firmware update.
    === Fix 1: IFX I2C data-link rx_seq must init to 0x03 (DL_MAX_FRAME_NUM) ===
    `IfxState::new` and `soft_reset` were initialising `rx_seq` to 0. Per
    Infineon reference (`ifx_i2c_data_link_layer.c`: `DL_MAX_FRAME_NUM = 0x03`)
    it must init to 3 so the first received frame's FRNR=0 passes the
    `fr_nr == (rx_seq_nr + 1) & 3` check and the ACK we emit carries
    ACKNR=0 (matching the chip's just-sent FRNR).
    With the old init, our first ACK carried ACKNR=1 → chip checked
    ACKNR against its own tx_s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
    [apdu.rs, ifx_i2c.rs, mod.rs]
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2026-04-17 feat(wallet): port Coinbase Smart Wallet → PQ-only multi-owner (all-SHA-256)
    Replaces PQJardinWallet's Type-1/Type-2 signature-embedded slot-registration
    with a Coinbase-Smart-Wallet-style multi-owner account where ownerIndex 0 is
    the immutable bootstrap key and 1..N are per-(chain, slot) C10 keys. Factory
    CREATE2 salt stays sha256(masterPkSeed||masterPkRoot) so one-address-per-seed
    recovery still holds. Factory now verifies a bootstrap-key C10 signature over
    sha256("pqwallet-factory-add-slot"||chainId||slot0) before deploying, closing
    the cross-chain address-squat hole (bootstrap pubkey is public, so without
    this gate anyone could frontrun deployment on a chain the user hasn't hit
    yet). O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
    [cmd_sign_userop.rs, crypto.rs, lib.rs, main.rs, state.rs]
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2026-04-18 fix(shared): point PQ_SMART_WALLET_FACTORY at Base Sepolia deploy
    The firmware had the factory constant at 0x00…00, so every first-deploy
    initCode routed to address(0) and the EntryPoint would revert. Swap in
    the Base Sepolia factory (0x008D…91DD) until the singleton deploy lands.
    Enough for the current Base Sepolia E2E bring-up. On other chains the
    address will differ until we deploy via a cross-chain singleton
    deployer (required for the recovery-contract CREATE2 invariant).
    [lib.rs]
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2026-04-18 feat(wallet): multi-account derivation — one seed, 256 wallets + paged WebHID picker
    Carve an 8-bit account_index from the spare bits of the existing 32-bit
    flags field (bits 29..22; slot_index narrows to 22 bits / 4M slots,
    still well above the 65,536 on-chain MAX_SLOT_USES cap). Account 0
    short-circuits to the legacy derivation byte-for-byte so pre-multi-account
    seeds keep their existing on-chain address; accounts 1..=255 fold the
    index into new -acct-tagged HMAC/SHA-256 inputs.
    Firmware: bootstrap C10 pubkeys cached in a 16-entry SRAM LRU keyed on
    account_index; lazy-derive on cache miss (~6 s on hardware), instant
    afterwards. Slot cache key gains account_index. CMD_GET_WALLET_ADDRESS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
    [cmd_get_wallet_address.rs, cmd_sign_userop.rs, crypto.rs, lib.rs, mod.rs, nsc_api.rs, state.rs]
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2026-04-19 fix(ui): remove dead-end "Locked (idle wipe)" screen — go straight to PIN entry
    The idle-wipe screen could get stuck with no way to recover: the handler
    paths (cmd_request_unlock, cmd_sign_userop) painted it and returned to
    NS, and nothing on the secure side re-drove the UI afterwards. The
    SysTick/PendSV background path then gated on `is_unlocked()` and skipped,
    leaving the screen frozen until NS chose to re-issue a command.
    Changes:
    - SysTick drops the transient "Locked (idle wipe)" paint; PendSV draws
    PIN entry unconditionally on every loop iteration, so glitched OLED
    writes self-heal on the next pass.
    - PendSV skips the "Press button to unlock" + wait_button intermediate
    and jump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
    [cmd_request_unlock.rs, cmd_sign_userop.rs, main.rs]
2026-04-20 fix(ui): overflow-safe tx display + hardened EIP-1559 parser
    The U256 decimal formatter silently dropped most-significant digits
    when the scratch buffer was too small, so a tx for 1_234_567_890_123.x
    ETH rendered as 123_456_789_012 ETH on the OLED — a 10× understatement
    with no warning. Address rendering also omitted bytes 7..12, giving a
    ~2^40 vanity-collision window for spoofed recipients.
    Formatter / parser rewrite:
    - format_decimal returns Option<usize> and refuses to silently
    truncate; overflow now surfaces as !AMOUNT OVERFLOW to the user.
    - parse() rejects chain_id=0, gas_limit<21_000, max_priority>max_fee,
    and malformed access list entries.
    - Added U256::ge and U256::saturatin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
    [mod.rs]
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2026-04-20 feat(names): merkle-verified address-name DB for trusted-UI labels
    Third DB parallel to ERC20 + VK: (chain_id, address) -> display name,
    so the OLED shows "+ Uniswap V3 Router" instead of 40 hex chars. Full
    blob lives in NS rodata; secure firmware holds only NAMES_DB_ROOT.
    Every name crosses a merkle-verify gate in secure/src/names/bundle.rs
    before reaching the trusted UI — failed verification silently falls
    back to raw hex.
    Storage: 16-byte sorted short_key = sha256("pqsigner-name-key-v1" ||
    chain_id_be || addr)[..16] shaves 12 B/entry vs storing (chain_id,
    addr) raw. Merkle leaf still binds the full (chain_id, address, name)
    triple, so short-key collisions cannot substitute names.
    Chai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
    [bundle.rs, cmd_sign_userop.rs, db_format.rs]
2026-04-20 feat(optiga): Stage-1 #24 — OTP-derived 64-byte PBS, stable across rebuilds
    Closes the firmware_hash-in-wrap-key brick class by deriving the OPTIGA
    Trust M Platform Binding Secret from a per-device OTP master via RFC-5869
    HKDF-Expand-SHA256, instead of a TRNG-generated random sealed to MCU
    flash page 126 under a wrap key that mixed in
    measured_boot::firmware_hash().
    Core pipeline:
    - hw/otp.rs extended with read_device_master / burn_device_master /
    is_device_master_burned / ensure_device_master over OTP bytes 128..160
    (two quad-words past the rollback tally). First-boot self-burn pattern
    per Trezor's secret_keys.c:177-194 — no factory Makefile step, the
    device TRNG-burns 32 byte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
    [flash.rs, main.rs, mod.rs, otp.rs, secret_keys.rs, shield.rs]
2026-04-20 fix(optiga): RST pin is PE4 (Arduino D5 on B-U585I-IOT02A), not PE0/PD5/PA4
    Follow-up to Stage-1 #24 hardware validation. Using the LA1010 logic
    analyzer on the Arduino D5 header with CH2, the RST signal lights up
    only when PE4 is toggled — confirmed by pulsing all four candidate
    pins (PA4 / PD5 / PE0 / PE4) with distinct pulse widths at boot and
    observing which one produces a visible edge.
    The long-running "works on the bench chip" path was masking this:
    - Bench chip was a previously-burned unit recovered via SetObject-
    Protected; its session state happened to be tolerant of the I²C-
    level soft_reset (REG_SOFT_RESET=0x88) alone.
    - Fresh silicon is stricter — the first SetData-fami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
    [main.rs, mod.rs, pin_diag.rs]
2026-04-20 fix(optiga): AUTH_REF/ENTROPY/MASTER/VK OIDs out of SRM's valid range
    The OPTIGA Trust M V3 SRM's OID table (§"Data Objects") lists the
    arbitrary-data type-3 range as **0xF1D0..0xF1DB** — twelve slots,
    not sixteen. Addresses 0xF1DC..0xF1DF are undefined gap slots. A
    loose reading of the SRM's running-text mention "(e.g.
    0xF1D0-0xF1DF)" led an earlier bring-up commit to assume a
    contiguous 16-OID range, and when pins F1D0..F1D5 turned up locked
    from prior tests on the bench chip, the OIDs were rotated to
    0xF1DC..0xF1DF. That rotation quietly broke provisioning against
    any pristine chip — SetDataObject to F1DC returns Status=0xFF on
    fresh silicon. The bench chip's apparent success was cir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
    [apdu.rs]
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2026-04-20 fix(optiga): gate lock_oid behind optiga-lock-operational, split prod todos
    Stops dev iteration from ever flipping an OPTIGA user OID to
    LcsO=Operational. Per SRM §"Life Cycle Status", LcsO is monotonic
    (Creation → Initialization → Operational → Termination, no reverse),
    so every `lock_oid` call on a chip was a one-way commit of that
    OID's metadata. The default Phase-A bringup was calling it on
    F1D0..F1D4 + F1E1, which cost us the current bench chip's
    reusability as a clean-slate test target.
    - `secure/src/optiga/mod.rs::lock_oid` now logs
    `[OPTIGA/prov] OID 0xNNNN lock_oid SKIPPED (optiga-lock-operational
    OFF; LcsO stays at Creation, metadata still mutable)` when the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
    [mod.rs]
2026-04-20 feat(cowswap): v3 clear-signing — render full order on trusted UI
    Wires the v3 `cowswap_eip712_order` circuit into the UserOp
    sign path (`cmd_sign_userop`), so the device renders the actual
    GPv2Order the user is pre-signing: kind, amounts, token symbols,
    receiver, expiry, fee, appData — 8 pages, every field Poseidon-bound
    to a Groth16 proof the secure world verifies before any signature is
    produced.
    Previously `setPreSignature(orderUid, true)` only showed the static
    22-byte "Pre-sign CowSwap order" string because the v1 circuit just
    binds the 164-byte calldata. The orderUid itself is a keccak256 that
    hides tokens/amounts/appData; users had no trustless way to verify
    what they were autho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
    [cmd_sign_userop.rs, lib.rs, mod.rs]
2026-04-20 fix(optiga): drop LcsO=op bump from ensure_shield — PRL works in Creation
    The `ensure_shield` path was unconditionally calling
    `ensure_pbs_lcso_operational()` before every `shield.establish()`,
    on the mistaken belief that the PRL state machine required E140 at
    LcsO=Operational. Cross-checked against the Infineon host library,
    the reference example, and the SRM — that belief is wrong:
    - `example_pair_host_and_optiga_using_pre_shared_secret.c:30-35`
    explicitly uses `#define FINAL_LCSO_STATE (LCSO_STATE_CREATION)`
    and completes Shielded Connection from Creation state.
    - `ifx_i2c_presentation_layer.c:820-829` dispatches into the PRL
    handshake on `protection_level != NO_PROTECTION` alo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
    [main.rs, mod.rs]
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2026-04-21 refactor(sign): extract trailer parser, display picker, v1 verify+bind; split cowswap module
    Consolidates three drifted open-coded u16-prefixed trailer parse sites in
    cmd_sign_userop into `nsc::trailer::read_optional_u16_prefixed`. Moves
    the display priority ladder (v3 CoW > v1 ZK > value/ERC-20/blind) into
    `tx::display::pick_sign_pages` so the handler stays a pure orchestrator.
    Pulls the v1 ZK clear-sign verify-and-bind pipeline into
    `zk::verify_and_bind_trailer_v1` (trailer sizing, Groth16+VK Merkle,
    chain+contract match, calldata prefix+zero-tail binding). Unifies the v1
    and v3 VK-injection NS helpers behind a shared `inject_vk_bundle_at`.
    Splits the monolithic `tx::eip712::cowswap` file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
    [cmd_sign_userop.rs, lib.rs, mod.rs, trailer.rs, verify.rs]
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2026-04-21 test(fwup): non-destructive hw logic test — make test-update-hw
    Automated harness that exercises every CMD_FW_* surface on real
    STM32U585 hardware without burning an OTP bit or erasing the inactive
    slot. 12 subtests — PIN gate, status/abort/chunk/commit sans session,
    and BEGIN rejection paths (bad size, magic, CRC, digest, plus a full
    verify-chain manifest rejected at the last gate). Verified PASS end-to-
    end on B-U585I-IOT02A.
    Safety by construction:
    * Never issues CMD_FW_COMMIT → no otp::bump_to → zero OTP bits burned.
    * BEGIN's happy-path manifest sets fw_version=0 so verify_rollback
    fails strictly (`fw_version > floor`, floor >= 0 always), which is
    the last check bef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
    [main.rs]
2026-04-21 fix(optiga): Shielded Connection handshake — drop master_random, seq from SlaveHello
    MasterFinished was being rejected on real silicon with a 7-byte alert frame
    ([0a 00 02 08 40 ...]) because three pieces of our PRL-layer construction
    diverged from Infineon's reference (`ifx_i2c_presentation_layer.c:285-621`):
    1. PRF seed was `random_M || random_S` (64 B). Reference uses only `random_S`
    (32 B) — `prl.random` is a single 32-byte buffer with no master-side
    contribution at all.
    2. MasterFinished plaintext was `random_M || slave_seq` (36 B). Reference is
    `random_S || slave_seq`.
    3. MasterFinished header seq / CCM nonce counter / AAD seq were all 0.
    Reference uses `slave_sequence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
    [main.rs, mod.rs, shield.rs]
2026-04-21 feat(optiga): provisioning through Shielded Connection — presence bit + re-handshake
    Three bugs in the provisioning-through-shield path, uncovered validating
    re-provisioning against a partially-provisioned chip on real hardware:
    1. **`send_command` routed protected records via `ifx.transceive` (no
    PRESENCE_BIT), not `ifx.transceive_prl`.** The encrypted record hit
    the chip's APDU parser instead of its PRL layer — chip read our
    SCTR=0x23 as a CMD byte, failed to parse, and the PRL state machine
    emitted SCTR=0x40 (PRL_FATAL_ALERT_MSG). Record-layer I/O was never
    reachable. Fix: call `transceive_prl` once `shield.active`.
    2. **`hard_reset_and_reinit` didn't clear `shield.ac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
    [apdu.rs, mod.rs]
2026-04-21 feat(optiga): skip set_metadata on already-Operational OIDs
    When an F1Dx or F1E1 OID is at LcsO=Operational, the one-way ratchet
    blocks any subsequent `set_metadata` — the chip returns Status(255)
    regardless of Change AC, DataType, or session protection level. This
    happens on chips whose provisioning ran before commit 45a5e9a (where
    `lock_oid` was unconditional and bumped every OID to Op).
    Mitigation: before each `set_metadata` call in `provision_auth_ref` /
    `provision_user_oid` / `provision_counter`, read the OID's current
    metadata and check the LcsO tag (0xC0) via `apdu::is_metadata_
    operational`. If already Operational, skip both `set_metadata` and
    `lock_oid` — the object's functiona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
    [mod.rs]
2026-04-21 chore(optiga): fix misleading provisioning-complete log
    The final "Provisioning complete (6 OIDs written + locked)" line is
    a leftover from the pre-45a5e9a era when `lock_oid` was unconditional
    and actually bumped every OID to LcsO=Operational on every run. The
    phrasing scares anyone auditing whether a run irreversibly modified
    the chip.
    Today the realistic path is: `optiga-lock-operational` is OFF so
    `lock_oid` is a log-and-return no-op, and the LcsO-Op skip guard
    (commit 635e018) takes an early return before `lock_oid` is even
    called when the OID is already Op. No LcsO tag has been written to
    any OID in the normal dev flow since commit 45a5e9a.
    Say it plainly so the log reflects what act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
    [mod.rs]
2026-04-21 feat(optiga): PIN unlock through Shielded Connection — GenerateAuthCode + HMAC-SHA-256 param fix
    Two fixes required to make the AUTHREF-based PIN gate work against real
    silicon, both caught by diffing our APDU layer against Infineon's
    reference (`example_optiga_hmac_verify_with_authorization_reference.c`
    and `common/optiga_lib_common.h`).
    1. **`PARAM_HMAC_MODE` was 0x02; should be 0x20.** The `cmd_param` byte
    on a DecryptSym-in-HMAC-verify APDU selects the HMAC variant —
    `optiga_hmac_type_t::OPTIGA_HMAC_SHA_256 = 0x20`
    (`optiga_lib_common.h:213`). 0x02 is a different symmetric mode
    entirely (AES variant), which the chip read our input format under
    and rejected with Status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
    [apdu.rs, mod.rs]
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2026-04-21 feat(optiga): factory_reset roundtrip e2e + harden with ensure_shield
    Scope: exercises the `factory_reset` primitive end-to-end. The PIN-
    lockout-triggers-wipe integration is deferred to a separate test.
    Part (a) — harden factory_reset
    Explicitly call `self.ensure_shield()?;` at the top of
    `OptigaTrustM::factory_reset`. Every subsequent `set_data_object`
    must satisfy the `Conf(E140)` arm of the user OID's Change AC.
    `authenticate_and_read` already brings the shield up on the PIN-
    lockout path, but the e2e test harness calls `factory_reset`
    directly, so correctness shouldn't depend on caller ordering.
    Part (b) — optiga-admin-wipe-e2e test
    New `run_admin_wipe_roundtrip` on `OptigaTrustM`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
    [main.rs, mod.rs]
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2026-04-21 refactor(dual-se): scope e2e test to unlock roundtrip (not admin wipe)
    Rename `dual-se-admin-wipe-e2e` → `dual-se-unlock-e2e`. Drop steps
    6-8 (factory_reset_admin + post-wipe verification). The test now
    validates what is unique to the dual-SE integration — XOR entropy
    reconstruction + master_secret cross-verify across OPTIGA + SE050 —
    and leaves the admin-wipe dispatch validation to the single-SE
    tests (which cover the primitives) plus a future fresh-chip-only
    target.
    Why: the dual-SE `factory_reset_admin` test deterministically fails
    on any SE050 whose admin UserID PIN has drifted out of sync with
    page-125 flash. That desync is possible whenever cross-test
    contamination erases page 1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
    [dual_se.rs, main.rs]
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2026-04-21 feat(se050): bump OID range v3→v4 (0x7B06_→0x7B0C_) to unblock bench chip
    Cross-test contamination on 2026-04-21 left the bench SE050's v3 range
    (UserID at 0x7B06_0000, admin at 0x7B06_00A0, three user-gated data
    objects) in a state where no software can wipe the admin UserID: flash
    page 125 was erased by the earlier OPTIGA test's post-hygiene (since
    removed), so the admin PIN that was TRNG-generated at first-boot
    provisioning is lost. The admin UserID has unlimited-attempts policy
    so it doesn't lock out, but nothing can auth against it.
    Symmetric with the v2→v3 bump the repo did earlier for the same class
    of problem (stale objects from pre-0x7B06_xxxx-era firmware, see
    `Range v3` com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
    [dual_se.rs, main.rs, mod.rs]
2026-04-21 fix(dual-se): decrypt SE050 entropy blob with SE050's own master_secret
    Dual-SE unlock on real silicon surfaced two related asymmetries
    between OPTIGA and SE050 that had never been hit before:
    1. OPTIGA stores `master_secret` explicitly and returns the stored
    bytes on unlock. SE050 stores only its entropy half; its `unlock`
    derives a "master_secret" via `kdf("sphincs-master", half_e, 0)`
    — meaningful only in single-SE mode where `entropy == full
    entropy`. In dual-SE, the two values are necessarily different.
    2. Each SE caches its entropy_blob encrypted under ITS OWN master.
    OPTIGA → encrypted under the stored master_secret. SE050 →
    encrypted under its derived `kdf(h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
    [dual_se.rs]
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2026-04-21 fix(se050): conditional page-125 erase + OID range v4→v5
    Root cause of today's v4 retirement: `Se050::factory_reset_admin` (the
    production WalletStore wrapper, not the primitive) unconditionally
    called `erase_admin_page()` at the end, even when the inner
    `admin_factory_reset()` returned Transport. On a glitched verify_session,
    the chip's admin UserID survived while the matching flash PIN was
    burned → permanent desync at 0x7B0C_00A0, same class as v3.
    Three changes to fix the class of bug, no OTP/HUK/DHUK touching:
    1. Production `Se050::factory_reset_admin` gates the erase on
    `!admin_exists()`. If the chip admin survived (Transport glitch,
    partial wipe, etc.), flash state is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
    [dual_se.rs, main.rs, mod.rs]
2026-04-21 feat(dual-se): restore full admin-wipe e2e — PASS on real silicon
    Re-adds the factory_reset_admin + post-wipe verification steps that
    were dropped in 3204d57 when the bench chip was in an unrecoverable
    v4 desync state. With the v5 range + conditional-erase fix from
    02f75c5, the full 8-step integration now runs cleanly:
    1. Pre-clean cascade
    2. Verify both unprovisioned
    3. Provision with test data (entropy 0x55, vk 0xAA, bvk 0xBB,
    pin "dualwipe")
    4. Verify both provisioned
    5. Unlock + verify master_secret via XOR reconstruction
    6. DualSecureElement::factory_reset_admin()
    7. Verify both unprovisioned post-wipe
    8. Post-wipe unlock must fail (no seed derivable from wiped p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
    [dual_se.rs, main.rs]
2026-04-21 feat(optiga): single-SE OPTIGA standalone + dev-testkey recovery path
    Adds three pragmatic Makefile targets for bench iteration on boards
    whose STM32U585 OTP master-key region rejects programming with WRPERR
    (observed on a Rev W B-U585I-IOT02A with clean option bytes):
    - flash-hw-optiga-oled-standalone: OPTIGA-only twin of the SE050
    standalone target, LcsO=Creation throughout.
    - optiga-factory-reset-hw: "nuclear" wipe that relaxes F1E1's Change AC
    via set_metadata (mutable at LcsO=Creation regardless of data Change
    AC) and writes RESET_SENTINEL plaintext — no PBS/shield/OTP needed.
    - flash-hw-optiga-oled-standalone-testkey / flash-hw-optiga-oled-testkey:
    interactive wizard + PIN e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
    [apdu.rs, main.rs, mod.rs, otp.rs]
2026-04-22 feat(pin): MCU-side attempt counter at flash page 126 (dual-SE sync)
    Phase 1 of work-todo #4 (dual-chip PIN lockout synchronization).
    Trezor-parity MCU-side authoritative counter: every PIN attempt
    bumps page 126 BEFORE the SE verify (pre-commit), so a power-loss
    or glitch mid-verify still charges the attempt.
    Mechanism (secure/src/hw/flash.rs):
    - Page 126 (0x0C0F_C000, freed by work-todo #24) now holds 32
    "attempt slots" — one 16-byte quadword each. Count = number
    of programmed QWs (sentinel `[0x00; 16]` vs blank `0xFF`).
    - pin_attempts_read / pin_attempts_bump / pin_attempts_reset.
    - Encoding sidesteps STM32U5's "word programmed once" rule:
    each bump writes a fresh bla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
    [cmd_request_unlock.rs, flash.rs, main.rs, mod.rs]
2026-04-22 test(pin-gate): non-interactive e2e for MCU-side attempt counter
    New `pin-gate-e2e` Cargo feature + `make pin-gate-e2e` target — direct
    validation of work-todo #4 Phase 1 (`nsc::gated_unlock` + flash page
    126) without needing buttons or USB PIN entry.
    Flow:
    0. factory_reset_admin + pin_attempts_reset → blank state.
    Assert pin_attempts_read() == 0.
    1. Provision(entropy, master, vk, bvk, CORRECT_PIN="00000000").
    2. gated_unlock(WRONG_PIN) × 3. Each returns PinIncorrect.
    After each, assert counter == 1/2/3.
    3. gated_unlock(CORRECT_PIN). Returns Ok(master_secret).
    Assert counter == 0 (page 126 erased on success).
    4. Second bump+reset cycle to prove repeatability.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
    [main.rs]
2026-04-22 fix(flash): move MCU PIN-attempt counter from page 126 to page 124
    Page 126 (the former OPTIGA PBS seal page freed by work-todo #24) is
    in an unexpectedly write-hostile state on the current bench chip:
    `pin_attempts_reset()` returns Ok with no SR error, but subsequent
    `write_quadword_verified(QW0)` fails with SR=0x88 (PROGERR|PGSERR)
    — i.e. the erase appears to succeed but doesn't actually clear the
    page's ECC state, so the next program is rejected.
    Page 124 has truly never been written to and accepts fresh writes
    without drama. All existing callers (gated_unlock pre-commit, boot-
    time lockout check, trigger_lockout_wipe erase) reference the
    constant, so the switch is a one-line retarget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
    [flash.rs, main.rs]
2026-04-22 fix(flash): invalidate ICACHE after every mutation — pin-gate-e2e PASS
    On STM32U5 the transparent instruction/data cache in front of flash is
    not automatically invalidated when the underlying flash changes. The
    bug manifested as `write_quadword_verified` failing its readback
    compare: the controller reported Ok with no SR error, but the cached
    pre-mutation bytes still satisfied the read — so the verify returned
    Err with the actual flash content correct. Trivially reproducible when
    a region is read before the mutation (cached), then erased/programmed,
    then read again — exactly the pin-gate-e2e flow on page 124.
    Wire `icache_invalidate()` into the four mutation paths that can be
    followed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
    [flash.rs]
2026-04-22 feat(optiga): silicon PIN counter via E120 LUC binding (Trezor-parity)
    Replace the soft F1E1 counter with OPTIGA's hardware monotonic counter
    at 0xE120, bound to F1D0's Execute access condition via LUC (Lifetime
    Usage Counter). Every HMAC-verify against F1D0 now auto-increments
    E120 inside the chip, and once `current == limit` the AuthRef refuses
    auth regardless of PIN bytes. Firmware resets E120 back to `(0, limit)`
    after every successful PIN via SetDataObject — E120's Change AC is
    `Auto(OID_AUTH_REF)`, so the very HMAC auth that just succeeded
    authorizes the counter reset. An attacker who extracts the Platform
    Binding Secret (and thus the Shielded Connection key) cannot bypass
    this: the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
    [apdu.rs, mod.rs]
2026-04-22 feat(optiga): hw-counter e2e test + fail-closed LcsO=Op check
    Adds `optiga-hw-counter-e2e` (feature flag + Makefile target) that
    drives the full silicon PIN counter flow on real silicon:
    1. Provision (rewrites F1D0 metadata to the LUC variant + provisions
    E120 as the silicon counter).
    2. Read E120 — expect `(current=0, limit=HW_PIN_CTR_LIMIT)`.
    3. Wrong PIN → expect `PinIncorrect` AND E120.current == 1 (silicon
    auto-bumped via LUC).
    4. Correct PIN → expect Ok(master_secret) AND E120.current == 0
    (firmware reset via SetDataObject, authorised by the HMAC verify
    that just ran).
    5. Two wrong PINs → E120.current == 2.
    6. Repeat correct PIN → E120.current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
    [apdu.rs, main.rs, mod.rs]
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2026-04-22 feat(optiga): hw-counter validated on real silicon — LUC fires correctly
    E2E test `optiga-hw-counter-e2e` passes all 6 steps on a fresh
    TRUSTMV3SHIELDTOBO1:
    step 2: E120 initial = (0,32) OK
    step 3: wrong PIN → E120.current=1 OK ← LUC increments on failed auth
    step 4: correct PIN → E120 reset to 0 OK ← reset-on-success works
    step 5: burst 2 wrong PINs → E120.current=2 OK
    step 6: repeat correct PIN → E120 reset OK
    HW-COUNTER ROUNDTRIP: PASS
    Two substantive fixes this commit, both discovered only by running on
    real silicon and reading back stored metadata byte-by-byte:
    1. **Trezor-shape DecryptSym + GetRandom APDUs.** Infineon's
    `hmac_verify_with_authorizatio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
    [apdu.rs, mod.rs]
2026-04-22 test: combined MCU + OPTIGA E120 counter sync + desync recovery e2e
    Validates the full dual-counter pipeline on real silicon under
    `dual-se + optiga-hw-counter`:
    phase-0 post-provision: MCU=0, E120.curr=0 ✓
    phase-1 after wrong PIN: MCU=1, E120.curr=1 ✓ (lockstep)
    phase-1 after correct: MCU=0, E120.curr=0 ✓ (both reset)
    phase-2 desync MCU-ahead: MCU=2, E120.curr=0 (pin_attempts_bump × 2)
    phase-2 after correct: MCU=0, E120.curr=0 ✓ (absorbed)
    phase-3 desync OPT-ahead: MCU=0, E120.curr=1 (direct se.optiga.unlock)
    phase-3 after correct: MCU=0, E120.curr=0 ✓ (absorbed)
    [E2E-SYNC] SYNC+DESYNC ROUNDTRIP: PASS
    Key property confirmed: under `nsc::gated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
    [main.rs]
2026-04-22 docs(optiga): coverage note on PinLocked gate — validated by inspection
    Per advisor consult 2026-04-22: the `curr >= limit` gate in
    `authenticate_and_read` is not exercised on silicon. Running the
    exhaustion test would burn 32 consecutive wrong-PIN LUC increments on
    our last remaining provisioned TRUSTMV3SHIELDTOBO1, with unknown
    cumulative wear from repeated reset-on-success cycles. The load-bearing
    silicon-side LUC enforcement is covered by `optiga-hw-counter-e2e`; the
    firmware-side compare is a trivial conditional. Comment documents the
    gap so future readers don't assume end-to-end coverage.
    [mod.rs]
2026-04-22 feat(pin-sync): three-way MCU+OPTIGA+SE050 lockstep validated on silicon
    Closes the dual-chip PIN lockout sync that was flagged as "best-effort
    for now" in dual_se.rs:126-128 since initial provisioning. Empirically
    validated: `make pin-gate-hw-counter-e2e` now exercises all three
    counters across 5 phases and passes on a fresh TRUSTMV3SHIELDTOBO1:
    phase-0 post-provision: MCU=0 E120.curr=0 SE050.rem=10
    phase-1 after wrong: MCU=1 E120.curr=1 SE050.rem=9
    phase-1 after correct: MCU=0 E120.curr=0 SE050.rem=10
    phase-2 MCU-ahead (2,0,10) → correct → (0,0,10)
    phase-3 OPTIGA-ahead (0,1,10) → correct → (0,0,10)
    phase-4 SE050-ahead (0,0,9) → correct → (0,0,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
    [cmd_get_remaining.rs, dual_se.rs, main.rs, mod.rs]
2026-04-22 feat(pin-sync): boot-time re-sync of SE cache vs MCU counter
    Closes Gap 1 from the three-way sync postmortem. The `remaining`
    software mirrors on both `Se050` and `OptigaTrustM` are
    `const fn new()`-initialised to `MAX_ATTEMPTS` on every power-on,
    while MCU page-124 retains the durable attempt count across reboots.
    Before this commit, the gap was compensated at the gateway layer by
    including the MCU counter in `cmd_get_remaining`'s MIN — the display
    stayed honest, but the SE-level caches themselves were lying until
    the next successful unlock resynced them. Any future code that read
    the driver cache directly (and grep confirmed today there's only
    display-layer consumption) would see the sta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
    [dual_se.rs, main.rs, mod.rs, secure_element.rs]
2026-04-22 feat(pin-sync): MCU MAX_ATTEMPTS → wipe dispatch e2e validated on silicon
    Closes Gap 3 from the three-way sync postmortem. Adds the destructive
    companion to `pin-gate-hw-counter-e2e` that exercises what happens
    when the user actually burns through the entire PIN attempt budget
    in a real dual-SE flow, and proves the lockout-wipe dispatch path
    recovers cleanly.
    Flow validated on real TRUSTMV3SHIELDTOBO1 + NXP SE050:
    baseline: MCU=0 E120.curr=2 SE050.rem=10
    iter 1..=10: MCU={i} E120={2+i} SE050={10-i} — all advance in lockstep
    post-burn: MCU=10 E120.curr=12 SE050.rem=0 — counters saturated
    MCU gate: 11th gated_unlock → PinLocked — MCU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
    [main.rs]
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2026-04-22 feat(optiga): reset E120 on factory_reset via Trezor transient-auth pattern
    Closes the multi-wipe soft-brick gap. Before this commit, E120's
    silicon LUC counter value survived every factory_reset:
    `factory_reset` wipes F1D0..F1D4 under Conf(E140) but cannot reach
    E120 because its Change AC is `Auto(F1D0)` — and the user's PIN is
    gone at wipe time.
    Multi-cycle soft-brick path (DoS only, not a seed compromise):
    1. User burns 10 wrong PINs → MCU wipe fires. E120 = 10.
    2. Fresh provision. User sets new PIN, burns 10 more → wipe. E120 = 20.
    3. Fresh provision. Same again → wipe. E120 = 30.
    4. Any next attempt sends E120 to ≥32 = HW_PIN_CTR_LIMIT. The
    `curr >= limit` pre-ch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
    [main.rs, mod.rs]
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2026-04-22 feat(wipe): add wipe-for-wizard target for dev provisioning iteration
    One-shot developer target: wipes OPTIGA user OIDs + SE050 user
    objects + MCU PIN-attempt counter, leaves firmware resident so the
    next cold boot enters the first-boot wizard with whatever fresh PIN
    the user enters. Fills the gap between the existing options:
    - `make factory-reset` — nukes the firmware too, requires re-flash
    (~2 min workflow per iteration)
    - `make pin-gate-wipe-e2e` — wipes + auto-re-provisions with the
    fixed test mnemonic/PIN, so you can't set your own PIN afterwards
    - `make dual-se-admin-wipe-e2e` — ends with the test provisioning,
    same problem
    The new target halts at "WIPED — power-cycle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
    [main.rs]
2026-04-22 fix(wipe): wipe-for-wizard — idempotent + fall-through to wizard
    First pass of `wipe-for-wizard` had two bugs that prevented it from
    delivering the "wipe → power-cycle → wizard" workflow users actually
    want:
    1. **Feature set triggered auto-provision.** `wipe-for-wizard`
    transitively pulled in `e2e-test` (to bypass the
    `otp-hardcoded-master-key` compile_error gate). But
    `e2e-test` is ALSO what the main() first-boot wizard branch is
    gated AGAINST (`#[cfg(not(feature = "e2e-test"))]` at line
    ~1745) — so on boot 2 the wizard never ran; instead the
    `e2e-test` auto-provision fast-path silently re-provisioned
    with the fixed test mnemonic + PIN 00000000. User would neve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
    [main.rs]
2026-04-23 fix(se050): retry interface_reset on cold-boot T=1 race
    Se050::init() fired S(INTF_RESET_REQ) once after a fixed 500_000-nop
    (~3 ms) settle. On a true cold USB-C power-up the SE050's regulator
    and T=1 scheduler need 20–200 ms to become responsive; the single-shot
    reset hit inside that window, returned Err(T1Error), init() returned
    Err(Se050Error::Transport), check_provisioned() short-circuited to
    false via its `if self.init().is_err() { return false; }` guard,
    DualSecureElement::is_provisioned() went true && false = false, and
    main.rs:1862 dropped the already-provisioned device into the first-
    boot wizard. Warm `probe-rs reset` paths hid the bug because the
    SE050 was still powered from the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
    [cmd_sign_userop.rs, dual_se.rs, lib.rs, main.rs, mod.rs, nsc_api.rs, secret_keys.rs]
2026-04-23 feat(aa): CMD_GET_INIT_CODE for first-deploy gas estimation
    Adds a new APDU command (0x61 / CMD 15) that returns the 4280-byte
    ERC-4337 initCode for (account_index, chain_id) without running a full
    UserOp sign. Bytes are byte-identical to what the deploy path of
    CMD_SIGN_USEROP emits, so the companion can use them for
    eth_estimateUserOperationGas on a not-yet-deployed wallet and then
    cache the result across the rest of that (account, chain) pair's
    lifetime — SPHINCS+ is stateless and the signed message depends only
    on chain_id + slot-0 keys.
    Also fixes a latent cursor-misalignment bug in the NS router's trailer
    injection pipeline: when a bare payload got an ERC-20 metadata bundle
    auto-inj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
    [cmd_get_init_code.rs, cmd_sign_userop.rs, lib.rs, mod.rs, nsc_api.rs]
2026-04-23 fix(optiga): move RST wire to D6 (PE0) to eliminate SE050 ENA cross-coupling
    The OPTIGA RST wire was on Arduino D5 header = STM32 PE4 on
    B-U585I-IOT02A. The OM-SE050ARD shield routes its D5 header to the
    SE050's ENA (power enable) line. Every `hard_reset_and_reinit` pulse on
    PE4 also power-cycled the SE050 — if it landed mid-NVM-write during
    provisioning, ENTROPY_OBJ ended up with partially-updated bytes.
    `check_exists` still saw the object, but read-back returned corrupted
    data. XOR'd with fresh half_O on the next unlock produced garbage →
    "master_secret mismatch" on reboot.
    Fix (hardware): RST wire moved from D5 to D6 header, which has no
    SE050 net on the OM-SE050ARD shield.
    Fix (fir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
    [dual_se.rs, main.rs, mod.rs, pin_diag.rs]
2026-04-23 fix(se050): admin-wipe path uses OTP-derived PIN + per-object diagnostics
    Two bugs made `dual-se-admin-wipe-e2e` step 7 fail with "SE050 still
    provisioned after wipe" on real silicon:
    **1. Stale admin-PIN source in `factory_reset_admin` trait impl**
    Provisioning writes the SE050 admin UserID with an OTP-derived PIN
    (`hw::secret_keys::se050_admin_pin()` via HKDF), but the trait-level
    `factory_reset_admin` was still reading from legacy flash page 125.
    On v6 OTP-derived provisionings page 125 is blank, so the code fell
    into `iterative_wipe(None, None)` — the unauthenticated sweep — which
    cannot delete admin-gated user objects. User data (ENTROPY_OBJ,
    USERID_OBJ, etc.) survived every wipe,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
    [mod.rs]
2026-04-23 fix(se050): fail loud on stale user objects surviving admin sweep
    Bug 2 (work-todo #28) hardening: `store_objects` previously had a
    `skip-if-exists` branch on USERID_OBJ, ENTROPY_OBJ, VK_OBJ, BOOTSTRAP_VK_OBJ
    that silently inherited any pre-existing policy shape. If a prior
    firmware wrote an object with a buggy policy (wrong byte-order,
    1-entry policy, stale ADMIN_WIPE_OBJ reference) the current
    firmware would quietly reuse it — permanently stamping the device
    with an un-admin-wipeable policy and no error path.
    In practice the pre-existing admin-auth stale-sweep (lines 991-1059)
    handles the v6 same-admin-obj case: it deletes prior user objects
    before the write-once check fires, so subsequ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
    [mod.rs]
2026-04-23 fix(se050): extend policy_roundtrip_selftest to 6-canary admin session
    Bug 3 (work-todo #29): the pre-refactor selftest wrote + deleted 2
    canary objects under one admin session, but production's
    `admin_factory_reset` deletes 6 user objects + self-delete under
    ONE session. If SE050 ever invalidated the session after the Nth
    delete (for N > 2), the selftest would pass while production
    silently no-op'd from delete N+1 onward — the Bug 1 silent-swallow
    would have masked the failure.
    Fix: selftest now writes 6 canaries (1 UserID + 5 data objects,
    all with the same 2-entry TAG_POLICY as production objects), opens
    one admin session against ADMIN_WIPE_OBJ, deletes all 6 + logs
    per-object Ok/Err,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
    [mod.rs]
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2026-04-24 feat(saes): Tier-1 DHUK driver + cross-boot-validated self-test
    New `secure/src/hw/saes.rs` under the `saes-dhuk` feature (OFF by
    default). AES-256 ECB primitive under KEYSEL={Software, Dhuk, Bhk,
    DhukXorBhk}; hardware CMAC mode skipped — the `cmac` crate will
    wrap the ECB block in software when secret_keys::derive_into flips
    in task #31.
    Register offsets + bit positions cross-checked against the stm32u5
    PAC (machine-generated from ST's SVD) AND the STM32CubeU5 CMSIS
    header + HAL CRYP driver.
    Boot-time self-test under `saes-self-test` exercises SW round-trip,
    DHUK-vs-SW domain separation, DHUK round-trip, and logs an 8-byte
    DHUK fingerprint before clean SYS_EXIT. Makefile target
    `saes-se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
    [main.rs, mod.rs, saes.rs]
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2026-04-24 feat(saes): RDP1 self-test harness — UART VCP output + regression flow
    At RDP0 the STM32U585 DHUK is an ST-substituted known constant
    shared across every chip, so the same-board cross-boot stability
    proof is the most the RDP0 self-test can provide. The REAL per-
    die DHUK only activates at RDP ≥ 1, where SWD debug is disabled
    and semihosting / probe-rs can't see the output.
    Solution: route the fingerprint over USART1 → ST-LINK VCP (PA9
    TX → on-board debugger MCU → USB virtual-COM-port). The VCP is
    an ST-LINK feature independent of the target's RDP level, so the
    bytes reach the host regardless of SWD state.
    Added:
    - `secure/src/hw/uart.rs` — minimal USART1 driver, 115200 8N1,
    p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
    [main.rs, mod.rs, saes.rs]
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2026-04-24 feat(tier1): flip secret_keys::derive_into to SAES-CMAC(DHUK) KDF
    Completes work-todo #7 Tier-1 item #31 — the one remaining derivation-
    call-site change after the SAES driver landed in a6760df. Three cfg
    paths are now supported:
    otp-hardcoded-master-key → HKDF-Expand over the ASCII constant
    (unchanged; byte-for-byte bench compat)
    saes-dhuk, hardcoded OFF → simplified SP 800-108-style CMAC-based
    counter KDF: SAES-CMAC(DHUK, label || ctr)
    with ctr starting at 1 and capped at 255
    neither feature → legacy HKDF-over-OTP-master fallback so
    existing hw bui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
    [cmac.rs, main.rs, mod.rs, secret_keys.rs]
2026-04-24 feat(trezor-audit): FI helpers + proptest + TAMP/consumption-mask/ui-capture
    Lands five dev-board-safe adoptions from the Trezor T3W1 firmware audit.
    Full rationale + per-subsystem source pointers in docs/trezor-comparison.md.
    Fault-injection hardening (secure/src/fi.rs)
    * wait_random() — port of Trezor's i+j==wait double-invariant glitch
    sentinel (core/embed/sec/random_delays/stm32/random_delays.c:186-202).
    No-op under e2e-test for deterministic timing.
    * check_true() — double-eval + hamming-distant sentinel (OK=0xA5A5A5A5,
    FAIL=0x5A5A5A5A) so a single glitch can't turn FAIL into OK.
    * Wired into c10_sign_verified_with_progress (internal verify), the
    external v1/v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
    [bench_key_speed.rs, cmd_sign_userop.rs, consumption_mask.rs, crypto.rs, dual_se.rs, fi.rs, flash.rs, fuzz_props.rs]
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2026-04-26 feat(safe): all-native `safe_v1` clear-sign trailer for `approveHash(bytes32)`
    Mirrors the CowSwap v3 trailer architecture but skips Groth16 entirely:
    the `approveHash` selector puts the EIP-712 digest in the calldata, so
    the firmware brings the canonical SafeTx (281 B) plus raw inner-call
    data on-device and natively binds via two keccak chains —
    `keccak(raw_data) == canonical.data_hash` and `safeTxHash(canonical)
    == inner_data[4..36]` — plus chain + safe-address pinning, plus a v1
    DelegateCall refusal. Symmetric downgrade gate to CoW: `approveHash`
    calldata without a verified trailer aborts with "safe_v1 required".
    Once bound, the existing `(to, value, data)` decoder is reused: ETH
    tra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
    [cmd_sign_userop.rs, lib.rs, mod.rs, verify.rs]
2026-04-27 feat(selectors): host-resident 4byte DB, firmware-verified via Merkle root
    Selector → text-signature lookup as the fourth Merkle-rooted DB,
    parallel to ERC20 / VK / Names — but the blob lives on the host
    (future companion app) instead of NS rodata. Only the 32-byte
    SELECTOR_DB_ROOT rides in the secure image. The host attaches a
    (selector, text_sig, leaf_index, proof) bundle through the existing
    `[u16 BE len][payload]` trailer slot in CMD_SIGN_USEROP; the secure
    world Merkle-verifies against the embedded root AND cross-checks
    `bundle.selector == calldata[0..4]` before any byte hits the OLED.
    Trust property: companion is a pure relay — cannot forge bundles
    (proof fails), cannot substitu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
    [bundle.rs, cmd_sign_userop.rs, db_format.rs, main.rs, mod.rs]
2026-04-27 feat(typed-call): Phase 2 typed-args calldata render before BLIND SIGN
    Inserts a strict ABI-decode gate between the ERC-20 dispatch branch and
    `render_blind_sign_pages`. When the host attached a verified
    `(selector, text_sig)` bundle and the calldata's static + dynamic
    geometry matches the parsed type list exactly, the trusted UI now
    shows typed argument pages instead of the raw word dump. Any parse
    failure, shape mismatch, unsupported type, or per-arg cap overflow
    returns `None` and the existing Phase 1 BLIND SIGN flow renders with
    the FUNCTION page intact — Phase 2 never produces a partial typed
    render.
    Trust framing is unchanged: the bundle is still vendor-curated +
    Merkle-verified + c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
    [mod.rs]
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2026-04-28 feat(eip1271): off-chain signing path with on-chain combined-cap & durable counter
    Adds the wallet-side EIP-1271 surface and the per-slot durable off-chain
    sig counter that ensures the slot key never exceeds its SPHINCS+C10
    hypertree usage budget across a seed-restore.
    On-chain
    - `PQMultiOwnable` gets an `offchainSigCount[ownerIndex]` mapping plus
    `_setOffchainSigCount(ownerIndex, newCount, slotUsesNow, cap)` —
    monotonic + the combined invariant
    `slotUses + offchainSigCount <= MAX_SLOT_USES = 65_536`.
    - `PQSmartWallet.execute` / `executeBatch` are replaced by
    `executeWithOffchainCount(ownerIndex, newOffchainCount, target,
    value, data)` (and the batch variant). Every Type 2 UserO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
    [apdu.rs, apdu_framing.rs, cmd_offchain_status.rs, cmd_sign_offchain.rs, cmd_sign_userop.rs, flash.rs, fuzz_props.rs]
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2026-04-29 feat(deploy): redeploy contracts on Base Sepolia + Mainnet (EIP-1271 cutover)
    The on-chain stack (verifier + impl + factory) was stuck on the
    pre-EIP-1271 bytecode from the Apr-21 deploy, and the firmware now
    generates calldata for `executeWithOffchainCount` (selector 0x14443c57)
    which doesn't exist on that older impl. Redeploying all three contracts
    was the only way to ground the firmware against working on-chain code.
    Both chains land at byte-identical CREATE2 addresses (salt=bytes32(0),
    Arachnid 0x4e59… deployer):
    SPHINCsC10Asm: 0xb32e32a532d03a160ceb35af39b4a95ba4881fc7
    PQSmartWalletImpl: 0x155d7da5feef1811214a1271335a19fb3fce8f1e
    PQSmartWalletFactory: 0x67943487e9e41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
    [lib.rs]
2026-04-29 fix(offchain): unbreak signing on devices upgraded across the all-C10 cutover
    Signing surfaced "Sig commit FAIL" on a real PQ1 device whose page-123
    flash was inherited from the pre-all-C10 firmware (per the linker
    script: pages 123-124 were "formerly per-slot persistent state, freed
    by the all-C10 stateless-firmware cutover"). The off-chain counter
    journal lives there now and the firmware update doesn't erase it, so
    stale programmed bits ride along.
    Three independent bugs compounded:
    1. find_next_blank_idx only inspected the type byte at offset 8 to
    decide a QW was blank. With random stale bytes from old per-slot
    state, that single byte hits 0xFF often enough to mark a QW
    "blank"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
    [cmd_sign_offchain.rs, cmd_sign_userop.rs, flash.rs, offchain_state.rs]
2026-04-29 fix(offchain): make parse_entry mirror find_next_blank_idx's full-QW blank check
    `is_registered` / `offchain_count_read` / `last_userop_count_read` were
    short-circuiting at the first quad-word whose type byte at offset 8
    happened to read 0xFF, even when the QW's other 15 bytes were
    non-blank — exactly the shape page 123 inherits from pre-all-C10
    cutover firmware (per the symptom be4a03d already addressed for the
    write side). Result on a real device: `cmd_sign_offchain` refuses with
    OffchainSlotUnregistered after one or more successful UserOps that
    DID write valid USEROP entries past the stale QW. The writes landed
    correctly; readers just stopped scanning before reaching them.
    The fix is l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
    [flash.rs]
2026-04-29 feat(offchain): require trusted-display confirm for EIP-1271 sigs
    EIP-1271 sigs are silent-but-binding from the dapp's view, so they need
    the same user-on-device approval as a UserOp. Adds a 6-page confirm
    flow (chain, account/slot, full 32-byte hash split across two pages,
    budget/gap summary) before the keygen/sign work, and replaces the
    sticky "EIP-1271 ok" status with the same "Signed" → "PQSigner OS
    Ready" return-to-idle sequence cmd_sign_userop already uses.
    [cmd_sign_offchain.rs, mod.rs]
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2026-04-30 feat(sign): require explicit confirm for FLAG_REGISTER_SLOT rotations
    A hostile companion can silently set FLAG_REGISTER_SLOT on every
    routine UserOp, riding a Type 1 addOwnerBytes alongside the user's
    Type 2 and quietly draining the wallet's MAX_BOOTSTRAP_USES reserve at
    twice the rate the user thinks they're authorising. The on-chain
    monotonic cap still bounds the damage, but the trusted display
    previously gave the user no way to notice the rotation.
    Add a dedicated one-page "ROTATE SLOT? / New slot: N / +bootstrap use"
    confirm shown before the inner-tx render whenever the flag is set.
    Wired into both cmd_sign_userop and cmd_sign_userop_batch (one
    rotation confirm per sign call, since a b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
    [cmd_sign_userop.rs, cmd_sign_userop_batch.rs, mod.rs]
2026-04-30 refactor(modularity): extract pqsigner-proto IDL + codegen Solidity + tighten production fence
    A modularity audit found PQSigner has the right boundaries (S↔NS,
    dual-SE entropy, ISPHINCSVerifier) but the wrong interfaces between
    them: cfg-only polymorphism, no Rust↔Solidity IDL. Land the
    foundational layers from docs/handoff-modularity-refactor.md (Phases
    0 + 2 + 3 + 4 + Phase 10 PR E) so the rest of the refactor can land
    independently.
    New proto/ crate (pqsigner-proto) is the zero-dep no_std single source
    of truth for every CMD_*, NscStatus, wire-format size, region bound,
    domain tag, and on-chain cap. Adds the four constants that were
    Solidity-only or per-file (MAX_BOOTSTRAP_USES, OWN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
    [lib.rs, main.rs, mod.rs]
2026-04-30 refactor(modularity): extract pqsigner-{tx-core,aa,domain,tx,hal} + axis aliases + Ui trait + NsPtr typestate
    Continues the modularity refactor on top of 8842d14. Pure-logic
    modules now live in standalone workspace crates so host-side
    reference signers can reuse them without pulling in hardware deps;
    secure-side mod.rs files are thin re-export shims so existing call
    sites compile unchanged.
    Why: the refactor plan at /home/markus/.claude/plans/ok-make-a-plan-
    logical-lobster.md sequences 12 phases that take the codebase from
    "right boundaries, wrong interfaces" (cfg-only polymorphism, no
    Rust-Solidity IDL, 1241-line cmd_sign_userop monolith) to a clean
    trait-routed architecture. The first ru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
    [bundle.rs, crypto.rs, hash.rs, lib.rs]
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2026-05-05 feat(tier2-phase2a): BHK derivation primitive — host-testable, no chip burns
    Phase 2A of Tier 2 BHK (work-todo #7): land the cryptographic primitive
    infrastructure for the BHK selector. No silicon TRNG burn, no flash
    write, no TAMP register lock — fully reversible (feature-flag flip +
    flash erase reverts to pre-Tier-2 state). Phase 2B (silicon-side BHK
    provisioning + boot-load + TAMP-lock) and Phase 2C (caller migration:
    SE050 SCP03 + admin PIN + TROPIC01 pairing → BHK) remain deferred and
    documented in `docs/work-todo.md`.
    # What this lands
    hw::saes_cmac::cmac_bhk(msg, tag) — parallel to cmac_dhuk; identical
    cmac_generic core (RFC 4493 / NIST SP 800-38B), KeySel::Bhk
    ins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
    [mod.rs, secret_keys.rs]
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2026-05-06 docs: correct slot-key chain-binding and refresh keygen timings
    Slot keys are chain-bound via slot_entropy/slot_r mixing chain_id, and
    SLOT_CACHE keys on (account_index, chain_id, slot_index) — CLAUDE.md
    previously claimed chain-agnostic derivation and slot_index-only cache.
    Keygen timings updated to <1 s (real hardware) across CLAUDE.md, domain
    keypair derivation docs, and CachedSlot doc; first-sign budget now ≤3 s.
    [lib.rs, state.rs]
2026-05-06 feat(tamp): wire TAMP into boot — polled-mode, log-only, validated on HW
    The `tamp` feature gate was sitting unused since commit ddd7921 — module
    in tree but no caller. This wires it into `main()` after RNG init and
    adds a per-tick `poll()` from `SysTick`, completing the integration.
    Two design changes vs the original module:
    1. **Polled, no IRQ.** PQSigner has no peripheral-IRQ scaffolding
    (no PAC + no `#[interrupt]` handler), so an unmasked TAMP IRQ
    would land in cortex-m-rt's WEAK DefaultHandler and HardFault.
    `tamp::init()` now skips `enable_tamp_irq()` entirely — IER stays
    masked. Detection logic in CR1 is armed; flags accumulate in
    TAMP_SR; `tamp::pol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
    [main.rs, tamp.rs]
2026-05-06 feat(consumption-mask): wire into boot + SysTick, swap RNG for xorshift32
    Companion to the polled-TAMP wiring in `9a37aab`. Activates the third
    Trezor-audit module landed in `ddd7921`:
    * `hw::consumption_mask::init()` runs after RNG init in `main()`
    (`[S] Consumption mask initialised` log line).
    * `hw::consumption_mask::randomize()` runs from the SysTick handler
    alongside `tamp::poll()`. ~10 cycles per tick (xorshift step +
    modulo + MMIO write).
    Swap RNG → xorshift32 in the hot path (`hw/consumption_mask.rs`)
    The original `randomize()` called `rng::byte()` twice per tick. With
    SysTick at 1 kHz that's 2000 RNG-path entries/sec, and `hw/rng.rs`
    emits a `secure_log!("[S] rn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
    [consumption_mask.rs, main.rs]
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2026-05-06 feat(tamp): add tamp-irq feature for polled→IRQ migration
    Per work-todo #26's deferred plan. New `tamp-irq` feature (implies
    `tamp`) flips TAMP from polled-mode (~1 ms latency via SysTick poll)
    to IRQ-mode (~hundreds-of-cycles latency). Polled-mode remains the
    default — IRQ-mode is opt-in until production hardening.
    secure/Cargo.toml
    New `tamp-irq` feature gate.
    secure/src/hw/tamp.rs
    `init()` now calls `enable_tamp_irq()` under `tamp-irq` —
    arms TAMP_IER + NVIC.ISER0 bit 2 in addition to the existing
    CR1 detection setup. Restored the IRQ handler body
    (`on_tamp_irq()`) with **same log-only semantics as `poll()`**:
    read SR → log reason → write-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
    [main.rs, tamp.rs]
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2026-05-07 refactor(unsafe): drop 21 redundant unsafe sites + introduce hw::mmio
    Phase 1 (deletions, -21 unsafe blocks):
    - Replace 19 `core::str::from_utf8_unchecked` calls on ASCII-by-construction
    buffers with `crate::ui::ascii_str()` (safe `from_utf8(...).unwrap_or("?")`).
    - Drop 2 redundant `unsafe impl Send/Sync` on `Stm32U5UsbOtgFs` — unit ZST
    auto-derives both.
    Phase 3 (proof-of-concept, hw/hash.rs):
    - Add `secure/src/hw/mmio.rs` with typed `Reg32` / `RoReg32` register
    handles. Construction is `unsafe` (one-time address binding); after
    that `.read()` / `.write()` / `.modify()` are safe.
    - Migrate `secure/src/hw/hash.rs`: 5 `unsafe fn` → 3, all MMIO touches
    become safe method calls,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
    [hash.rs, measured_boot.rs, mod.rs, saes.rs]
2026-05-11 feat(tier2-phase2b): hw/bhk.rs — BHK lifecycle code, gated OFF, no chip burns
    Phase 2B of Tier 2 BHK (work-todo #7): the silicon-side BHK lifecycle
    as code, gated behind the `bhk` feature which is OFF by default —
    `hw/bhk.rs` is not compiled and nothing touches flash or TAMP until the
    flag is deliberately flipped for a silicon-validation pass.
    secure/src/hw/bhk.rs:
    provision() — first boot: crate::rng::fill 32 bytes →
    DHUK-ECB-wrap (2 ECB blocks via
    saes::encrypt_ecb_block(KeySel::Dhuk, ...)) →
    erase + program bank-1 page 126 (0x0C0F_C000,
    the page freed by wor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
    [bhk.rs, main.rs, mod.rs]
2026-05-11 fix(tier2-bhk): RCC/PWR register addrs + SAES BHK-key latch — lifecycle works on silicon
    Bench bring-up of the BHK lifecycle (work-todo #7 Tier 2 phase 2B) on
    B-U585I-IOT02A surfaced + fixed two register bugs. The BHK lifecycle —
    provision → DHUK-ECB-wrap → flash page 126 → unwrap → TAMP BKP0R..7R →
    BHKLOCK → KeySel::Bhk AES round-trip — now passes on real silicon at
    RDP0 with a stable per-provisioning fingerprint:
    [S][saes] self_test PASS DHUK(fp)=117d822a62a50830 (ST RDP0 const)
    [S][bhk] self_test PASS BHK(fp)=9524309a79a30040 (stable x2 boots)
    # Bug 1 — hw/bhk.rs RCC/PWR register addresses
    `RCC_AHB3ENR.RTCAPBEN` doesn't exist — the RTC/TAMP APB clock i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
    [bhk.rs, main.rs, saes.rs]
2026-05-11 feat(se050-e2e): negative-security test — admin PIN cannot extract user-PIN-gated secrets
    Falsifiable hardware test backing the threat-model claim that a DHUK
    leak (or post-Phase-2C BHK leak) does NOT drain funds: even an
    attacker with the SE050 admin PIN cannot read half_E, because the
    chip enforces the two-entry TAG_POLICY (user → READ|WRITE|DELETE,
    admin → DELETE only) in silicon, not in the driver.
    secure/src/se050/mod.rs — Se050::run_admin_extract_attempt() on
    isolated OID range 0x7B0B_xxxx (clear of production 0x7B10_xxxx,
    admin-wipe 0x7B09, crash-safety 0x7B0A, and all retired ranges).
    Six steps:
    1. cleanup prior residue via admin sessio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
    [main.rs, mod.rs]
2026-05-11 refactor(se050): remove write_admin_pin — crash-safety test uses the PIN literal directly
    The SE050 admin PIN is re-derived from the OTP master via
    `secret_keys::se050_admin_pin()` on every provision/wipe (the v6
    OTP-derived admin scheme). `hw::flash::write_admin_pin` — which wrote
    a PIN into page 125 QW0 — had exactly one remaining caller: the
    `se050-crash-safety-e2e` test, which used it to persist the admin PIN
    across the simulated mid-wipe crash. But that PIN is a compile-time
    literal (`*b"crashsafetypin00"`), so there's nothing to persist —
    phase 2 now uses the literal directly. Phase 1 just erases page 125
    (clean flag state) and arms the wipe flag.
    Removed: `hw::flash::write_ad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
    [flash.rs, main.rs, mod.rs]
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2026-05-11 feat(tier2-phase2c): SE050 derivations on the BHK axis — call-site flip
    Phase 2C of Tier 2 BHK (work-todo #7), mirroring Trezor's
    `secret_keys.c` selector-per-purpose split: SE050 secrets move off
    the DHUK SAES axis onto the BHK axis, so a DHUK compromise alone no
    longer exposes the SE050 channel (and vice-versa — OPTIGA's PBS stays
    DHUK-direct).
    secret_keys::se050_scp03_enc_key → derive_into_bhk (was derive_into)
    secret_keys::se050_scp03_mac_key → derive_into_bhk
    secret_keys::se050_admin_pin → derive_into_bhk
    secret_keys::optiga_pairing_secret → derive_into (unchanged — DHUK)
    secret_keys::tropic01_pairing_key → derive_into (unchanged — DHUK;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
    [secret_keys.rs]
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2026-05-12 fix(optiga): clear ready/shield state on factory_reset error → unwedge re-pair
    A failed shielded handshake (the host computed a PBS the chip doesn't
    hold — exactly what happens the first time a board paired under the old
    otp-hardcoded-master-key PBS is reflashed with the DHUK-derived one)
    leaves the OPTIGA's presentation layer in an SCTR=0x40 alert state.
    factory_reset() returned `Err(Shield)` from `ensure_shield()?` but left
    `self.ready = true`, so the next `init()` early-returned without a real
    soft_reset and the chip stayed wedged — every subsequent plain APDU,
    including the `SetDataObject(E140)` in setup_pbs_no_handshake that would
    rewrite E140 with the new PBS at LcsO=Creation, bo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
    [mod.rs]
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2026-05-12 feat(se050 #20): SCP03 rotation — Stage A + Stage B code (reversible half)
    The SE050 SCP03 channel currently uses the *published* AN12436 factory
    keys (OEF 0xA921, KEY_VERSION=0x0B), so its confidentiality vs. a
    datasheet-armed bus sniffer is theatre. This lands the firmware-side
    rotation to per-device derived keys — all reversible (code + Cargo
    flags, no chip writes). Decisions per work-todo #20 (RDP2-forever
    policy): root = BHK (no call-site flip — se050_scp03_{enc,mac}_key
    already on derive_into_bhk; add se050_scp03_dek_key); KEY_VERSION stays
    0x0B (the ceremony replaces keyset 0x0B in place); detection =
    probe-on-boot; ceremony + BHK first-write must run at RDP≥1.
    Stage A:
    - sec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
    [main.rs, mod.rs, scp03.rs, secret_keys.rs]
2026-05-12 tools/sca: wire up Ledger Donjon emulation-based SCA/FI self-tests
    First runnable target: a single-instruction-skip fault sweep over the
    fault-injection countermeasures in secure/src/fi.rs (fi::check_true and
    fi::wait_random), via rainbow's start_and_fault.
    - tools/sca/fi_target/: standalone thumbv8m crate that #[path]-includes
    secure/src/fi.rs verbatim (so the test tracks the exact production source;
    the build breaks loudly if fi.rs gains a new dep), re-exports its fns under
    stable #[no_mangle] C symbols, stubs the one HW call (crate::rng::byte()),
    and pins the symbols against --gc-sections with #[used] statics. The boolean
    fed to check_true is an #[inline(never)] + black_box hel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
    [build.rs, main.rs]
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2026-05-12 tools/sca: add C10 verify-before-release gate fault sweep + Finding F-1
    New fault_sweep_c10_verify.py + sca_c10_verify_release in the target ELF — a
    structural mirror of crypto.rs::c10_sign_verified_with_progress's
    verify-before-release glue (sign/verify stubbed; NOT a #[path] include because
    crypto.rs pulls in too much). Sweeps single instruction-skips with verify forced
    to fail; a "release the signature" return is a bypass.
    FINDING F-1: crypto.rs passes the trivial closure `|| v` (a precomputed bool
    local) to fi::check_true, so LLVM CSEs the two cond() evaluations into one ldrb
    and collapses the `&& v1 && v2` re-check — the compiled gate has ~1 decision
    point, not the four fi.rs's doc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
    [main.rs]
2026-05-12 tools/sca + crypto: apply F-1 fix, add stuck-at sweeps, document F-2
    F-1 FIX: crypto.rs::c10_sign_verified_with_progress passed `|| v` (a precomputed
    bool local) to fi::check_true, so LLVM CSEd the two cond() evals into one ldrb
    and collapsed the && v1 && v2 re-check — fault_sweep_c10_verify.py showed 5
    single instruction-skips then released an unverified C10 signature. Now passes
    `|| core::hint::black_box(v)`: v is re-materialised opaquely each eval, so the
    two cond() calls can't be CSEd and check_true keeps its full four-decision-point
    shape (verified by disassembling the built ELF). ~zero cost (one extra ldrb per
    check). Did not adopt the stronger "re-verify in the closure" option (keep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
    [crypto.rs, main.rs]
2026-05-12 fix(security): vendor-sig verify before FW destructive ops + FI/race hardening
    Security review 2026-05-12 (see docs/security-review-2026-05.md). Eight
    findings fixed in firmware; remaining items (TZSC lockdown, deterministic
    AES-GCM nonce migration, UX gaps for paymaster/init-code/rotation) are
    tracked in the doc's production checklist.
    C-1 FW update: embed vendor C10 pubkey via FSBL_VENDOR_PUBKEY (mirror
    of fsbl/build.rs), call verify_signature in verify_manifest before
    slot erase / OTP rollback-floor bump / boot-state write can run.
    The old "fingerprint-must-match-active-slot" gate was bypassable
    by anyone who could read the active manifest (it's flash, not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
    [build.rs, cmd_fw_chunk.rs, cmd_sign_offchain.rs, cmd_sign_userop.rs, cmd_sign_userop_batch.rs, mod.rs, otp.rs, vendor_pubkey.rs]
2026-05-12 tools/sca: PIN pre-commit gate fault sweep + Findings F-3/F-4 + UcError catch
    New fault_sweep_pin.py + sca_pin_* in the target ELF — a structural mirror of
    nsc::gated_unlock (stm32u585 branch) + hw::flash::pin_attempts_bump (fake page-124
    counter in .bss; pin_attempts_read/write_quadword_verified stubbed; se.unlock
    modelled as black_box(se_unlock_ok)!=0; real fi::{check_true,wait_random}
    #[path]-included). 3 fault models over sca_pin_gated_unlock(0) (wrong PIN);
    status (r0) and SCA_PIN_COUNTER read out-of-band (via cle); plus a direct sweep
    of pin_attempts_bump's Ok⇒counter-advanced invariant.
    F-3 (residual): gated_unlock's `match se.unlock(pin)` Ok/Err discrimination is a
    plain match,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
    [main.rs]
2026-05-12 tools/sca: first lascar leakage target — TVLA + CPA on the AES / AES-GCM entropy wrap
    New leakage_kdf.py + kdf_target/ (standalone thumbv8m crate; same crates.io deps
    as pqsigner-domain's entropy-blob path — aes-gcm 0.10 / aes 0.8 / sha2 0.10).
    lascar TVLA (Welch fixed-vs-random) + CPA on the mem_address channel of:
    - sca_leaky_sbox (out[i]=SBOX[in[i]^KEY[i]], a deliberate table leak) — the
    POSITIVE CONTROL: TVLA max|t| ≈ 24 at the SBOX[] load; CPA recovers 16/16 key
    bytes (the FIPS-197 vector key) → lascar pipeline verified, both ways.
    - sca_aes256_encrypt_block (AES-256, fixed key, vary plaintext — the `aes`
    crate's bitsliced soft backend, what pqsigner-domain'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
    [build.rs, main.rs]
2026-05-12 tools/sca: fault sweep over the real sphincs_c10::verify (forge-a-signature direction)
    New fault_sweep_c10v.py + c10v_target/ — a standalone thumbv8m crate that
    path-deps the real sphincs-c10 (software SHA path) and wraps sphincs_c10::verify
    under a #[no_mangle] symbol. (The path-dep from a detached workspace works:
    sphincs-c10's `zeroize = { workspace = true }` resolves from sphincs-c10's own
    workspace = the repo root, not from c10v_target's.)
    The harness loads the `wrong-message` vector from
    contracts/smart-wallet/test/c10_test_vectors.json — a structurally-valid C10 sig
    for a different message, so verify runs the full FORS/WOTS/hypertree path and
    then fails the final computed_root ==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
    [build.rs, main.rs]
2026-05-12 tools/sca: F-3 confirmed addressed (sync gated_unlock mirror to 67d9dea) + C10-verify sweep over all 6 invalid vectors
    (a) F-3 follow-up: nsc::gated_unlock had already been FI-hardened by 67d9dea
    (read the se.unlock Ok/Err discriminant twice / wait_random / fi::check_true
    sentinel / `match result { Ok(master) if both_ok => …, Ok(_) => InternalError,
    Err(e) => Err(e) }`), but the tools/sca mirror still modelled the old plain
    `match`. Re-synced sca_pin_gated_unlock to track the current code; the [skip]
    sweep now confirms no single instruction-skip makes a wrong PIN unlock (the two
    is_ok() reads CSE into one, but `both_ok` is computed before the `match`, = false
    for a genuine Err, so a single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
    [main.rs]
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2026-05-12 docs(fi): make check_true's doc-comment honest re F-5 (it raises 1→~2 coordinated faults, not 4)
    The two-fault [skip,skip] pair sweep (tools/sca/fault_sweep_fi.py --two-fault,
    ~21k pairs) shows fi::check_true's "must skip ALL FOUR decision points" claim is
    optimistic: ~210 pairs flip check_true(false)→true, of which 205 are
    scaffolding-only, 4 are a harness artifact (the synthetic sca_fi_cond closure
    reads a skipped-arg-load stack pointer as "true" — doesn't transfer to a real
    `bl sphincs_c10::verify(pk_seed,…)`), and 1 is real (both faults in check_true's
    result/return path). Rewrote the doc-comment to say what it actually buys
    (1→~2 coordinated faults), what it doesn't (the cond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
    [fi.rs]
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2026-05-12 docs(se050): admin-wipe PIN — refresh comments/docs to "HUK-derived (BHK in a bhk build)"
    The SE050 admin-wipe PIN moved from "HKDF over OTP master" to
    derive_into_bhk back in the Phase-2C call-site flip (d3e518f) and was
    hardware-validated 2026-05-12 (dual-se-bhk-e2e), but a pile of comments,
    log strings and doc entries still described it as "OTP-derived" /
    "SAES-CMAC(DHUK,…) on a shipping build". Brought them into line with the
    actual state:
    se050_admin_pin() → derive_into_bhk("pqsigner/se050-admin-pin-v1") ⇒
    SAES-CMAC(BHK,…) in a `bhk` build (the shipping target) /
    SAES-CMAC(DHUK,…) with `saes-dhuk` alone / HKDF(OTP-master/const,…)
    legacy; never persisted to flash; p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
    [dual_se.rs, main.rs, mod.rs]
2026-05-12 fi: add check_true_into_sentinel, migrate all ~13 check_true callsites (mitigates F-2; partly F-5; F-4 re-framed)
    Sentinel-encoded FI-guard return (OK_SENTINEL/FAIL_SENTINEL) so a garbage return register at the caller's 'if !verdict { err }' is overwhelmingly != OK_SENTINEL and takes the error path. Both fns standalone bodies (a wrapper would add a one-skip-to-truthy reduction; make fi caught that). Migrated crypto.rs, nsc/mod.rs gated_unlock, nsc/cmd_sign_userop.rs x3, cmd_sign_userop_batch.rs x3, cmd_sign_offchain.rs, dual_se.rs, hw/otp.rs, hw/flash.rs x2. Verified: thumbv8m build clean (2 cfgs), cargo test -p sphincs-tz-secure 105/105, make fi/c10/pin exit 0. make e2e (QEMU) timed out at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
    [cmd_sign_offchain.rs, cmd_sign_userop.rs, cmd_sign_userop_batch.rs, crypto.rs, dual_se.rs, fi.rs, flash.rs, main.rs]
2026-05-12 fix(sign-userop): unbreak ETH transfers to named addresses + add CMD_OFFCHAIN_SYNC for reflash recovery
    Two host-protocol fixes that surfaced when wiring PQ1 signing into the
    Ambire extension's send-asset flow.
    1. ensure_trailer_skeleton padding: 5 → 6
    Commit 08e4b29 added the `self_attest` trailer slot to the secure
    parser's sequence but didn't update the NS-side skeleton padding
    in `maybe_inject_names_bundles`. Any tx whose `tx.to` matched the
    names DB triggered the injector, which padded 5 prefixes and then
    appended `[count][bundle_len][bundle]` — the secure parser then
    read `[count, bundle_len_high]` as the `self_attest` u16 length,
    tripped the 68-byte cap, and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
    [cmd_offchain_sync.rs, lib.rs, mod.rs, nsc_api.rs]
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2026-05-13 feat(sca): FW-update manifest-verify FI sweep + F-7 finding
    New harness: `make fw-verify` exercises the *real* `fw_manifest::ManifestRef`
    verify chain (no stubs — path-deps the production crates). Three deterministic
    fixtures (valid + bad_sig + bad_digest) baked at build.rs time from a fixed
    vendor keypair (sk_seed=[0x42;32], pk_seed=[0x77;16]). Three fault models
    (skip / stuck-at-0 / stuck-at-FF) sweep every per-step `verify_*` entry plus
    a chained `sca_fw_verify_all` mirroring FSBL's call order.
    Finding F-7 (FW-update bypass under single fault — needs hardening):
    - `verify_signature × bad_sig`: **13 single-fault bypasses in isolation**
    (7 skip + 1 stuck-at-0 + 5 stuck-at-FF).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
    [build.rs, main.rs]
2026-05-13 fix(fw-update): F-7 — sentinel-double-check verify_signature in COMMIT gate
    `secure/src/fw_update/mod.rs::verify_manifest` now wraps the
    `m.verify_signature(...)` call in `fi::check_true_into_sentinel`. The
    closure is double-called with `fi::wait_random()` between, the verdict is
    sentinel-committed to a volatile local, re-checked, and the caller compares
    the returned u32 to `OK_SENTINEL` rather than handling a bare Result. This
    raises the bypass bar from 1 fault to ~2 coordinated faults — same residual
    as F-5 for the rest of the secure firmware.
    Validation: `tools/sca/fw_verify_target/src/main.rs` adds a hardened mirror
    `sca_fw_verify_all_fi` that uses the same fi.rs (via `#[path]`-incl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
    [main.rs, mod.rs]
2026-05-13 feat(sca): NS-pointer validation FI sweep + F-8 finding
    New harness: `make ns-ptr` exercises the *real*
    `secure::nsc::ptr_validate::validate_ns_{read,write}_ptr` predicates that
    gate every NSC gateway entry. The thumbv8m target ELF `#[path]`-includes
    the production validator verbatim (path-deps `sphincs-tz-shared` for the
    NS / mailbox / flash address constants), so the code under test is bit-
    identical to what production runs at every `cmd_*` entry via
    `NsPtr::validate_{read,write}`. Five attacker-controlled scenarios:
    valid_ns_sram (accept), s_world_ptr (reject), mailbox_overlap (reject),
    null_ptr (reject), overflow (reject). Three fault models: skip / stuck-at-0
    / stuck-at-FF. Also runs a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
    [build.rs, main.rs]
2026-05-13 fix(nsc): F-8 — verify-twice + double sentinel check in NsPtr::validate_*
    `secure/src/nsc/ns_ptr.rs::NsPtr::validate_{read,write}` now verify the
    underlying `validate_ns_{read,write}_ptr` predicate TWICE through
    `fi::check_true_into_sentinel`, with `fi::wait_random()` between, and
    check each sentinel verdict independently before constructing the
    ReadPtr<T> / WritePtr<T> proof. A single fault on the first
    `!= OK_SENTINEL` cmp+branch is caught by the second verification call; a
    single fault inside one of the `check_true_into_sentinel` invocations is
    caught by the other call. Two coordinated faults required to bypass —
    same residual as F-5 / F-7 for the rest of the firmware.
    Why verify-twi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
    [main.rs, ns_ptr.rs]
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2026-05-13 tune(eip-1271): raise MAX_OFFCHAIN_GAP 5 → 100
    Five unbacked off-chain sigs was too aggressive in practice — legitimate
    users were hitting the gate (SW=0x6985 "publish first") in normal use.
    100 preserves both defenses the gap exists for (slot soft-brick
    prevention, rate-limit on coerced mass-signing) while leaving plenty of
    headroom for routine EIP-1271 flows.
    Regenerated PqsignerProto.sol via `xtask gen-solidity-constants` and
    hand-synced the Lean mirror (codegen still TODO per Common.lean header).
    [lib.rs]
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2026-05-13 feat(fi): extract pqsigner-fi crate + harden FSBL filter_valid (F-7 follow-up)
    Extracts `secure/src/fi.rs` into a new `pqsigner-fi` workspace crate so
    FSBL can use the same FI hardening primitives the secure-world COMMIT gate
    got in F-7. Closes the defense-in-depth gap that the F-7 fix explicitly
    left open (see `tools/sca/README.md` §F-7 'Scope of the fix').
    New crate `pqsigner-fi`:
    - `OK_SENTINEL` (0xA5A5_A5A5) / `FAIL_SENTINEL` (0x5A5A_5A5A) constants
    - `wait_random_loop<R: FnMut() -> u8>` — Trezor-port invariant-checked
    random-length loop; caller supplies the RNG byte
    - `check_true<F, W>` — double-eval cond + volatile sentinel commit, bool return
    - `check_true_into_senti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
    [fi.rs, lib.rs, main.rs]
2026-05-13 feat(sca): Tier-2 lascar TVLA — HMAC-SHA512 + C10 keygen + C10 sign all flat
    Three new leakage subjects added to leakage_kdf.py, all running through the
    real production crates (RustCrypto hmac + sha2 for the KDF; sphincs-c10 for
    keygen + sign). Each tests fixed-vs-random on the secret input via
    Welch's t-test on the mem_address channel — the standard 'is it constant-
    time?' indicator.
    Results:
    - HMAC-SHA512("sphincs-c6-v1", bip39_seed) → max|t| = 0.00 over 600 traces, flat
    - sphincs_c10::keygen(sk_seed, pk_seed) → max|t| = 0.00 over 80 traces × 500K samples, flat
    - sphincs_c10::sign(msg_hash, None) → max|t| = 1.45 over 80 traces × 500K samples, flat (well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
    [build.rs, main.rs]
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2026-05-14 feat(sca): Tier-3 gap+cap and dispatch FI sweeps; F-10 + F-11 + F-6 reassessment
    Three things in this commit:
    1. **Tier-3 #1: off-chain gap + cap enforcement FI sweep** (`make cap`).
    New `cap_target/` mirror of cmd_sign_offchain.rs:202-223 — the two
    gates that bound a slot key to MAX_SLOT_USES=65,536 sigs per chain.
    FINDING **F-10**: both plain and FI-hardened (verify-twice + double
    sentinel) gates are single-fault bypassable. Bypass mechanism is
    INPUT-register fault (stuck-at-0 on the local_offchain register makes
    the gate correctly compute 'this 0 passes' → accept), which the
    F-7/F-8 sentinel-wrap pattern doesn't defend against. Severity:
    medium — production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
    [build.rs, main.rs]
2026-05-14 feat(sca): F-12 — flash counter scan is single-fault rollback-bypassable
    User's intuition was correct: the local off-chain counter (firmware flash
    page 123) CAN be glitched. This is the most severe FI finding in the audit
    so far.
    `make flashctr` builds a thumbv8m mirror of
    `secure/src/hw/flash.rs::offchain_count_read` — the scan-and-take-max
    loop over the log-structured per-slot counter page. The mirror page lives
    in RAM (not real flash), but the scan code is bit-identical to production
    (parse_entry + outer scan loop verbatim).
    The fixture pre-populates the page with 100 valid OFFCHAIN_TYPE_COUNT
    entries (counts 1..=100) for one slot. Expected scan result: 100. The
    sweep looks for ROLL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
    [build.rs, main.rs]
2026-05-14 feat(sca): F-12 extended — flashctr BUMP path also single-fault bypassable
    Added `offchain_count_bump` mirror to flashctr_target + harness BUMP-path
    sweep. Found 6 silent-write-failure cases across 3 fault models (2 per
    model), all clustered at function prologue (instr 4 and instr 6).
    What this is: the bump function returns Ok(()) but the actual page state
    for the target slot did NOT advance to new_count. Likely mechanism:
    slot_key input-register aliasing (stuck-at at the prologue makes bump
    operate on a DIFFERENT slot — it writes an entry for that wrong slot,
    read-back succeeds for THAT slot, FI triple-check passes for THAT slot
    — but our slot's max stays at the old value).
    The F-10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
    [main.rs]
2026-05-14 feat(fi): F-10/F-11/F-12 fixes — local off-chain counter rollback resistance
    Three input-redundancy hardenings closing single-fault rollback paths
    identified by the `make flashctr`, `make cap`, `make dispatch` sweeps.
    All three exploit the same class: stuck-at on an input register clamps
    a value to 0/0xFF, and the downstream check correctly accepts the
    clamped input. The defence pattern is read-the-input-twice with
    `wait_random()` between, halt on mismatch — forces the attacker to
    fault both reads.
    **F-12 (HIGH severity, the structural one)** in `secure/src/hw/flash.rs`:
    - `offchain_count_read` / `last_userop_count_read` /
    `offchain_count_is_registered` now scan forward AND revers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
    [cmd_sign_offchain.rs, cmd_sign_userop.rs, flash.rs, main.rs]
2026-05-14 feat(fi): F-13 — SLH-DSA double-compute on sign-path (RFC 9814 / Genêt TCHES 2023)
    Defends against the class where a fault during signing produces a
    malformed sig that nonetheless verifies cleanly under the honest
    pubkey while leaking sk_seed bits across multiple traces (faulted
    hypertree node re-derivation produces a pk_root match by
    construction). Verify-after-sign alone is **not** sufficient — both
    the IETF RFC 9814 informational appendix and Genêt's TCHES 2023 paper
    spell this out.
    **Fix in `secure/src/crypto.rs::c10_sign_verified_with_progress`:**
    1. Sign **twice** with identical inputs. Deterministic SPHINCS+C10
    (`opt_rand=None`) guarantees byte-equal output for identica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
    [crypto.rs, main.rs]
2026-05-14 feat(rng): multi-source strong RNG + non-deterministic OptRand (work-todo §10 + §18 P0)
    Mirrors Trezor Safe 3/7 design (`core/embed/sec/rng/rng_strong.c`):
    fill from the platform TRNG, then XOR-mix per-block from each
    available secure-element TRNG. The argument is the standard one for
    multi-source randomness — if any one source is broken / biased /
    predictable, the XOR-fold preserves entropy from the others.
    **Three-source fold on dual-se builds:**
    STM32 hardware TRNG ⊕ OPTIGA Trust M GetRandom ⊕ SE050 GetRandom
    Defends against:
    - STM32U585 RNG seed-error / clock-error (latched SEIS/CEIS).
    - OPTIGA TRNG fault or compromised chip-side state.
    - SE050 TRNG fault or comp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
    [apdu.rs, crypto.rs, dual_se.rs, main.rs, mod.rs, rng_strong.rs, secure_element.rs]
2026-05-15 feat(fi): F-14 — FihBool complement-storage for pin_verified
    `SecureState::pin_verified` was a plain `bool` in BSS — a single-fault
    flip (SRAM bit-flip, stuck-at on the load register, or caller branch-
    skip) bypassed every gated gateway command (SIGN_USEROP, SIGN_OFFCHAIN,
    FW_BEGIN/CHUNK/COMMIT, GET_WALLET_ADDRESS, GET_INIT_CODE,
    OFFCHAIN_STATUS, OFFCHAIN_SYNC, SIGN_USEROP_BATCH). On STM32U585 voltage
    glitching is confirmed feasible (Masaryk-U Simonik thesis, 76 % PIN-
    glitch bypass on the same family), so a plain bool at a fixed BSS
    address was the highest-value remaining single-fault target after
    F-7..F-13.
    **Fix.** New `secure/src/fih.rs::FihBool` — Trezor-style `FihInt` /
    `secbool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
    [cmd_fw_begin.rs, cmd_fw_chunk.rs, cmd_fw_commit.rs, cmd_get_init_code.rs, cmd_get_wallet_address.rs, cmd_offchain_status.rs, cmd_offchain_sync.rs, cmd_sign_offchain.rs]
2026-05-15 feat(fi): F-15 — PIN-lockout FAIL-IN inversion + sentinel-gated counter checks
    The pre-existing PIN-lockout gates were FAIL-OUT — the secure action
    (refuse / wipe) lived in the conditional branch, so a single
    branch-skip (the most common voltage / EM glitch primitive on
    STM32U5, per the Masaryk-U Simonik thesis) bypassed the wipe and let
    brute-forcing past MAX_ATTEMPTS = 10 continue.
    Two gates inverted to FAIL-IN:
    1. `nsc::gated_unlock` (entry to every PIN attempt):
    pre-fix: if pre_count >= MAX { return PinLocked; }
    post-fix: let allowed = check_true_into_sentinel(|| pre_count < MAX);
    if allowed != OK_SENTINEL { return PinLocked; }
    2. `cmd_request_unlock: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
    [cmd_request_unlock.rs, mod.rs]
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2026-05-15 feat(fi): F-15.r1 + F-15.r5 — pin_attempts_read F-12 hardening + sentinel-register scrub helper
    Closes two of the five F-15 residuals:
    **F-15.r5 — `pin_attempts_read` F-12-hardening.**
    `hw::flash::pin_attempts_read` was a single-direction scan: walk
    QWs 0..CAPACITY forward, early-exit on first blank. A single fault
    on the inner-loop's `programmed` flag or the outer-loop's
    early-`break` underreports the count and slips past F-15's
    double-read in `gated_unlock` / `verify_pin_with_chip` because both
    double-reads land identically.
    Mirrors the F-12 fix to `offchain_count_read`:
    - `pin_attempts_scan_forward` (verbatim original) walks 0..N,
    early-breaks on first blank QW.
    - `pin_atte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
    [fi.rs, flash.rs]
2026-05-15 feat(fi): zeroize barriers — compiler_fence + DSB after every secret zeroize (work-todo §18 P0)
    Closes the work-todo §18 P0 "Compiler fence + DSB barrier after every
    zeroize of master_secret, entropy, PIN buffers" item.
    **Why both fences:**
    The `zeroize` crate's `Zeroize::zeroize()` already uses
    `core::ptr::write_volatile` (prevents LLVM dead-store elimination)
    and `core::sync::atomic::compiler_fence(SeqCst)` internally (prevents
    LLVM reordering loads/stores across the boundary). On a single-core
    in-order Cortex-M33 with no other bus masters, that's already
    sufficient for the common-case "wipe then return" pattern.
    The extra `cortex_m::asm::dsb()` (Data Synchronization Barrier)
    matter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
    [cmd_get_init_code.rs, cmd_sign_offchain.rs, cmd_sign_userop.rs, cmd_sign_userop_batch.rs, crypto.rs, dual_se.rs, fi.rs, main.rs]
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2026-05-15 sca(f-9): re-test post-F-16 — leak diagnosed as `grind_r` iteration count, not FORS access pattern
    New harness `tools/sca/f9_retest.py` + SUT `sca_c10_sign_shuffled`
    re-run the F-9 audit-grade TVLA with the F-16 shuffle seed
    independently random per trace.
    **Result.** max|t| = 39.09 (post-F-16) vs 40.71 (F-9 baseline) — a
    4 % drop. The shuffle did NOT mask the leak as expected.
    **Diagnosis.** Leak position: sample 9,990,909 (same neighborhood as
    F-9's 9,997,943). The leak is in `fors::grind_r`'s nonce-search
    loop, NOT in the FORS leaf-index access pattern as F-9 initially
    hypothesized.
    `grind_r` iterates a nonce from 0 until the resulting digest's last
    FORS index is zero (probability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
    [main.rs]
2026-05-15 sca(f-9): hedged R-derivation — closes the transparent leak channel (max|t| 40.71 → 4.93)
    Wires `opt_rand` into `sphincs-c10::fors::grind_r` so the nonce-search
    iteration count depends on per-call randomness instead of just msg.
    Closes the F-9 transparent leak channel identified in the post-F-16
    re-test (`tools/sca/f9_retest.py`).
    **What changed.**
    `sphincs-c10/src/fors.rs::grind_r` gains an `opt_rand: Option<&[u8; N]>`
    parameter. When `Some(rand)`, the per-iteration hash becomes
    `sha256("R_grind" || rand || nonce_be32)` — different `opt_rand`
    gives a different R series, so the iteration where the forced-zero
    constraint is hit depends on `(msg, opt_rand)` rather than `msg`
    alone. Whe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
    [main.rs]
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2026-05-15 fix(sau): TZSC allowlist restored — AHB2 crypto block actually lives in GTZC1, not GTZC2
    Closes the long-standing pre-production caveat from CLAUDE.md
    ("TZSC config regresses invariant #4") that was the largest known
    defense gap vs Trezor's mature setup.
    **Misdiagnosis corrected.** The pre-fix comment in `sau.rs` claimed
    "AHB2 peripherals are governed by a SECOND, separate controller —
    GTZC2_TZSC — whose exact base address on STM32U585 is still TBD".
    This was wrong. Verified against `vendor/STM32CubeU5/.../
    stm32u5xx_hal_gtzc.h`:
    #define GTZC_PERIPH_OTG (GTZC1_PERIPH_REG3 | GTZC_CFGR3_OTG_Pos)
    #define GTZC_PERIPH_AES (GTZC1_PERIPH_REG3 | GTZC_CFGR3_AES_Pos)
    #define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
    [sau.rs]
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2026-05-15 feat(fi): F-18 — control-flow-integrity step counter on the sign path
    Closes §18 P0 "Control-flow-integrity step counters: increment
    before critical call, decrement after, fail on mismatch. Detects
    function-skip glitches."
    **What it defends.** A glitch that skips one or more critical
    function calls in `c10_sign_verified_with_progress` leaves the
    running counter short by exactly the skipped step's magic. The
    final check (`cfi.check_into_sentinel(EXPECTED) != OK_SENTINEL →
    reject`) fails closed.
    This catches the "skip an entire function call" attack class that
    F-2's sentinel-encoding doesn't reach. F-2 hardens the `if`-branch
    AFTER a function returns; CFI hardens the function call itsel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
    [crypto.rs, fi.rs]
2026-05-15 feat(fi): F-19 — redundant volatile reads on critical state (§18 P0)
    Closes the §18 P0 "Redundant volatile reads (2-3×) on critical state
    with OR-based fail-in" item.
    **New primitive: `secure/src/fi.rs::read_volatile_voted<T>`.**
    ```rust
    pub fn read_volatile_voted<T: Copy + Eq>(p: *const T) -> Result<T, ()>
    ```
    Reads `*p` three times via independent `read_volatile`s with
    `compiler_fence(SeqCst)` barriers between. `Ok(v)` iff all three
    agree (no glitch detected). `Err(())` if any pair disagrees (glitch
    suspected; caller fail-closes).
    **Threat model.** A single-fault glitch on the `ldr` instruction
    that brings `*p` into a register could clamp it to 0 / 0xFF / some
    attacker-chosen patt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
    [fi.rs, sign_rate.rs, timeout.rs]
2026-05-15 feat(rng): §10 Phase 2 — migrate critical-secret RNG sites to rng_strong::fill
    Surveys every `crate::rng::*` call-site and migrates the
    security-critical ones to `rng_strong::fill` (the 3-source XOR-mix
    from §10 Phase 1: STM32 ⊕ OPTIGA ⊕ SE050). Initial framing in §18b
    ("none is security-critical") was wrong on closer review — the
    wallet master entropy and OTP device-master burn are actually the
    MOST security-critical RNG outputs in the firmware.
    **Migrated (4 sites):**
    - `main.rs` first-boot wizard's 32-byte master entropy generation.
    The wallet seed. Predictable here = universal forgery for the
    entire wallet lifetime across all chains. Single most critical
    RNG ca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
    [consumption_mask.rs, dual_se.rs, fi.rs, main.rs, otp.rs]
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2026-05-15 feat(fi): F-21 — boot-time PIN-counter reconciliation MCU ↔ OPTIGA (§4)
    Closes the §4 "boot-time reconciliation against OPTIGA F1E1" item
    and effectively resolves the "cryptographic FI checksum on the bump"
    item.
    **Reconciliation defense.** An attacker who can reset the OPTIGA PBS
    (rewriting E140 via the Conf(E140) Auto path on a glitched chip)
    resets every PBS-protected OID — including the F1E1 PIN-attempt
    counter. Symmetrically, an attacker who breaches the MCU TrustZone
    watermark could erase page-124. Either yields MCU_count ≠
    OPTIGA_count: unambiguous tamper evidence. Boot-time detection lets
    us wipe immediately rather than waiting for the next unlock attempt
    to expose the dis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
    [dual_se.rs, main.rs, mod.rs, secure_element.rs]
2026-05-15 fix(fi): F-21 follow-up — three-way PIN reconcile incl. SE050
    Earlier F-21 commit 778673d documented an "SE050 silicon counter can't
    be peeked without burning an attempt" limitation, inherited from a
    work-todo §4 claim. That claim was wrong: NXP
    `Se05x_API_ReadObjectAttributes` returns the USERID auth object's
    `auth_attempts` / `max_attempts` TLV fields over SCP03 without
    authenticating to the UserID — no attempt consumed.
    Implementation:
    - `Se050::pin_attempt_count_raw` parses the attribute response (SDK
    reference: `sss_pkcs11_pal_helpers.c:603-613 pkcs11_parse_atrribute`);
    returns failed-attempts USED count, aligning to OPTIGA F1E1 semantics
    so reconcile is a `!=` against MCU p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
    [dual_se.rs, main.rs, mod.rs, secure_element.rs]
2026-05-15 refactor(secure): funnel MMIO through hw::mmio + audit irreducible unsafe
    Migrates ~18 peripheral drivers, main.rs boot path, sau.rs, and the
    OPTIGA/SE050 I2C transports from ad-hoc read_volatile/write_volatile
    to one-shot module-scope Reg32/RoReg32 binders. All MMIO call-sites
    across flash, spi, saes, pka, otp, rcc, rng, uart, buttons,
    consumption_mask, tamp, usb_hw, i2c, i2c_hw, spi_hw, boot_state and
    the SAU/GTZC/SCB/NVIC/DWT/SysTick blocks now go through safe methods;
    the per-driver unsafety collapses to a single SAFETY-commented
    address-binding block.
    Side effects:
    - Adds Reg32::read_at / write_at for contiguous register banks
    (PKA RAM operand slots, OTP quad-words).
    - Drops unsafe f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
    [boot_state.rs, buttons.rs, cmd_fw_abort.rs, cmd_fw_begin.rs, cmd_fw_chunk.rs, cmd_fw_commit.rs, cmd_fw_status.rs, cmd_get_init_code.rs]
2026-05-15 deadcode(proto): remove unreachable code
    Automated dead-code removal pass produced by
    tools/spawn_readability_agents.py. Source deletions are scoped to
    proto; post-deletion cargo fmt/check/clippy/test (and binary-hash
    where applicable) are EQUIV to the pre-deletion baseline. See
    reports/deadcode/proto.md for the deletion log and any reverts.
    [lib.rs]
2026-05-15 deadcode(domain): remove unreachable code
    domain; post-deletion cargo fmt/check/clippy/test (and binary-hash
    reports/deadcode/domain.md for the deletion log and any reverts.
    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
    [lib.rs]
2026-05-15 deadcode(sphincs-c10): remove unreachable code
    sphincs-c10; post-deletion cargo fmt/check/clippy/test (and binary-hash
    reports/deadcode/sphincs-c10.md for the deletion log and any reverts.
    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
    [lib.rs]
2026-05-15 deadcode(dbgen): remove unreachable code
    dbgen; post-deletion cargo fmt/check/clippy/test (and binary-hash
    reports/deadcode/dbgen.md for the deletion log and any reverts.
    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
    [main.rs]
2026-05-15 deadcode(secure-nsc-sign-userop): remove unreachable code
    secure-nsc-sign-userop; post-deletion cargo fmt/check/clippy/test (and binary-hash
    reports/deadcode/secure-nsc-sign-userop.md for the deletion log and any reverts.
    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
    [cmd_sign_userop.rs]
2026-05-15 deadcode(secure-nsc-batch-offchain): remove unreachable code
    secure-nsc-batch-offchain; post-deletion cargo fmt/check/clippy/test (and binary-hash
    reports/deadcode/secure-nsc-batch-offchain.md for the deletion log and any reverts.
    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
    [cmd_sign_userop_batch.rs]
2026-05-15 deadcode(secure-nsc-fw-update): remove unreachable code
    secure-nsc-fw-update; post-deletion cargo fmt/check/clippy/test (and binary-hash
    reports/deadcode/secure-nsc-fw-update.md for the deletion log and any reverts.
    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
    [cmd_fw_begin.rs]
2026-05-15 deadcode(secure-nsc-core): remove unreachable code
    secure-nsc-core; post-deletion cargo fmt/check/clippy/test (and binary-hash
    reports/deadcode/secure-nsc-core.md for the deletion log and any reverts.
    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
    [mod.rs]
2026-05-15 deadcode(secure-hw-crypto): remove unreachable code
    secure-hw-crypto; post-deletion cargo fmt/check/clippy/test (and binary-hash
    reports/deadcode/secure-hw-crypto.md for the deletion log and any reverts.
    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
    [bhk.rs, secret_keys.rs]
2026-05-15 deadcode(secure-hw-platform): remove unreachable code
    secure-hw-platform; post-deletion cargo fmt/check/clippy/test (and binary-hash
    reports/deadcode/secure-hw-platform.md for the deletion log and any reverts.
    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
    [consumption_mask.rs, flash.rs]
2026-05-15 deadcode(secure-hw-io): remove unreachable code
    secure-hw-io; post-deletion cargo fmt/check/clippy/test (and binary-hash
    reports/deadcode/secure-hw-io.md for the deletion log and any reverts.
    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
    [buttons.rs]
2026-05-15 deadcode(secure-tx-display): remove unreachable code
    secure-tx-display; post-deletion cargo fmt/check/clippy/test (and binary-hash
    reports/deadcode/secure-tx-display.md for the deletion log and any reverts.
    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
    [mod.rs]
2026-05-15 deadcode(secure-tx-eip712): remove unreachable code
    secure-tx-eip712; post-deletion cargo fmt/check/clippy/test (and binary-hash
    reports/deadcode/secure-tx-eip712.md for the deletion log and any reverts.
    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
    [mod.rs]
2026-05-15 deadcode(secure-optiga): remove unreachable code
    secure-optiga; post-deletion cargo fmt/check/clippy/test (and binary-hash
    reports/deadcode/secure-optiga.md for the deletion log and any reverts.
    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
    [apdu.rs, i2c.rs, ifx_i2c.rs, mod.rs, shield.rs]
2026-05-15 deadcode(secure-se050): remove unreachable code
    secure-se050; post-deletion cargo fmt/check/clippy/test (and binary-hash
    reports/deadcode/secure-se050.md for the deletion log and any reverts.
    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
    [apdu.rs, i2c.rs, mod.rs, scp03.rs, t1oi2c.rs]
2026-05-15 deadcode(secure-fw-update-boot): remove unreachable code
    secure-fw-update-boot; post-deletion cargo fmt/check/clippy/test (and binary-hash
    reports/deadcode/secure-fw-update-boot.md for the deletion log and any reverts.
    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
    [mod.rs, verify.rs]
2026-05-15 deadcode(secure-main-sau): remove unreachable code
    secure-main-sau; post-deletion cargo fmt/check/clippy/test (and binary-hash
    reports/deadcode/secure-main-sau.md for the deletion log and any reverts.
    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
    [main.rs]
2026-05-15 deadcode(secure-crypto-glue): remove unreachable code
    secure-crypto-glue; post-deletion cargo fmt/check/clippy/test (and binary-hash
    reports/deadcode/secure-crypto-glue.md for the deletion log and any reverts.
    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
    [crypto.rs]
2026-05-15 deadcode(secure-fi-pin-rng): remove unreachable code
    secure-fi-pin-rng; post-deletion cargo fmt/check/clippy/test (and binary-hash
    reports/deadcode/secure-fi-pin-rng.md for the deletion log and any reverts.
    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
    [fi.rs, timeout.rs]
2026-05-15 deadcode(secure-se-misc): remove unreachable code
    secure-se-misc; post-deletion cargo fmt/check/clippy/test (and binary-hash
    reports/deadcode/secure-se-misc.md for the deletion log and any reverts.
    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
    [scp03_logic.rs, secure_element.rs]
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2026-05-16 tests(tx-core): add positive + negative suite
    Automated test-writing pass produced by
    tools/spawn_readability_agents.py. Adds positive functional
    coverage plus negative tests that challenge the assumptions the
    slice's code holds. Host-runnable subset passes locally; any
    on-target-only tests are documented in the report. See
    reports/tests/tx-core.md for the test inventory and any production-code
    bugs surfaced.
    [mod.rs]
2026-05-16 tests(tx): add positive + negative suite
    reports/tests/tx.md for the test inventory and any production-code
    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
    [mod.rs]
2026-05-16 tests(fwmeasure): add positive + negative suite
    reports/tests/fwmeasure.md for the test inventory and any production-code
    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
    [main.rs, mod.rs]
2026-05-16 tests(fwsign): add positive + negative suite
    reports/tests/fwsign.md for the test inventory and any production-code
    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
    [bundle.rs, keystore.rs, main.rs]
2026-05-16 tests(dbgen): add positive + negative suite
    reports/tests/dbgen.md for the test inventory and any production-code
    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
    [erc20.rs, merkle.rs, names.rs]
2026-05-16 tests(zk-test): add positive + negative suite
    reports/tests/zk-test.md for the test inventory and any production-code
    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
    [main.rs]
2026-05-16 tests(xtask): add positive + negative suite
    reports/tests/xtask.md for the test inventory and any production-code
    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
    [main.rs]
2026-05-17 tests(secure-nsc-sign-userop): add positive + negative suite
    reports/tests/secure-nsc-sign-userop.md for the test inventory and any production-code
    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
    [main.rs]
2026-05-17 tests(secure-nsc-batch-offchain): add positive + negative suite
    reports/tests/secure-nsc-batch-offchain.md for the test inventory and any production-code
    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
    [main.rs]
2026-05-17 tests(secure-nsc-small-cmds): add positive + negative suite
    reports/tests/secure-nsc-small-cmds.md for the test inventory and any production-code
    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
    [main.rs]
2026-05-17 tests(secure-nsc-fw-update): add positive + negative suite
    reports/tests/secure-nsc-fw-update.md for the test inventory and any production-code
    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
    [main.rs]
2026-05-17 tests(secure-nsc-core): add positive + negative suite
    reports/tests/secure-nsc-core.md for the test inventory and any production-code
    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
    [main.rs, mod.rs, ns_ptr.rs, state.rs]
2026-05-17 tests(secure-hw-crypto): add positive + negative suite
    reports/tests/secure-hw-crypto.md for the test inventory and any production-code
    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
    [main.rs, mod.rs]
2026-05-17 tests(secure-hw-platform): add positive + negative suite
    reports/tests/secure-hw-platform.md for the test inventory and any production-code
    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
    [main.rs, mod.rs]
2026-05-17 tests(secure-hw-io): add positive + negative suite
    reports/tests/secure-hw-io.md for the test inventory and any production-code
    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
    [main.rs, mod.rs]
2026-05-17 tests(secure-tx-display): add positive + negative suite
    reports/tests/secure-tx-display.md for the test inventory and any production-code
    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
    [main.rs, mod.rs]
2026-05-17 tests(secure-tx-eip712): add positive + negative suite
    reports/tests/secure-tx-eip712.md for the test inventory and any production-code
    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
    [mod.rs]
2026-05-17 tests(secure-optiga): add positive + negative suite
    reports/tests/secure-optiga.md for the test inventory and any production-code
    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
    [main.rs, mod.rs]
2026-05-17 tests(secure-se050): add positive + negative suite
    reports/tests/secure-se050.md for the test inventory and any production-code
    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
    [main.rs, mod.rs]
2026-05-17 tests(secure-zk): add positive + negative suite
    reports/tests/secure-zk.md for the test inventory and any production-code
    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
    [main.rs, mod.rs]
2026-05-17 tests(secure-ui): add positive + negative suite
    reports/tests/secure-ui.md for the test inventory and any production-code
    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
    [main.rs, mod.rs]
2026-05-17 tests(secure-fw-update-boot): add positive + negative suite
    reports/tests/secure-fw-update-boot.md for the test inventory and any production-code
    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
    [main.rs]
2026-05-17 tests(secure-main-sau): add positive + negative suite
    reports/tests/secure-main-sau.md for the test inventory and any production-code
    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
    [main.rs, main_sau_pure_tests.rs]
2026-05-17 tests(secure-crypto-glue): add positive + negative suite
    reports/tests/secure-crypto-glue.md for the test inventory and any production-code
    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
    [main.rs, mod.rs]
2026-05-17 tests(secure-fi-pin-rng): add positive + negative suite
    reports/tests/secure-fi-pin-rng.md for the test inventory and any production-code
    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
    [main.rs]
2026-05-17 tests(secure-se-misc): add positive + negative suite
    reports/tests/secure-se-misc.md for the test inventory and any production-code
    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
    [cmac.rs, main.rs, scp03_logic.rs, secure_element.rs]
2026-05-17 fix: clear three bugs surfaced by the negative-test suite
    - secure/src/nsc/ptr_validate.rs — validate_ns_{read,write}_ptr reject
    len > u32::MAX as usize before the `len as u32` cast. No-op on
    32-bit ARM (usize == u32); defensive on 64-bit host test builds
    where the cast was silently truncating a multi-gigabyte range to a
    tiny end address that then passed checked_add. Surfaced by
    nsc::ns_ptr::tests::negative_raw_validate_rejects_oversized_usize_len.
    - secure/src/tx/typed_call/abi.rs — word() uses off.checked_add(32)?
    instead of off + 32, removing a panic on pathological offsets near
    usize::MAX. Surfaced by
    tx::typed_call::abi::tests::negative_word_offset_overflow_shoul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
    [ns_ptr.rs, ptr_validate.rs]
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2026-05-18 sca: SAES-DHUK CMAC wrapper leakage analysis — clean on 4 TVLA modes
    New `tools/sca/saes_kdf_target/` thumbv8m crate exposes the production
    `secure/src/cmac.rs::cmac_generic` and `kdf_cmac_counter_generic`
    (`#[path]`-included verbatim — prod-side drift breaks the build loudly)
    to rainbow's emulator under a software AES-256 closure. The bitsliced
    soft AES stands in for the SAES coprocessor's `KeySel::Dhuk` path that
    rainbow/Unicorn cannot model.
    Four `mem_address`-channel TVLAs via `leakage_saes_kdf.py`, all on
    600 traces × 7-9K samples:
    - sca_saes_cmac vary KEY, fix msg: max|t| = 0.00 → flat
    - sca_saes_cmac vary MSG, fix key: max|t| = 0.00 → flat
    -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
    [build.rs, main.rs]
2026-05-18 sca: wait_random loop-count leakage TVLA — clean
    Closes work-todo §18b "Leakage pass over the FI guards themselves."
    New `sca_fi_wait_random_n(byte)` symbol on `fi_target` calls
    `pqsigner_fi::wait_random_loop` with a one-shot closure returning the
    caller-supplied byte. Standalone harness `leakage_wait_random.py`
    feeds it 600 traces fixed-vs-random in [180, 220] (tight range to keep
    trace lengths similar — avoids `min(trace_lengths)` truncation cutting
    everything to the shortest trace's setup samples).
    Result: max|t| = 2.68 over 736 samples (≈ 180 loop iterations × 4
    mem-events + setup), well below the 4.5 TVLA threshold.
    `wait_random_loop`'s per-iteration mem_address pattern is ide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
    [main.rs]
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2026-05-18 sca(F-22): BIP-39 wordlist lookup leaks 264 entropy bits — finding documented, fix deferred
    `Mnemonic::to_seed("")` (`bip39/src/lib.rs:183`) calls `self.words()`,
    which does `WORDLIST[idx]` lookups for each of 24 indices. Each load
    goes to `&WORDLIST[0] + idx * sizeof(&str)`, so the load ADDRESS
    encodes the secret idx. 24 × 11 bits = 264 leaked bits, strictly
    greater than 256-bit BIP-39 entropy → seed reconstruction from a
    single boot trace.
    New `leakage_bip39.py` + `sca_bip39_*` targets in `kdf_target`
    quantify this:
    - Control (`sca_bip39_word_indices`): SHA-256 + index unpacking, no
    wordlist load. max|t| = 0.00 — clean.
    - Subject (`sca_bip39_wordlist_lookup`): adds `WORDLIST[idx]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
    [main.rs]
2026-05-18 fix(bip39): F-22 — constant-time wordlist scan closes the 264-bit seed-leak
    Replaces `Mnemonic::to_seed`'s leaky `WORDLIST[idx]` lookups with a
    constant-time scan. Closes the F-22 finding documented in
    `tools/sca/README.md`.
    Before: `make bip39-leak` showed max|t| = 27.98 (6.2× the 4.5 TVLA
    threshold), 5 periodic peaks consistent with 24 index-keyed loads —
    sufficient address-channel signal to reconstruct the BIP-39 seed
    from a single cold-boot trace.
    After: max|t| = 0.00 on the post-fix probe over 24,851 samples — the
    trace is perfectly constant across all inputs.
    - New `WORDLIST_FLAT: [[u8; 8]; 2048]` + `WORDLIST_LENS: [u8; 2048]`
    derived from the existing `WORD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
    [lib.rs, main.rs]
2026-05-18 sca(F-22 follow-up): audit remaining secret-bearing derivation paths — all clean
    New `leakage_seed_derivation.py` + three `sca_*_seed_from_bip39`
    targets cover the three SHA-256-based derivation chains that
    `derive_keypair_from_entropy` feeds the bip39_seed through after
    F-22's wordlist lookup:
    - `slhdsa_seed_from_bip39` (2× kdf_sha256, sphincsc7 tags)
    - `bootstrap_seed_from_bip39` (2× kdf_sha256, bootstrap tags)
    - `slot_master_entropy_from_bip39` (1× kdf_sha256, slot-master tag)
    TVLA fixed-vs-random bip39_seed (600 traces, 64-byte input):
    slhdsa max|t| = 0.000 flat (2522 samples)
    bootstrap max|t| = 0.000 flat (2528 samples)
    slot_master max|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
    [main.rs]
2026-05-18 fix(bip39): constant-time `Mnemonic::word_bytes` + seed_wizard migration (F-24 stages A-C)
    Closes the wordlist + flash-byte stages of the seed-display leak
    chain (F-24 stages A/B/C; the OLED font-table stage D and OLED
    emission stage E remain — see scope note below).
    Production change in two parts:
    1. `bip39/src/lib.rs` — new `Mnemonic::word_bytes(i, &mut [u8; 8]) -> u8`
    API that uses the same `ct_load_word` constant-time scan as the
    F-22 fix in `to_seed`. The old `Mnemonic::word()` /
    `Mnemonic::words()` remain available with a doc-comment caveat —
    safe ONLY for callers where the index is public (measured_boot's
    firmware-hash display).
    2. `secure/src/ui/seed_wizard.rs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
    [lib.rs]
2026-05-18 fix(ui): F-24 stage D — constant-time glyph blit for seed-wizard word rows
    Closes the OLED font-table lookup leak in `seed_wizard::render_mnemonic_page`.
    Together with F-22 (wordlist scan) and F-24 stages A-C (`m.word_bytes`),
    this closes the entire CPU-side leak chain for the seed-display path —
    only stage E (the OLED's own EM emission when the framebuffer is shifted
    out) remains, and that's unfixable in firmware.
    - `secure/assets/font_5x8.raw` — vendored from embedded-graphics
    v0.8.2's `fonts/raw/ascii/font_5x8.raw` (MIT-licensed; attribution
    in `secure/assets/font_5x8.LICENSE`). 480 bytes, 80×48 1-bpp bitmap
    = 16 × 6 grid of 5×8 glyphs covering ASC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
    [build.rs, main.rs, mod.rs]
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2026-05-18 sca: PIN-verify CPU chain leakage TVLA — clean
    New `sca_optiga_pin_derive` target mirrors the OPTIGA PIN-verify
    hot path: `derive_pin_secret(pin)` (SHA-256(domain ‖ pin ‖ [0]))
    followed by `hmac_sha256(pin_secret, FIXED_NONCE)`. The PIN bytes
    flow through both calls in CPU memory; if either had address-keyed
    dependence the 8-digit PIN would be recoverable via EM scoping
    during a successful unlock — bypassing the 10-attempt silicon
    lockout entirely.
    TVLA fixed-vs-random 8-byte PIN, 600 traces:
    max|t| = 0.000 over 3,137 samples → **flat**
    Confirms the `sha2` 0.10 bitsliced soft backend on thumbv8m is
    constant-time at the address level for the PIN-handling path —
    same property a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
    [main.rs]
2026-05-18 fix(bip39): F-25 — `lookup_prefix` constant-time scan closes recovery-path leak
    Symmetric pair to F-22 — same data (BIP-39 wordlist), opposite direction
    (seed ENTRY during recovery instead of seed DERIVATION during provisioning).
    Pre-fix `lookup_prefix` did a binary search over `WORDLIST: [&str; 2048]`
    on every keystroke via `partition_point` + walk-forward `starts_with`.
    Both phases visited flash addresses keyed on the typed prefix.
    `make recovery-leak` baseline: max|t| = 45.43 over 248 samples → 10×
    threshold. Peaks at samples 196/197/218/172/221 consistent with the
    11 binary-search midpoints + the forward walk.
    Attack model: an attacker EM-scoping the CPU during the 60-120 s
    rec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
    [lib.rs, main.rs]
2026-05-18 sca: groth16_target + baseline validator — scaffolds the FI sweep over real Groth16 verify
    New `tools/sca/groth16_target/` thumbv8m crate wraps the real Groth16
    verifier from `secure/src/zk/groth16.rs` (`groth16_verify` mirrored
    verbatim — drift watch noted). Path-deps `bls12_381_pka` directly so
    the target builds in its own detached workspace, runs the real
    pairing math via the `bls12_381` software backend.
    Wire format: 1408-byte input buffer at `r0` =
    VK(960) ‖ proof_A(96) ‖ proof_B(192) ‖ proof_C(96) ‖ pub0(32) ‖ pub1(32)
    Exit code: 1 (proof verified) / 0 (rejected) / 2 (deser failed).
    `fault_sweep_groth16.py` parses the existing committed test vectors
    (`secure/src/zk/{t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
    [build.rs, main.rs]
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2026-05-19 fix(bip39): F-27 — recovery candidate-pick gate constant-time
    Sweeping `measured_boot.rs` + `tx/display/*` for the F-22-class
    `WORDLIST[idx]` pattern confirmed both paths are clean (data they
    render is public). The same sweep landed on `secure/src/ui/seed_wizard.rs`
    and turned up two real production leaks in the recovery candidate-pick
    gate — both on secret typed-prefix input.
    Leak A — `seed_wizard::prefix_is_exact_word`: a second
    `WORDLIST.binary_search_by` (F-25 closed the one in `bip39::lookup_prefix`
    but never named this second copy). Visited midpoint addresses leak the
    prefix bytes the user just typed.
    Leak B — `seed_wizard::render_candidate_screen`: stacked two channels
    on th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
    [lib.rs, main.rs]
2026-05-19 hygiene(bip39): delete leaky `WORDLIST[idx]` pattern from non-secret paths
    Follow-up to F-27: migrate the remaining production `WORDLIST[idx]`
    indexed-load call sites to the constant-time `word_bytes_at(idx)` API
    so the leaky address-keyed-load pattern doesn't survive in the codebase
    to be copy-pasted into a future secret-bearing context.
    Three call sites migrated:
    1. `bip39::lookup_word_exact` rewritten from `WORDLIST.binary_search_by`
    to a 2048-entry CT scan, same `(byte_eq, len_eq) + black_box` shape
    as `is_exact_wordlist_entry`. Conditional-select captures the first
    hit's idx via mask-OR. Sole production caller (`Mnemonic::from_words`)
    is only invoked from the e2e-test path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
    [lib.rs, measured_boot.rs]
2026-05-19 fix(se050): §25 Gap 4 — silicon-locked UserID maps to PinLocked, fires wipe
    Closes the corruption/desync stuck-loop case where the MCU page-124
    counter has been reset (flash fault, RDP regression mid-cycle, dev-tool
    intervention) but the SE050 UserID is silicon-locked. Pre-fix, a fresh
    PIN attempt against a locked UserID hit the `Status(sw)` catch-all →
    `UnlockError::InternalError` → the gateway treated it as transient,
    NO WIPE → device stuck in a retry loop with no way to ever succeed
    and no way to ever wipe.
    Original work-todo guess "0x6983" was the A71CL legacy code
    (`SE_HAL_Lib.h::A71CL_SE_HAL_ERR_KEY_LOCKED = 0xCC // 6983`). SE050's
    own `se05x_tlv.h::smStatus_t` does NOT inclu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
    [apdu.rs, mod.rs]
2026-05-19 hygiene(bip39): audit + sentinel — zero production callers of leaky `.word()` API
    Follow-up to F-22 / F-27 / prior hygiene cleanup. Audited every caller
    of `Mnemonic::word(i) -> &'static str` and `Mnemonic::words() -> impl
    Iterator<Item = &'static str>` (the two remaining "address-leaks the
    index" public APIs in bip39):
    Findings:
    - ZERO production secret-bearing callers (all migrated previously).
    - ZERO production non-secret callers post-hygiene-cleanup.
    - 2 `#[cfg(feature = "debug-log")]`-gated dev-log call sites still
    using the leaky API: `main.rs:2610` (first-boot mnemonic dump) and
    `seed_wizard.rs:249` (verify-step log). The seed_wizard one was
    missed in the prior hygiene pass;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
    [lib.rs, main.rs]
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2026-05-19 feat(ui): F-24 stage E Phase 1 — decoy frames gated behind `decoy-frames` (OFF by default after OLED bench-test)
    Bench result (SSD1306 OLED + I²C @ 400 kHz, 2026-05-19): persistence-
    of-vision-hiding of decoy frames does NOT work on bistable displays.
    Tested via the new `decoy-flicker-test` Cargo feature + `make decoy-
    flicker-hw` Makefile target. At the original 5:1 (200ms:40ms) cadence
    the user sees N+1 mnemonics cycling, not a stable real frame with
    subliminal decoys. Bumping REAL_FRAME_HOLD_MS to 2000 didn't help —
    OLED pixels hold state indefinitely between paints, so any decoy
    hold > the eye's content-change threshold (~10 ms) is fully visible.
    Root cause: persistence-of-vision (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
    [main.rs]
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2026-05-19 feat(factory): provisioning ceremony — Phase A scaffold (operator-facing firmware)
    Single-purpose firmware the factory operator flashes to a fresh
    device. Runs once, walks a 6-step state machine, and halts on
    either "FACTORY OK" or "FACTORY FAIL @ STEP X/6 EXXXX" with a
    numeric error code the operator photographs and reports back.
    The operator doesn't need to understand what each step does. They
    flash, power-cycle, watch the OLED, ship or set aside. Vendor (us)
    maintains an error-code → diagnosis table in
    `docs/factory-provisioning.md`.
    Ceremony steps:
    1. Hardware self-test (SAES Tier-1 + BHK Tier-2 lifecycle)
    2. OTP master key (under dev-testkey it's a constant; production
    bu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
    [factory_provisioning.rs, main.rs]
2026-05-19 feat(factory): Phase A.1 — rehearsal mode + compile fence + OTP sentinel
    Three foot-gun protections layered onto the Phase A factory
    provisioning scaffold (commit 8338415):
    (1) REHEARSAL MODE — new `factory-provisioning-rehearsal` Cargo
    feature. Steps 4 (DualSeProvision), 5 (WipeUserState), 6
    (PostWipeValidation) skip their destructive calls. The OLED still
    cycles all 7 panels so the operator can validate layout, but no
    SE-side state is mutated. OTP sentinel records BIT_REHEARSAL (not
    BIT_PRODUCTION) so the host fixture refuses to bump RDP2 on a
    rehearsal-only chip. Distinct success panel "REHEARSAL OK / SE NOT
    changed / NOT for ship!" so operator + fixture can't confuse it.
    New `make b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
    [factory_provisioning.rs, otp.rs]
2026-05-19 feat(factory): Phase A.2 — flash + verify + RDP2-bump Makefile targets
    Wires the host-side orchestration on top of Phase A.1's foot-gun
    protections.
    Three new Makefile targets:
    make flash-hw-factory-provisioning
    probe-rs download (NS + S) + STM32_Programmer_CLI TZ option-
    byte config + probe-rs reset + tools/factory-provisioning-
    verify.sh. Does NOT bump RDP2.
    make flash-hw-factory-provisioning-rehearsal
    Same as above but uses the rehearsal build (steps 4-6 skip
    destructive calls).
    make bump-rdp2-after-factory
    Re-reads the OTP sentinel, refuses unless BIT_PRODUCTION is
    cleared, prompts the operator to type "BUMP RDP2" as final
    confi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
    [factory_provisioning.rs]
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2026-05-19 prodtest: Phase C — communication tests (OPTIGA + SE050 + USB integrity)
    Adds the third tier of prodtest commands — the ones that exercise
    the I²C and USB stacks end-to-end so a defective chip / broken
    solder / wedged USB controller is caught BEFORE the irreversible
    `factory_provisioning` ceremony writes E140 + rotates SCP03 keys.
    3 new commands at IDs 106-108:
    CMD_PRODTEST_OPTIGA_HANDSHAKE (106)
    Lazy `OptigaTrustM::init()` (RST pulse + OpenApplication) then
    `GetRandom(16)`. No PBS, no shielded connection (fresh chip ⇒
    shield.active == false ⇒ send_command goes through the plain
    APDU path). Catches: missing chip, broken solder, wedged I²C,
    wrong RST line / floating, pow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
    [lib.rs, mod.rs]
2026-05-19 prodtest: Phase D — interactive button test
    CMD_PRODTEST_BUTTON_TEST (109) — 3-step LEFT → RIGHT → BOTH
    verification, 10 s per step. Returns 4 bytes (step_status:1 +
    reserved:3) with compact nibble encoding:
    upper nibble = step (1, 2, 3)
    lower nibble = error kind (1=timeout, 2=wrong button)
    0x00 — all 3 steps OK
    0x11 — step 1 (LEFT) timeout ← dead solder / membrane
    0x12 — step 1 (LEFT) wrong button ← swapped wires at connector
    0x21 — step 2 (RIGHT) timeout
    0x22 — step 2 (RIGHT) wrong button
    0x31 — step 3 (BOTH) timeout
    Wrong-button detection is the diagnostically interesting bit:
    swapped wires = rewire + retry; dead solder = re-solder + retry.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
    [buttons.rs, lib.rs, main.rs, mod.rs]
2026-05-19 prodtest: Phase E — USB launch fix + INS dispatch + Python HID framing
    First Phase that makes the prodtest commands actually reachable
    over USB. Three pieces:
    1) Firmware USB-launch fix.
    The prodtest main-loop short-circuit was halting in WFI before
    `boot_ns::boot`, so the NS USB stack never started — every
    "Phase A/B/C/D done" was firmware-only and not actually reachable
    from a host. Rewired to run the final-stage init the NS world
    depends on (`hw::usb_hw::init`, `setup_systick`, DWT cycle counter)
    then call `boot_ns::boot(NS_FLASH_BASE)` — same exit primitive the
    production main flow uses. The "PRODTEST READY" OLED panel shows
    briefly then NS world takes over.
    2) Per-CMD INS alloc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
    [lib.rs, main.rs, nsc_api.rs]
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2026-05-19 hardening: pin channel-ID isolation in HidFrameAssembler with regression tests
    work-todo §31a #1 — first item of the Trezor-derived USB/FW-update
    hardening sweep.
    Re-audit of `shared/src/apdu_framing.rs::HidFrameAssembler::process_frame`
    shows channel-ID isolation is ALREADY in place at line 364:
    if channel != self.channel_id || seq != self.rx_seq {
    self.reset();
    return FrameOutcome::Dropped;
    }
    The proptest harness exercises this path via random-byte fuzzing
    but doesn't construct an explicit positive/negative channel-ID
    pair. A fix-then-regress that silently weakens this line would
    slip past CI.
    Three hand-written regression tests pin the behavior:
    hid_chann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
    [apdu_framing.rs]
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2026-05-19 hardening: §31b — wire FW-update trusted-UI confirm (4 fields)
    Re-audit on 2026-05-19 corrected the original premise:
    `secure/src/ui/confirm.rs` is NOT a WIP — it's the production
    sign-confirm path used by every sign command. The "stable again"
    comment on the `confirm_commit` stub was stale. Wiring the four
    §31b fields just needed building a 4-page `Page` array and
    calling `ui::confirm::confirm(&pages)`.
    Page 1 (version + direction)
    Row 0: "FW UPDATE"
    Row 1: "to vA.B.C.D" — u32 fw_version decoded as 4 BE bytes
    per Trezor's MAJOR.MINOR.PATCH.BUILD convention
    Row 2: UPGRADE / SAME VERSION / DOWNGRADE! — comparison of
    `otp::rollback_floor()` against `manifest.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
    [mod.rs]
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2026-05-20 feat(erc7730): Phase 1 — workspace crate, IR parser, Merkle bundle, binding
    EF launched Clear Signing 2026-05-12 (clearsigning.org). This lands the
    on-device foundation for ERC-7730 + ERC-8213 support. ERC-8176 stays
    host-side only — verifying secp256k1 / ERC-1271 attestations on-device
    would break invariant #5 ("no classical signer anywhere"); attestation
    policy is enforced at descriptor compile time in Phase 2.
    Phase 1 ships the pure-logic surface only:
    * New crate pqsigner-erc7730 (no_std, no alloc, cross-compiles for
    thumbv8m.main-none-eabi): zero-copy IR header parser, Merkle-trailer
    verifier reusing pqsigner-tx::erc20::merkle::verify_proof,
    context-binding cross-check for b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
    [bundle.rs, lib.rs, mod.rs]
2026-05-20 feat(erc7730): Phase 2 — host IR compiler + Merkle DB + xtask gate
    EF Clear Signing launched 2026-05-12. Phase 1 (d6beefb) shipped the
    on-device IR parser + Merkle-bundle verifier + binding cross-check.
    Phase 2 lands the host build pipeline so ERC7730_DESCRIPTORS_ROOT is
    generated from a curated descriptor catalogue that has cleared the
    ERC-8176 attestation policy at compile time — preserving invariant #5
    (no classical signer anywhere; 8176 secp256k1/ERC-1271 sig verification
    stays host-side).
    * dbgen/src/erc7730.rs (~1300 LOC, pure-Rust): parses ERC-7730 v2 JSON,
    JCS-canonicalises (RFC 8785 subset) to compute the 32-byte
    descriptor_hash baked into IR offset 30..62, enforces policy.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
    [lib.rs, main.rs]
2026-05-20 feat(erc7730): Phase 3 — sign-input trailer + walker + EIP-712 typed kind
    Wires Phase 2's host pipeline (b5a4485) end-to-end through the
    secure-world sign path. Companion ships a Merkle-verified IR + proof
    inside a new optional trailer slot on every CMD_SIGN_USEROP /
    CMD_SIGN_USEROP_BATCH / CMD_SIGN_OFFCHAIN call; the secure world
    verifies against ERC7730_DESCRIPTORS_ROOT, cross-checks the binding
    against the actual transaction, and (Phase 4) renders descriptor
    pages instead of generic blind-sign.
    proto/src/lib.rs:
    * ERC7730_TRAILER_VERSION, ERC7730_IR_MAX (4096),
    ERC7730_PROOF_MAX_DEPTH (32), ERC7730_MAX_TRAILER_LEN (5130).
    * OFFCHAIN_KIND_EIP712_TYPED (2) +
    MAX_OFFCHAIN_EIP712_ENCOD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
    [build.rs, cmd_sign_offchain.rs, cmd_sign_userop.rs, cmd_sign_userop_batch.rs]
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2026-05-20 fix(erc7730): hoist sha3::Digest import in batch_digest builder
    Phase 4 had `use sha3::Digest;` scoped inside the initializer
    block, so methods 'update'/'finalize' weren't visible at outer
    call sites. Move the import up so the trait is in scope where
    batch_digest.update(...) / .finalize() are called.
    Cargo.lock also refreshed after rebase onto master.
    [cmd_sign_userop_batch.rs]
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2026-05-20 feat(erc7730): Phase 5 items 1+2 — production policy gate + includes resolution
    Item 1 (MUST): dbgen learns `--policy {dev|production}` + `--registry-root
    <dir>`. Production mode forces `allow_unattested_dev_descriptors = false`
    regardless of the TOML and fails loudly with a pointer to the fix
    ("add attestations or run with --policy dev for bring-up"). Default
    behaviour (`build_db` no-override) is byte-identical to pre-flag dbgen.
    Item 2 (MUST, partial): `compile_descriptor` now follows `"includes"`
    references against a local mirror passed via `--registry-root`. Three
    forms supported: GitHub blob URL (strip host+ref, treat path as
    registry-relative), `./relative` (against descriptor dir),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
    [main.rs]
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2026-05-20 feat(erc7730): Phase 5 item 6 — FI-hardened cross-check pairs
    The three ERC-7730 binding cross-check call sites
    (cross_check_contract in cmd_sign_userop + cmd_sign_userop_batch,
    cross_check_eip712 in cmd_sign_offchain) were previously
    single-instruction boolean gates: `if cross_check_*(...).is_err() {
    reject }`. A glitched skip on the cmp/branch would bypass them.
    Migrate to the `fi::check_true_into_sentinel` idiom that the
    verify-before-release pattern in `crypto::c10_sign_verified_with_progress`
    uses: compute the verdict once into a named bool, follow with
    `wait_random()` to defeat clock-aligned glitch bursts, then
    double-evaluate via `check_true_into_sentinel(|| black_box(verdict))`
    ag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
    [cmd_sign_offchain.rs, cmd_sign_userop.rs, cmd_sign_userop_batch.rs, main.rs]
2026-05-20 feat(erc7730): Phase 5 item 10 — compact-mode display toggle
    Phase 4 collapsed Visibility::Optional → Visibility::Always for every
    descriptor. Phase 5 item 10 distinguishes them again under an opt-in
    `COMPACT_MODE` const at the renderer entry point.
    - `tx::erc7730_render::visibility::should_render_with_mode(..., compact)`
    — new signature; existing `should_render` wraps it with `compact = false`.
    - `tx::display::erc7730::COMPACT_MODE` — renderer-level const,
    defaults to `false` so existing fixtures stay byte-identical. A
    future settings-page toggle can flip the const at runtime.
    - `render_fields` now plumbs `COMPACT_MODE` through to the visibility
    evaluator. The on-wire byte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
    [mod.rs]
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2026-05-20 test(erc7730): host render-string tests; exposes path_off=0 collision
    Adds `secure/src/display_under_test/erc7730_render_pure_tests.rs` — 10
    host-test pieces (9 active + 1 ignored diagnostic) that drive the
    contract-context ERC-7730 renderer + ERC-8213 fingerprint pages end-
    to-end against the firmware-pinned seed-corpus IRs and assert the
    exact OLED-row strings a user would see on the device.
    Tests cover:
    - Seed-corpus build sanity floor (≥ 6 leaves).
    - USDT mainnet transfer / approve-unlimited / WETH deposit
    (`@.value` container path). The full Send/Approve/Wrap intent
    banners, "Spender" / "To" / "Amount" / "unlimited" / ticker
    rendering. All three written as `#[should_panic(exp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
    [main.rs, mod.rs]
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2026-05-20 hardening: §18 P1 — entry jitter at the PIN gate
    Add `crate::fi::wait_random()` at the entry of `nsc::gated_unlock`
    and `cmd_request_unlock::verify_pin_with_chip`.
    Scope (advisor-reviewed): ONLY these two functions.
    - NOT the sign path — F-16's 43!×13! WOTS/FORS shuffle already
    jitters the secret-dependent timeline, so entry jitter there is
    marginal on top of internal jitter.
    - NOT an always-on RDI timer like Trezor's. Their systimer-driven
    rdi_handler burns random cycles in an ISR that would land
    mid-USB-bulk / mid-SE050-T=1' / mid-OPTIGA-Shielded-handshake.
    Trezor's own `rdi_disabled = sectrue` default + enable/disable
    scaffolding exist because they hit those intermitten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
    [cmd_request_unlock.rs, mod.rs]
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2026-05-20 §18 SHAKE-vs-SHA2 #2: masked-SHA2 cost bench harness
    Adds the harness to measure "how much slower is first-order-masked
    SHA-256 than the HASH peripheral?" — the #2 measurement that gates
    the SHAKE-vs-SHA2 decision. Ready to run on the bench.
    New `masked-sha2` workspace crate (pure no_std, first-order 2-share
    boolean masking, generic over an RNG closure):
    - sec_and — ISW masked AND (Ishai-Sahai-Wagner, CRYPTO 2003)
    - sec_add — Kogge-Stone secure boolean adder (Coron-Großschädl-
    Vadnala family, CHES 2014)
    - sec_xor / sec_not / sec_shl / sec_rotr — linear, free per-share
    - ADDS_PER_BLOCK=600, ANDS_PER_BLOCK=320 — SHA-256's fixed per-block
    gate counts, derived + co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
    [lib.rs, main.rs]
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2026-05-20 §18 SCA step (a): count secret-touching hashes per sign — 70,754 (not ~200)
    Adds a `hash-counters` feature to sphincs-c10 (atomic per-category
    counts, zero-cost when off) + a host test that signs once and reports
    the breakdown. Measured for one C10 sign:
    wots_secret (PRF, sk_seed) : 44,118
    fors_secret (PRF, sk_seed) : 26,636
    SECRET-touching total : 70,754 (13.1% of all hashes)
    chain_hash (WOTS chain F) : 44,204
    th* (tree node hashing) : 364,273
    other (h_msg/wots_digest) : 60,385
    TOTAL hash calls : 539,616
    This CORRECTS the ~200 estimate I gave last turn by ~350x. The
    reason for the large count: SLH-DSA signing regenerates every leaf
    of every signed su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
    [hash.rs, lib.rs]
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2026-05-20 docs(§12): close stale 192f-migration entry — record the C10/128-bit decision
    §12 ("SLH-DSA-SHA2-128f → 192f migration") was stale: it predated
    the all-C10 cutover and referenced a codebase that no longer exists
    — the generic `slh-dsa` crate, `Sha2_128f`/`Sha2_192f` type params,
    and 17,088 / 35,664-byte standard-param signatures. Verified: zero
    matches for any of those in the tree. The production signer is the
    custom `sphincs-c10` (SIGNATURE_LEN=4008, N=16 → 128-bit, NIST
    Category 1).
    Rewrote §12 from a migration TODO into a recorded decision:
    - C10 / 128-bit IS the production parameter set, chosen for on-chain
    verifier feasibility (the 4008-byte sig is what keeps the Yul
    SPH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
    [lib.rs]
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2026-05-20 §32: measure SE-verify timing channel — flips the drift-fix decision
    Extended the duress probe to DWT-time the SE verifies at production
    speed (new `make duress-timing-hw`, built without debug-log so the
    verifies aren't slowed by per-I²C-transaction semihosting; hprintln
    output). Added `Se050::probe_auth_existing_userid` (auth-only, the
    exact shape of the "extra real verify").
    RESULT on silicon: one OPTIGA HMAC verify ~160 ms (157-167, n=15),
    one SE050 UserID verify ~103 ms (102.6-105.4), skip-vs-run delta
    ~263 ms with ~6% jitter. The advisor and I had assumed ~10-50 ms
    per verify — the real verifies are 2-3× slower (OPTIGA shielded
    multi-transaction round-trips + SE050 SCP03). Unloc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
    [main.rs, mod.rs]
2026-05-20 feat(batch-sign): trailer parity v2 — TLV-tagged trailer list per inner tx
    Bring CMD_SIGN_USEROP_BATCH up to single-tx feature parity for every
    clear-signing trailer kind. Pre-parity, only an optional ERC-7730
    trailer at the tail was accepted; every other kind (ERC-20 metadata,
    ZK v1, ZK v3 CoW, Safe v1, selector curated, selector self-attest,
    address names) was silently dropped. Visible bug: a USDC `approve`
    on Base inside a 3-tx batch rendered "! Unknown token" because the
    ERC-20 metadata bundle that drives "Approve <amount> USDC" on the
    single-tx path was never carried in the batch wire format. The batch
    path also missed the CoW v3 / Safe v1 downgrade-mitigation gates, so
    a hostile NS c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
    [batch_trailers.rs, cmd_sign_userop_batch.rs, lib.rs, main.rs, mod.rs]
2026-05-20 §32: choose option B + measure plain-vs-auto-state pad delta
    DECIDED option B (skip the real verify on a duress match → real
    counters never bumped on duress → full three-way lockstep preserved,
    no E120 metadata change, no SE050 weakening). The spec check
    confirmed SE050's MAX_ATTEMPTS is creation-only with no
    cross-credential counter reset, so option A is forced to two-of-three
    — B is strictly better on lockout integrity.
    Minimization of B's one downside (timing residual): pad the skipped
    real verify with a REAL second duress-credential verify (natural
    jitter, touches only the harmless unlimited duress counter) rather
    than a NOP busy-wait, so the pad is a real SE op of the same type.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
    [main.rs, mod.rs]
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2026-05-20 Add: PQ1 CoW v3 addr-only trailer — clear-sign orders with unknown tokens
    Tokens absent from the firmware-pinned Poseidon-Merkle ERC-20 registry
    previously hard-failed in the offscreen prover. Adds a second v3 trailer
    flavour carrying only the 204-byte canonical (no proof, no readable):
    verify_and_bind_trailer recognises the short bundle, runs shape +
    cross-check (canonical → orderDigest → calldata.uid via keccak), and
    render_cowswap_pages_addr displays raw 20-byte token addresses plus
    full uint256 sell/buyAmount as 4×16 hex on the signer. Every GPv2Order
    field stays byte-bound to the on-chain calldata; only the symbol/
    formatted-amount in-circuit constraints are dropped.
    Co-Authored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
    [mod.rs, verify.rs]
2026-05-20 feat(safe-tx): decode Safe-native ops in approveHash clear-signing
    Extends the existing safe_v1 trailer renderer to decode the eight Safe
    v1.3.0+ singleton management selectors (addOwnerWithThreshold,
    removeOwner, swapOwner, changeThreshold, enableModule, disableModule,
    setGuard, setFallbackHandler) when the inner SafeTx targets the Safe
    itself. Previously these rendered as opaque BLIND SIGN — exactly the
    high-stakes ops where blind-signing is most dangerous. Per-op intent
    banners + explicit risk pages now surface threshold=1 ("MULTISIG OFF"),
    module/guard installs, and zero-address removals on the OLED before
    the user confirms.
    The cryptographic bind chain is unchanged: same eight-step v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
    [lib.rs, mod.rs]
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2026-05-20 feat(§32): validate matched-LUC dual-counter coexistence on silicon
    The matched-LUC duress design (F1D8 Execute=LUC(E121) alongside the real
    F1D0 Execute=LUC(E120)) was the one untested OPTIGA AC expression before
    baking it into P1/P2 provisioning code. Extended the duress probe to
    validate it on a real B-U585I + OPTIGA Trust M, all at LcsO=Creation:
    step 10 PASS:
    - two LUC-bound AuthRefs coexist (F1D8 re-provisioned plain→LUC(E121)
    cleanly; Change=ALW, never locked)
    - bump isolation: a duress auto-state verify moved E121 0→1 while the
    real E120 stayed at 15 — zero drift on the real lockout counter
    - timing twin: F1D8 auto-state 22428 us vs F1D0 auto-state 21598 us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
    [apdu.rs, main.rs, mod.rs]
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2026-05-20 fix(§32): atomic rollback + zeroize on duress-provision path
    Advisor review of the P1+P2 increment surfaced two real issues:
    1. Atomicity: the real wallet is already on-chip when the decoy is
    provisioned, and is_provisioned() is real-only, so a half-provisioned
    decoy would leave the device "provisioned" yet decoy-less and would
    never re-run the wizard. provision_duress_wallet now returns Result;
    on failure provision_from_mnemonic wipes BOTH wallets
    (factory_reset_admin) before halting so the next cold boot restarts
    the wizard cleanly.
    2. actual_duress_pin (a stack copy of the user/random PIN) was not
    zeroized — random_pin.zeroize() doesn't reach the distinct copy. N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
    [crypto.rs]
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2026-05-20 test(§32): duress-provision-e2e — validate full provision_duress on silicon
    P2 silicon-validation recipe (`make duress-provision-hw`). Provisions a
    real wallet + an independent decoy via the PRODUCTION provision /
    provision_duress path with a KNOWN decoy entropy, then proves the decoy
    is recoverable, correctly gated, and isolated:
    - duress_is_provisioned() && is_provisioned() both true
    - reads the OPTIGA decoy half (auth F1D8 auto-state, fires LUC(E121))
    + SE050 decoy half (auth duress UserID); half_o XOR half_e MUST equal
    the known decoy entropy (mirrors the real unlock cross-check)
    - the OPTIGA decoy read bumps ONLY E121, leaves real E120 untouched
    - the real wallet stil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
    [apdu.rs, main.rs, mod.rs]
2026-05-20 feat(§32): P3 timing-uniform duress unlock dispatch (pending review)
    Implements the duress-PIN unlock path. gated_unlock now tries the DECOY
    credential first; on a match it runs a matched-LUC timing pad (a 2nd
    duress verify standing in for the SKIPPED real verify, so the real E120
    lockout counter never drifts) and returns the decoy master; on no match
    it falls through to the real unlock. Both correct paths execute the same
    SE op-count (4 verifies + 2 reads) so an observer cannot tell a
    real-correct from a duress-correct unlock by total latency (deniability).
    A duress-correct unlock resets the MCU page-124 counter exactly like a
    real success.
    - WalletStore::unlock_duress (default Err PinI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
    [dual_se.rs, mod.rs, secure_element.rs]
2026-05-20 fix(§32 P3): E121 high limit + duress-success reset + master cross-check
    Advisor review of the P3 diff found two real issues:
    1. E121 lifetime lockout (blocker). The duress F1D8 verify fires LUC(E121)
    on EVERY unlock — including the failed duress verify unlock_duress runs
    on a real-PIN entry (the no-short-circuit timing structure). That bump
    is UNRESETTABLE (E121.Change=Auto(F1D8) is not satisfied by a failed
    verify), so E121 climbs ~1/unlock regardless of duress use; at the old
    0xFFFF limit the duress AuthRef silicon-locks in ~1.8 years @ 100/day.
    Fix: raise the limit to 0x00FF_FFFF (~460 years @ 100/day) — the
    load-bearing fix for the unresettable real-entry clim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
    [dual_se.rs, main.rs, mod.rs]
2026-05-20 test(§32 P3): exercise gated_unlock dispatch on silicon + doc notes
    Extends duress-provision-e2e (steps 10-14) to run the production
    timing-uniform gated_unlock dispatch end-to-end: duress PIN → decoy
    master (E120 untouched, confirming the real verify is skipped), real PIN
    → real master, wrong PIN → rejected, and real-unlock recovery after a
    wrong+duress sequence. §32 doc updated with the E121 unresettable-real-
    entry-climb reasoning + the one-time bench-chip limit migration note.
    [main.rs]
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2026-05-20 fix(§32 P2b): blank duress OIDs on factory_reset + validate post-wipe reprovision
    Addresses the advisor's post-wipe recoverability concern. Code analysis:
    the duress data OIDs use Change=Auto(F1D8) OR Conf(E140) (build_metadata_
    protected), so the Conf(E140)/shield path can rewrite them on re-provision
    exactly like the real OIDs — no brick. But factory_reset didn't sweep them
    (stale decoy data lingered). Now factory_reset_body best-effort blanks the
    duress OIDs (F1D8/F1D9/F1DA/F1DB/F1D6) over the shield; E121 is left intact
    (its Change=Auto(F1D8) has no Conf escape and it's an unenforced high-limit
    counter whose metadata must persist for the re-provision idempotency skip).
    Best-effort bec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
    [main.rs, mod.rs]
2026-05-20 feat(§32 P4): duress-PIN wizard dialog
    Adds the first-boot setup dialog so a user can actually choose their
    duress PIN instead of always getting a random one. ui::seed_wizard::
    collect_duress_pin (yes/no chooser → enter_pin_with_confirm, bounded to 3
    attempts, confirmed-distinct from the main PIN) runs ONLY on the
    unprovisioned first-boot path and threads Some(pin) into
    provision_from_mnemonic; declined/exhausted → None → random decoy
    (always-provision preserves deniability either way). The duress PIN is
    zeroized after provisioning.
    Dialog flow is interactive-only (e2e-test short-circuits confirm/
    enter_pin), so validation is source-grep (distinct-PIN check, bounded
    retries, collecte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
    [main.rs, main_sau_pure_tests.rs]
2026-05-20 feat(§32 P5): wipe-on-duress option
    Adds an optional setup choice: a duress-PIN entry can WIPE the device
    instead of opening the decoy wallet. Stored as a 1-byte flag in secure
    flash page 125 (QW2), blank=decoy (safe default), programmed=wipe — same
    1->0 bit-clear lifecycle as the wipe-in-progress flag; erase_admin_page
    (wipe finish) clears it back to decoy.
    - hw::flash::arm_duress_wipe_mode / is_duress_wipe_mode (page 125 QW2).
    - Wizard (P5 dialog): choose_duress_wipe_mode after the duress PIN is
    set; the flag is armed BEFORE provision_from_mnemonic so a crash can't
    silently downgrade wipe->decoy (blank=decoy is the conservative
    fallback; we only ever 1->0 upgrade to wipe).
    - gate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
    [flash.rs, main.rs, main_sau_pure_tests.rs, mod.rs]
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2026-05-20 test(§32 P4/P5): interactive duress-UI harness (make play-hw-duress-ui)
    Adds a focused, mock-se interactive harness to drive JUST the duress-PIN
    setup dialogs on the real OLED with keyboard-forwarded buttons — without
    standing up the full dual-SE provision. New duress-ui-test feature widens
    the dialog gating (collect_duress_pin / choose_duress_wipe_mode /
    yes_no), main.rs short-circuits into a dialog loop at boot (fixed main
    PIN 12345678 so the operator can verify the distinct-check reject), and
    the play-hw-duress-ui Makefile target builds/flashes/runs wallet_run_hw.py.
    1923 host tests pass; harness builds clean.
    [main.rs]
2026-05-20 fix(§32 duress-ui-test): use secure_log! not hprintln! in the harness
    Raw hprintln! is an ungated semihosting BKPT — with no debugger attached
    (e.g. right after a probe-rs download resets the board) it escalates to a
    HardFault and hangs the device before the OLED renders, leaving a dark
    screen. secure_log! is DHCSR.C_DEBUGEN-gated (no-op without a debugger),
    so the harness now boots cleanly standalone AND prints under probe-rs.
    [main.rs]
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2026-05-20 fix(§32 P4): hold duress-PIN error messages on screen long enough to read
    The 'Same as main' / 'PIN mismatch' rejects flashed for a split second
    because enter_pin_with_confirm immediately redrew over them — a user
    couldn't tell why their PIN was rejected. Add a 1.8 s readable hold
    (timeout::now()-based) after each in collect_duress_pin, and a 2.5 s
    hold on the duress-ui-test harness result screen. Also reword
    'try again' → 'pick another' on the same-as-main reject for clarity.
    [main.rs]
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2026-05-21 fix(safe-tx): accept ERC-20 bundle for Safe-exec inner-to in verify_meta gate
    The secure-world `verified_meta` cross-check at the top of trailer
    verification dropped any ERC-20 bundle whose `contract` didn't match
    the outer `tx.to_address`. For a Safe `execTransaction(...)` UserOp
    the outer `to` is the Safe contract, but the bundle (correctly built
    by the NS-side injector after the prior commits) attributes to the
    inner SafeTx target — so the gate discarded a perfectly valid bundle
    before it ever reached `pick_sign_pages`. End result on hardware: the
    OLED rendered `Erc20Unknown` ("ERC ?" + raw hex amount) for Safe-
    wrapped USDC transfers even though every other step in the pipeline
    had the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
    [cmd_sign_userop.rs]
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2026-05-22 fix(usb): USB-C device enumeration — enable CC detectors + disable dead-battery correctly
    init_ucpd had two register bugs that broke USB-C (C-to-C) enumeration,
    both confirmed against ST's authoritative LL driver + CMSIS:
    1. It set UCPD_CR bits CC1TCDIS/CC2TCDIS=1, commented as "disable
    dead-battery" — but those bits are the Type-C *voltage detector*
    disables (LL_UCPD_TypeCDetectionCC1Disable() = SET_BIT(CC1TCDIS)).
    Setting them BLINDED the CC detectors → UCPD_SR.TYPEC_VSTATE stuck at
    0, no attach ever sensed. Now left clear (detectors enabled).
    2. It never disabled the actual dead-battery, which on STM32U5 is
    PWR_UCPDR.UCPD_DBDIS (bit 0) — LL_PWR_DisableUCPDDeadBatt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
    [usb_hw.rs]
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2026-05-26 test(fw-update): reversible anti-rollback HW test (v1->v2->reject-v1)
    Adds a make target — `make fw-rollback-hw` — that proves the firmware
    anti-rollback decision (downgrade rejection) on real STM32U585 silicon
    WITHOUT any irreversible side effects. Critically: NO OTP burn, NO flash
    erase, NO boot-state write, NO reboot. The chip stays fully reflashable
    for continued dev work. Production OTP-burn FW-update validation is
    deferred to dedicated hardware.
    How it works: the test drives the REAL `fw_update::verify_manifest(m,
    floor)` — the exact verify chain CMD_FW_BEGIN runs (structural -> CRC ->
    digest -> vendor-fpr -> FI-hardened SPHINCS+C10 signature -> rollback
    floor) — with dev-key-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
    [fw_rollback_e2e.rs, main.rs, mod.rs]
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2026-05-26 fix(fw-update): bound manifest-declared image lengths vs slot capacity
    Finding #1 from docs/usb-fw-update-hardening.md. The manifest's
    secure_len/nonsecure_len fields are signed-over (so a network attacker
    can't change them) but the verify chain doesn't itself bound them against
    the actual A/B slot capacity. Without this check, a vendor-signed
    manifest declaring secure_len=u32::MAX would let later CHUNKs walk past
    the slot until check_chunk's per-chunk `checked_add` on
    `base_addr + chunk_offset` finally tripped — overwriting the other slot
    / FSBL pages / OPTIGA-pages-area in the meantime.
    Adds the bound after verify_manifest() in cmd_fw_begin, against
    flash::SLOT_SECURE_CAPACITY (464 KB)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
    [cmd_fw_begin.rs]
2026-05-26 fix(fw-manifest): constant-time compare in verify_vendor_fpr
    Finding #2 from docs/usb-fw-update-hardening.md. The vendor-fingerprint
    check was using `&expected == self.vendor_pubkey_fpr()` — Rust slice
    equality is short-circuiting and leaks the leading-match count.
    The compared value is itself PUBLIC (the build-baked vendor fingerprint),
    so a timing leak here doesn't reveal anything an attacker doesn't already
    have. This is a hygiene fix, not a confidentiality fix. The reason it's
    still worth doing: a non-CT compare in a security-critical verify path is
    exactly the kind of pattern a future refactor might copy into a *secret*-
    compare site. Use the right primitive in the right place.
    Adds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
    [lib.rs]
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2026-05-26 fix(fw-manifest): verify reserved-byte regions in verify_structural
    Finding #5 from docs/usb-fw-update-hardening.md.
    verify_structural checked magic / manifest_version / slot, then stopped.
    The two reserved regions in the v0x02 manifest layout were unchecked:
    OFF_RESERVED_1 = bytes 6..7 expected: [0, 0] (init zeros it)
    OFF_RESERVED_2 = bytes 4193..8188 expected: [0xFF; 3995] (erased flash)
    Both are covered by the CRC (so a network mutation breaks CRC first),
    but neither is signed-over — the digest covers only fw_version,
    secure_hash, nonsecure_hash. A malicious vendor with the signing key
    could plant arbitrary bytes there and still produce a fully verifying
    manifest, AND not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
    [lib.rs]
2026-05-26 fix(fw-update): wipe-on-repeated-verify-failure (glitch-resistance)
    Finding B from docs/usb-fw-update-hardening.md — adapted from Trezor's
    wf_firmware_update.c repeated-failure escalation pattern.
    Tracks consecutive `verify_manifest` failures at CMD_FW_BEGIN. Each failure
    (bad signature / bad version / bad manifest fpr / structural / length-bound)
    increments a per-power-cycle counter. On hitting threshold (5), arm the
    standard admin-wipe flag and `SCB::sys_reset` — the boot-time wipe-resume
    path in main.rs:1334 completes the SE wipe + zero-clear, matching the
    response to a 10-wrong-PIN lockout or a TZIC violation. A manifest that
    passes the full verify chain resets the tally, so legit u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
    [cmd_fw_begin.rs]
2026-05-26 fix(fw-update): move install confirm from COMMIT to BEGIN
    Finding A from docs/usb-fw-update-hardening.md — modelled on Trezor's
    wf_firmware_update.c, which shows the firmware fingerprint + user-confirm
    BEFORE erasing the slot.
    Previously: BEGIN ran the verify chain + erased the inactive slot + seeded
    the streaming ctx; CHUNKs filled the slot; COMMIT re-hashed the streamed
    bytes (`verify_images`), THEN showed the user the 4-page confirm dialog,
    THEN bumped OTP / wrote the new manifest / sys_reset on confirm. A user
    who changed their mind at the COMMIT prompt wasted a slot erase + the
    full image upload.
    Now: BEGIN runs the verify chain, runs the 4-page confirm dialog, AND
    ONLY THEN erases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
    [cmd_fw_begin.rs, cmd_fw_commit.rs, mod.rs]
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2026-05-26 fix(fw-update): flash-backed verify-failure counter (cross-power-cycle)
    Follow-up to finding B in docs/usb-fw-update-hardening.md: the in-RAM
    FW_VERIFY_FAIL_COUNT (commit 3d14931) resets every power cycle, so a
    glitch attacker can dodge it by power-cycling between attempts. This
    commit adds a *persistent* tally on flash page 126 (the page that
    work-todo #24 freed when the OPTIGA PBS seal moved to OTP-derivation).
    Layered defense — both counters now run in `cmd_fw_begin`:
    * In-RAM `FW_VERIFY_FAIL_COUNT_RAM`, threshold 5 — bounds the
    burst rate within a single power cycle (a glitch rig iterating
    many times per second).
    * Flash tally on page 126, threshold 20 — bounds th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
    [cmd_fw_begin.rs, flash.rs]
2026-05-26 fix(fw-update): timing normalization in verify_manifest (finding C)
    Refactors `verify_manifest` to always run every check (structural, CRC,
    digest, vendor-fpr, signature, rollback) regardless of any prior check's
    verdict, then surface the first error in chain order at the end. The
    intermediate `?` short-circuits are gone.
    WHY: with short-circuits, an attacker timing the response can distinguish
    which check their forged manifest tripped:
    verify_structural fail → microseconds
    verify_crc fail → ms
    verify_digest fail → ms
    verify_vendor_fpr fail → ms
    verify_signature fail → ~1 s (SPHINCS+C10 over 70k SHA-256 calls)
    verify_rollback fail →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
    [mod.rs]
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2026-05-27 fix(flash): drive NSCR via NS alias for bank-2 erase/program from secure
    Bank-2 NS-page erase and program from secure world were silently
    returning PGSERR on real STM32U585 silicon. The NSCR register reached
    via the secure alias (0x5002_2028) corrupts every program/erase, even
    though the matching NSKEYR-unlock through the same alias lands LOCK=0.
    ST HAL drives this case via `&(FLASH_NS->NSCR)` (the NS alias at
    0x4002_2028) — `IS_FLASH_SECURE_OPERATION()` selects SECCR/NSCR by
    *page security*, not by caller mode. Switching the bank-2 helpers
    (unlock_ns / clear_errors_ns / wait_bsy_ns / erase_ns_page /
    write_ns_quadword) to the NS alias resolves the failure; bank-1 SECCR
    ops keep using the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
    [flash.rs]
2026-05-27 test(fw-update): over-USB transport e2e on real STM32U585
    Adds `make fwup-transport-hw` — drives the firmware-update state
    machine (BEGIN → CHUNK* → COMMIT) over the real USB HID transport
    on a B-U585I-IOT02A, validating wire format, APDU chaining, NSC
    veneers, and the actual flash-write path through to verify_images.
    Pieces:
    * `fwsign gen-test-fixture` — emits a dev-signed manifest +
    matching secure/nonsecure stub images sized for the round trip
    (default 240 B each, fits one CHUNK APDU). Signing reuses the
    existing dev vendor key from `make dev-pubkey-fixture`.
    * `tools/fwup-transport-test.py` — host driver. Locates the
    1209:7051 hidraw node, prepends the implicit 0x00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
    [cmd_fw_begin.rs, cmd_fw_chunk.rs, cmd_fw_commit.rs, main.rs, mod.rs]
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2026-05-27 fix(fw-update): remove now-unneeded PIN-bypass under fwup-transport-e2e
    The `#[cfg(not(feature = "fwup-transport-e2e"))]` bypass on the
    `pin_verified.check_sentinel()` gate in cmd_fw_begin/chunk/commit was
    added during the wipe-trigger bring-up after we saw FW_BEGIN return
    SW=0x6985 and assumed the e2e-test auto-unlock path wasn't propagating
    `pin_verified` here. Re-reading the boot trace from that run, the SW
    actually mapped to `NscStatus::FwUpdateFlashError = 15`, not
    `NotInitialized = 5` — the real failure was the bank-2 NS-page erase
    returning PGSERR, which commit 66e9780 (FLASH NSCR via NS alias) fixed.
    `make fwup-transport-hw` now passes the full BEGIN + CHUNKs + COMMIT
    + failure-pa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
    [cmd_fw_begin.rs, cmd_fw_chunk.rs, cmd_fw_commit.rs]
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2026-05-27 fix(usb): soft-disconnect before sys_reset on FW-update reset paths
    Adds `hw::usb_hw::soft_disconnect_then_reset` — sets `OTG_DCTL.SDIS=1`
    (via the NS-mapped USB OTG controller at the 0x4204_0000 alias), waits
    ~20 ms for the host's USB 2.0 layer to register the detach, then calls
    `SCB::sys_reset`. Wired into all three secure-side firmware-initiated
    reset callsites:
    * `cmd_fw_begin::arm_wipe_and_reset` — wipe-on-repeated-verify-fail
    (Finding B in docs/usb-fw-update-hardening.md).
    * `cmd_fw_commit::run` — post-COMMIT new-image boot.
    * `hw::tzic::trigger_tzic_wipe` — TZIC-violation wipe path.
    **Scope of the fix.** This makes `dmesg` on the host log a clean
    `USB disconnect` e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
    [cmd_fw_begin.rs, cmd_fw_commit.rs, tzic.rs, usb_hw.rs]
2026-05-27 fix(usb): trim soft-disconnect to minimal SDIS+20ms after UM2839 check
    Reverts the aggressive PA12-as-GPIO-LOW + PB5-LOW (TCPP03 disable) +
    200 ms hold experiment back to the minimal SDIS+20 ms variant. The
    aggressive approach didn't measurably improve re-attach behaviour on
    the test rig (Linux + USB-C cable supplying VBUS) and adds ~180 ms of
    otherwise-wasted latency to every firmware-initiated reset.
    UM2839 §7 confirms the topology constraint is unsolvable on a stock
    B-U585I-IOT02A from firmware: VBUS_C is hard-wired from CN1 through
    the TCPP03-M20 to the 5V_UCPD rail with no solder bridge or jumper
    to break that path. JP4 only selects which 5V source feeds the
    board's own rail, not whet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
    [usb_hw.rs]
2026-05-27 fw-update: replace post-COMMIT / wipe sys_reset with OLED replug prompt
    After UM2839 + dmesg analysis confirmed the USB-C warm-reset re-attach
    isn't achievable from firmware on a stock B-U585I-IOT02A (memory
    `reference_usb_c_warm_reset_edge`), switch the two human-facing reset
    paths from `sys_reset` to a clear OLED prompt + CPU halt. The user
    physically replugs the USB-C cable to recover; the cold boot picks up
    the new state.
    This is the same UX pattern shipping hardware wallets (Trezor,
    Ledger) use after firmware updates and lockout wipes — the user
    sees a persistent on-screen instruction rather than the device
    silently disappearing and never coming back.
    Paths changed:
    * `cmd_fw_commi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
    [cmd_fw_begin.rs, cmd_fw_commit.rs, usb_hw.rs]
2026-05-27 usb: §19 batch A — FI-resistant min + CLA/INS allowlist before chain.step
    Two production-hardening items from `docs/work-todo.md` §19 / P0:
    * **`pqsigner_fi::fi_min`** — FI-hardened length clamp. Computes the
    min via `if a < b { a } else { b }`, then verifies the result
    satisfies the post-condition `r <= a && r <= b`. On failure
    recomputes via the *opposite* branch direction so a single
    EMFI-on-branch glitch can't land identically on both checks.
    Defeats Colin O'Flynn USENIX WOOT 2019 EMFI-on-min (the same
    attack class the reference impl in `docs/production-security.md`
    §2.4 targets).
    Wired into the three USB length-clamping sites where a glitched
    `min` would let a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
    [apdu_framing.rs, lib.rs]
2026-05-27 usb: §19 batch B — abort-on-mid-reassembly-restart + FDMOD/SOF lockdown
    Two more §19 hardening items from `docs/work-todo.md`:
    * **Abort + scrub on mid-reassembly restart** — `HidFrameAssembler`
    used to silently overwrite its state when a fresh `seq=0` arrived
    while a previous APDU was still being reassembled. A host whose
    framing state has gone out of sync must restart from a clean
    slate, not transparently smuggle a state transition. Now: detect
    `rx_pos > 0` at the top of the seq=0 path, scrub
    `buf[..min(rx_pos, buf.len())]` to zero the stale partial bytes,
    call `reset()`, and return `FrameOutcome::Dropped`. The host
    recovers by retrying its seq=0 once the abort respo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
    [apdu_framing.rs, mod.rs]
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2026-05-28 usb: §19 batch D — 5s reassembly timeout + chunked-response scrub-on-interleave
    Two more §19 items, both using the USB frame counter as a free
    1 ms-tick clock so NS doesn't need its own timer peripheral.
    * **`usb::usb_frame_number()`** — reads `OTG_DSTS.FNSOF` (bits 21:8,
    14-bit, wraps every 16.384 s). The host issues a SOF token every
    1 ms and the DWC2 core latches the frame number; we read it WITHOUT
    enabling the SOF interrupt (which `harden_otg` deliberately masks to
    avoid the timing side-channel). The counter advances only while the
    host is actively sending SOFs — i.e. exactly when a transaction
    timeout is meaningful. A suspended/unplugged link freezes the clock,
    s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
    [main.rs, mod.rs]
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2026-05-28 feat(iwdg): USB-path hang watchdog — secure-owned IWDG + NS heartbeat
    §19 P1 final item. Adds an Independent Watchdog that resets the device
    if the USB stack (NS poll loop) hangs, while never false-firing during
    legitimate multi-second secure operations.
    Design (secure-owned, NS-heartbeat-fed — see `hw::iwdg` module docs):
    * `hw::iwdg` (new) — IWDG driver. `init` starts a ~2 s timeout (and
    sets DBGMCU.DBG_IWDG_STOP so the counter freezes under a debugger,
    the standard fix for "watchdog bites at a breakpoint"). Reached via
    the IWDG NS alias (0x4000_3000); the can't-stop-once-started
    property makes NS-accessibility harmless.
    * NS bumps a heartbeat counter (`USB_HEAR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
    [cmd_fw_begin.rs, iwdg.rs, main.rs, mod.rs, nsc_api.rs]
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2026-05-28 fix(usb): solve USB-C warm-reset re-enumeration via cc_open_then_reset
    Task #26. A firmware `sys_reset` over USB-C previously left the host
    port stuck (device booted but never re-enumerated without a physical
    replug) because the host keeps VBUS asserted, so Linux's typec layer
    treats the brief D+/CC transitions as noise and never re-probes.
    Fix: `hw::usb_hw::cc_open_then_reset()` forces a *real* Type-C detach
    before resetting — hold the CC lines fully OPEN long enough (~1.5 s,
    past tCCDebounce) that the host's typec port controller tears the
    port down to unattached, THEN sys_reset. The post-reset dead-battery
    Rd re-engages and the host sees a fresh attach → re-enumeration with
    NO physic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
    [cmd_fw_begin.rs, cmd_fw_commit.rs, usb_hw.rs]
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2026-05-28 usb: 30s GET_RESPONSE inter-chunk timeout + silence FAIL_SENTINEL warning
    Two small reversible items closing out the §19 USB tail.
    * **30 s GET_RESPONSE timeout** (§19 P1 "Response-buffer locking", the
    last unfinished half). The scrub-on-interleave half already covered a
    *different* command arriving mid-drain; this covers the host simply
    going silent (no command at all, so `dispatch`'s scrub never fires).
    `CommandRouter::check_response_timeout(now_frame)` is called once per
    NS poll-loop iteration (alongside `check_rx_timeout`); it accumulates
    elapsed `OTG_DSTS.FNSOF` frames between checks and, if a chunked
    SLH-DSA-signature drain sits idle ≥ `PENDING_TIMEOUT_FRAMES` (30 00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
    [fi.rs, main.rs]
2026-05-28 sec(rng): no silent fall-through on SE TRNG failure
    Tightens `hw::rng_strong::fill` and `DualSecureElement::random` from
    best-effort to strict: any SE-side entropy failure now aborts the
    signing call instead of degrading to STM32-TRNG-only (or to a single
    SE). Closes the EMFI/I2C-glitch degrade path where an attacker could
    quietly reduce entropy to one source without anything noticing —
    exactly the attack class flagged in top-5 #2.
    - `dual_se.rs::random` requires both OPTIGA and SE050 to contribute
    per block; was "Ok if either succeeded".
    - `rng_strong.rs::fill` propagates the SE error via `?` on production
    backends; the `.is_ok()` silent fall-through is now feature-gated
    behind `mo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
    [dual_se.rs, rng_strong.rs]
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2026-05-28 sca: dual-SE XOR leakage probe + §18 RDI re-scope (NOT MOTIVATED)
    Completes the emulation half of the §18 RDI prerequisite ("measure the
    three non-sign secret CPU paths before building anything"):
    * New `sca_dual_se_xor` target (mirror of `dual_se.rs::xor_32`, the
    entropy = half_O ^ half_E reconstruction run at every unlock) added to
    `kdf_target` + `leakage_seed_derivation.py`. Fresh TVLA: max|t| = 0.00
    over 600 traces -> flat (branchless / fixed-stride, no secret-indexed
    access). This was the one of the three non-sign secret paths still
    lacking a dedicated probe; the other two (AES-GCM entropy wrap, the
    SAES-CMAC(DHUK) KDF wrapper) were already flat.
    * §18 RDI item RE-SCOPE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
    [main.rs]
2026-05-28 sec(se050): close ship blockers S-5/S-6/S-7 — SCP03 R-MAC/R-ENC + UserID substitution + APDU hardening
    Comprehensive SE050 driver fix with full GP SCP03 Amendment D v1.1.2,
    NXP AN12413, UM11225, SE050 datasheet, and NXP plug-and-trust C
    reference in hand (under `docs/SE050_AUDIT/`, untracked).
    S-5 — SCP03 response confidentiality + integrity:
    - EXTERNAL_AUTHENTICATE P1 0x03 → 0x33 (full C-MAC + C-DEC + R-MAC +
    R-ENC) per GP Amd D Table 7-6 page 35 + NXP plug-and-trust
    `fsl_sss_se05x_scp03.c:186-198` (`SECLVL_CDEC_RENC_CMAC_RMAC`).
    - New `scp03::unwrap_response` mirrors `nxScp03_Com.c:124-248`:
    R-MAC over `MCV(16) || ciphered_body || SW(2)` under the separate
    S-RMAC key per §6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
    [apdu.rs, mod.rs, scp03.rs, scp03_logic.rs]
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2026-05-28 fix(se050): close A1/A2/A3 silicon findings — production reinit + harness rework
    Apply every action item from `docs/se050-silicon-findings.md` §6.
    Splits cleanly into production-firmware fixes (A3 surfaced real bugs
    in the unlock + admin-wipe paths) and stress-harness rework (P1/P2/P4/
    P5 reworked, audit_admin_cannot_rotate_user_pin rewritten, payload cap
    in object_extended_lc_boundary, A1 doc retraction). Confidentiality
    invariant remains silicon-verified; chip behavior is unchanged.
    ## Production firmware (A3 surfaced real bugs)
    - `Se050::reinit` ungated for production use (was `#[cfg(feature =
    "se050-stress")]`). Single SCP03 handshake; ~100-300 ms on silicon.
    - `Se050::authenticat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
    [apdu.rs, mod.rs]
2026-05-28 fix(se050): on-silicon validation of A1/A2/A3 fixes — 6→15 PASS, A2 retracted, create_session lockout, GetRandom finding
    Ran `make se050-stress-destructive` on B-U585I-IOT02A three times,
    fixing what each run exposed. Catalog: 6 → 10 → 12 → 15 PASS. Every
    A1/A2/A3 item plus the create_session lockout fix is now silicon-
    validated. Full writeup in docs/se050-silicon-findings.md §6b/§6c.
    ## Corrections the hardware forced
    **A2 RETRACTED — no DoS (was an A3 artifact).** The prior commit's
    "failed write_userid UPDATE destroys the UserID" was wrong. Run 1's
    post-attack check_exists returned SW=0x6982, which we misread as
    "object gone"; 0x6982 was actually the A3 session-pending TR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
    [apdu.rs, mod.rs]
2026-05-28 fix(se050): root-cause + fix GetRandom 0x6985 (oversized request) — catalog 18/18 PASS
    Dug into the SE050 GetRandom → 0x6985 finding. Root cause + fix below;
    the SE050 stress catalog is now 18 PASS / 0 FAIL on B-U585I-IOT02A
    (progression across the session: 6 → 10 → 12 → 15 → 16 → 18).
    ## Root cause (RESOLVED) — oversized single GetRandom over SCP03
    A boundary probe (`get_random_size_boundary`, sizes 16..256 with reinit
    between each) bracketed it precisely:
    16/32/48/64/96/128/160/192/224 OK ; 240/256 FAIL SW=0x6985 → max=224
    A single `GetRandom` over SCP03 caps at 224 B. The failing tests
    (`scp03_wtx_endurance`, `trng_quality_basic`) requested 256 B;
    `scp03_apdu_bur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
    [apdu.rs, mod.rs, scp03.rs]
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
