DankGecko/pq1/(notices)

Notices in the files:
docs/verification/hardware-formalization-survey-2026-07-17.md:
- Kobeissi, "Verification Theatre" (**cite the June 2025 revision**): https://eprint.iacr.org/2026/192 · companion, "Verification Facade": https://eprint.iacr.org/2026/670
